SpinalHDL/VexRiscv/(threads)

Thread 4 (2017-10-04):

GDB not working with FPGA

AaronKel, 2017-10-04:
Hello all,
I'm having a little problem with the FPGA implementation to test functionality on sillicon and the compilation is completely fine but when it comes to interfacing with the board.
The OpenOCD can connect, I'm using the command:

`openocd -f tcl/interface/altera-usb-blaster.cfg -c "set BRIEY_CPU0_YAML /home/aaron/VexRiscv/cpu0.yaml" -f tcl/target/briey.cfg`

 However, when then trying to connect to the GDB with:

`target remote localhost:3333`

It times out, am I missing something? I'm using the DE0-nano development board.

Dolu1990, 2017-10-04:
Hi,

How do you have linked the Altera USB blaster to the briey toplevel ?
(Currently I always have used a dedicated JTAG via some USB FTDI)

Also about the DE0-nano, i already have test Briey on it, be carefull the SDRAM configuration is different than the default one (DE1-SoC). You need to generate the toplevel via (for instance) this main : https://github.com/SpinalHDL/VexRiscv/blob/master/src/main/scala/vexriscv/demo/Briey.scala#L394

AaronKel, 2017-10-04:
I have used the default:

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

Then attached the correct slots on the blaster but it gets to:

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

and stops and I cannot connect to it via GDB. What sort of FTDI chip/setup did you use. I think it would be helpful if I tried it your way, since you have already tested it.

Dolu1990, 2017-10-05:
I'm using the ft2232h chip, so, the very "standard" way, the only element on the jtag chain is the Briey SOC. Do you have multiple jtag tap on your JTAG ? Or the Briey is the only one ? Have you powered the vcc_trgt pin of the dongle ? (i had forget it many times XD)
Also could you give  a try with the verbose openocd ?  -v3   if i remember it right

Dolu1990, 2017-10-05:
Also, just to minimise risks of error, don't modify any thing of the de0-nano project/sources (for the moment :))

AaronKel, 2017-10-07:
I'll run through my setup, because I may have just made a wiring mistake!

So I tried ordering in the ft232h breakout board form adafruit:

> https://www.adafruit.com/product/2264

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

Reverted back into a clean DE0-nano file from here:

> https://drive.google.com/drive/folders/0B-CqLXDTaMbKZGdJZlZ5THAxRTQ?usp=sharing

Then I looked at the top level files for the JTAG and it seems like they are on:

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

Then looking at the pin mapping it shows:

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

So looking at the pin mapping of the DE0 nano:

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

Then looking in the FT232H datasheet it shows

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

with pins 13, 14, 15, 16, 17, 18, 19, 20 on the ADBUS[7:0] and from adafruit:

> D0 through D7 - These are the ADBUS pins

So my final wiring is:

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

Then I got the OpenOCD from

> https://github.com/SpinalHDL/openocd_riscv

Compiled it ran it with the simulation okay, then I tried running;
`$ sudo openocd -f tcl/interface/ftdi/ft2232h_breakout.cfg -c 'set BRIEY_CPU0_YAML /home/aaron/VexRis/cpu0.yaml' -f tcl/target/briey.cfg`
Got an error that it wasn't found so changed ft2232h_breakout.cfg to

```
interface ftdi
#ftdi_device_desc "FT2232H Breakout Module"
ftdi_vid_pid 0x0403 0x6014

# Channel for using JTAG
ftdi_channel 0

# Initial state and direction setting (ref. AN_135_MPSSE_Basics.pdf)
# ftdi_layout_init [data] [direction]

#  name   signal  state      direction  JTAG name
# *DBUS0  TCK/SK  (low =0)   (out=1)    TDI
# *DBUS1  TDI/DO  (low =0)   (out=1)    TDO
# *DBUS2  TDO/DI  (low =0)   (in =0)    TCK
# *DBUS3  TMS/CS  (high=1)   (out=1)    TMS
# *DBUS4  GPIOL0  (low =0)   (out=0)    (nTRST)
# *DBUS5  GPIOL1  (low =0)   (out=0)    WAIT | STOPCLK
# *DBUS6  GPIOL2  (low =0)   (out=0)    (nRST)
# *DBUS7  GPIOL3  (low =0)   (out=0)    RTCK
ftdi_layout_init 0xfff8 0xfffb
ftdi_layout_signal nTRST -data 0x0100 -oe 0x0100
ftdi_layout_signal nSRST -data 0x0200 -oe 0x0200
```
Ran the OpenOCD again and got the following error;
```
$sudo openocd -d -f tcl/interface/ftdi/ft2232h_breakout.cfg -c 'set BRIEY_CPU0_YAML /home/aaron/VexRiscv/cpu0.yaml' -f tcl/target/briey.cfg

Open On-Chip Debugger 0.10.0+dev-00292-g14dcabd (2017-10-07-14:13)
Licensed under GNU GPL v2
For bug reports, read
	http://openocd.org/doc/doxygen/bugs.html
User : 13 1 command.c:544 command_print(): debug_level: 3
Debug: 14 2 options.c:181 add_default_dirs(): bindir=/usr/local/bin
Debug: 15 2 options.c:182 add_default_dirs(): pkgdatadir=/usr/local/share/openocd
Debug: 16 2 options.c:183 add_default_dirs(): exepath=/usr/local/bin
Debug: 17 2 options.c:184 add_default_dirs(): bin2data=../share/openocd
Debug: 18 2 configuration.c:42 add_script_search_dir(): adding /home/aaron/.openocd
Debug: 19 2 configuration.c:42 add_script_search_dir(): adding /usr/local/bin/../share/openocd/site
Debug: 20 2 configuration.c:42 add_script_search_dir(): adding /usr/local/bin/../share/openocd/scripts
Debug: 21 2 configuration.c:82 find_file(): found tcl/interface/ftdi/ft2232h_breakout.cfg
Debug: 22 2 command.c:143 script_debug(): command - ocd_command ocd_command type ocd_interface ftdi
Debug: 23 2 command.c:143 script_debug(): command - interface ocd_interface ftdi
Debug: 25 2 command.c:364 register_command_handler(): registering 'ocd_ftdi_device_desc'...
Debug: 26 2 command.c:364 register_command_handler(): registering 'ocd_ftdi_serial'...
Debug: 27 2 command.c:364 register_command_handler(): registering 'ocd_ftdi_location'...
Debug: 28 2 command.c:364 register_command_handler(): registering 'ocd_ftdi_channel'...
Debug: 29 2 command.c:364 register_command_handler(): registering 'ocd_ftdi_layout_init'...
Debug: 30 2 command.c:364 register_command_handler(): registering 'ocd_ftdi_layout_signal'...
Debug: 31 2 command.c:364 register_command_handler(): registering 'ocd_ftdi_set_signal'...
Debug: 32 2 command.c:364 register_command_handler(): registering 'ocd_ftdi_get_signal'...
Debug: 33 2 command.c:364 register_command_handler(): registering 'ocd_ftdi_vid_pid'...
Debug: 34 2 command.c:364 register_command_handler(): registering 'ocd_ftdi_tdo_sample_edge'...
Debug: 35 2 command.c:143 script_debug(): command - ocd_command ocd_command type ocd_ftdi_vid_pid 0x0403 0x6014
Debug: 36 2 command.c:143 script_debug(): command - ftdi_vid_pid ocd_ftdi_vid_pid 0x0403 0x6014
Debug: 38 2 command.c:143 script_debug(): command - ocd_command ocd_command type ocd_ftdi_channel 0
Debug: 39 2 command.c:143 script_debug(): command - ftdi_channel ocd_ftdi_channel 0
Debug: 41 2 command.c:143 script_debug(): command - ocd_command ocd_command type ocd_ftdi_layout_init 0xfff8 0xfffb
Debug: 42 2 command.c:143 script_debug(): command - ftdi_layout_init ocd_ftdi_layout_init 0xfff8 0xfffb
Debug: 44 2 command.c:143 script_debug(): command - ocd_command ocd_command type ocd_ftdi_layout_signal nTRST -data 0x0100 -oe 0x0100
Debug: 45 2 command.c:143 script_debug(): command - ftdi_layout_signal ocd_ftdi_layout_signal nTRST -data 0x0100 -oe 0x0100
Debug: 47 2 command.c:143 script_debug(): command - ocd_command ocd_command type ocd_ftdi_layout_signal nSRST -data 0x0200 -oe 0x0200
Debug: 48 2 command.c:143 script_debug(): command - ftdi_layout_signal ocd_ftdi_layout_signal nSRST -data 0x0200 -oe 0x0200
User : 50 2 command.c:675 command_run_line(): /home/aaron/VexRiscv/cpu0.yamlUser : 51 2 command.c:677 command_run_line():
Debug: 52 2 configuration.c:82 find_file(): found tcl/target/briey.cfg
Debug: 53 2 command.c:143 script_debug(): command - ocd_command ocd_command type ocd_adapter_khz 50
Debug: 54 2 command.c:143 script_debug(): command - adapter_khz ocd_adapter_khz 50
Debug: 56 2 core.c:1631 jtag_config_khz(): handle jtag khz
Debug: 57 2 core.c:1598 adapter_khz_to_speed(): convert khz to interface specific speed value
Debug: 58 2 core.c:1598 adapter_khz_to_speed(): convert khz to interface specific speed value
User : 59 2 command.c:544 command_print(): adapter speed: 50 kHz
Debug: 60 2 command.c:143 script_debug(): command - ocd_command ocd_command type ocd_adapter_nsrst_delay 260
Debug: 61 2 command.c:143 script_debug(): command - adapter_nsrst_delay ocd_adapter_nsrst_delay 260
User : 63 2 command.c:544 command_print(): adapter_nsrst_delay: 260
Debug: 64 2 command.c:143 script_debug(): command - ocd_command ocd_command type ocd_transport select
Debug: 65 2 command.c:143 script_debug(): command - ocd_transport ocd_transport select
Info : 66 2 transport.c:286 jim_transport_select(): auto-selecting first available session transport "jtag". To override use 'transport select <transport>'.
Debug: 67 2 command.c:364 register_command_handler(): registering 'ocd_jtag_flush_queue_sleep'...
Debug: 68 2 command.c:364 register_command_handler(): registering 'ocd_jtag_rclk'...
Debug: 69 2 command.c:364 register_command_handler(): registering 'ocd_jtag_ntrst_delay'...
Debug: 70 2 command.c:364 register_command_handler(): registering 'ocd_jtag_ntrst_assert_width'...
Debug: 71 2 command.c:364 register_command_handler(): registering 'ocd_scan_chain'...
Debug: 72 2 command.c:364 register_command_handler(): registering 'ocd_jtag_reset'...
Debug: 73 2 command.c:364 register_command_handler(): registering 'ocd_runtest'...
Debug: 74 3 command.c:364 register_command_handler(): registering 'ocd_irscan'...
Debug: 75 3 command.c:364 register_command_handler(): registering 'ocd_verify_ircapture'...
Debug: 76 3 command.c:364 register_command_handler(): registering 'ocd_verify_jtag'...
Debug: 77 3 command.c:364 register_command_handler(): registering 'ocd_tms_sequence'...
Debug: 78 3 command.c:364 register_command_handler(): registering 'ocd_wait_srst_deassert'...
Debug: 79 3 command.c:364 register_command_handler(): registering 'ocd_jtag'...
Debug: 80 3 command.c:364 register_command_handler(): registering 'ocd_jtag'...
Debug: 81 3 command.c:364 register_command_handler(): registering 'ocd_jtag'...
Debug: 82 3 command.c:364 register_command_handler(): registering 'ocd_jtag'...
Debug: 83 3 command.c:364 register_command_handler(): registering 'ocd_jtag'...
Debug: 84 3 command.c:364 register_command_handler(): registering 'ocd_jtag'...
Debug: 85 3 command.c:364 register_command_handler(): registering 'ocd_jtag'...
Debug: 86 3 command.c:364 register_command_handler(): registering 'ocd_jtag'...
Debug: 87 3 command.c:364 register_command_handler(): registering 'ocd_jtag'...
Debug: 88 3 command.c:364 register_command_handler(): registering 'ocd_jtag'...
Debug: 89 3 command.c:364 register_command_handler(): registering 'ocd_jtag'...
Debug: 90 3 command.c:364 register_command_handler(): registering 'ocd_jtag'...
Debug: 91 3 command.c:364 register_command_handler(): registering 'ocd_jtag'...
Debug: 92 3 command.c:364 register_command_handler(): registering 'ocd_svf'...
Debug: 93 3 command.c:364 register_command_handler(): registering 'ocd_xsvf'...
Debug: 94 3 command.c:143 script_debug(): command - ocd_command ocd_command type ocd_transport select
Debug: 95 3 command.c:143 script_debug(): command - ocd_transport ocd_transport select
Debug: 96 3 command.c:143 script_debug(): command - ocd_command ocd_command type ocd_jtag_ntrst_delay 250
Debug: 97 3 command.c:143 script_debug(): command - jtag_ntrst_delay ocd_jtag_ntrst_delay 250
User : 99 3 command.c:544 command_print(): jtag_ntrst_delay: 250
Debug: 100 3 command.c:143 script_debug(): command - ocd_command ocd_command type ocd_jtag newtap fpga_spinal bridge -expected-id 0x10001fff -irlen 4 -ircapture 0x1 -irmask 0xF
Debug: 101 3 command.c:143 script_debug(): command - ocd_jtag ocd_jtag newtap fpga_spinal bridge -expected-id 0x10001fff -irlen 4 -ircapture 0x1 -irmask 0xF
Debug: 102 3 tcl.c:549 jim_newtap_cmd(): Creating New Tap, Chip: fpga_spinal, Tap: bridge, Dotted: fpga_spinal.bridge, 8 params
Debug: 103 3 tcl.c:573 jim_newtap_cmd(): Processing option: -expected-id
Debug: 104 3 tcl.c:573 jim_newtap_cmd(): Processing option: -irlen
Debug: 105 3 tcl.c:573 jim_newtap_cmd(): Processing option: -ircapture
Debug: 106 3 tcl.c:573 jim_newtap_cmd(): Processing option: -irmask
Debug: 107 3 core.c:1304 jtag_tap_init(): Created Tap: fpga_spinal.bridge @ abs position 0, irlen 4, capture: 0x1 mask: 0xf
Debug: 108 3 command.c:143 script_debug(): command - ocd_command ocd_command type ocd_target create fpga_spinal.cpu0 vexriscv -endian little -chain-position fpga_spinal.bridge -coreid 0 -dbgbase 0xF00F0000
Debug: 109 3 command.c:143 script_debug(): command - ocd_target ocd_target create fpga_spinal.cpu0 vexriscv -endian little -chain-position fpga_spinal.bridge -coreid 0 -dbgbase 0xF00F0000
Debug: 110 3 target.c:1922 target_free_all_working_areas_restore(): freeing all working areas
Debug: 111 3 command.c:364 register_command_handler(): registering 'ocd_vexriscv'...
Debug: 112 3 command.c:364 register_command_handler(): registering 'ocd_vexriscv'...
Debug: 113 3 vexriscv.c:324 vexriscv_target_create(): vexriscv_target_create

Debug: 114 3 vexriscv.c:301 vexriscv_create_reg_list(): -
Debug: 115 3 command.c:364 register_command_handler(): registering 'ocd_fpga_spinal.cpu0'...
Debug: 116 3 command.c:364 register_command_handler(): registering 'ocd_fpga_spinal.cpu0'...
Debug: 117 3 command.c:364 register_command_handler(): registering 'ocd_fpga_spinal.cpu0'...
Debug: 118 3 command.c:364 register_command_handler(): registering 'ocd_fpga_spinal.cpu0'...
Debug: 119 3 command.c:364 register_command_handler(): registering 'ocd_fpga_spinal.cpu0'...
Debug: 120 3 command.c:364 register_command_handler(): registering 'ocd_fpga_spinal.cpu0'...
Debug: 121 3 command.c:364 register_command_handler(): registering 'ocd_fpga_spinal.cpu0'...
Debug: 122 3 command.c:364 register_command_handler(): registering 'ocd_fpga_spinal.cpu0'...
Debug: 123 3 command.c:364 register_command_handler(): registering 'ocd_fpga_spinal.cpu0'...
Debug: 124 3 command.c:364 register_command_handler(): registering 'ocd_fpga_spinal.cpu0'...
Debug: 125 3 command.c:364 register_command_handler(): registering 'ocd_fpga_spinal.cpu0'...
Debug: 126 3 command.c:364 register_command_handler(): registering 'ocd_fpga_spinal.cpu0'...
Debug: 127 3 command.c:364 register_command_handler(): registering 'ocd_fpga_spinal.cpu0'...
Debug: 128 3 command.c:364 register_command_handler(): registering 'ocd_fpga_spinal.cpu0'...
Debug: 129 3 command.c:364 register_command_handler(): registering 'ocd_fpga_spinal.cpu0'...
Debug: 130 3 command.c:364 register_command_handler(): registering 'ocd_fpga_spinal.cpu0'...
Debug: 131 3 command.c:364 register_command_handler(): registering 'ocd_fpga_spinal.cpu0'...
Debug: 132 3 command.c:364 register_command_handler(): registering 'ocd_fpga_spinal.cpu0'...
Debug: 133 3 command.c:364 register_command_handler(): registering 'ocd_fpga_spinal.cpu0'...
Debug: 134 3 command.c:364 register_command_handler(): registering 'ocd_fpga_spinal.cpu0'...
Debug: 135 3 command.c:364 register_command_handler(): registering 'ocd_fpga_spinal.cpu0'...
Debug: 136 3 command.c:364 register_command_handler(): registering 'ocd_fpga_spinal.cpu0'...
Debug: 137 3 command.c:364 register_command_handler(): registering 'ocd_fpga_spinal.cpu0'...
Debug: 138 3 command.c:364 register_command_handler(): registering 'ocd_fpga_spinal.cpu0'...
Debug: 139 3 command.c:143 script_debug(): command - ocd_command ocd_command type ocd_vexriscv readWaitCycles 12
Debug: 140 3 command.c:143 script_debug(): command - ocd_vexriscv ocd_vexriscv readWaitCycles 12
Debug: 142 3 command.c:143 script_debug(): command - ocd_command ocd_command type ocd_vexriscv cpuConfigFile /home/aaron/VexRiscv/cpu0.yaml
Debug: 143 3 command.c:143 script_debug(): command - ocd_vexriscv ocd_vexriscv cpuConfigFile /home/aaron/VexRiscv/cpu0.yaml
Debug: 145 3 command.c:143 script_debug(): command - ocd_command ocd_command type ocd_poll_period 50
Debug: 146 3 command.c:143 script_debug(): command - poll_period ocd_poll_period 50
Info : 148 3 server.c:673 handle_poll_period_command(): set servers polling period to 50ms
Debug: 149 3 command.c:143 script_debug(): command - ocd_command ocd_command type ocd_init
Debug: 150 3 command.c:143 script_debug(): command - init ocd_init
Debug: 152 3 command.c:143 script_debug(): command - ocd_command ocd_command type ocd_target init
Debug: 153 4 command.c:143 script_debug(): command - ocd_target ocd_target init
Debug: 155 4 command.c:143 script_debug(): command - ocd_command ocd_command type ocd_target names
Debug: 156 4 command.c:143 script_debug(): command - ocd_target ocd_target names
Debug: 157 4 command.c:143 script_debug(): command - ocd_command ocd_command type ocd_fpga_spinal.cpu0 cget -event gdb-flash-erase-start
Debug: 158 4 command.c:143 script_debug(): command - ocd_fpga_spinal.cpu0 ocd_fpga_spinal.cpu0 cget -event gdb-flash-erase-start
Debug: 159 4 command.c:143 script_debug(): command - ocd_command ocd_command type ocd_fpga_spinal.cpu0 configure -event gdb-flash-erase-start reset init
Debug: 160 4 command.c:143 script_debug(): command - ocd_fpga_spinal.cpu0 ocd_fpga_spinal.cpu0 configure -event gdb-flash-erase-start reset init
Debug: 161 4 command.c:143 script_debug(): command - ocd_command ocd_command type ocd_fpga_spinal.cpu0 cget -event gdb-flash-write-end
Debug: 162 4 command.c:143 script_debug(): command - ocd_fpga_spinal.cpu0 ocd_fpga_spinal.cpu0 cget -event gdb-flash-write-end
Debug: 163 4 command.c:143 script_debug(): command - ocd_command ocd_command type ocd_fpga_spinal.cpu0 configure -event gdb-flash-write-end reset halt
Debug: 164 4 command.c:143 script_debug(): command - ocd_fpga_spinal.cpu0 ocd_fpga_spinal.cpu0 configure -event gdb-flash-write-end reset halt
Debug: 165 4 target.c:1331 handle_target_init_command(): Initializing targets...
Debug: 166 4 vexriscv.c:581 vexriscv_init_target(): vexriscv_init_target

Debug: 167 4 vexriscv.c:582 vexriscv_init_target(): vexriscv_init_target
Debug: 168 4 vexriscv.c:423 vexriscv_build_reg_cache(): -
Debug: 169 4 command.c:364 register_command_handler(): registering 'ocd_target_request'...
Debug: 170 4 command.c:364 register_command_handler(): registering 'ocd_trace'...
Debug: 171 4 command.c:364 register_command_handler(): registering 'ocd_trace'...
Debug: 172 4 command.c:364 register_command_handler(): registering 'ocd_fast_load_image'...
Debug: 173 4 command.c:364 register_command_handler(): registering 'ocd_fast_load'...
Debug: 174 4 command.c:364 register_command_handler(): registering 'ocd_profile'...
Debug: 175 4 command.c:364 register_command_handler(): registering 'ocd_virt2phys'...
Debug: 176 4 command.c:364 register_command_handler(): registering 'ocd_reg'...
Debug: 177 4 command.c:364 register_command_handler(): registering 'ocd_poll'...
Debug: 178 4 command.c:364 register_command_handler(): registering 'ocd_wait_halt'...
Debug: 179 4 command.c:364 register_command_handler(): registering 'ocd_halt'...
Debug: 180 4 command.c:364 register_command_handler(): registering 'ocd_resume'...
Debug: 181 4 command.c:364 register_command_handler(): registering 'ocd_reset'...
Debug: 182 4 command.c:364 register_command_handler(): registering 'ocd_soft_reset_halt'...
Debug: 183 4 command.c:364 register_command_handler(): registering 'ocd_step'...
Debug: 184 4 command.c:364 register_command_handler(): registering 'ocd_mdd'...
Debug: 185 4 command.c:364 register_command_handler(): registering 'ocd_mdw'...
Debug: 186 4 command.c:364 register_command_handler(): registering 'ocd_mdh'...
Debug: 187 4 command.c:364 register_command_handler(): registering 'ocd_mdb'...
Debug: 188 4 command.c:364 register_command_handler(): registering 'ocd_mwd'...
Debug: 189 4 command.c:364 register_command_handler(): registering 'ocd_mww'...
Debug: 190 4 command.c:364 register_command_handler(): registering 'ocd_mwh'...
Debug: 191 4 command.c:364 register_command_handler(): registering 'ocd_mwb'...
Debug: 192 4 command.c:364 register_command_handler(): registering 'ocd_bp'...
Debug: 193 4 command.c:364 register_command_handler(): registering 'ocd_rbp'...
Debug: 194 4 command.c:364 register_command_handler(): registering 'ocd_wp'...
Debug: 195 4 command.c:364 register_command_handler(): registering 'ocd_rwp'...
Debug: 196 4 command.c:364 register_command_handler(): registering 'ocd_load_image'...
Debug: 197 4 command.c:364 register_command_handler(): registering 'ocd_dump_image'...
Debug: 198 4 command.c:364 register_command_handler(): registering 'ocd_verify_image_checksum'...
Debug: 199 4 command.c:364 register_command_handler(): registering 'ocd_verify_image'...
Debug: 200 4 command.c:364 register_command_handler(): registering 'ocd_test_image'...
Debug: 201 4 command.c:364 register_command_handler(): registering 'ocd_reset_nag'...
Debug: 202 4 command.c:364 register_command_handler(): registering 'ocd_ps'...
Debug: 203 4 command.c:364 register_command_handler(): registering 'ocd_test_mem_access'...
Debug: 204 4 ftdi.c:657 ftdi_initialize(): ftdi interface using shortest path jtag state transitions
Debug: 205 6 mpsse.c:422 mpsse_purge(): -
Debug: 206 6 mpsse.c:703 mpsse_loopback_config(): off
Debug: 207 6 mpsse.c:748 mpsse_set_frequency(): target 50000 Hz
Debug: 208 6 mpsse.c:740 mpsse_rtck_config(): off
Debug: 209 6 mpsse.c:729 mpsse_divide_by_5_config(): off
Debug: 210 6 mpsse.c:709 mpsse_set_divisor(): 599
Debug: 211 6 mpsse.c:772 mpsse_set_frequency(): actually 50000 Hz
Debug: 212 6 core.c:1598 adapter_khz_to_speed(): convert khz to interface specific speed value
Debug: 213 6 core.c:1601 adapter_khz_to_speed(): have interface set up
Debug: 214 6 mpsse.c:748 mpsse_set_frequency(): target 50000 Hz
Debug: 215 6 mpsse.c:740 mpsse_rtck_config(): off
Debug: 216 6 mpsse.c:729 mpsse_divide_by_5_config(): off
Debug: 217 6 mpsse.c:709 mpsse_set_divisor(): 599
Debug: 218 6 mpsse.c:772 mpsse_set_frequency(): actually 50000 Hz
Debug: 219 6 core.c:1598 adapter_khz_to_speed(): convert khz to interface specific speed value
Debug: 220 6 core.c:1601 adapter_khz_to_speed(): have interface set up
Info : 221 6 core.c:1386 adapter_init(): clock speed 50 kHz
Debug: 222 6 openocd.c:140 handle_init_command(): Debug Adapter init complete
Debug: 223 6 command.c:143 script_debug(): command - ocd_command ocd_command type ocd_transport init
Debug: 224 6 command.c:143 script_debug(): command - ocd_transport ocd_transport init
Debug: 226 6 transport.c:239 handle_transport_init(): handle_transport_init
Debug: 227 6 core.c:729 jtag_add_reset(): SRST line released
Debug: 228 6 core.c:753 jtag_add_reset(): TRST line released
Debug: 229 6 core.c:327 jtag_call_event_callbacks(): jtag event: TAP reset
Debug: 231 522 command.c:143 script_debug(): command - ocd_command ocd_command type ocd_jtag arp_init
Debug: 232 522 command.c:143 script_debug(): command - ocd_jtag ocd_jtag arp_init
Debug: 233 522 core.c:1399 jtag_init_inner(): Init JTAG chain
Debug: 234 522 core.c:327 jtag_call_event_callbacks(): jtag event: TAP reset
Debug: 235 522 core.c:1060 jtag_examine_chain(): DR scan interrogation for IDCODE/BYPASS
Debug: 236 522 core.c:327 jtag_call_event_callbacks(): jtag event: TAP reset
Error: 237 536 core.c:949 jtag_examine_chain_check(): JTAG scan chain interrogation failed: all ones
Error: 238 536 core.c:950 jtag_examine_chain_check(): Check JTAG interface, timings, target power, etc.
Error: 239 536 core.c:1444 jtag_init_inner(): Trying to use configured scan chain anyway...
Debug: 240 536 core.c:1190 jtag_validate_ircapture(): IR capture validation scan
Error: 241 537 core.c:1242 jtag_validate_ircapture(): fpga_spinal.bridge: IR capture error; saw 0x0f not 0x01
Debug: 242 537 core.c:327 jtag_call_event_callbacks(): jtag event: TAP reset
Warn : 243 537 core.c:1467 jtag_init_inner(): Bypassing JTAG setup events due to errors
Debug: 244 537 openocd.c:153 handle_init_command(): Examining targets...
Debug: 245 537 target.c:1524 target_call_event_callbacks(): target event 21 (examine-start)
Debug: 246 537 vexriscv.c:1400 vexriscv_examine(): vexriscv_examine
Debug: 247 537 vexriscv.c:869 vexriscv_assert_reset(): vexriscv_assert_reset

Debug: 248 537 vexriscv.c:880 vexriscv_assert_reset(): vexriscv_assert_reset
Debug: 249 537 vexriscv.c:887 vexriscv_deassert_reset(): vexriscv_deassert_reset

Debug: 250 546 vexriscv.c:896 vexriscv_deassert_reset(): vexriscv_deassert_reset
Debug: 251 549 target.c:1524 target_call_event_callbacks(): target event 22 (examine-end)
Debug: 252 549 command.c:143 script_debug(): command - ocd_command ocd_command type ocd_flash init
Debug: 253 550 command.c:143 script_debug(): command - ocd_flash ocd_flash init
Debug: 255 553 tcl.c:1166 handle_flash_init_command(): Initializing flash devices...
Debug: 256 553 command.c:143 script_debug(): command - ocd_command ocd_command type ocd_mflash init
Debug: 257 553 command.c:143 script_debug(): command - ocd_mflash ocd_mflash init
Debug: 259 556 mflash.c:1377 handle_mflash_init_command(): Initializing mflash devices...
Debug: 260 556 command.c:143 script_debug(): command - ocd_command ocd_command type ocd_nand init
Debug: 261 556 command.c:143 script_debug(): command - ocd_nand ocd_nand init
Debug: 263 560 tcl.c:497 handle_nand_init_command(): Initializing NAND devices...
Debug: 264 560 command.c:143 script_debug(): command - ocd_command ocd_command type ocd_pld init
Debug: 265 560 command.c:143 script_debug(): command - ocd_pld ocd_pld init
Debug: 267 563 pld.c:205 handle_pld_init_command(): Initializing PLDs...
Debug: 268 563 command.c:143 script_debug(): command - ocd_command ocd_command type ocd_soft_reset_halt
Debug: 269 563 command.c:143 script_debug(): command - soft_reset_halt ocd_soft_reset_halt
User : 271 566 target.c:2948 handle_soft_reset_halt_command(): requesting target halt and executing a soft reset
Debug: 272 566 vexriscv.c:1448 vexriscv_soft_reset_halt(): -
Debug: 273 568 command.c:143 script_debug(): command - ocd_command ocd_command type ocd_init
Debug: 274 568 command.c:143 script_debug(): command - init ocd_init

```

I think the error is similar to what you were saying about the target voltage:
```
Error: 237 536 core.c:949 jtag_examine_chain_check(): JTAG scan chain interrogation failed: all ones
Error: 238 536 core.c:950 jtag_examine_chain_check(): Check JTAG interface, timings, target power, etc.
```
Would I just supply 3.3v to one of the pins?

Many thanks

Dolu1990, 2017-10-07:
I don't think it is a supply issue in this case, have you flash the usb dongle ? often the default config isn't JTAG ready.

Anyways, the issue is realy in the low level jtag stuff, has the Briey jtag tap isn't detected.
Let's me know ^^

AaronKel, 2017-10-08:
I finally figured it out after a lot of head scratching. I decided to use the USB-blaster again, I was using this version;

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

These clones use a cheap ft423(?) I think so was causing the hangups. If I recompile OpenOCD with the following;

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

It all worked, I knew it was something simple! Thank you for helping me diagnose there was no error on the VexRiscv side!

AaronKel, 2017-10-08:
close

Dolu1990, 2017-10-08:
Good :)
Thanks for the info ^^

MindShow, 2019-04-29:
i tried a usb blaster clone，but return some errors
`Open On-Chip Debugger 0.10.0+dev-01202-gced8dcd6 (2019-04-23-21:53)
Licensed under GNU GPL v2
For bug reports, read
	http://openocd.org/doc/doxygen/bugs.html
Warn : Adapter driver 'usb_blaster' did not declare which transports it allows; assuming legacy JTAG-only
Info : only one transport option; autoselect 'jtag'
/home/csliu/Desktop/riscvwork/VexRiscvSocSoftware/openocd/cpu0.yaml
adapter speed: 10 kHz
adapter_nsrst_delay: 260
jtag_ntrst_delay: 250
Info : set servers polling period to 50ms
Info : usb blaster interface using libftdi
Error: unable to get latency timer
Info : This adapter doesn't support configurable speed
Info : JTAG tap: fpga_spinal.bridge tap/device found: 0x10001fff (mfg: 0x7ff (<invalid>), part: 0x0001, ver: 0x1)
Error: fpga_spinal.bridge: IR capture error; saw 0x08 not 0x01
Warn : Bypassing JTAG setup events due to errors
Info : Listening on port 3333 for gdb connections
requesting target halt and executing a soft reset
Started by GNU MCU Eclipse
Info : Listening on port 6666 for tcl connections
Info : Listening on port 4444 for telnet connections
Info : accepting 'gdb' connection on tcp/3333
Info : JTAG tap: fpga_spinal.bridge tap/device found: 0x10001fff (mfg: 0x7ff (<invalid>), part: 0x0001, ver: 0x1)
Error: fpga_spinal.bridge: IR capture error; saw 0x08 not 0x01
Warn : Bypassing JTAG setup
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

Thread 16 (2018-02-22):

Briey simulation regression

m-chabot, 2018-02-22:
Hi,

I am working on porting Briey soc to Xilinx fpga board and have issue with sdram so I use simulator to extract reference waveform.
I noticed a regression in briey soc simulation with https://github.com/SpinalHDL/VexRiscv/commit/d95793494942e334f9c643d2b61f231218714cc7

When using simulator it's no longer possible to load/execute code in sdram. Internal ram load/exec is fine.
Tested with latest SpinalHDL, VexRiscSoftware (uart example) and gcc 6.1.0 (self build rv32i toolchain).

Dolu1990, 2018-02-22:
Hi,

You are right,  something is going wrong, apparently it doesn't pass the dhrystone benchmark, anymore, i will check it more in depth this evening, anyway thanks for the report : D
I will let's you know when i have news.

Dolu1990, 2018-02-22:
So, i spotted the issue, and it is very likely a Verilator bug, when i disable Verilator optimisation (-O0) or enable the Verilator VCD generation everything is fine. I also tried to catch the bug by adding some assert and it show some impossible conditions.

I will do some additional checks.

Dolu1990, 2018-02-22:
Ok no, finaly i got it, the io_externalInterrupt of the top level wasn't set to zero in the testbench boot, so its value was randomly set by Verilator, but it look like he was always setting it to zero, until i changed the code base, which changed the moment were the random is applied to the pin, and conssecantly changed its initial value.

I submited a fix, it should be fine now. I can load/debug code with the Verilator Briey simulation.
I hadn't exactly the same symptoms than you, so let's me know if the issue perssiste.

Dolu1990, 2018-02-22:
Hooo not only that but some weeks ago, the memory mapping of briey changed, have you seen it ?

m-chabot, 2018-02-23:
Yes I have been bitten by it some times ago ;)
Simulation is fine on my side.
Briey is running on my fpga board also (only tested basic uart).
I have ported it to this board: https://github.com/ChinaQMTECH/QM_XC7A35T_SDRAM , nice cheap one with vga/usb daughter board.

Dolu1990, 2018-02-23:
Hoo great : D

Closed 2018-02-22.

Thread 19 (2018-04-24):

Add iCE40 stats to "Area usage and maximal frequency" section?

mithro, 2018-04-24:
VexRiscv looks pretty awesome!

The [Area usage and maximal frequency](https://github.com/SpinalHDL/VexRiscv#area-usage-and-maximal-frequency) section is really useful for seeing how the parametrization works.

It also looks like [Murax SoC](https://github.com/SpinalHDL/VexRiscv#murax-soc) supports the iCE40 FPGA.

Would it be possible to add the iCE40 info to the [Area usage and maximal frequency](https://github.com/SpinalHDL/VexRiscv#area-usage-and-maximal-frequency) section too?

It looks like you already have some details in the Murax SoC section;
```
Murax interlocked stages (0.45 DMIPS/Mhz) ->
  Artix 7    -> 305 Mhz 1004 LUT 1297 FF
  Cyclone V  -> 160 Mhz 744 ALMs
  Cyclone IV -> 148 Mhz 1,522 LUT 1,255 FF
  ICE40-HX   ->  51 Mhz 2402 LC (icestorm)

MuraxFast bypassed stages (0.65 DMIPS/Mhz) ->
  Artix 7    -> 312 Mhz 1240 LUT 1330 FF
  Cyclone V  -> 159 Mhz 884 ALMs
  Cyclone IV -> 142 Mhz 1,755 LUT 1,289 FF
  ICE40-HX   ->  50 Mhz, 2787 LC  (icestorm)
```

I'm very interested in know how big `VexRiscv smallest` is on the iCE40. It would also be interested to know the biggest configuration of VexRiscv that will fit on the various iCE40 parts.

Thanks!

Dolu1990, 2018-04-25:
Thanks :)

**Would it be possible to add the iCE40 info to the Area usage and maximal frequency section too?**
Yes, i have to do that, it would be also usefull.

**It also looks like Murax SoC supports the iCE40 FPGA.**
Right, tested on the ice40 hx8k-breakout board, also about supporting multiplication on DSP less FPGA, i recently added a iterative multiplication plugin which only use adders (https://github.com/SpinalHDL/VexRiscv#muldiviterativeplugin)

**I'm very interested in know how big VexRiscv smallest is on the iCE40. It would also be interested to know the biggest configuration of VexRiscv that will fit on the various iCE40 parts.**
I never toke a exact look to the VexRiscv area usage into iCE40, so i don't realy know the usage for this FPGA family, but i will add iCE40 into the synthesis benchmark.

mithro, 2018-05-12:
@Dolu1990 It would also be really interested to see this on the iCE40 UltraPlus UP5K device. It's a super low power device but has significantly lower performance.

@daveshah1 added support for these parts to icestorm a while black.

Dolu1990, 2018-05-14:
@mithro I will give a try with the up5k ! Do you have some idea about the performance ratio between the ICE40 HX and the UP5K ?

Dolu1990, 2018-05-14:
@mithro

```
Murax ->
  iCE40         -> 50 Mhz 2313 LC
  iCE40Ultra -> 18 Mhz 2313 LC
MuraxFast (more dhrystone/cycle)->
  iCE40         -> 49 Mhz 2644 LC
  iCE40Ultra -> 21 Mhz 2644 LC
```

mithro, 2018-05-14:
Is this with the IceCube2 / Radiant or Icestorm?

Dolu1990, 2018-05-14:
All iCE40 numbers on the readme/here are from icestorm. I remember that a 1 years ago when i give some try with icecube2, i got up to 50 % timings improvment on VexRiscv, but maybe that was a special case, i never tried with Murax.

What is the delta between those tools from your experience ?

daveshah1, 2018-05-15:
I would say Radiant/iCEcube2 is about 30% better than the icestorm flow for a typical application.

mithro, 2018-07-21:
This all looks good! Closing the issue.

Closed 2018-07-21.

Thread 22 (2018-05-29):

Briey DE0 Nano SoC, not enough I/O pin locations

Lestandin, 2018-05-29:
Hi,

I intend to test some of the softwares provided for Briey on the DE0 Nano SoC. I first ran the TCL scripts as explained by the readme in the devkits folder, but now when running the fitter on Quartus I get the following logs :

> Info: *******************************************************************
Info: Running Quartus Prime Fitter
	Info: Version 18.0.0 Build 614 04/24/2018 SJ Lite Edition
	Info: Processing started: Tue May 29 11:31:26 2018
Info: Command: quartus_fit --read_settings_files=on --write_settings_files=off DE0_NANO -c DE0_NANO
Info: qfit2_default_script.tcl version: #1
Info: Project  = DE0_NANO
Info: Revision = DE0_NANO
Warning (18236): Number of processors has not been specified which may cause overloading on shared machines.  Set the global assignment NUM_PARALLEL_PROCESSORS in your QSF to an appropriate value for best performance.
Info (20030): Parallel compilation is enabled and will use 8 of the 8 processors detected
Info (119006): Selected device 5CSEMA4U23C6 for design "DE0_NANO"
Info (21077): Low junction temperature is 0 degrees C
Info (21077): High junction temperature is 85 degrees C
Warning: RST port on the PLL is not properly connected on instance pll0:pll0_inst|altpll:altpll_component|pll0_altpll:auto_generated|generic_pll2. The reset port on the PLL should be connected. If the PLL loses lock for any reason, you might need to manually reset the PLL in order to re-establish lock to the reference clock.
	Info: Must be connected
Warning (21300): LOCKED port on the PLL is not properly connected on instance "pll0:pll0_inst|altpll:altpll_component|pll0_altpll:auto_generated|generic_pll1". The LOCKED port on the PLL should be connected when the FBOUTCLK port is connected. Although it is unnecessary to connect the LOCKED signal, any logic driven off of an output clock of the PLL will not know when the PLL is locked and ready.
Info (171003): Fitter is performing an Auto Fit compilation, which may decrease Fitter effort to reduce compilation time
Warning (292013): Feature LogicLock is only available with a valid subscription license. You can purchase a software subscription to gain full access to this feature.
Warning (15714): Some pins have incomplete I/O assignments. Refer to the I/O Assignment Warnings report for details
Info (176045): Design uses memory blocks. Violating setup or hold times of memory block address registers for either read or write operations could cause memory contents to be corrupted. Make sure that all memory block address registers meet the setup and hold time requirements.
Critical Warning (169085): No exact pin location assignment(s) for 138 pins of 154 total pins. For the list of pins please refer to the I/O Assignment Warnings table in the fitter report.
Error (179000): Design requires 154 user-specified I/O pins -- too many to fit in the 145 user I/O pin locations available in the selected device
	Info (179001): Current design requires 154 user-specified I/O pins -- 154 normal user-specified I/O pins and 0 programming pins that have been constrained to use dual-purpose I/O pin locations
	Info (179002): Targeted device has 145 I/O pin locations available for user I/O -- 117 general-purpose I/O pins and 28 dual-purpose I/O pins
Error (12289): An error occurred while applying the periphery constraints. Review the offending constraints and rerun the Fitter.
Info (11798): Fitter preparation operations ending: elapsed time is 00:00:10
Warning (171167): Found invalid Fitter assignments. See the Ignored Assignments panel in the Fitter Compilation Report for more information.
Warning (169064): Following 82 pins have no output enable or a GND or VCC output enable - later changes to this connectivity may change fitting results
Warning (169069): Following 90 pins have nothing, GND, or VCC driving datain port -- changes to this connectivity may change fitting results
Error (11802): Can't fit design in device. Modify your design to reduce resources, or choose a larger device. The Intel FPGA Knowledge Database contains many articles with specific details on how to resolve this error. Visit the Knowledge Database at https://www.altera.com/support/support-resources/knowledge-base/search.html and search for this specific error message number.
Error: Quartus Prime Fitter was unsuccessful. 3 errors, 9 warnings
	Error: Peak virtual memory: 1226 megabytes
	Error: Processing ended: Tue May 29 11:31:48 2018
	Error: Elapsed time: 00:00:22
	Error: Total CPU time (on all processors): 00:00:21

I'm not really used to Quartus and I don't see how I could solve these I/O issue. Moreover when looking to the Compilation Report it states 154/314 for Total Pins and the right device is selected.

Dolu1990, 2018-05-29:
Hi,

Error (179000): Design requires 154 user-specified I/O pins -- too many to fit in the 145 user I/O pin locations available in the selected device

This FPGA => Number of I/O | MCU - 181, FPGA - 145
So only 145 are usable by the FPGA (apparently)

You can remove some of the GPIO (briey as 64 gpio, that's proably a bit much XD)
So i would say, remove all reference to GPIOB  in the Briey.scala should solve the issue.
I should also give more parametrization to the Briey config.

Let's me know how it go ^^

Lestandin, 2018-05-30:
Thanks for the really fast answer, the problem is what I was thinking. For the moment I'll be trying with less GPIO's and see what happens.

I'll let you know if get any good results out of this.

FlyingxDutch, 2019-05-03:
Hello,
I tried to launch BrieySoC (generated from SpinalHDL) on Mimas V.2 FPGA board from "Numato Lab" with Spartan6 (Spartan XC6SLX9 in CSG324 package) and had similiar issues. I remove from project one GPIO port and shortened bus in left GPIOs. Also the fact that Briey.v design required three externals clocks is not helping when one would like to run project on real hardware (FPGA board).
Best Regards

Thread 25 (2018-06-08):

Setup instructions: Cannot install key

xobs, 2018-06-08:
The setup instructions say to do:

````sh
sudo apt-key adv --keyserver hkp://keyserver.ubuntu.com:80 --recv 2EE0EA64E40A89B84B2DF73499E82A75642AC823
````

However, this does not actually work:

````sh
xobs@Pazuzu:~$ sudo apt-key adv --keyserver hkp://keyserver.ubuntu.com:80 --recv 2EE0EA64E40A89B84B2DF73499E82A75642AC823
Executing: /tmp/apt-key-gpghome.QoPbFivw9k/gpg.1.sh --keyserver hkp://keyserver.ubuntu.com:80 --recv 2EE0EA64E40A89B84B2DF73499E82A75642AC823
gpg: connecting dirmngr at '/tmp/apt-key-gpghome.QoPbFivw9k/S.dirmngr' failed: IPC connect call failed
gpg: keyserver receive failed: No dirmngr
xobs@Pazuzu:~$
````

This prevents the support packages from getting installed further on.

xobs, 2018-06-08:
I was able to install the key by manually copying http://keyserver.ubuntu.com/pks/lookup?op=get&fingerprint=on&search=0x99E82A75642AC823 into a file and doing "sudo apt-key add [file]".

Note that they keyserver.ubuntu.com search is broken -- I wasn't able to search for `2EE0EA64E40A89B84B2DF73499E82A75642AC823`

Dolu1990, 2018-06-08:
That's weird, i made a new ubuntu 18.04 vm, and everything worked fine. I can't reproduce your issue.

xobs, 2018-06-09:
I'm running Ubuntu 18.04 on Linux-on-Windows, so perhaps the "apt-key adv" is expecting some service to be running.  I just performed a fresh install, and got the same issue.  Even if I open up a sudo session (`sudo -i`) and run "dirmngr" by default, running `apt-key adv` fails.

Also, searching for "2EE0EA64E40A89B84B2DF73499E82A75642AC823" at keyserver.ubuntu.com doesn't turn up anything, making it hard to add your key to apt.

Dolu1990, 2018-06-09:
I made a new virutal box vm again, and run directly those command (two times), second time it work ^^
An alternative way to install it, is to install SBT from it's zip (see http://www.codesynch.com/hadoop_spark_blog/sbt-scala-build-tool-unix-install-sbteclipse-plugin-sample-wordcount/)

Else all the toolchain can also work on Windows, including verilator. (Verilator install => http://spinalhdl.github.io/SpinalDoc/spinal/sim/introduction/#windows, sbt install from MSI)

xobs, 2018-06-09:
The command that worked for me was:

````sh
curl 'http://keyserver.ubuntu.com:11371/pks/lookup?op=get&search=0x99E82A75642AC823' | sudo apt-key add -
````

This issue can probably be closed, because it's likely due to a misconfiguration on Ubuntu-on-Windows.  Hopefully the solution posted here will help others who have run into the same issue.  Thanks for taking a look!

Dolu1990, 2018-06-09:
Ok, thanks for the feedback :D

Closed 2018-06-09.

Thread 28 (2018-06-25):

Can VexRISCV based SoC be made to fit on an iCE40 1k?

mithro, 2018-06-25:
So, this is a pretty big challenge I think....

The iCE40 1K has the following resources;
  * 1280 Logic Cells
  * 64kbits Embedded RAM bits
  * 1 PLL

However, there might be hope, your stats seem to indicate the following;
```
VexRiscv smallest (RV32I, 0.52 DMIPS/Mhz, no datapath bypass, no interrupt) ->
  iCE40      -> 81 Mhz 1130 LC

VexRiscv smallest (RV32I, 0.52 DMIPS/Mhz, no datapath bypass) ->
  iCE40      -> 71 Mhz 1278 LC
```

But that is obviously *only* the CPU.

The SoC seems to use about double the LC;
```
Murax interlocked stages (0.45 DMIPS/Mhz) ->
  ICE40-HX   ->  51 Mhz 2402 LC (icestorm)

MuraxFast bypassed stages (0.65 DMIPS/Mhz) ->
  ICE40-HX   ->  50 Mhz, 2787 LC  (icestorm)
```

Thoughts?

Dolu1990, 2018-06-27:
Actualy, you VexRiscv smallest no interrupt could be a little smaller if you set the earlyInjection from the DBusSimplePlugin. It will write the data read access back into the pipeline into the memory stage instead of the writeBack stage.
It reduce the sice to 1064 LC.

Then someother optimisation have impacte on none ICE40 FPGA, as in ice40 if you use only the LUT of an LC you lose the FF (and the reverse too)

Hope it can help ^^

Dolu1990, 2018-09-23:
Would maybe be possible to have a 4 stage RISCV (no memory stage) + moving the register file read into the execute stage to avoid having to pipeline the reg files values to the execute stage.

It would for sure benefits regular FPGA area, but for ice40 the fact that LUT can't be reused if the FF of the LE is used nullify many possible optimisation.

Dolu1990, 2018-10-03:
Doing some experiments, by removing 1 fetch stage and moving the register file read into the execute stage i got :

MicroNoCsr ->
iCE40 -> 57 Mhz 999 LC   <- 999 is actualy smaller than 1K XD
Artix 7 -> 330 Mhz 537 LUT 389 FF
Cyclone V -> 144 Mhz 366 ALMs
Cyclone IV -> 120 Mhz 714 LUT 314 FF

mithro, 2018-10-03:
@Dolu1990 That is pretty awesome! Just need to figure out how to shove the rest of a SoC into the 1k too :-P

regymm, 2021-10-06:
I've just fitted the GenSmallestNoCsr into iCE40-HX1K with 2KB ROM, 4KB RAM, UART RX, and some memory-mapped GPIO for processing VT100 sequences -- VexRISCV is very promising!

The most difficult part for me is the block ram to iBus/dBus interface, as I didn't find any detailed documents about the buses. So it'll be nice if there're some examples for directly using block ram for instruction/data(Murax's arbitrator seems too much for the smallest design).

Dolu1990, 2021-10-11:
hmm using a true dual ported ram would produce the best results i guess.

For the ibus => https://github.com/SpinalHDL/VexRiscv#ibussimpleplugin

Stream and Flow are specified in the SpinalDoc.

For the dbus => https://github.com/SpinalHDL/VexRiscv#dbussimpleplugin

It is nearly similar, excepted for the rsp arbitration.

Thread 32 (2018-07-21):

What is the difference between iCE40HX8K-EVB and iCE40-hx8k_breakout_board

mithro, 2018-07-21:
My board says;
```
iCE40-HX8K Breakout Board
Rev A P/N: ICE40HX8K-B-EVN
```
Not sure which one that is... However iCE40HX8K-EVB uses `iceprogduino` while iCE40-hx8k_breakout_board uses `iceprog` which works with my board.

If this is all correct, once you run `iceprog` what is suppose to happen?

I'll try and send an updated README once I have this all figured out...

mithro, 2018-07-21:
I /think/ you want to connect to `/dev/ttyUSB1` and get something?

mithro, 2018-07-21:
```
    .io_uart_txd(io_B12),
    .io_uart_rxd(io_B10)
```

mithro, 2018-07-21:
The trick seems to be the way the jumpers on the board need to be configured.

The board seems to need to be in the "SPI Peripheral Mode" as described below;
> In SPI Peripheral Mode the SPI signals loads the program file into the CRAM (configuration ram) of the FPGA directly. In this mode the FPGA will lose its configuration when power is removed and must be re-configured. Jumpers must be in locations J6:1-2 and J6:3-4. Jumper J7 is not installed. See Figure 5

Dolu1990, 2018-07-21:
iCE40HX8K-EVB is another board which was added by somebody else, nothing related to the official hx8k breakout one.

Once you run the iceprog, the led[6:0] should count up, and the led 7 should blink. You should also be able to have the uart echo by using the right channel of the USB. It is 115200 baud rate with single top bit no parity.

I remember having issue when using the USB for both programming and serial uart, but i was on a virtual box machine running linux.

Let's me know if there is issues

Closed 2018-07-21.

Thread 36 (2018-08-02):

QSys interprets clock and reset as conduits

kaofishy, 2018-08-02:
Hi,

After compiling the VexRiscvAvalonForSim example, I imported the TCL component into Quartus but trying to instantiate it inside Platform Designer I receive the following errors:

```
Error: unsaved.VexRiscv_0: VexRiscv_0.debug_resetOut has an associatedClock of "clk" with incompatible type "conduit"
Error: unsaved.VexRiscv_0: VexRiscv_0.timerInterrupt has an associatedReset of "reset" with incompatible type "conduit"
Error: unsaved.VexRiscv_0: VexRiscv_0.timerInterrupt has an associatedClock of "clk" with incompatible type "conduit"
Error: unsaved.VexRiscv_0: VexRiscv_0.externalInterrupt has an associatedReset of "reset" with incompatible type "conduit"
Error: unsaved.VexRiscv_0: VexRiscv_0.externalInterrupt has an associatedClock of "clk" with incompatible type "conduit"
Error: unsaved.VexRiscv_0: VexRiscv_0.iBusAvalon has an associatedReset of "reset" with incompatible type "conduit"
Error: unsaved.VexRiscv_0: VexRiscv_0.iBusAvalon has an associatedClock of "clk" with incompatible type "conduit"
Error: unsaved.VexRiscv_0: VexRiscv_0.dBusAvalon has an associatedReset of "reset" with incompatible type "conduit"
Error: unsaved.VexRiscv_0: VexRiscv_0.dBusAvalon has an associatedClock of "clk" with incompatible type "conduit"
Error: unsaved.VexRiscv_0: VexRiscv_0.debugBusAvalon has an associatedReset of "debugReset" with incompatible type "conduit"
Error: unsaved.VexRiscv_0: VexRiscv_0.debugBusAvalon has an associatedClock of "clk" with incompatible type "conduit"
```
This happens with VexRiscvAvalanWithIntegratedJtag as well. I am using Quartus II 18.0 .

Tony

Dolu1990, 2018-08-05:
Hi,

When i made this autogenerated TCL stuff that was with Quartus II 14.1 (if i remember well) So maybe they had some changes which broke some of the compatibility ?

I will check what happened.

Charles

Dolu1990, 2018-08-05:
Ok so in fact i made it for qsys 13.1 ^^

Anyway, i tried with 15.1, and i remember it worked with it, and it is broken, something happend on my side, i will lets you know when it is fixed.

kaofishy, 2018-08-05:
No worries, I'm working with a MAX10 (very cheap dev boards!) so unfortunately 13.1 doesn't work for me.

Dolu1990, 2018-08-05:
I identified the issue and submited a fix to the SpinalHDL repo. but currently it isn't released.

But you can already use it :
- clone the SpinalHDL "dev" branch, go in it, do a sbt clean publish-local
- Update the SpinalHDL versions in the VexRiscv/build.sbt file to be 1.1.7
- do a sbt clean in the VexRiscv repo
- regenerate the VexRiscv hardware and now that should be fine ^^

By importing things in Qsys 17.0, things look fine for me, should be fine for qsys 18.0.

Just be carefull with resets :
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

kaofishy, 2018-08-05:
Just tried it in 18.0 and it works! Thanks for the quick response.

Closed 2018-08-05.

Thread 40 (2018-10-03):

Add support for using the DSP blocks on the iCE40UP5K?

mithro, 2018-10-03:
The iCE40UP5K has DSP tiles which are described as "DSP blocks with multiply and accumulate functions". They are 16 x 16 Multiply & 32 bit Accumulator Blocks which can be chained together to be a 32x32 multiply block. It would be awesome if the VexRISCV could use these DSP blocks for better performance.

One issue is that Yosys can't infer the ice40 DSP blocks at the moment, so they will have to be manually instantiated.

Dolu1990, 2018-10-03:
There is currently two implementation, the iterative one and the one which use 4 DSP blocks (2x16*16 + 2x17*16) which fit not too bad into the regular Altera/Xilinx FPGA.
(4 DSP blocks implementation there : https://github.com/SpinalHDL/VexRiscv/blob/master/src/main/scala/vexriscv/plugin/MulPlugin.scala#L74)

So, which architecture for the ICE40UP5K ? single DSP blocks reused 4 times ? or 4 DSP blocks running in // ?

I have to check the DSP blocks architecture.

mithro, 2018-10-03:
I have no idea what would be the best solution, I think we might just have to try it?

This is a diagram from their documentation;
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

mithro, 2018-10-03:
The iCE40 UltraPlus sysDSP can support the following functions:
 * 8-bit x 8-bit Multiplier
 * 16-bit x 16-bit Multiplier
 * 16-bit Adder/Subtracter
 * 32-bit Adder/Subtracter
 * 16-bit Accumulator
 * 32-bit Accumulator
 * 8-bit x 8-bit Multiply-Accumulate
 * 16-bit x 16-bit Multiply-Accumulate

limaconaudio, 2018-10-05:
I have been working on a reconfigurable ALU by blackboxing the DSP48E1 in Artix/Series7. The sysDSP is quite similar. I will share my code soon unless Dolu gets there quicker!

Dolu1990, 2018-11-14:
I tried the MulPlugin which infer DSP by using the * operator with icecube2, it worked fine, and isn't a frequancy bottleneck.
https://github.com/SpinalHDL/VexRiscv/blob/master/src/main/scala/vexriscv/plugin/MulPlugin.scala#L74
I don't currently know the behavior of icestorm on it.

I also tried to use the MulDivIterativePlugin, with as configuration a 4 time unrooled mul (8 cycle per mul, for a consumption of about 4x32 bits adder + 64 bits register, and it worked well, again without creating a fequancy bottleneck.

Else about handcrafting the mul instruction from DSP IP, the best solution i can see is the following :
Sharing the logic with the divider to make RS2 unsigned (and flip the RS1 signe if required) which then lead to a signed 33 bits * unsigned 32 bits multiplication
Then doing 4 unsigned multiplication between :
- RS1(15 downto 0) * RS2(15 downto 0)
- RS1(31 downto 16) * RS2(15 downto 0)
- RS1(15 downto 0) * RS2(31 downto 16)
- RS1(31 downto 16) * RS2(31 downto 16)
Sum all of that with the required shift, and conditionaly add RS2 once on the result depending the RS1(33) bit.

There is the functional code without the DSP stuff :
https://github.com/SpinalHDL/riscvSoftcoreContest/blob/053bee3f81311efdcdeaac048c07effd49aaae0f/hardware/scala/riscvSoftcoreContest/Up5kPerf.scala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

xobs, 2019-03-16:
Yosys is able to partially infer DSP blocks now.  However, it is not able to infer all of the DSP blocks.  See https://github.com/im-tomu/fomu-tests/tree/master/mul-infer for an example.

tomverbeure, 2019-03-16:
Splitting up the 32x32 multiplications into 4 16x16 isn't always the best solution. Often the FPGA synthesize tools are able to come up with a more efficient solution.

Here's my [MulSimple](https://github.com/tomverbeure/VexRiscv/commit/ae85698a2bf674e99c744169e56f8cbf2874778a) plugin that does exactly that.

Tom

xobs, 2019-03-16:
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

That doesn't work for Yosys, which isn't able to infer the 16-bit DSP at all:

```
Info: Device utilisation:
Info:            ICESTORM_LC:  7593/ 5280   143%
Info:           ICESTORM_RAM:    30/   30   100%
Info:                  SB_IO:    12/   96    12%
Info:                  SB_GB:     8/    8   100%
Info:           ICESTORM_PLL:     1/    1   100%
Info:            SB_WARMBOOT:     0/    1     0%
Info:           ICESTORM_DSP:     0/    8     0%
Info:         ICESTORM_HFOSC:     0/    1     0%
Info:         ICESTORM_LFOSC:     0/    1     0%
Info:                 SB_I2C:     0/    2     0%
Info:                 SB_SPI:     0/    2     0%
Info:                 IO_I3C:     0/    2     0%
Info:            SB_LEDDA_IP:     0/    1     0%
Info:            SB_RGBA_DRV:     0/    1     0%
Info:         ICESTORM_SPRAM:     4/    4   100%
```

tomverbeure, 2019-03-16:
Ok, then that's something Yosys will need to add over time. It really depends on the Synthesis tool. For example, on some Altera devices, 4x 16x16 requires more DSP resources and 32x32, even if it should give the same result.

Tom

xobs, 2019-07-17:
I've come up with this that works in simulation, comparing it against an inferred multiply:

```verilog

    wire [0:31] int_lo_lo;
    wire [0:31] int_lo_hi;
    wire [0:31] int_hi_lo;
    wire [0:31] int_hi_hi;

    SB_MAC16 #(
        .NEG_TRIGGER(1'b0),
        .C_REG(1'b0),
        .A_REG(1'b0),
        .B_REG(1'b0),
        .D_REG(1'b0),
        .TOP_8x8_MULT_REG(1'b0),
        .BOT_8x8_MULT_REG(1'b0),
        .PIPELINE_16x16_MULT_REG1(1'b0),
        .PIPELINE_16x16_MULT_REG2(1'b0),
        .TOPOUTPUT_SELECT(2'b11),
        .TOPADDSUB_LOWERINPUT(2'b00),
        .TOPADDSUB_UPPERINPUT(1'b0),
        .TOPADDSUB_CARRYSELECT(2'b00),
        .BOTOUTPUT_SELECT(2'b11),
        .BOTADDSUB_LOWERINPUT(2'b00),
        .BOTADDSUB_UPPERINPUT(1'b0),
        .BOTADDSUB_CARRYSELECT(2'b00),
        .MODE_8x8(1'b0),
        .A_SIGNED(1'b0),
        .B_SIGNED(1'b0)
    ) mul16_lo_lo (
        .A(srca[16:31]),
        .AHOLD(1'b1),
        .B(srcb[16:31]),
        .BHOLD(1'b1),
        .C(16'h0000),
        .D(16'h0000),
        .CHOLD(1'b0),
        .DHOLD(1'b0),

        .IRSTTOP                    (1'b0), //keep hold register in reset
        .IRSTBOT                    (1'b0), //keep hold register in reset
        .ORSTTOP                    (1'b0), //keep hold register in reset
        .ORSTBOT                    (1'b0), //keep hold register in reset
        .OLOADTOP                   (1'b0), //keep unused signals quiet
        .OLOADBOT                   (1'b0), //keep unused signals quiet
        .ADDSUBTOP                  (1'b0), //unused
        .ADDSUBBOT                  (1'b0), //unused
        .OHOLDTOP                   (1'b0), //keep hold register stable
        .OHOLDBOT                   (1'b0), //keep hold register stable

        .CE(1'b1),
        .CLK(1'b0),

        // .CO(1'b0), .ACCUMCO(1'b0), .SIGNEXTOUT(1'b0),
        .CI(1'b0), .ACCUMCI(1'b0), .SIGNEXTIN(1'b0),

        .O(int_lo_lo[0:31])
    );

    SB_MAC16 #(
        .NEG_TRIGGER(1'b0),
        .C_REG(1'b0),
        .A_REG(1'b0),
        .B_REG(1'b0),
        .D_REG(1'b0),
        .TOP_8x8_MULT_REG(1'b0),
        .BOT_8x8_MULT_REG(1'b0),
        .PIPELINE_16x16_MULT_REG1(1'b0),
        .PIPELINE_16x16_MULT_REG2(1'b0),
        .TOPOUTPUT_SELECT(2'b11),
        .TOPADDSUB_LOWERINPUT(2'b00),
        .TOPADDSUB_UPPERINPUT(1'b0),
        .TOPADDSUB_CARRYSELECT(2'b00),
        .BOTOUTPUT_SELECT(2'b11),
        .BOTADDSUB_LOWERINPUT(2'b00),
        .BOTADDSUB_UPPERINPUT(1'b0),
        .BOTADDSUB_CARRYSELECT(2'b00),
        .MODE_8x8(1'b0),
        .A_SIGNED(1'b0),
        .B_SIGNED(1'b0)
    ) mul16_lo_hi (
        .A(srca[16:31]),
        .AHOLD(1'b1),
        .B(srcb[0:15]),
        .BHOLD(1'b1),
        .C(16'h0000),
        .D(16'h0000),
        .CHOLD(1'b0),
        .DHOLD(1'b0),

        .IRSTTOP                    (1'b0), //keep hold register in reset
        .IRSTBOT                    (1'b0), //keep hold register in reset
        .ORSTTOP                    (1'b0), //keep hold register in reset
        .ORSTBOT                    (1'b0), //keep hold register in reset
        .OLOADTOP                   (1'b0), //keep unused signals quiet
        .OLOADBOT                   (1'b0), //keep unused signals quiet
        .ADDSUBTOP                  (1'b0), //unused
        .ADDSUBBOT                  (1'b0), //unused
        .OHOLDTOP                   (1'b0), //keep hold register stable
        .OHOLDBOT                   (1'b0), //keep hold register stable

        .CE(1'b1),
        .CLK(1'b0),

        // .CO(1'b0), .ACCUMCO(1'b0), .SIGNEXTOUT(1'b0),
        .CI(1'b0), .ACCUMCI(1'b0), .SIGNEXTIN(1'b0),
        .O(int_lo_hi[0:31])
    );

    SB_MAC16 #(
        .NEG_TRIGGER(1'b0),
        .C_REG(1'b0),
        .A_REG(1'b0),
        .B_REG(1'b0),
        .D_REG(1'b0),
        .TOP_8x8_MULT_REG(1'b0),
        .BOT_8x8_MULT_REG(1'b0),
        .PIPELINE_16x16_MULT_REG1(1'b0),
        .PIPELINE_16x16_MULT_REG2(1'b0),
        .TOPOUTPUT_SELECT(2'b11),
        .TOPADDSUB_LOWERINPUT(2'b00),
        .TOPADDSUB_UPPERINPUT(1'b0),
        .TOPADDSUB_CARRYSELECT(2'b00),
        .BOTOUTPUT_SELECT(2'b11),
        .BOTADDSUB_LOWERINPUT(2'b00),
        .BOTADDSUB_UPPERINPUT(1'b0),
        .BOTADDSUB_CARRYSELECT(2'b00),
        .MODE_8x8(1'b0),
        .A_SIGNED(1'b0),
        .B_SIGNED(1'b0)
    ) mul16_hi_lo (
        .A(srca[0:15]),
        .AHOLD(1'b1),
        .B(srcb[16:31]),
        .BHOLD(1'b1),
        .C(16'h0000),
        .D(16'h0000),
        .CHOLD(1'b0),
        .DHOLD(1'b0),
        .IRSTTOP                    (1'b0), //keep hold register in reset
        .IRSTBOT                    (1'b0), //keep hold register in reset
        .ORSTTOP                    (1'b0), //keep hold register in reset
        .ORSTBOT                    (1'b0), //keep hold register in reset
        .OLOADTOP                   (1'b0), //keep unused signals quiet
        .OLOADBOT                   (1'b0), //keep unused signals quiet
        .ADDSUBTOP                  (1'b0), //unused
        .ADDSUBBOT                  (1'b0), //unused
        .OHOLDTOP                   (1'b0), //keep hold register stable
        .OHOLDBOT                   (1'b0), //keep hold register stable

        .CE(1'b1),
        .CLK(1'b0),

        // .CO(1'b0), .ACCUMCO(1'b0), .SIGNEXTOUT(1'b0),
        .CI(1'b0), .ACCUMCI(1'b0), .SIGNEXTIN(1'b0),
        .O(int_hi_lo[0:31])
    );

    SB_MAC16 #(
        .NEG_TRIGGER(1'b0),
        .C_REG(1'b0),
        .A_REG(1'b0),
        .B_REG(1'b0),
        .D_REG(1'b0),
        .TOP_8x8_MULT_REG(1'b0),
        .BOT_8x8_MULT_REG(1'b0),
        .PIPELINE_16x16_MULT_REG1(1'b0),
        .PIPELINE_16x16_MULT_REG2(1'b0),
        .TOPOUTPUT_SELECT(2'b11),
        .TOPADDSUB_LOWERINPUT(2'b00),
        .TOPADDSUB_UPPERINPUT(1'b0),
        .TOPADDSUB_CARRYSELECT(2'b00),
        .BOTOUTPUT_SELECT(2'b11),
        .BOTADDSUB_LOWERINPUT(2'b00),
        .BOTADDSUB_UPPERINPUT(1'b0),
        .BOTADDSUB_CARRYSELECT(2'b00),
        .MODE_8x8(1'b0),
        .A_SIGNED(1'b0),
        .B_SIGNED(1'b0)
    ) mul16_hi_hi (
        .A(srca[0:15]),
        .AHOLD(1'b1),
        .B(srcb[0:15]),
        .BHOLD(1'b1),
        .C(16'h0000),
        .D(16'h0000),
        .CHOLD(1'b0),
        .DHOLD(1'b0),

        .IRSTTOP                    (1'b0), //keep hold register in reset
        .IRSTBOT                    (1'b0), //keep hold register in reset
        .ORSTTOP                    (1'b0), //keep hold register in reset
        .ORSTBOT                    (1'b0), //keep hold register in reset
        .OLOADTOP                   (1'b0), //keep unused signals quiet
        .OLOADBOT                   (1'b0), //keep unused signals quiet
        .ADDSUBTOP                  (1'b0), //unused
        .ADDSUBBOT                  (1'b0), //unused
        .OHOLDTOP                   (1'b0), //keep hold register stable
        .OHOLDBOT                   (1'b0), //keep hold register stable

        .CE(1'b1),
        .CLK(1'b0),

        // .CO(1'b0), .ACCUMCO(1'b0), .SIGNEXTOUT(1'b0),
        .CI(1'b0), .ACCUMCI(1'b0), .SIGNEXTIN(1'b0),
        .O(int_hi_hi[0:31])
    );

    reg [0:31] result;
    assign out = result;
    always @(posedge clk)
    begin
        result <= int_lo_lo[0:31] + (int_lo_hi[0:31] << 16) + (int_hi_lo[0:31] << 16);
    end
```

We never actually use the `int_hi_hi`, so that could be removed.  Curiously, the iCECube synthesis tools also use four SB_MAC16 blocks.  I feel like there's something I'm missing here with regards to signed multiplication, but I'm throwing random values at it in simulation and the above block works just fine.

How difficult would it be to add this to VexRiscv?

xobs, 2019-07-17:
Incidentally, I'm working on adding support to Yosys to just infer this when there is a 32-bit multiply, so this may become a non-issue.

Dolu1990, 2019-07-17:
Hi,
I’m in holiday in a foreign country until friday, then i can check more in depth :)
But what’s about MULH ?

xobs, 2019-07-17:
Take your time!

Do you have an example of what the Verilog would look like, so I can come up with something that uses the `SB_MAC16` blocks to accomplish that?

xobs, 2019-07-18:
Actually, apparently Yosys is getting better inferrence for DSP blocks, so this may become a non-issue soon. `MulSimple` may end up being the correct approach once they have that working.

Dolu1990, 2019-07-22:
@xobs In which context are you using the mul instruction ?
I mean, the goal is to get best performances ? Or having a good tradeoff between area and speed ?

xobs, 2019-07-23:
The big reason is to gain RV32im support, which seems to be the most common ABI.

Eventually I would like to try getting the self-refilled MMU working as well, but one step at a time.

osresearch, 2021-05-25:
I'm also trying to use the iCE40 DSP blocks to replace the multi-step, low-area picorv32 multiplier.  This four `SB_MAC16` design takes two signed or unsigned 32-bit values and produces a signed 64 bit output that passes the `MUL`, `MULH`, `MULHU` and `MULHSU` tests, as well as some integration tests using the monocypher crypto library.  Routing it uses about the same LUTs as the `picorv32_pcpi_mul` module, but delivers results in a single clock.

It seems to me that there should be a better way to handle signed multiplication without doing a full 64-bit `~prod + 1` ripple add, although I haven't figured out how to do it yet.  Maybe using the `ADDSUBTOP` and `ADDSUBBOT` bits to subtract from the accumulator?

```
module mult16x16(
        input clk,
        input [15:0] a,
        input [15:0] b,
        input [31:0] c,
        output [31:0] prod,
        output carry_out
);
`ifdef IVERILOG
        wire [32:0] ab = a * b;
        wire [32:0] mult = ab + c;
        wire [31:0] prod = mult[31:0];
        wire carry_out = mult[32];
`else
        SB_MAC16 #(
                .TOPOUTPUT_SELECT(2'b00), // adder, unregistered
                .TOPADDSUB_LOWERINPUT(2'b10), // multiplier hi bits
                .TOPADDSUB_UPPERINPUT(1'b1), // input C
                .TOPADDSUB_CARRYSELECT(2'b11), // top carry in is carry out from lower adder
                .BOTOUTPUT_SELECT(2'b00), // adder, unregistered
                .BOTADDSUB_LOWERINPUT(2'b10), // multiplier lo bits
                .BOTADDSUB_UPPERINPUT(1'b1), // input D
                .BOTADDSUB_CARRYSELECT(2'b00) // bottom carry in constant 0
        ) mult16x16_add(
                .CLK(clk),
                .A(a),
                .B(b),
                .C(c[31:16]),
                .D(c[15:0]),
                .O(prod),
                .CO(carry_out)
        );
`endif
endmodule

module mult32x32_signed(
        input clk,
        input [31:0] a,
        input [31:0] b,
        input a_sign,
        input b_sign,
        output [63:0] prod,
        output carry_out
);
        // todo: figure out the sign bit extension to avoid the extra plusses
        wire a_neg = a[31] & a_sign;
        wire b_neg = b[31] & b_sign;
        wire [31:0] a_pos = a_neg ? ~a + 1'b1 : a;
        wire [31:0] b_pos = b_neg ? ~b + 1'b1: b;
        wire [15:0] al = a_pos[15: 0];
        wire [15:0] bl = b_pos[15: 0];
        wire [15:0] ah = a_pos[31:16];
        wire [15:0] bh = b_pos[31:16];

        wire [31:0] al_bl;
        wire [31:0] al_bh;
        wire [31:0] ah_bl;
        wire [31:0] ah_bh;
        wire al_bl_carry;
        wire al_bh_carry;
        wire ah_bl_carry;

        // if both inputs are negative or positive, the result is positive,
        // so only if a XOR b is negative do we produce a negative result
        wire neg_result = (a_neg ^ b_neg);

        wire [63:0] prod_u = { ah_bh[31:0], al_bh[15:0], al_bl[15:0] };

        // ideally we could do the MAC with the carry, but that seems to fail
        assign prod = neg_result ? ~prod_u + 1'b1 : prod_u;

        mult16x16 mult_al_bl(
                .clk(clk),
                .a(al),
                .b(bl),
                .c(0),
                .prod(al_bl),
                .carry_out(al_bl_carry)
        );

        mult16x16 mult_ah_bl(
                .clk(clk),
                .a(ah),
                .b(bl),
                .c({16'h0000, al_bl[31:16]}), // al_bl_carry can never be set
                .prod(ah_bl),
                .carry_out(ah_bl_carry) // ah_bl_carry should never be set
        );

        mult16x16 mult_al_bh(
                .clk(clk),
                .a(al),
                .b(bh),
                .c(ah_bl),
                .prod(al_bh),
                .carry_out(al_bh_carry) // al_bh_carry *can* be set
        );

        // ah_bl_carry will never be set, but the second term might
        mult16x16 mult_ah_bh(
                .clk(clk),
                .a(ah),
                .b(bh),
                .c({15'h0000, al_bh_carry, al_bh[31:16]}),
                .prod(ah_bh),
                .carry_out(carry_out)
        );

endmodule
```

maikmerten, 2022-02-14:
@osresearch Thanks for posting your code, this was very helpful! Starting from there, I experimented a bit and for now arrived at this code, which extends the 32-bit operands to 33-bits. For signed operations, the operands are sign-extended, for unsigned operations they are zero-extended. The extended operands are then fed into a signed multiplication. Yosys successfully infers four DSP blocks for this with "synth_ice40 -dsp" and the solution doesn't have carry-chains for inverting the two-complement representation.

```
`default_nettype none

`include "cpu/aludefs.vh"

module spu32_cpu_muldsp(
        input I_clk,
        input I_en,
        input I_reset,
        input[3:0] I_op,
        input[31:0] I_s1,
        input[31:0] I_s2,
        output[63:0] O_result,
        output O_busy
    );

    // single-cycle multiplication with inferred DSP blocks
    assign O_busy = 0;

    // determine sign/zero-extension for operands
    reg s1_extension, s2_extension;
    always @(*) begin
        s1_extension = 1'b0;
        s2_extension = 1'b0;
        case(I_op)
            `ALUOP_MULH: begin
                s1_extension = I_s1[31]; // sign-extend s1
                s2_extension = I_s2[31]; // sign-extend s2
            end
            `ALUOP_MULHSU: begin
                s1_extension = I_s1[31]; // sign-extend s1
            end
        endcase
    end

    wire[63:0] mul_signed = $signed({s1_extension, I_s1}) * $signed({s2_extension, I_s2});
    assign O_result = mul_signed;

endmodule
```

This passes the multiplication test vectors from the RISC-V test suite, so I'm somewhat hopeful things may be correct (as they should be, unless I'm missing a gotcha regarding two-complement multiplication). Perhaps this works for you as well?

osresearch, 2022-02-14:
I should have posted a followup... since mainline yosys with `-dsp` now infers multipliers and Claire merged my changes to enable a DSP multiply instructions for the picorv32, for that application it is no longer necessary to hand-code the hard blocks. https://github.com/YosysHQ/picorv32/pull/202

Dolu1990, 2022-02-15:
@osresearch Thanks ^^

Closed 2022-02-15.

Thread 41 (2018-10-19):

Processor not writing to data memory

yannickl96, 2018-10-19:
Hello everyone. I seem to have encountered a bug when I try to use the VexRiscv processor in a Vivado block design. The benchmarks dhrystone and towers from https://github.com/riscv/riscv-tests/tree/master/benchmarks work fine, however when I try to run the multiply benchmark, the processor only reads from the data memory and never writes. This gets even weirder because the addresses that it reads, are the addresses that it shall write to. The dBusAxi is connected to an AXI Bram controller IP which is connected to a block memory generator with 32KiB of memory. I attached the data that I gathered with an ILA core and the assembler generated by the RISC-V GCC. Please let me know if you need any more info.

Cheers!
[multiply_vexriscv.zip](https://github.com/SpinalHDL/VexRiscv/files/2496739/multiply_vexriscv.zip)
[multiply_vexriscv.txt](https://github.com/SpinalHDL/VexRiscv/files/2496745/multiply_vexriscv.txt)

Edit: I should also mention that I use commit 64022557bf8a8350c868a6bce73a529029f1a3e7 and the VexRiscvAxi4WithIntegratedJtag configuration because it does not work for me in newer versions.

Dolu1990, 2018-10-21:
Hi,

Would it be possible to have the vcd with all the signals ? (including the CPU signals)

Thanks :)

yannickl96, 2018-10-21:
You mean the internal processor signals?

Dolu1990, 2018-10-21:
Yes ^^

Dolu1990, 2018-10-21:
Hooo are you debugging directly on the physical target ?

yannickl96, 2018-10-21:
Yes, sir ^^. In theory, the processor should work fine (at least according to the regression tests). However, on the Xilinx PYNQ-Z1 there are some problems.

yannickl96, 2018-10-29:
@Dolu1990 I have to add the signals post-synthesis which results in about 1200 signals (and my PYNQ doesn't have nearly enough BRAM to save them all). Are there any signals which are more helpful to you than others?

yannickl96, 2018-10-29:
Thank you for the hint! I will give it a try.

Dolu1990, 2018-10-29:
@yannickl96 Sorry had lost the track of this issue.

So, the thing is you realy need to do a simulation to sort this kind of things out, especialy if you have a whole system/third party stuff in the project. Debuging it the half blind is realy a paine full process :)

About synthesis issues, i have to say that this kind of issue already happend to me on Zynq. That's quite a paine in the ass if that's the case there :/

yannickl96, 2018-10-29:
Well, it would not be the first time that Vivado would do something unfortunate. -.-^^

yannickl96, 2018-11-15:
@Dolu1990 Did your synthesis issue on your Zynq by any chance emerge due to an error in the memory map?

Dolu1990, 2018-11-15:
Yes, exactly, it was the issue. Bad memory synthesis, and it was somehow quite random.

Closed 2019-05-25.

Thread 43 (2018-11-22):

Can the Briey SoC run on a iCE40-HX8K-CT256?

ndbroadbent, 2018-11-22:
The README seems to suggest that the Murax SoC is the only one that can be run on an iCE40 FPGA.

But I was a bit confused by the Briey SoC timings and area:

```
  Artix 7    -> 239 Mhz 3227 LUT 3410 FF
  Cyclone V  -> 125 Mhz 2,207 ALMs
  Cyclone IV -> 112 Mhz 4,594 LUT 3,620
```

I think I am mistunderstanding these numbers, because the iCE40-HX8K chip has 7,680 LUTs, which is greater than 3227, 2,207, and 4,594.

I'm new to FPGAs, so sorry for the question. But how many LUTs does the Briey SoC require? And what do those "area" numbers mean?

(I've just bought a iCE40-HX8K breakout board. But I might also get a Artix 7 (or Zynq 7020) board to play with VexRiscv.)

Dolu1990, 2018-11-22:
So, there is three potential things about the ICE40 :
- Each LC has only one output, can be the FF or the LUT, but not both, so if you do much pipelining with register, you lose a lot of LUT that you can't reuse (in Cyclone IV you can)
- Icestorm could fail with the place and route when the occupancy is high (if you consider the above point, it is very likely the case)
- Maybe it failed because the SoC use to many IO (GPIO)

I have to check it ^^

Maybe this could interrest you, there is Up5kPerf and Up5kArea :
https://github.com/SpinalHDL/riscvSoftcoreContest

ndbroadbent, 2018-11-22:
Thanks @Dolu1990! That makes sense about the place and route failing when the occupancy is high. I didn't realize there would need to be some leftover LUTs as a "buffer" so that the circuit can fit.

I really like the open source tooling around Project IceStorm, so I think I will start with the iCE40 chips, and I'll just be happy with the Murax SoC for now. But maybe in the future I will also get a snickerdoodle black (Xilinx Zynq-7020 SoC with an Artix 7), and then I can play around with the full RISC-V CPU (and run it at a higher speed.)

Also the riscvSoftcoreContest looks awesome! Would these also run on a iCE40-HX8K?

I'm a bit confused - From what I read it sounds like the iCE40 UltraPlus is newer and faster, but it only has 5k LUTs? But the HX8K has 8k LUTs. So it's hard for me to tell which one is better.

Would you recommend that I buy a development board with an UltraPlus or a HX8K?

Dolu1990, 2018-11-22:
So, to run on iCE40 HX8K, you would probably need to enable the instruction cache or having a faster XIP flash controller. You can still run the code from RAM, but there is not so much of it in the HX8K ^^
About the UltraPlus (UP5K) That's probably the slowest modern FPGA that you can get, they are about 3 time slower than the HX8K.
They have only 5K lut but they have a loooooooot of ram via their SPRAM. which is "ground breaking XD"
Yesteday i made some power consumption with murax on it =>  1.2V comsumption was 4 mA to run at 12 Mhz, which is realy not much, comparable to ASIC MCU, and 200 uA when the clock was off. That's the point of Up5k : ram and consumption.

So between ultraplus and hx8k, honnestly, i don't know what is the best, the memory ressource of the HX8K hurt a bit, but you can have external memories, that's fine ^^ and the hx8k is way faster.
If you want to do a tiny tiny thing without minimal external component with low power => Up5k

ndbroadbent, 2018-11-22:
Interesting, thanks so much! That was really helpful!

I'm just learning, so I don't really need a lot of speed or RAM. So it sounds like the iCE40 HX8K is still a great chip to learn on. Thanks again!

Closed 2018-11-22.

Thread 48 (2018-12-22):

JTAG/Reset Lock Up (Avalon)

cutephoton, 2018-12-22:
So I've been banging my head on the desk trying to understand the debug/jtag. I think the problem is related to reset.

For reference, this is my qsys diagram:

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

`monitor reset halt` -> locks up
`monitor reset resume` -> locks up
`monitor halt` -> works
`monitor resume` -> works

This is what halt/resume cycles look like:

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

And now `monitor reset run/halt`

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

Thoughts?

OCD config:
```
#-----------------------------------------
# JTAG Adapter
#
interface ftdi
ftdi_vid_pid 0x0403 0x6014
#ftdi_layout_init 0x0c08 0x0f1b
ftdi_layout_init 0xfff8 0xfffb
ftdi_layout_signal nTRST -data 0x0100 -oe 0x0100
ftdi_layout_signal nSRST -data 0x0200 -oe 0x0200
transport select jtag

#-----------------------------------------
# Target
#
set  _ENDIAN little
set _TAP_TYPE 1234
set _CPUTAPID 0x10001FFF

adapter_khz 4000
# have tried 25,100,1000 too
adapter_nsrst_delay 260
jtag_ntrst_delay 250

set _CHIPNAME fpga_spinal
jtag newtap $_CHIPNAME bridge -expected-id $_CPUTAPID -irlen 4 -ircapture 0x1 -irmask 0xF

target create $_CHIPNAME.cpu0 vexriscv -endian $_ENDIAN -chain-position $_CHIPNAME.bridge -coreid 0 -dbgbase 0xF00F0000
vexriscv readWaitCycles 12
vexriscv cpuConfigFile ../cpu0.yaml

poll_period 50

init
#echo "Halting processor"
soft_reset_halt
```
GDB:
```
target remote localhost:3333
set arch riscv:rv32
monitor reset halt
load
continue
```

Dolu1990, 2018-12-22:
Hi,
One thing, acordignly to https://github.com/SpinalHDL/VexRiscv#cpu-clock-and-resets, is that all the peripherals and the interconnect is also reseted by the debug_resetOut.

The reason of that is, if the CPU get a reset while a transaction was pending, and the arbitration isn't reseted, the interconnect/peripherals can get a lockup.

Maybe that's the issue :)
Let's me know.

Dolu1990, 2018-12-22:
Also, what is your IBus configuration ? if that's the uncached one, it is important to have https://github.com/SpinalHDL/VexRiscv/blob/master/src/main/scala/vexriscv/plugin/IBusSimplePlugin.scala#L160 set to true.

cutephoton, 2018-12-22:
Well, I think this is it:

`case plugin: DebugPlugin => {`
should be:
`case plugin: DebugPlugin => plugin.debugClockDomain {`

That really broke my head. This problem seems to exist in both avalon demos. I'll try prepare a pull request once I recover from this HDL hangover. :)

cutephoton, 2018-12-22:
FYI, was able to get cache up and running. Pretty satisfying. Thanks for the help.

cutephoton, 2018-12-23:
Maybe I spoke too soon. I'm finding with the cache enabled that after stepping the first two instructions (GP, and SP loads) that reads appear to be referencing data 2 words off. If I issue a write, it does write back to the correct address.

memory map:
```
                0x0000000080000200                time_t1
                0x0000000080000204                time_t0              -> 0xF0002010
                0x0000000080000208                time_systick      -> 0xF0002000
                0x000000008000020c                gpio_a               -> 0xF0003010
                0x0000000080000210                gpio_led            -> 0xF0003000
```

GDB:

```
(gdb)     monitor reset halt
JTAG tap: fpga_spinal.bridge tap/device found: 0x10001fff (mfg: 0x7ff (<invalid>), part: 0x0001, ver: 0x1)
(gdb)     load
Loading section .vector, size 0x104 lma 0x80000000
Loading section .memory, size 0x80 lma 0x80000104
Loading section .text.startup, size 0x58 lma 0x80000184
Loading section .rodata, size 0x24 lma 0x800001dc
Loading section .data, size 0x18 lma 0x80000200
Start address 0x80000000, load size 536
Transfer rate: 52 KB/sec, 107 bytes/write.
(gdb) print &gpio_led
$7 = (volatile struct IO_gpio_registers **) 0x80000210 <gpio_led>
(gdb) x /1ix 0x80000210
0x80000210 <gpio_led>:	0xf0003000                                        **CORRECT**
(gdb) set gpio_led->value=0xFF
(gdb) step
crtInit () at src/crt.S:64
64	  mret                                                           *exiting reset*
(gdb) step
77	     la gp, __global_pointer$
(gdb) x /1ix 0x80000210
0x80000210 <gpio_led>:	0xf0003010                                         **now reading gpio_a**
(gdb) step
crtInit () at src/crt.S:84
84	  la sp, _stack_start
(gdb) x /1ix 0x80000210
0x80000210 <gpio_led>:	0xf0003010
(gdb) step

Breakpoint 1, 0x800000c0 in bss_init () at src/crt.S:84
84	  la sp, _stack_start
(gdb) x /1ix 0x80000210
0x80000210 <gpio_led>:	0xf0002000                                        **now time_systick**
```
Here are the settings - is there some magic setting I'm missing?
```
          new IBusCachedPlugin(
            resetVector = 0x80000000l,
            prediction = STATIC,
            config = InstructionCacheConfig(
              cacheSize = 4096,
              bytePerLine =32,
              wayCount = 1,
              addressWidth = 32,
              cpuDataWidth = 32,
              memDataWidth = 32,
              catchIllegalAccess = true,
              catchAccessFault = true,
              catchMemoryTranslationMiss = true,
              asyncTagMemory = false,
              twoCycleRam = true,
              twoCycleCache = true
            )
            //            askMemoryTranslation = true,
            //            memoryTranslatorPortConfig = MemoryTranslatorPortConfig(
            //              portTlbSize = 4
            //            )
          ),
          //                    new DBusSimplePlugin(
          //                      catchAddressMisaligned = true,
          //                      catchAccessFault = true
          //                    ),
          new DBusCachedPlugin(
            config = new DataCacheConfig(
              cacheSize         = 4096,
              bytePerLine       = 32,
              wayCount          = 1,
              addressWidth      = 32,
              cpuDataWidth      = 32,
              memDataWidth      = 32,
              catchAccessError  = true,
              catchIllegal      = true,
              catchUnaligned    = true,
              catchMemoryTranslationMiss = true
            ),
            memoryTranslatorPortConfig = null
            //            memoryTranslatorPortConfig = MemoryTranslatorPortConfig(
            //              portTlbSize = 6
            //            )
          ),
```

cutephoton, 2018-12-24:
Hmm... I disabled the Dcache but I still get read issues wrt the debugger. I'm running at 80MHz (up from 50MHz). At some point, I had it running reliably at 125MHz without the cache. No timing violations noted. Peripheral bus is 50MHz.

```
(gdb) x /8ix 0x80000200
0x80000200 <time_t1>:	0x00000000	0x00000000	0xf0002000	0x00000000
0x80000210 <gpio_led>:	0x00000000	0x00000000	0x00000000	0x00000001
(gdb) x /8ix 0x80000200
0x80000200 <time_t1>:	0xf0002200	0x00000000	0x00000000	0x00000000
0x80000210 <gpio_led>:	0xf0003000	0x00000000	0x00000000	0x00000001
```

Dolu1990, 2018-12-24:
There is something getting wrong :/

So, by hazard, which Altera kit are you using ? i have some altera device here, DE1-SOC. Maybe i can give a try with your project on it ?

Becaus has far i know, the debug implementation was stable one all target i tried.

What JTAG bridge are you using ?

cutephoton, 2018-12-24:
I do have the DE1-SOC but been using Max10s lately. Besides, where's the fun if just works?

It's all good now. I hope. It was (maybe) Intels fault! (I updated the top of the last comment, but maybe it wasn't clear.)  QSys started throwing null pointer exceptions and other strange behaviors (UIs not working). The SignalTap output was surprising. ¯\_(ツ)_/¯ that's all I got.

Dolu1990, 2018-12-24:
hmm
Ok, let's me know if things a turning bad again, i just tested in sim the debug with the Briey SoC which also use caches, (haven't use it since at least 1 year) and it worked fine :)

Dolu1990, 2018-12-31:
Hooo yes, you are right, i just fixed the issue in the dev branch of SpinalHDL.
Do you know the flow to use the unreleased stuff ?

Dolu1990, 2018-12-31:
Stupid mistake :)

cutephoton, 2018-12-31:
Thanks. I think we can mark this one resolved, eh? A good way to end the year!

:balloon:  :balloon: :balloon:  :balloon:

Dolu1990, 2018-12-31:
Yes ^^

Closed 2018-12-31.

Thread 51 (2019-01-10):

Can't access the code memory when a breakpoint is set on it

LukasJaegerSIT, 2019-01-10:
Greetings!
I am basing my cybersecurity research on VexRiscV and need to build a firmware that can hash parts of itself. I noticed that the hash algorithm failed when a certain point in the code was reached and I noticed that this point had the same address as the breakpoint I had set for debugging. I've stripped away the hash code and tried this on a completely unmodified branch of VexRiscV (Murax, simulation only):

```c
// Here we copy program code with a breakpoint
// into another part of the RAM.
uint8_t * ram_ptr = (uint8_t*) (0x80000450);
uint8_t arr [32] = {0};
for (int i = 0; i < 32; i++){
	arr[i] = ram_ptr[i];
}
```

I noticed that the word at the address where the breakpoint was set (0x80000454) was not copied correctly. Instead of the expected piece of RISC-V assembly, I got those four bytes: 0x73, 0x0, 0x10, 0x0. I've attached the full demo if you want to check this for yourself.
[ram_err_demo.tar.gz](https://github.com/SpinalHDL/VexRiscv/files/2745290/ram_err_demo.tar.gz)

The steps I executed:

* Built Murax using `sbt`
* Started Verilator
* Started `gdb` and connected to the remote target
* Did `monitor reset halt` and `load`
* Set a breakpoint at `main.c:46` and continued
* Printed `arr`

This is a pretty special use case but for me it is crucial that I can access the code memory and hash it without that glitch. Do you have any idea what could cause this? I will look into the debugging plugin myself and try to determine the reason but if you know it from the top of your head it would be a great help. If I can find a solution, I will inform you and create a pull request.

Dolu1990, 2019-01-10:
Hi,

That's not a bug. What is happening, is for Murax, the code is executed from RAM, so GDB is using software breakpoints, it modify the programm memory with a RISC-V EBREAK (0x00100073, as you have seen) in order to make the CPU break when the instruction is executed.

To avoid that you have to do two things :
- Adding hardware breakpoints in Murax by forcing https://github.com/SpinalHDL/VexRiscv/blob/master/src/main/scala/vexriscv/demo/Murax.scala#L70 to 3
- Modify the linkerscript stuff of your software to define the code region as a read-only one. (it will force GDB to use hardware breakpoint)

Does that seem good ?

LukasJaegerSIT, 2019-01-10:
Ah... that makes sense. I will try hardware breakpoints. Thank you very much.

Dolu1990, 2019-01-10:
Just be sure to have pull the openocd_riscv again, and recompile it to have the last version :)

Closed 2019-01-10.

Thread 70 (2019-04-23):

No trap generated for `divu` on core without divide

xobs, 2019-04-23:
On a VexRiscv core without a Multiply or Divide stage, the core will execute a `divu` instruction.  It does... _something_.  I'm not sure what.

The VexRiscv source file is at https://github.com/xobs/VexRiscv-verilog/blob/riscv-contest-20190315/src/main/scala/vexriscv/GenCoreDefault.scala.  This particular core was instantiated with the following command:

    run-main vexriscv.GenCoreDefault --iCacheSize 1024 --dCacheSize 0 --mulDiv false --singleCycleMulDiv false --outputFile 2-stage-1024-cache --pipelining false --memoryStage false --writeBackStage false

As you can see, `mulDiv` is `false`, which causes no divider to be added.

Here is the result of running that instruction on an FPGA:

```
(gdb) disassemble $pc-4,$pc+8
Dump of assembler code from 0x20040530 to 0x2004053c:
   0x20040530 <gc_init+8>:      li      a2,65
=> 0x20040534 <gc_init+12>:     divu    a4,a4,a2
   0x20040538 <gc_init+16>:     addi    sp,sp,-16
End of assembler dump.
(gdb) p/x $a2
$5 = 0x41
(gdb) p/x $a4
$6 = 0xfffc
(gdb) stepi
0x20040538      122         MP_STATE_MEM(gc_alloc_table_byte_len) = total_byte_len / (1 + BITS_PER_BYTE / 2 * BYTES_PER_BLOCK);(gdb) disassemble $pc-4,$pc+8
Dump of assembler code from 0x20040534 to 0x20040540:
   0x20040534 <gc_init+12>:     divu    a4,a4,a2
=> 0x20040538 <gc_init+16>:     addi    sp,sp,-16
   0x2004053c <gc_init+20>:     sw      s0,8(sp)
End of assembler dump.
(gdb) p/x $a2
$7 = 0x41
(gdb) p/x $a4
$8 = 0x7ffe
(gdb)
```

As you can see, it tries to execute $a4 = $a4 / $a2, but rather than raising an exception it's done something strange and gotten 0x7ffe as the result.

Dolu1990, 2019-04-23:
https://github.com/xobs/VexRiscv-verilog/blob/riscv-contest-20190315/src/main/scala/vexriscv/GenCoreDefault.scala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 :) ?

xobs, 2019-04-23:
...I retract the statement.  Sorry for the noise!

Dolu1990, 2019-04-23:
No worries :)

Anyway, i will very soon merge the VexRiscv linux branch into master, it bringed a lot of fixes and compatibility improvements and better regressions test (including running linux on cache-less designs)

https://travis-ci.org/SpinalHDL/VexRiscv/builds/523267998

Just need to release the related SpinalHDL version, and update the readme

xobs, 2019-04-23:
Right now I'm mostly size-constrained.  If I enable illegal instruction traps, it actually doesn't fit.

On a UP5K I have:

- 2-stage VexRiscV with 1024 bytes cache, 4 hardware breakpoints, and SIMPLE branch prediction
- Memory-mapped Quad SPI Flash
- Wishbone bus
- Basic Timer
- USB with five endpoints
- Lattice LED Hard IP (memory-mapped)
- 8 kB ROM
- Debugging via USB packets

The last part is the most exciting. I can debug a VexRiscV entirely without external tools over USB, while it's in the USB port.  This includes debugging the USB stack, as long as it enumerates properly (i.e. the basic descriptors have to be transferred.)

Eventually I'll shrink the USB core, which will let me fit a more complicated VexRiscV.  And hopefully Yosys will be able to infer the DSP blocks to do multiply.

But smaller is always better.

Dolu1990, 2019-04-23:
Hoo nice :D
The cache is for the instruction ? The IBusCachedPlugin ?

Dolu1990, 2019-04-23:
How much LC at the moment :D ?
Which frequancy ?

xobs, 2019-04-23:
Yes, IBusCachedPlugin as 1024 bytes.  DBusCachedPlugin has 0 bytes.

```
Info: Device utilisation:
Info:            ICESTORM_LC:  5266/ 5280    99%
Info:           ICESTORM_RAM:    29/   30    96%
Info:                  SB_IO:    14/   96    14%
Info:                  SB_GB:     8/    8   100%
Info:           ICESTORM_PLL:     1/    1   100%
Info:            SB_WARMBOOT:     1/    1   100%
Info:           ICESTORM_DSP:     0/    8     0%
Info:         ICESTORM_HFOSC:     0/    1     0%
Info:         ICESTORM_LFOSC:     0/    1     0%
Info:                 SB_I2C:     0/    2     0%
Info:                 SB_SPI:     0/    2     0%
Info:                 IO_I3C:     0/    2     0%
Info:            SB_LEDDA_IP:     1/    1   100%
Info:            SB_RGBA_DRV:     1/    1   100%
Info:         ICESTORM_SPRAM:     4/    4   100%
...
Info: Max frequency for clock     'clk48': 200.80 MHz (PASS at 48.00 MHz)
Info: Max frequency for clock 'crg_clk12': 12.58 MHz (PASS at 12.00 MHz)
Info: Max frequency for clock 'crg_clk48': 49.27 MHz (PASS at 48.00 MHz)
```

I think I mentioned that the VexRiscV has a very strange critical path that looks like a 32-bit adder.  That's another thing I need to look into...

Dolu1990, 2019-04-23:
wtf 99 % full, and still getting 12 Mhz
Nice :D

About weird 32 bits path, I do not remember about it, can you send and critical path report ?

Dolu1990, 2019-04-23:
And the related netlist :D

xobs, 2019-04-23:
I'm pleasantly surprised that it's even able to route, let alone meet timing!

Here's the full output:

```
Info: Importing module top
Info: Rule checker, verifying imported design
Info: Checksum: 0x262d3f8b

Info: constrained 'clk48' to bel 'X6/Y0/io1'
Info: constrained 'spiflash_cs_n' to bel 'X24/Y0/io1'
Info: constrained 'spiflash_clk' to bel 'X24/Y0/io0'
Info: constrained 'spiflash_miso' to bel 'X23/Y0/io1'
Info: constrained 'spiflash_mosi' to bel 'X23/Y0/io0'
Info: constrained 'spiflash_wp' to bel 'X22/Y0/io1'
Info: constrained 'spiflash_hold' to bel 'X21/Y0/io1'
Info: constrained 'led_rgb0' to bel 'X4/Y31/io0'
Info: constrained 'led_rgb1' to bel 'X5/Y31/io0'
Info: constrained 'led_rgb2' to bel 'X6/Y31/io0'
Info: constrained 'usb_d_p' to bel 'X13/Y31/io1'
Info: constrained 'usb_d_n' to bel 'X13/Y31/io0'
Info: constrained 'usb_pullup' to bel 'X12/Y31/io1'
Info: constrained 'touch_t1' to bel 'X7/Y0/io0'
Info: constrained 'touch_t2' to bel 'X6/Y0/io0'
Info: constrained 'touch_t3' to bel 'X5/Y0/io0'
Info: constrained 'touch_t4' to bel 'X7/Y0/io1'
Warning: net 'usb_48_clk' does not exist in design, ignoring clock constraint
Warning: net 'usb_48_raw_clk' does not exist in design, ignoring clock constraint
Warning: net 'sys_clk' does not exist in design, ignoring clock constraint
Warning: net 'usb_12_clk' does not exist in design, ignoring clock constraint
Info: constraining clock net 'crg_clk48' to 48.00 MHz
Info: constraining clock net 'clk48' to 48.00 MHz
Warning: net 'crg_clk12_raw' does not exist in design, ignoring clock constraint

Info: Packing constants..
Info: Packing IOs..
Info: spiflash_cs_n feeds SB_IO SB_IO_4, removing $nextpnr_iobuf spiflash_cs_n.
Info: spiflash_clk feeds SB_IO SB_IO_5, removing $nextpnr_iobuf spiflash_clk.
Info: spiflash_miso feeds SB_IO SB_IO_3, removing $nextpnr_iobuf spiflash_miso.
Info: spiflash_mosi feeds SB_IO SB_IO_2, removing $nextpnr_iobuf spiflash_mosi.
Info: spiflash_wp feeds SB_IO SB_IO_6, removing $nextpnr_iobuf spiflash_wp.
Info: spiflash_hold feeds SB_IO SB_IO_7, removing $nextpnr_iobuf spiflash_hold.
Info: led_rgb0 use by SB_RGBA_DRV SB_RGBA_DRV, not creating SB_IO
Info: led_rgb1 use by SB_RGBA_DRV SB_RGBA_DRV, not creating SB_IO
Info: led_rgb2 use by SB_RGBA_DRV SB_RGBA_DRV, not creating SB_IO
Info: usb_d_p feeds SB_IO SB_IO, removing $nextpnr_iobuf usb_d_p.
Info: usb_d_n feeds SB_IO SB_IO_1, removing $nextpnr_iobuf usb_d_n.
Info: touch_t1 feeds SB_IO SB_IO_8, removing $nextpnr_iobuf touch_t1.
Info: touch_t2 feeds SB_IO SB_IO_9, removing $nextpnr_iobuf touch_t2.
Info: touch_t3 feeds SB_IO SB_IO_10, removing $nextpnr_iobuf touch_t3.
Info: touch_t4 feeds SB_IO SB_IO_11, removing $nextpnr_iobuf touch_t4.
Info: Packing LUT-FFs..
Info: Packing non-LUT FFs..
Info: Packing carries..
Info: Packing RAMs..
Info: Placing PLLs..
Info:   constrained PLL 'SB_PLL40_CORE' to X12/Y31/pll_3
Info: Packing special functions..
Info:   constrained SB_LEDDA_IP 'SB_LEDDA_IP' to X0/Y31/ledda_ip_2
Info:   constrained SB_RGBA_DRV 'SB_RGBA_DRV' to X0/Y30/rgba_drv_0
Info: Promoting globals..
Info: promoting picorvspi_reset1 [reset] (fanout 763)
Info: promoting VexRiscv.reset [reset] (fanout 53)
Info: promoting $abc$53614$auto$rtlil.cc:1817:NotGate$53502 [reset] (fanout 32)
Info: promoting $abc$53614$auto$rtlil.cc:1817:NotGate$53490 [reset] (fanout 18)
Info: promoting VexRiscv.IBusCachedPlugin_iBusRsp_cacheRspArbitration_input_ready [cen] (fanout 85)
Info: promoting $abc$53614$auto$dff2dffe.cc:158:make_patterns_logic$40950 [cen] (fanout 81)
Info: Constraining chains...
Info: Checksum: 0x4527e47a

Info: Annotating ports with timing budgets for target frequency 12.00 MHz
Info: Checksum: 0xe80bde5d

Info: Device utilisation:
Info:            ICESTORM_LC:  5266/ 5280    99%
Info:           ICESTORM_RAM:    29/   30    96%
Info:                  SB_IO:    14/   96    14%
Info:                  SB_GB:     8/    8   100%
Info:           ICESTORM_PLL:     1/    1   100%
Info:            SB_WARMBOOT:     1/    1   100%
Info:           ICESTORM_DSP:     0/    8     0%
Info:         ICESTORM_HFOSC:     0/    1     0%
Info:         ICESTORM_LFOSC:     0/    1     0%
Info:                 SB_I2C:     0/    2     0%
Info:                 SB_SPI:     0/    2     0%
Info:                 IO_I3C:     0/    2     0%
Info:            SB_LEDDA_IP:     1/    1   100%
Info:            SB_RGBA_DRV:     1/    1   100%
Info:         ICESTORM_SPRAM:     4/    4   100%

Info: Placed 18 cells based on constraints.
Info: Creating initial analytic placement for 4945 cells, random placement wirelen = 133370.
Info:     at initial placer iter 0, wirelen = 2401
Info:     at initial placer iter 1, wirelen = 2276
Info:     at initial placer iter 2, wirelen = 2401
Info:     at initial placer iter 3, wirelen = 2270
Info: Running main analytical placer.
Info:     at iteration #1, type ALL: wirelen solved = 2390, spread = 40378, legal = 65609; time = 1.89s
Info:     at iteration #2, type ALL: wirelen solved = 3966, spread = 33384, legal = 67077; time = 4.06s
Info:     at iteration #3, type ALL: wirelen solved = 5725, spread = 32622, legal = 60447; time = 2.23s
Info:     at iteration #4, type ALL: wirelen solved = 7580, spread = 32134, legal = 63270; time = 2.40s
Info:     at iteration #5, type ALL: wirelen solved = 8958, spread = 30878, legal = 57350; time = 1.81s
Info:     at iteration #6, type ALL: wirelen solved = 10182, spread = 28726, legal = 54201; time = 1.31s
Info:     at iteration #7, type ALL: wirelen solved = 11187, spread = 27001, legal = 53813; time = 2.00s
Info:     at iteration #8, type ALL: wirelen solved = 13235, spread = 26546, legal = 54741; time = 1.96s
Info:     at iteration #9, type ALL: wirelen solved = 13416, spread = 26820, legal = 56891; time = 1.86s
Info:     at iteration #10, type ALL: wirelen solved = 15466, spread = 26622, legal = 55555; time = 2.16s
Info:     at iteration #11, type ALL: wirelen solved = 15236, spread = 26706, legal = 54128; time = 1.39s
Info:     at iteration #12, type ALL: wirelen solved = 14986, spread = 27217, legal = 58582; time = 1.97s
Info: HeAP Placer Time: 27.72s
Info:   of which solving equations: 3.76s
Info:   of which spreading cells: 0.56s
Info:   of which strict legalisation: 21.54s

Info: Running simulated annealing placer for refinement.
Info:   at iteration #1: temp = 0.000000, timing cost = 407, wirelen = 53813
Info:   at iteration #5: temp = 0.000000, timing cost = 605, wirelen = 42556
Info:   at iteration #10: temp = 0.000000, timing cost = 528, wirelen = 39915
Info:   at iteration #15: temp = 0.000000, timing cost = 493, wirelen = 38514
Info:   at iteration #20: temp = 0.000000, timing cost = 479, wirelen = 37556
Info:   at iteration #25: temp = 0.000000, timing cost = 460, wirelen = 37191
Info:   at iteration #30: temp = 0.000000, timing cost = 466, wirelen = 37070
Info:   at iteration #34: temp = 0.000000, timing cost = 466, wirelen = 37037
Info: SA placement time 28.20s

Info: Max frequency for clock     'clk48': 228.05 MHz (PASS at 48.00 MHz)
Info: Max frequency for clock 'crg_clk12': 13.15 MHz (PASS at 12.00 MHz)
Info: Max frequency for clock 'crg_clk48': 50.90 MHz (PASS at 48.00 MHz)

Info: Max delay <async>           -> posedge crg_clk12: 16.60 ns
Info: Max delay <async>           -> posedge crg_clk48: 13.04 ns
Info: Max delay posedge crg_clk12 -> <async>          : 18.27 ns
Info: Max delay posedge crg_clk12 -> posedge crg_clk48: 23.41 ns
Info: Max delay negedge crg_clk12 -> <async>          : 10.20 ns
Info: Max delay posedge crg_clk48 -> <async>          : 5.03 ns
Info: Max delay posedge crg_clk48 -> posedge crg_clk12: 28.40 ns

Info: Slack histogram:
Info:  legend: * represents 27 endpoint(s)
Info:          + represents [1,27) endpoint(s)
Info: [ -2581,   1558) |+
Info: [  1558,   5697) |*+
Info: [  5697,   9836) |*+
Info: [  9836,  13975) |**+
Info: [ 13975,  18114) |***+
Info: [ 18114,  22253) |*****+
Info: [ 22253,  26392) |*+
Info: [ 26392,  30531) |****+
Info: [ 30531,  34670) |****+
Info: [ 34670,  38809) |*****+
Info: [ 38809,  42948) |****+
Info: [ 42948,  47087) |**+
Info: [ 47087,  51226) |********+
Info: [ 51226,  55365) |************+
Info: [ 55365,  59504) |*************************************+
Info: [ 59504,  63643) |**********************************+
Info: [ 63643,  67782) |***********************+
Info: [ 67782,  71921) |*********************+
Info: [ 71921,  76060) |*********************+
Info: [ 76060,  80199) |************************************************************
Info: Checksum: 0x46db4797

Info: Routing..
Info: Setting up routing queue.
Info: Routing 16467 arcs.
Info:            |   (re-)routed arcs  |   delta    | remaining
Info:    IterCnt |  w/ripup   wo/ripup |  w/r  wo/r |      arcs
Info:       1000 |       37        962 |   37   962 |     15508
Info:       2000 |       91       1908 |   54   946 |     14570
Info:       3000 |      231       2768 |  140   860 |     13743
Info:       4000 |      398       3601 |  167   833 |     12974
Info:       5000 |      567       4432 |  169   831 |     12206
Info:       6000 |      774       5225 |  207   793 |     11513
Info:       7000 |      997       6002 |  223   777 |     10838
Info:       8000 |     1196       6803 |  199   801 |     10142
Info:       9000 |     1413       7586 |  217   783 |      9438
Info:      10000 |     1746       8253 |  333   667 |      8999
Info:      11000 |     2031       8968 |  285   715 |      8439
Info:      12000 |     2319       9680 |  288   712 |      7884
Info:      13000 |     2734      10265 |  415   585 |      7520
Info:      14000 |     3080      10919 |  346   654 |      7050
Info:      15000 |     3585      11414 |  505   495 |      6821
Info:      16000 |     4049      11950 |  464   536 |      6544
Info:      17000 |     4498      12501 |  449   551 |      6247
Info:      18000 |     4901      13098 |  403   597 |      5862
Info:      19000 |     5350      13649 |  449   551 |      5555
Info:      20000 |     5934      14065 |  584   416 |      5419
Info:      21000 |     6496      14503 |  562   438 |      5317
Info:      22000 |     7023      14976 |  527   473 |      5136
Info:      23000 |     7567      15432 |  544   456 |      5085
Info:      24000 |     8087      15912 |  520   480 |      4950
Info:      25000 |     8641      16358 |  554   446 |      4874
Info:      26000 |     9149      16850 |  508   492 |      4719
Info:      27000 |     9679      17320 |  530   470 |      4512
Info:      28000 |    10193      17806 |  514   486 |      4371
Info:      29000 |    10720      18279 |  527   473 |      4168
Info:      30000 |    11183      18816 |  463   537 |      4067
Info:      31000 |    11703      19296 |  520   480 |      3920
Info:      32000 |    12300      19699 |  597   403 |      3869
Info:      33000 |    12851      20148 |  551   449 |      3841
Info:      34000 |    13436      20563 |  585   415 |      3783
Info:      35000 |    14036      20963 |  600   400 |      3705
Info:      36000 |    14577      21422 |  541   459 |      3618
Info:      37000 |    15139      21860 |  562   438 |      3505
Info:      38000 |    15697      22302 |  558   442 |      3493
Info:      39000 |    16232      22767 |  535   465 |      3408
Info:      40000 |    16777      23222 |  545   455 |      3331
Info:      41000 |    17350      23649 |  573   427 |      3155
Info:      42000 |    17948      24051 |  598   402 |      3105
Info:      43000 |    18529      24470 |  581   419 |      3070
Info:      44000 |    19089      24910 |  560   440 |      2904
Info:      45000 |    19661      25338 |  572   428 |      2860
Info:      46000 |    20276      25723 |  615   385 |      2836
Info:      47000 |    20913      26086 |  637   363 |      2791
Info:      48000 |    21524      26475 |  611   389 |      2768
Info:      49000 |    22115      26884 |  591   409 |      2755
Info:      50000 |    22690      27309 |  575   425 |      2737
Info:      51000 |    23283      27716 |  593   407 |      2702
Info:      52000 |    23917      28082 |  634   366 |      2683
Info:      53000 |    24546      28453 |  629   371 |      2667
Info:      54000 |    25117      28882 |  571   429 |      2651
Info:      55000 |    25744      29255 |  627   373 |      2625
Info:      56000 |    26389      29610 |  645   355 |      2621
Info:      57000 |    27010      29989 |  621   379 |      2579
Info:      58000 |    27604      30395 |  594   406 |      2536
Info:      59000 |    28216      30783 |  612   388 |      2512
Info:      60000 |    28856      31143 |  640   360 |      2477
Info:      61000 |    29458      31541 |  602   398 |      2443
Info:      62000 |    30070      31929 |  612   388 |      2442
Info:      63000 |    30688      32311 |  618   382 |      2418
Info:      64000 |    31239      32760 |  551   449 |      2410
Info:      65000 |    31840      33159 |  601   399 |      2412
Info:      66000 |    32472      33527 |  632   368 |      2410
Info:      67000 |    33109      33890 |  637   363 |      2377
Info:      68000 |    33672      34327 |  563   437 |      2375
Info:      69000 |    34324      34675 |  652   348 |      2398
Info:      70000 |    34945      35054 |  621   379 |      2387
Info:      71000 |    35568      35431 |  623   377 |      2358
Info:      72000 |    36190      35809 |  622   378 |      2342
Info:      73000 |    36816      36183 |  626   374 |      2309
Info:      74000 |    37464      36535 |  648   352 |      2308
Info:      75000 |    38043      36956 |  579   421 |      2280
Info:      76000 |    38653      37346 |  610   390 |      2272
Info:      77000 |    39300      37699 |  647   353 |      2282
Info:      78000 |    39893      38106 |  593   407 |      2263
Info:      79000 |    40479      38520 |  586   414 |      2228
Info:      80000 |    41100      38899 |  621   379 |      2204
Info:      81000 |    41731      39268 |  631   369 |      2181
Info:      82000 |    42375      39624 |  644   356 |      2198
Info:      83000 |    42958      40041 |  583   417 |      2172
Info:      84000 |    43601      40398 |  643   357 |      2157
Info:      85000 |    44264      40735 |  663   337 |      2147
Info:      86000 |    44856      41143 |  592   408 |      2128
Info:      87000 |    45503      41496 |  647   353 |      2122
Info:      88000 |    46137      41862 |  634   366 |      2101
Info:      89000 |    46758      42241 |  621   379 |      2106
Info:      90000 |    47421      42578 |  663   337 |      2060
Info:      91000 |    48050      42949 |  629   371 |      2033
Info:      92000 |    48643      43356 |  593   407 |      2002
Info:      93000 |    49304      43695 |  661   339 |      2001
Info:      94000 |    49928      44071 |  624   376 |      1977
Info:      95000 |    50601      44398 |  673   327 |      1963
Info:      96000 |    51208      44791 |  607   393 |      1963
Info:      97000 |    51843      45156 |  635   365 |      1931
Info:      98000 |    52452      45547 |  609   391 |      1917
Info:      99000 |    53063      45936 |  611   389 |      1866
Info:     100000 |    53675      46324 |  612   388 |      1856
Info:     101000 |    54316      46683 |  641   359 |      1860
Info:     102000 |    54932      47067 |  616   384 |      1848
Info:     103000 |    55587      47412 |  655   345 |      1855
Info:     104000 |    56261      47738 |  674   326 |      1822
Info:     105000 |    56886      48113 |  625   375 |      1809
Info:     106000 |    57542      48457 |  656   344 |      1788
Info:     107000 |    58164      48835 |  622   378 |      1792
Info:     108000 |    58802      49197 |  638   362 |      1785
Info:     109000 |    59464      49535 |  662   338 |      1773
Info:     110000 |    60135      49864 |  671   329 |      1766
Info:     111000 |    60740      50259 |  605   395 |      1786
Info:     112000 |    61394      50605 |  654   346 |      1744
Info:     113000 |    62044      50955 |  650   350 |      1728
Info:     114000 |    62653      51346 |  609   391 |      1758
Info:     115000 |    63280      51719 |  627   373 |      1704
Info:     116000 |    63935      52064 |  655   345 |      1677
Info:     117000 |    64566      52433 |  631   369 |      1709
Info:     118000 |    65244      52755 |  678   322 |      1693
Info:     119000 |    65833      53166 |  589   411 |      1680
Info:     120000 |    66428      53571 |  595   405 |      1653
Info:     121000 |    67036      53963 |  608   392 |      1641
Info:     122000 |    67703      54296 |  667   333 |      1628
Info:     123000 |    68325      54674 |  622   378 |      1641
Info:     124000 |    68973      55026 |  648   352 |      1626
Info:     125000 |    69634      55365 |  661   339 |      1629
Info:     126000 |    70279      55720 |  645   355 |      1639
Info:     127000 |    70904      56095 |  625   375 |      1648
Info:     128000 |    71569      56430 |  665   335 |      1656
Info:     129000 |    72198      56801 |  629   371 |      1625
Info:     130000 |    72864      57135 |  666   334 |      1596
Info:     131000 |    73499      57500 |  635   365 |      1558
Info:     132000 |    74114      57885 |  615   385 |      1559
Info:     133000 |    74762      58237 |  648   352 |      1513
Info:     134000 |    75401      58598 |  639   361 |      1504
Info:     135000 |    76065      58934 |  664   336 |      1485
Info:     136000 |    76750      59249 |  685   315 |      1480
Info:     137000 |    77432      59567 |  682   318 |      1468
Info:     138000 |    78069      59930 |  637   363 |      1461
Info:     139000 |    78709      60290 |  640   360 |      1473
Info:     140000 |    79372      60627 |  663   337 |      1455
Info:     141000 |    80102      60897 |  730   270 |      1420
Info:     142000 |    80696      61303 |  594   406 |      1230
Info:     143000 |    81291      61708 |  595   405 |       984
Info:     144000 |    81969      62030 |  678   322 |       986
Info:     145000 |    82600      62399 |  631   369 |       844
Info:     146000 |    83086      62913 |  486   514 |       686
Info:     147000 |    83598      63401 |  512   488 |       500
Info:     148000 |    84195      63804 |  597   403 |       382
Info:     149000 |    84818      64181 |  623   377 |       327
Info:     149905 |    85212      64693 |  394   512 |         0
Info: Routing complete.
Info: Route time 328.80s
Info: Checksum: 0x234c366f

Info: Critical path report for clock 'clk48' (posedge -> posedge):
Info: curr total
Info:  1.4  1.4  Source $abc$53614$auto$blifparse.cc:492:parse_blif$56810_LC.O
Info:  2.4  3.8    Net crg_clk12_counter[1] budget 18.261999 ns (12,2) -> (12,2)
Info:                Sink $abc$53614$auto$blifparse.cc:492:parse_blif$56810_LC.I1
Info:  1.2  5.0  Setup $abc$53614$auto$blifparse.cc:492:parse_blif$56810_LC.I1
Info: 2.6 ns logic, 2.4 ns routing

Info: Critical path report for clock 'crg_clk12' (posedge -> posedge):
Info: curr total
Info:  1.4  1.4  Source $auto$simplemap.cc:420:simplemap_dff$17320_DFFLC.O
Info:  4.0  5.4    Net VexRiscv._zz_221_[4] budget -0.305000 ns (3,21) -> (12,19)
Info:                Sink $abc$53614$auto$blifparse.cc:492:parse_blif$56886_LC.I0
Info:  1.3  6.7  Source $abc$53614$auto$blifparse.cc:492:parse_blif$56886_LC.O
Info:  1.8  8.5    Net $abc$53614$n7789 budget -0.044000 ns (12,19) -> (12,18)
Info:                Sink $abc$53614$auto$blifparse.cc:492:parse_blif$56887_LC.I3
Info:  0.9  9.3  Source $abc$53614$auto$blifparse.cc:492:parse_blif$56887_LC.O
Info:  4.9 14.2    Net $abc$53614$techmap\VexRiscv.$not$D:\Code\Fomu\foboot\hw\2-stage-1024-cache-debug.v:1190$1529_Y[4] budget 1.933000 ns (12,18) -> (17,5)
Info:                Sink $abc$53614$auto$blifparse.cc:492:parse_blif$56245_LC.I0
Info:  1.3 15.5  Source $abc$53614$auto$blifparse.cc:492:parse_blif$56245_LC.O
Info:  3.0 18.5    Net VexRiscv._zz_226_[4] budget 1.209000 ns (17,5) -> (15,5)
Info:                Sink $auto$maccmap.cc:240:synth$15411.slice[4].adder_LC.I1
Info:  0.7 19.2  Source $auto$maccmap.cc:240:synth$15411.slice[4].adder_LC.COUT
Info:  0.0 19.2    Net $auto$maccmap.cc:240:synth$15411.C[5] budget 0.000000 ns (15,5) -> (15,5)
Info:                Sink $auto$maccmap.cc:240:synth$15411.slice[5].adder_LC.CIN
Info:  0.3 19.5  Source $auto$maccmap.cc:240:synth$15411.slice[5].adder_LC.COUT
Info:  0.0 19.5    Net $auto$maccmap.cc:240:synth$15411.C[6] budget 0.000000 ns (15,5) -> (15,5)
Info:                Sink $auto$maccmap.cc:240:synth$15411.slice[6].adder_LC.CIN
Info:  0.3 19.8  Source $auto$maccmap.cc:240:synth$15411.slice[6].adder_LC.COUT
Info:  0.6 20.3    Net $auto$maccmap.cc:240:synth$15411.C[7] budget 0.560000 ns (15,5) -> (15,6)
Info:                Sink $auto$maccmap.cc:240:synth$15411.slice[7].adder_LC.CIN
Info:  0.3 20.6  Source $auto$maccmap.cc:240:synth$15411.slice[7].adder_LC.COUT
Info:  0.0 20.6    Net $auto$maccmap.cc:240:synth$15411.C[8] budget 0.000000 ns (15,6) -> (15,6)
Info:                Sink $auto$maccmap.cc:240:synth$15411.slice[8].adder_LC.CIN
Info:  0.3 20.9  Source $auto$maccmap.cc:240:synth$15411.slice[8].adder_LC.COUT
Info:  0.0 20.9    Net $auto$maccmap.cc:240:synth$15411.C[9] budget 0.000000 ns (15,6) -> (15,6)
Info:                Sink $auto$maccmap.cc:240:synth$15411.slice[9].adder_LC.CIN
Info:  0.3 21.1  Source $auto$maccmap.cc:240:synth$15411.slice[9].adder_LC.COUT
Info:  0.0 21.1    Net $auto$maccmap.cc:240:synth$15411.C[10] budget 0.000000 ns (15,6) -> (15,6)
Info:                Sink $auto$maccmap.cc:240:synth$15411.slice[10].adder_LC.CIN
Info:  0.3 21.4  Source $auto$maccmap.cc:240:synth$15411.slice[10].adder_LC.COUT
Info:  0.0 21.4    Net $auto$maccmap.cc:240:synth$15411.C[11] budget 0.000000 ns (15,6) -> (15,6)
Info:                Sink $auto$maccmap.cc:240:synth$15411.slice[11].adder_LC.CIN
Info:  0.3 21.7  Source $auto$maccmap.cc:240:synth$15411.slice[11].adder_LC.COUT
Info:  0.0 21.7    Net $auto$maccmap.cc:240:synth$15411.C[12] budget 0.000000 ns (15,6) -> (15,6)
Info:                Sink $auto$maccmap.cc:240:synth$15411.slice[12].adder_LC.CIN
Info:  0.3 22.0  Source $auto$maccmap.cc:240:synth$15411.slice[12].adder_LC.COUT
Info:  0.0 22.0    Net $auto$maccmap.cc:240:synth$15411.C[13] budget 0.000000 ns (15,6) -> (15,6)
Info:                Sink $auto$maccmap.cc:240:synth$15411.slice[13].adder_LC.CIN
Info:  0.3 22.3  Source $auto$maccmap.cc:240:synth$15411.slice[13].adder_LC.COUT
Info:  0.0 22.3    Net $auto$maccmap.cc:240:synth$15411.C[14] budget 0.000000 ns (15,6) -> (15,6)
Info:                Sink $auto$maccmap.cc:240:synth$15411.slice[14].adder_LC.CIN
Info:  0.3 22.5  Source $auto$maccmap.cc:240:synth$15411.slice[14].adder_LC.COUT
Info:  0.6 23.1    Net $auto$maccmap.cc:240:synth$15411.C[15] budget 0.560000 ns (15,6) -> (15,7)
Info:                Sink $auto$maccmap.cc:240:synth$15411.slice[15].adder_LC.CIN
Info:  0.3 23.4  Source $auto$maccmap.cc:240:synth$15411.slice[15].adder_LC.COUT
Info:  0.0 23.4    Net $auto$maccmap.cc:240:synth$15411.C[16] budget 0.000000 ns (15,7) -> (15,7)
Info:                Sink $auto$maccmap.cc:240:synth$15411.slice[16].adder_LC.CIN
Info:  0.3 23.6  Source $auto$maccmap.cc:240:synth$15411.slice[16].adder_LC.COUT
Info:  0.0 23.6    Net $auto$maccmap.cc:240:synth$15411.C[17] budget 0.000000 ns (15,7) -> (15,7)
Info:                Sink $auto$maccmap.cc:240:synth$15411.slice[17].adder_LC.CIN
Info:  0.3 23.9  Source $auto$maccmap.cc:240:synth$15411.slice[17].adder_LC.COUT
Info:  0.0 23.9    Net $auto$maccmap.cc:240:synth$15411.C[18] budget 0.000000 ns (15,7) -> (15,7)
Info:                Sink $auto$maccmap.cc:240:synth$15411.slice[18].adder_LC.CIN
Info:  0.3 24.2  Source $auto$maccmap.cc:240:synth$15411.slice[18].adder_LC.COUT
Info:  0.0 24.2    Net $auto$maccmap.cc:240:synth$15411.C[19] budget 0.000000 ns (15,7) -> (15,7)
Info:                Sink $auto$maccmap.cc:240:synth$15411.slice[19].adder_LC.CIN
Info:  0.3 24.5  Source $auto$maccmap.cc:240:synth$15411.slice[19].adder_LC.COUT
Info:  0.0 24.5    Net $auto$maccmap.cc:240:synth$15411.C[20] budget 0.000000 ns (15,7) -> (15,7)
Info:                Sink $auto$maccmap.cc:240:synth$15411.slice[20].adder_LC.CIN
Info:  0.3 24.8  Source $auto$maccmap.cc:240:synth$15411.slice[20].adder_LC.COUT
Info:  0.0 24.8    Net $auto$maccmap.cc:240:synth$15411.C[21] budget 0.000000 ns (15,7) -> (15,7)
Info:                Sink $auto$maccmap.cc:240:synth$15411.slice[21].adder_LC.CIN
Info:  0.3 25.0  Source $auto$maccmap.cc:240:synth$15411.slice[21].adder_LC.COUT
Info:  0.0 25.0    Net $auto$maccmap.cc:240:synth$15411.C[22] budget 0.000000 ns (15,7) -> (15,7)
Info:                Sink $auto$maccmap.cc:240:synth$15411.slice[22].adder_LC.CIN
Info:  0.3 25.3  Source $auto$maccmap.cc:240:synth$15411.slice[22].adder_LC.COUT
Info:  0.6
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

Thread 72 (2019-05-03):

JTAG input clock has not buffer

FlyingxDutch, 2019-05-03:

FlyingxDutch, 2019-05-03:
Hello,
I encountered dificulties related to input signal of Briey SOC named:  io_jtag_tck. This signal has not buffer and cause error during implemenattion on FPGA board (with Xilinx Spartan6 device). For syntessis I am using Xilinx ISE Webpacvk 14.7.

Dolu1990, 2019-05-03:
Hoo, yes, Xilinx IDE is picky about getting a clock in the FPGA if the pin isn't a global buffer. But in the given case, that's fine, you can ask him to ignore it, as the JTAG is realy slow, and jtag IO have realy large setup times :)

FlyingxDutch, 2019-05-03:
Hi,
I just added buffor primitive in project, so it solved the issue.
Best Regards

Closed 2019-05-03.

Thread 73 (2019-05-03):

Issues with built-in DDR memory controller Briey SoC

FlyingxDutch, 2019-05-03:
Hello,

for some time I am trying to run "Briey SoC" (generated from SpinalHDL according to given instruction) on Spartan6 based FPGA board "Mimas V.2" from "Numat Lab". Here is link to this board description (on Numato website):
[https://numato.com/product/mimas-v2-spartan-6-fpga-development-board-with-ddr-sdram](url)

In order to launch Briey.v project on real FPGA board (Mimas V.2) I altered the original design. The major changes are:
1) Added (PLL) instance CLKGEN (Xilinx IP core) for generating clocks: AXI bus clock, VGA clock, DDR memory clock

2) Added input buffer (IBUFG) for input JTAG clock (signal: io_jtag_tck)

3) Generation of differential clock (two lines) for DRR memory from single clock (100 MHz PLL). Added primitive OBUFDS.

4) Two directional buffer (instance DDRDataBuffer - "SelectI/O Wizard IP core") added to Briey bus and DDR memory data bus (16 bit wide)

5) In "User constraints file" (BrieySOC.ucf) maped properly most of ports of top module (BrieySOC). There is lack of few important signals - I will write about this later.

The main issue I had encountered is related to internal Briey DDR memory controller.
My FPGA board Mimas v.2 has on-board SDRAM (DDR1 RAM memory) chip: MT46H32M16LF.
This chip requires diferential clock (two lines) and also two-directional 16-bit wide data bus.

In the Briey design thera are two one-directional 16-bit buses (one for write and second for read). To solve that issue I added Xilinx IPcore named "Select I/O Wizard"

I reconstructed the original design Briey.v with new top module named "BrieySOC", here is it's code (Verilog):
`/* Top module: Briey SOC */

module BrieySOC(
      input   io_asyncReset,
      input   Clk100Mhz,
      input   io_jtag_tms,
      input   io_jtag_tdi,
      output  io_jtag_tdo,
      input   io_jtag_tck,
      output [12:0] io_sdram_ADDR,
      output [1:0] io_sdram_BA,
      //input  [15:0] io_sdram_DQ_read,
      //output [15:0] io_sdram_DQ_write,
		inout  [15:0] io_sdram_DATA,
      output  io_sdram_DQ_writeEnable,
      output [1:0] io_sdram_DQM,
      output  io_sdram_CASn,
      output  io_sdram_CKE,
      output  io_sdram_CSn,
      output  io_sdram_RASn,
      output  io_sdram_WEn,
		output  io_sdram_clk,
		output  io_sdram_clk_n,
      input  [3:0] io_gpioA_read,
      output [3:0] io_gpioA_write,
      output [3:0] io_gpioA_writeEnable,
      output  io_uart_txd,
      input   io_uart_rxd,
      output  io_vga_vSync,
      output  io_vga_hSync,
      output  io_vga_colorEn,
      output [4:0] io_vga_color_r,
      output [5:0] io_vga_color_g,
      output [4:0] io_vga_color_b,
      input   io_timerExternal_clear,
      input   io_timerExternal_tick,
      input   io_coreInterrupt
    );
//----------------------------------------------------

//-- Connecting wires
wire clkAXIOut;
wire clkLOCKED;
wire clkVGAOut;
wire clkBuf100MHz;
wire clkDDR100MHz;
wire clkJTAGBuf;
wire CLK_TO_PINS;
wire TRISTATE_OUTPUT;
wire CLK_RESET;
wire [15:0] io_sdram_DQ_read;
wire [15:0] io_sdram_DQ_write;

  CLKWizard CLKGEN
   (// Clock in ports
    .CLK_IN1(Clk100Mhz),
    // Clock out ports
    .CLK_OUT1(clkAXIOut),    //50 MHz AXI clock
    .CLK_OUT2(clkVGAOut),    //25.175 MHz VGA clock
    .CLK_OUT3(clkBuf100MHz), //100 MHz DDR memory clock
    // Status and control signals
    .RESET(io_asyncReset),
    .LOCKED(clkLOCKED));

	//Input buffer for JTAG in clock
	IBUFG IBUFG_01
   (
	  .O(clkJTAGBuf),
     .I(io_jtag_tck)
   );

  //Output buffer for DDR diff clock (out)
  OBUFDS #(
  .IOSTANDARD("DIFF_MOBILE_DDR")
  ) OBUFDS_01 (
   .O(io_sdram_clk),
   .OB(io_sdram_clk_n),
   .I(clkBuf100MHz)
  );

//---- DDR memory bufer bi-directional ---------

  BiDirBuffer DDRDataBuffer
   (
    .DATA_TO_AND_FROM_PINS(io_sdram_DATA), //Bi-Directional pins
    .DATA_IN_TO_DEVICE(io_sdram_DQ_read), //Output pins
  // From the device out to the system
    .DATA_OUT_FROM_DEVICE(io_sdram_DQ_write), //Input pins
    .CLK_TO_PINS(CLK_TO_PINS), //Output pins

    .TRISTATE_OUTPUT(TRISTATE_OUTPUT), //Input pin
    .CLK_IN(clkBuf100MHz),        // Fast clock input from PLL/MMCM
    .LOCKED_IN(clkLOCKED), //Input pin
    .LOCKED_OUT(LOCKED_OUT), //Output pin
    .CLK_RESET(CLK_RESET), //clocking logic reset
    .IO_RESET(io_asyncReset)  //system reset
   );

//---- CPU instance ---------
   Briey SoC(
	   .io_asyncReset(io_asyncReset),
	   .io_axiClk(clkAXIOut),
	   .io_vgaClk(clkVGAOut),
      .io_jtag_tms(io_jtag_tms),
      .io_jtag_tdi(io_jtag_tdi),
      .io_jtag_tdo(io_jtag_tdo),
      .io_jtag_tck(clkJTAGBuf),
      .io_sdram_ADDR(io_sdram_ADDR),
      .io_sdram_BA(io_sdram_BA),
      .io_sdram_DQ_read(io_sdram_DQ_read),
      .io_sdram_DQ_write(io_sdram_DQ_write),
      .io_sdram_DQ_writeEnable(io_sdram_DQ_writeEnable),
      .io_sdram_DQM(io_sdram_DQM),
      .io_sdram_CASn(io_sdram_CASn),
      .io_sdram_CKE(io_sdram_CKE),
      .io_sdram_CSn(io_sdram_CSn),
      .io_sdram_RASn(io_sdram_RASn),
      .io_sdram_WEn(io_sdram_WEn),
      .io_gpioA_read(io_gpioA_read),
      .io_gpioA_write(io_gpioA_write),
      .io_gpioA_writeEnable(io_gpioA_writeEnable),
      .io_uart_txd(io_uart_txd),
      .io_uart_rxd(io_uart_rxd),
      .io_vga_vSync(io_vga_vSync),
      .io_vga_hSync(io_vga_hSync),
      .io_vga_colorEn(io_vga_colorEn),
      .io_vga_color_r(io_vga_color_r),
      .io_vga_color_g(io_vga_color_g),
      .io_vga_color_b(io_vga_color_b),
      .io_timerExternal_clear(io_timerExternal_clear),
      .io_timerExternal_tick(io_timerExternal_tick),
      .io_coreInterrupt(io_coreInterrupt)
   );

endmodule
`
I mapped most of Briey ports in user constraint file, here is it's current code:
`#---------------------------------------------------
NET "Clk100Mhz"                  LOC = V10     | IOSTANDARD = LVCMOS33 | PERIOD = 100MHz ;

NET "io_asyncReset"              LOC = M18     | IOSTANDARD = LVCMOS33 | DRIVE = 8 | SLEW = FAST | PULLUP; #SW1

###################################################################################################################################################
#                                                   HEADER P6                                                                                     #
###################################################################################################################################################
NET "io_jtag_tms"                LOC = U7      | IOSTANDARD = LVCMOS33 | DRIVE = 8 | SLEW = FAST ; #Pin 1 Header P6
NET "io_jtag_tdi"                LOC = V7      | IOSTANDARD = LVCMOS33 | DRIVE = 8 | SLEW = FAST ; #Pin 2
NET "io_jtag_tdo"                LOC = T4      | IOSTANDARD = LVCMOS33 | DRIVE = 8 | SLEW = FAST ; #Pin 3
NET "io_jtag_tck"                LOC = V4      | IOSTANDARD = LVCMOS33 | DRIVE = 8 | SLEW = FAST ; #Pin 4 - issue

#-------------------------- LPDDR RAM START--------------------------------------------------------------------

#NET  "calib_done"                LOC = P15     | IOSTANDARD = LVCMOS33;
#NET  "error"                     LOC = P16     | IOSTANDARD = LVCMOS33;
#NET  "c3_sys_rst_n"              LOC = L15     | IOSTANDARD = LVCMOS33 | PULLDOWN;    # Pin 7 of Header P9

NET  "io_sdram_ADDR[0]"          LOC = J7      | IOSTANDARD = MOBILE_DDR;
NET  "io_sdram_ADDR[10]"         LOC = F4      | IOSTANDARD = MOBILE_DDR;
NET  "io_sdram_ADDR[11]"         LOC = D3      | IOSTANDARD = MOBILE_DDR;
NET  "io_sdram_ADDR[12]"         LOC = G6      | IOSTANDARD = MOBILE_DDR;
NET  "io_sdram_ADDR[1]"          LOC = J6      | IOSTANDARD = MOBILE_DDR;
NET  "io_sdram_ADDR[2]"          LOC = H5      | IOSTANDARD = MOBILE_DDR;
NET  "io_sdram_ADDR[3]"          LOC = L7      | IOSTANDARD = MOBILE_DDR;
NET  "io_sdram_ADDR[4]"          LOC = F3      | IOSTANDARD = MOBILE_DDR;
NET  "io_sdram_ADDR[5]"          LOC = H4      | IOSTANDARD = MOBILE_DDR;
NET  "io_sdram_ADDR[6]"          LOC = H3      | IOSTANDARD = MOBILE_DDR;
NET  "io_sdram_ADDR[7]"          LOC = H6      | IOSTANDARD = MOBILE_DDR;
NET  "io_sdram_ADDR[8]"          LOC = D2      | IOSTANDARD = MOBILE_DDR;
NET  "io_sdram_ADDR[9]"          LOC = D1      | IOSTANDARD = MOBILE_DDR;

NET  "io_sdram_BA[0]"            LOC = F2      | IOSTANDARD = MOBILE_DDR;
NET  "io_sdram_BA[1]"            LOC = F1      | IOSTANDARD = MOBILE_DDR;

NET  "io_sdram_clk"              LOC = G3      | IOSTANDARD = DIFF_MOBILE_DDR;
NET  "io_sdram_clk_n"            LOC = G1      | IOSTANDARD = DIFF_MOBILE_DDR;

NET  "io_sdram_DATA[0]"           LOC = L2      | IOSTANDARD = MOBILE_DDR;
NET  "io_sdram_DATA[10]"          LOC = N2      | IOSTANDARD = MOBILE_DDR;
NET  "io_sdram_DATA[11]"          LOC = N1      | IOSTANDARD = MOBILE_DDR;
NET  "io_sdram_DATA[12]"          LOC = T2      | IOSTANDARD = MOBILE_DDR;
NET  "io_sdram_DATA[13]"          LOC = T1      | IOSTANDARD = MOBILE_DDR;
NET  "io_sdram_DATA[14]"          LOC = U2      | IOSTANDARD = MOBILE_DDR;
NET  "io_sdram_DATA[15]"          LOC = U1      | IOSTANDARD = MOBILE_DDR;
NET  "io_sdram_DATA[1]"           LOC = L1      | IOSTANDARD = MOBILE_DDR;
NET  "io_sdram_DATA[2]"           LOC = K2      | IOSTANDARD = MOBILE_DDR;
NET  "io_sdram_DATA[3]"           LOC = K1      | IOSTANDARD = MOBILE_DDR;
NET  "io_sdram_DATA[4]"           LOC = H2      | IOSTANDARD = MOBILE_DDR;
NET  "io_sdram_DATA[5]"           LOC = H1      | IOSTANDARD = MOBILE_DDR;
NET  "io_sdram_DATA[6]"           LOC = J3      | IOSTANDARD = MOBILE_DDR;
NET  "io_sdram_DATA[7]"           LOC = J1      | IOSTANDARD = MOBILE_DDR;
NET  "io_sdram_DATA[8]"           LOC = M3      | IOSTANDARD = MOBILE_DDR;
NET  "io_sdram_DATA[9]"           LOC = M1      | IOSTANDARD = MOBILE_DDR;

NET  "io_sdram_CASn"              LOC = K5      | IOSTANDARD = MOBILE_DDR;
NET  "io_sdram_CKE"               LOC = H7      | IOSTANDARD = MOBILE_DDR;
NET  "io_sdram_RASn"              LOC = L5      | IOSTANDARD = MOBILE_DDR;
NET  "io_sdram_WEn"               LOC = E3      | IOSTANDARD = MOBILE_DDR;

#-------------------------- LPDDR RAM END  --------------------------------------------------------------------

##################################################################################################################################################
#                                                   HEADER P7                                                                                     #
###################################################################################################################################################
NET "io_gpioA_read[0]"           LOC = U8      | IOSTANDARD = LVCMOS33 | DRIVE = 8 | SLEW = FAST ; #Pin 1
NET "io_gpioA_read[1]"           LOC = V8      | IOSTANDARD = LVCMOS33 | DRIVE = 8 | SLEW = FAST ; #Pin 2
NET "io_gpioA_read[2]"           LOC = R8      | IOSTANDARD = LVCMOS33 | DRIVE = 8 | SLEW = FAST ; #Pin 3
NET "io_gpioA_read[3]"           LOC = T8      | IOSTANDARD = LVCMOS33 | DRIVE = 8 | SLEW = FAST ; #Pin 4
NET "io_gpioA_write[0]"          LOC = R5      | IOSTANDARD = LVCMOS33 | DRIVE = 8 | SLEW = FAST ; #Pin 5
NET "io_gpioA_write[1]"          LOC = T5      | IOSTANDARD = LVCMOS33 | DRIVE = 8 | SLEW = FAST ; #Pin 6
NET "io_gpioA_write[2]"          LOC = T9      | IOSTANDARD = LVCMOS33 | DRIVE = 8 | SLEW = FAST ; #Pin 7
NET "io_gpioA_write[3]"          LOC = V9      | IOSTANDARD = LVCMOS33 | DRIVE = 8 | SLEW = FAST ; #Pin 8

###################################################################################################################################################
#                                                   HEADER P8                                                                                     #
###################################################################################################################################################
NET "io_gpioA_writeEnable[0]"    LOC = R11     | IOSTANDARD = LVCMOS33 | DRIVE = 8 | SLEW = FAST ; #Pin 1
NET "io_gpioA_writeEnable[1]"    LOC = T11     | IOSTANDARD = LVCMOS33 | DRIVE = 8 | SLEW = FAST ; #Pin 2
NET "io_gpioA_writeEnable[2]"    LOC = R10     | IOSTANDARD = LVCMOS33 | DRIVE = 8 | SLEW = FAST ; #Pin 3
NET "io_gpioA_writeEnable[3]"    LOC = T10     | IOSTANDARD = LVCMOS33 | DRIVE = 8 | SLEW = FAST ; #Pin 4
NET "io_vga_colorEn"             LOC = U13     | IOSTANDARD = LVCMOS33 | DRIVE = 8 | SLEW = FAST ; #Pin 5  :  VGA output
NET "io_timerExternal_clear"     LOC = V13     | IOSTANDARD = LVCMOS33 | DRIVE = 8 | SLEW = FAST ; #Pin 6  :  Ext. timer
NET "io_timerExternal_tick"      LOC = U11     | IOSTANDARD = LVCMOS33 | DRIVE = 8 | SLEW = FAST ; #Pin 7  :  Ext. timer
NET "io_coreInterrupt"           LOC = V11     | IOSTANDARD = LVCMOS33 | DRIVE = 8 | SLEW = FAST ; #Pin 8  :  Ext. interrupt

###################################################################################################################################################
#                                                 UART Interface                                                                                  #
###################################################################################################################################################
NET "io_uart_txd"                LOC = A8      |  IOSTANDARD = LVCMOS33 | DRIVE = 8 | SLEW = FAST ;
NET "io_uart_rxd"                LOC = B8      |  IOSTANDARD = LVCMOS33 | DRIVE = 8 | SLEW = FAST ;

###################################################################################################################################################
#                                                 VGA - less color resolution than in Briey                                                                                         #
###################################################################################################################################################
NET "io_vga_hSync"               LOC = B12     | IOSTANDARD = LVCMOS33 | DRIVE = 8 | SLEW = FAST ;
NET "io_vga_vSync"               LOC = A12     | IOSTANDARD = LVCMOS33 | DRIVE = 8 | SLEW = FAST ;

NET "io_vga_color_r[4]"          LOC = C9      | IOSTANDARD = LVCMOS33 | DRIVE = 8 | SLEW = FAST ;
NET "io_vga_color_r[3]"          LOC = B9      | IOSTANDARD = LVCMOS33 | DRIVE = 8 | SLEW = FAST ;
NET "io_vga_color_r[2]"          LOC = A9      | IOSTANDARD = LVCMOS33 | DRIVE = 8 | SLEW = FAST ;

NET "io_vga_color_g[5]"          LOC = C11     | IOSTANDARD = LVCMOS33 | DRIVE = 8 | SLEW = FAST ;
NET "io_vga_color_g[4]"          LOC = A10     | IOSTANDARD = LVCMOS33 | DRIVE = 8 | SLEW = FAST ;
NET "io_vga_color_g[3]"          LOC = C10     | IOSTANDARD = LVCMOS33 | DRIVE = 8 | SLEW = FAST ;

NET "io_vga_color_b[4]"          LOC = A11     | IOSTANDARD = LVCMOS33 | DRIVE = 8 | SLEW = FAST ;
NET "io_vga_color_b[3]"          LOC = B11     | IOSTANDARD = LVCMOS33 | DRIVE = 8 | SLEW = FAST ;
  `
But I still don't known how to map few important DDR memory signals. The problem is that DDR chip on Mimas V2 has different internal arrangment. I don't know how to map/generate in Verilog code these signals for MT46H32M16LF memory chip:
`           #NET  "mcb3_dram_dm"              LOC = K3      | IOSTANDARD = MOBILE_DDR;
           #NET  "mcb3_dram_dqs"             LOC = L4      | IOSTANDARD = MOBILE_DDR;
            #NET  "mcb3_dram_udm"             LOC = K4      | IOSTANDARD = MOBILE_DDR;
            #NET  "mcb3_dram_udqs"            LOC = P2      | IOSTANDARD = MOBILE_DDR;
            #NET  "mcb3_rzq"                  LOC = N4      | IOSTANDARD = MOBILE_DDR;

   But I don't know how to generate these signals from original signals of Briey DDR controler. I am aware that these signals are important for proper timing of DDR memory.

 The last issue is that I am not sure if added two-directional buffer for busses between original Briey design and on-board DDR memory is proper (I am not sue if it lack of control direction of data-flow in it, but there isn't any otion for that in Xilinx "IP core" named "Select I/O Wizard).

I had posted and detailed describe my attempts to launch Briey SOC on Mimas V.2 Board on edaboard.com forum, but I didn't get answer solving my issues. Here is link to my post related to this topic:

[https://www.edaboard.com/showthread.php?383756-Briey-SoC-(RISCV)-and-Mimas-V-2-Numato-FPGA-board](url)

I hope that5 someone will be able to help me with these problems.

Thanks and regards

FlyingxDutch, 2019-05-03:
Here is ziped full project - ISE 14,7 :
[BrieySoCNext06.zip](https://github.com/SpinalHDL/VexRiscv/files/3141859/BrieySoCNext06.zip)

FlyingxDutch, 2019-05-03:
And here is diagram of new top module BrieySoC.v
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

And here internal organisation of Mimas V.2 DDR memory chip (MT46H32M16LF)
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

mithro, 2019-05-03:
@FlyingxDutch You might want to look at using LiteX with VexRISC-V we already have support for DDR on the MimasV2 board.

There is a tutorial for getting micropython running on MimasV2 here -> https://fupy.github.io/MimasV2.html

Dolu1990, 2019-05-04:
@FlyingxDutch Briey is only support SDRAM-SDR. Sorry :)

FlyingxDutch, 2019-05-05:
Hello,
now that i am aware, how it is implemented I think it is time to close that issue. I will look at LiteX  VexRISC-V implementation as @mithro adviced me.

Thanks all for quick answers and Regards

Closed 2019-05-05.

Thread 85 (2019-09-15):

Support multicore configurations

mithro, 2019-09-15:
It would be good to support VexRISCV in multicore configurations.

With the low resource usage of VexRISCV, supporting 2 or 4 core complexes on cheap boards would be very possible. We can then use it at https://github.com/litex-hub/linux-on-litex-vexriscv/issues/47

As VexRISCV now being used to run Linux, SMP support would hopefully improve performance.

@SpinalHDL / @Dolu1990 - What would be needed to make this happen? I assume a bunch of stuff around atomics and cache coherence?

Dolu1990, 2019-09-15:
As far i know there would be the change required :
- As you said, a coherent data cache. Possibly adding write back behaviour in addition of the actual write through to avoid producing to much write transactions.
- No atomic change required, basicaly, if the data cache is coherent, the atomics which are done in the data cache itself become coherent as well
- It would also require a coherent memory interconnect, maybe a coherent L2 depending the design choosed

Basicaly, there is a list of things to do on VexRiscv to improve various things:
- Increasing the data width of I$ D$ memory busses, to allow faster miss refill, actualy that's only 32 bits, this would boost  each core, as currently it seem the main bottleneck is the I$ miss penality. This kind of things do not show when we run benchmarks as dhrystone and coremark, as they work on very little code base. But running linux is a I$ hell ^^
- Data cache coherency for SMP
- Having xtval xtvec xepc xscratch in a block ram instead of raw register, this would save area and avoid having to reduce features set in machine mode (done to save area)
- FPU

Currently i'm slamed by third party obligations, but in march i should have much more free time too move things forward.

WillGreen, 2019-09-20:
Would you mind elaborating on the use-case for SMP @mithro?

My gut feeling is that SMP support would be impressive, but not that useful. There are more straightforward ways to boost performance that benefit a wide range of uses, not just SMP-aware operating systems. For example, increasing the width of cache busses, as @Dolu1990 has already mentioned.

I see CPUs on FPGAs as providing control and performing high-complexity operations, such as division and square root. If you’re doing something parallel and performance-critical, you can do it in a co-processor or separate logic block, without complicating the core VexRiscv design. If there is going to be a substantial addition of functionality, then I think an FPU is more desirable than additional integer cores.

Another approach is to place multiple VexRiscv cores on one FPGA and link them with a bus. Such a design wouldn’t “just work” in Linux, but would allow custom designs to perform more CPU operations in parallel if required.

A big part of what makes VexRiscv unique is its clean, elegant design. I’d hate to lose that.

Dolu1990, 2019-11-07:
I'm currently crushed by none SpinalHDL/VexRiscv obligations :(
So my hope is that in march i will get free of most of them, and move forward to make things progress.

@WillGreen @mithro Maybe SMP would be possible in some kind FPGA friendly / clean way :

- Keeping the memory bus untouched from the SMP stuff
- Having one coherent directory which would manage and track cache line states (invalid, shared, unique)
- To write, a CPU should  have the line in a unique state
- To read, a CPU should have the line in a shared or unique state)

To negotiate line state, there would be 2 channels between each CPU and the directory :

Channel 1
- Directory -> CPU to ask invalidate a line (allowing to make a line unique for another CPU) or to make it shared (which would imply the CPU isn't allow to keep the line dirty)
- CPU -> Directory to notify when one of the above transaction in comleted

Channel 2
- CPU -> Directory, to ask a line as unique or shared
- Directory -> CPU to notify when one of the above transaction is done

Channel 1 should have priority over channel 2

Then all data transaction would still be done by the same bus as actualy. This would allow to bring the system on all sort of memory system without specific requirements.
It would also avoid duplicating data path, as i would like to avoid tilelink like things.

That's just my current unrefined idea of how SMP could be done, but i'm not expert in that field XD

Dolu1990, 2019-11-07:
Another solution would be more AXI ACE like with 3 channel :

Channel 1 (write) :
- cpu -> interconnect : write cmd + data
- interconnect -> cpu : ack

Channel 2 (read / reserve) :
- cpu -> interconnect : [read] [unique/shared]
- interconnect -> CPU : readed data
- cpu -> interconnect  : ack

Channel 3 (probe) :
- interconnect -> cpu : address invalidate/shared
- cpu -> interconnect : ack

which would result into 3 steam with address, 2 stream with data.
The CPU can write the data back to memory when it got a probe hit.

Dolu1990, 2019-11-09:
A variation of the above proposal could be that a CPU cache could react to a probe request by the following ways :
- cache miss => channel 3 rsp ack
- cache hit =>  write back to memory on channel 1 + channel 3 rsp ack
- cache hit (and this one is special) => Channel 1 probe response with the related data., no channel 3 rsp ack. This would allow at a cheap cost to move data between caches while avoiding adding a new datapath.

Dolu1990, 2020-02-14:
https://github.com/SpinalHDL/VexRiscv/blob/dev/doc/smp/smp.md

Dolu1990, 2020-04-10:
Quite some progress here.

dev branch :
https://github.com/SpinalHDL/VexRiscv/tree/smp

Basicaly, the aim is to implement write-through invalidate coherency protocole for the CPU L1 d$.
There is a few reasons to not adopte (yet) a write-back based coherency protocol for the L1 :
- Write back penalities / workaround cost
- Write allocate penalities / workaround cost
- Write allocate line virtualy reduce the cache size / number of ways (ex single way d$  doing memory copy can endup into sever cash trashing if source and destination are aligned)
- Interconnect complexity, not that it is particulaly heavy for a writeback proposal, but still, quite some complexity added.

Currently, all the CPU side stuff is implemented
In a single core config, with random invalidations comming from the testbench, it can boot linux.

LR/SC are now using the memory bus "exclusive" feature, something similar to the AXI4 one, while AMO are emulated in the CPU hardware using those same LR/SC memory bus request.

Synthesis look good, as FMax is only 5% lower (without any time used to improve that), and the LUT occupancy is 2 % higher.

The only requirements for the interconnect are to implement eclusive accesses and to propagate write request as invalidation request to the other CPU.

Dolu1990, 2020-05-02:
Done :)

https://github.com/enjoy-digital/litex_vexriscv_smp
https://github.com/SpinalHDL/VexRiscv/blob/smp/src/main/scala/vexriscv/demo/smp/VexRiscvSmpCluster.scala#L21

But i have to document things

Closed 2020-05-02.

Thread 91 (2019-10-09):

Tightly coupled memory

Streetwalrus, 2019-10-09:
Supporting TCM, similar to ARM cores, would be a good alternative to caches.
It should be a bit less resource-hungry, it's more deterministic for hard real-time applications, and we can take advantage of the dual-port block RAMs in most FPGA architectures to have a shared instruction and data TCM.
The core could run entirely out of TCM and use external memory busses only to talk to peripherals.

Dolu1990, 2019-10-09:
Hi,

Do you mean TCM for cache full or cache less VexRiscv configs ? I mean both are very different case, so i just want to know which one we are takling about ^^

> dual-port block RAMs in most FPGA

Sure that's a good thing to use

Streetwalrus, 2019-10-09:
I'm not sure how much the presence of absence of a cache would affect this, but there are cortex-m cores with both. It's just a chunk of RAM that's placed closer to the core in the memory hierarchy, and has lower access latencies than external RAM since it doesn't have to go through the bus multiplexer, but the cost is of course that external peripherals can't access it.

Here's how it looks in the cortex-m3 implementation for FPGAs:
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

In the cortex-m1, they show the TCMs on a different path, not sure what's up with that.
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

tomverbeure, 2019-10-09:
> Do you mean TCM for cache full or cache less VexRiscv configs ? I mean both are very different case, so i just want to know which one we are takling about ^^

FWIW, with or without cache is orthogonal when talking about TCM. Many embedded CPUs have both, with TCM that is small but fast (almost always the same access latency, or faster, than a cache hit) with predictable access time (used for real-time interrupt driven routines etc.) and cache (or not) for all the rest of the code.

Tom

Streetwalrus, 2019-10-09:
Yeah, that's what I was thinking.
FPGAs also give you a lot of freedom for how you allocate the available block RAM to components. Dual port RAMs allow for a unified code+data memory while keeping a full Harvard architecture.
For example an a Spartan 6 LX9 or an ECP5 12k, you could easily have a 32KB TCM as the main memory for the processor, and then use the rest (still 16x 18Kb) for private peripheral buffers, or DMA space, which don't necessarily require as much space.

Dolu1990, 2019-10-09:
So currently the status of VexRiscv is as following :
Cached =>
- the I$ plugin support TCM interface
- the D$ do not support any form of TCM interface, but it shouldn't be something complicated to add, excepted if you also want atomic support in the TCM memory space, then things will be a bit more tricky.

Uncached =>
- the cacheless iBus dBus plugins do not implement any form of TCM support, the reason for that are multiple, but one big part of it is it isn't realy a big deal if you have a proper controle over your memory interconnect architecture. But this is something often hard to do with third party AXI / AHB interconnect which any do have all sorts of overhead.
- To fix that, we could totaly imagine some IBus dBus wrapper which would internaly manage the TCM and expose a general purpose memory bus master to connect the rest of the design.

One thing to keep in mind is if you want JTAG debugging to work, it is required the DBus to have access to the instruction TCM. Else it is probably not required with a proper linkerscript (as far i know).

Streetwalrus, 2019-10-10:
Thanks for the clarification.

> To fix that, we could totaly imagine some IBus dBus wrapper which would internaly manage the TCM and expose a general purpose memory bus master to connect the rest of the design.

That would be nice to have yes.

Thread 97 (2019-11-08):

Spec-compliant debug interface

MarekPikula, 2019-11-08:
Hi, are there any plans to create spec-compliant debug interface for VexRiscv? Although current debug interface is really nice and has nice performance it would be great to have standard solution in place, which works with upstream OpenOCD provided by RISC-V Foundation and possibly other tools, which support or will support spec.

Dolu1990, 2019-11-09:
Currently there is no plans for it.
It's hard for me to evaluate the official debug spec, between what is optional and what isn't i should probably take a look in the last revision.

MarekPikula, 2019-11-12:
I'd say that pretty nice reference for a execution-based core would be [riscv-dbg](https://github.com/pulp-platform/riscv-dbg) from PULP Platform. It's written in relatively good SystemVerilog and has nice documentation.

xobs, 2019-11-19:
I know this isn't the right place to hold a discussion about it, but we use the DebugPlugin by placing it on the general [wishbone] memory bus and tunneling it via a bridge, such as UART, USB, PCIe, or SPI.

We then use a piece of software called `wishbone-tool` to create a gdbserver bridge over your given medium:

- https://github.com/xobs/wishbone-utils/blob/master/wishbone-tool/src/riscv/mod.rs
- https://github.com/xobs/wishbone-utils/blob/master/wishbone-tool/src/gdb.rs

This has the nice property that we can get debugging even on an ICE40UP5k.

rapgenic, 2023-09-13:
Hi @Dolu1990, is there any news on this?

We are currently using litex to implement a SoC, and we'd like to have a softcore with a spec compliant debug interface. Looking at the commit history I've found the following commit:

[cores/vexriscv_smp add risc-v official debug support via --with-privileged-debug](https://github.com/enjoy-digital/litex/commit/112f78bde37c454209a25de7465e96d76cf87552)

Is this related to this issue? Also the commit refers to the SMP version of the core, is it applicable to the non SMP version as well?

Thanks!

bunnie, 2023-09-13:
fwiw I'm doing a tape-out using the default Vex JTAG interface and so far it's been fine. The main things I've learned are you have to make sure your TRST and system reset are independently controllable for reliable GDB attachment, and that the TRST has a pull-down on it so when you're not using it you don't get any X-prop issues.

Yes, I have to run on a custom build of openocd but it's rare that I don't have to do a custom build of openocd anyways for one reason or the other...

Dolu1990, 2023-09-13:
Hi,

Sorry, i forgot.

Here is some doc :
https://github.com/SpinalHDL/VexRiscv/tree/dev#embeddedriscvjtag

In short, from a raw VexRiscv perspective, there is a all in one plugin you can just add, you also need to set withPrivilegedDebug in the CsrPlugin config.

> Is this related to this issue?

Yes

that all in one plugin is only for non-smp version.
For smp version thing need to be a bit more outside the CPU
In litex, no port was made for the non smp version.

Dolu1990, 2023-09-13:
Also, note that often, the upstream openocd riscv version kind of break, so better using the vexriscv openocd fork.

rapgenic, 2023-09-14:
Hi,

Thanks for the information!

The documentation link you provided is in a dev branch, does it mean that it is still not released or is it only the documentation that was missing?

We're using the non SMP version for now, so the all in one plugin should be fine for us.

If we wanted to port the litex version we should be modifying the https://github.com/litex-hub/pythondata-cpu-vexriscv/ repository, correct?

Dolu1990, 2023-09-14:
I think the master branch should be good aswell, documentation wasn't merged yet in master.

Yes, the https://github.com/litex-hub/pythondata-cpu-vexriscv/blob/master/pythondata_cpu_vexriscv/verilog/src/main/scala/vexriscv/GenCoreDefault.scala file

Adding the plugin and setting withPrivilegedDebug in the CsrPlugin config
https://github.com/litex-hub/pythondata-cpu-vexriscv/blob/a36d99eeea984c261e16b744fc1d287c81099777/pythondata_cpu_vexriscv/verilog/src/main/scala/vexriscv/GenCoreDef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
.copy(withPrivilegedDebug=true)

rapgenic, 2023-09-14:
@Dolu1990, thank you, I've been able to take that repository and make some modifications to build some additional variants of the cpu that have the spec compliant jtag interface!!

https://github.com/protech-engineering/pythondata-cpu-vexriscv/commit/a384b014bd9c4fb76da0d0dfca897bf9bc3ae20c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

This is the patch if you're interested.

I have:
 * Updated the vexriscv module to the master
 * Changed the `-d` flag from a boolean to a string: `vexriscv` for the custom one and `riscv` for the spec compliant one.
 * Added another variant to the makefile, that generates `______DebugRiscv.v` files

I hopefully will be testing the CPU and its integration with litex the next days.

If everything is ok would you be then open to review a pull request to the `pythondata_cpu_vexriscv`?

Dolu1990, 2023-09-18:
> If everything is ok would you be then open to review a pull request to the pythondata_cpu_vexriscv?

Sure :D
This can be userfull for many.

MarekPikula, 2025-06-27:
Hi, I've heard that the spec-compliant debug interface is already there for VexRiscv. Is that true?

Dolu1990, 2025-06-27:
@MarekPikula  Hi, yes there is. here is an example : https://github.com/SpinalHDL/VexRiscv/blob/master/src/main/scala/vexriscv/demo/GenFullWithOfficialRiscvDebug.scala

MarekPikula, 2025-06-27:
Nice! I guess this issue is solved then?

Thread 98 (2019-11-19):

WFI: System can't be reset via DebugPlugin

xobs, 2019-11-19:
If you're using the DebugPlugin to debug a core, and it issues a `WFI` with no interrupts enabled, then that core will freeze and be unrecoverable with the DebugPlugin.

The only solution is to power-cycle the system.

Dolu1990, 2019-11-19:
ahh sure, that's right, hmm
so, when a debugplugin halt happen, the wfi should be waked up. i think that should be enough to fix the issue. I will fix that tonight, then can you test again ?

xobs, 2019-11-19:
Yes, that makes sense.

By the way, this was discovered when we were porting Linux to the Hackaday conference badge. For some reason, an atomic instruction was taking two cycles to execute (I.e. stepi halted twice with the same pc), didn't call the trap handler, and was effectively a noop. This led the Kernel startup to think it was cpu core #30000000, and wait to be woken up.

Are atomics implemented, or is there possibly another interaction with the Debug plug in and invalid instructions? Why would it execute the same pc twice?

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

Dolu1990, 2019-11-19:
weird, what was the cpu configuration ?
It happen when you were  doing step by step ?

xobs, 2019-11-19:
Same configuration as last time.  It's using `linuxFull()` as the CSR config.

xobs, 2019-11-19:
https://github.com/xobs/VexRiscv-verilog/blob/master/src/main/scala/vexriscv/GenHaD.scala

Dolu1990, 2019-11-19:
So

> , an atomic instruction was taking two cycles to execute

Basicaly, when the d$ do a miss, it refill itself and reschedule the instruction, but in debug that rescheduling isn't possible. So when you do a step on a memory operation which load stuff, you have no guarenties that the step will be successfull. This is expected behaviour, not a bug/issue.
So first dummy step behave as a line refill + NOP, second step do the real thing.

If you have the mmu enabled, that can be even worst, MMU miss + cache miss => 2 NOP before a successfull LD

As far i know, when using GDB and doing a step, if the PC didn't move, he redo a step automaticaly.

Anyway, stepbystep on atomic instruction was never tested, the best would probably to run a simulation and capture the wave to figure out what is going wrong.

xobs, 2019-11-19:
gdb will read the `$pc` in order to know where it is.  That way it can do things like trace the interrupt handler when an interrupt occurs.  With Vex, it seems like that the `stepIt` bit will simply not advance `$pc` when it stalls like that.  Which makes sense.

Does Vex currently support atomic instructions?  Particularly `amoadd.w a3, a2, (a3)`?  Or is that supposed to be patched and handled by `trap_handler`?

Dolu1990, 2019-11-19:
> Does Vex currently support atomic instructions?

Yes, the D$ support all of them. (https://github.com/xobs/VexRiscv-verilog/blob/master/src/main/scala/vexriscv/GenHaD.scala#L93)
what you can do to get a better diagnostic is to reduce the interraction between the debug and the hardware execution by using breakpoint instead of step.

As breakpoints will use the normal pipeline behaviour

mithro, 2019-11-19:
FYI -- @pgielda @mwelling @pdp7

Dolu1990, 2019-11-19:
I updated the VexRiscv dev branch to wakeup the pipeline when the debug ask to halt the CPU :
https://github.com/SpinalHDL/VexRiscv/commit/7ae218704e0e1849395e9bd64f58f34ce391b88d

@xobs Can you give a test ?

Dolu1990, 2019-11-19:
Just tested the WFI, that seem all fine now.

Now i'm checking atomic

Dolu1990, 2019-11-19:
@xobs

Tested the atomic stuff, i got that double step execution, but as said before, that's to be expected. But the execution (all in step by step) was fine.

```
_start:

    nop
    nop
    nop
    nop
    nop
    nop
    nop
    nop
    nop
    la a3, memA
    li a2, 1
    amoadd.w a3, a2, (a3)
    nop
    nop
    nop
    la a3, memA
    li a2, 1
    amoadd.w a3, a2, (a3)
    nop
    nop
    nop
    nop

memA:
.word 0x10
memB:
.word 0x20
```

xobs, 2019-11-20:
Sorry for the noise -- the other issue was completely unrelated and appears to be a bug in Linux where it assumes memory is cleared before it clears the BSS.

Specifically:

https://github.com/sifive/riscv-linux/blob/master/arch/riscv/kernel/head.S#L41-L45

This uses atomics to increment a value.  If the value is 0, then that core considers itself to have "won the lottery" and boots as normal.  If it's nonzero, then it assumes that some other core won the lottery and issues a WFI.

But if memory isn't zeroed out prior to running that code, then unless you have ~4 billion cores it's not guaranteed that any core will be 0.

mithro, 2019-11-20:
@xobs I'm guessing this should be sent upstream?

xobs, 2019-11-20:
Testing by having blockram at address 0x10000000, and loading the following binary.  Commands reproduced here so I can remember them in the future -

wfitest.S:

```asm
.global _start
_start:
	csrw sie, zero
    ebreak
    li t0, 0
    addi t0, t0, 1
    addi t0, t0, 1
    addi t0, t0, 1
    wfi
    addi t0, t0, 1
    addi t0, t0, 1
    addi t0, t0, 1
    ebreak
iloop:
    j iloop
```

```sh
$ riscv64-unknown-elf-gcc -ggdb3 "-Wl,--section-start=.text=0x10000000" -march=rv32ima -mabi=ilp32 wfitest.S -o wfitest.elf -nostdlib -nostdinc; riscv64-unknown-elf-objcopy -O binary wfitest.elf wfitest.bin
$
```

Without 7ae218704e0e1849395e9bd64f58f34ce391b88d the `wfi` locks up the CPU as described in the bug report.  With `7ae218704e0e1849395e9bd64f58f34ce391b88d` it behaves like a `nop` which is as expected.

xobs, 2019-11-20:
>
>
> @xobs I'm guessing the clear should be sent upstream to the RISC-V Linux?

I'm not sure how you'd do that.  They make an assumption that the memory is zeroed, which is how the whole lottery works.  The right way might be to have `hart_lottery` placed at a known offset so the bootloader knows to zero it.  Or to require that memory is zeroed.  Or to use some other method for determining which core you're on.

A bug should definitely be logged, I'm just not sure how to do that, and I haven't had good experience getting things upstream into Linux.

Thread 99 (2019-11-30):

How can i debug the customInstruction

Khaiduy, 2019-11-30:
I saw that we have a section for custom instruction and also the assembly code to debug it. But how can i run the .S file and show the flow of program.

Dolu1990, 2019-12-07:
Hi,

Basicaly, in the cpp regression, there is a mode to run a hex file instead of the tests :
https://github.com/SpinalHDL/VexRiscv/blob/master/src/test/cpp/regression/makefile#L121

There is for instance some example of make configs :
https://github.com/SpinalHDL/VexRiscv/blob/6fc5406901fcd34d2fa166761a588fea1b38cddf/src/test/scala/vexriscv/DhrystoneBench.scala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

So generate that config, add the RUN_HEX=absolute_path_to_your_hex, and that should do it.

Khaiduy, 2019-12-11:
Thank you for the reply. I can debug it now.

adz0612, 2022-09-22:
Hello, it may be trivial but how do I generate the mentioned HEX file? @Dolu1990

Dolu1990, 2022-09-22:
@adz0612 For instance :
riscv64-unknown-elf-objcopy -O ihex bios.elf bios.hex

adz0612, 2022-09-22:
@Dolu1990  Okay. Thanks! And then, to test with the hex I run something like:

`make clean run REDO=10 IBUS=SIMPLE DBUS=SIMPLE CSR=no MMU=no DEBUG_PLUGIN=no MUL=no DIV=no  COREMARK=yes RUN_HEX=absolute_path_to_your_hex `
?

Dolu1990, 2022-09-23:
Yes, i guess you don't need REDO=10 MMU=no MUL=no DIV=no COREMARK=yes  But it is fine with it too ^^

Dolu1990, 2022-09-23:
@adz0612

adz0612, 2022-09-28:
Hey, @Dolu1990 I had tried the same but it still seems to be running the Dhrystone benchmark and the other things, am I doing something wrong?
I generate the custom core using

`sbt "runMain vexriscv.demo.GenCustomSimdAdd" `
and then run
`make clean run IBUS=SIMPLE DBUS=SIMPLE CSR=no DEBUG_PLUGIN=no RUN_HEX=/home/aditya/Desktop/vexRiscv_tutorial/VexRiscv/src/main/c/murax/hello_world/build/hello_world.hex
`

Dolu1990, 2022-09-29:
@adz0612 Hmm that's weird, because in the main.cpp dhrystone come after RUN_HEX

Like the the 		#if defined(DEBUG_PLUGIN_EXTERNAL) || defined(RUN_HEX) wasn't triggered ?

adz0612, 2022-09-29:
I assumed it would work too, I manually forced all the flags to 'no', and now it's only running what I want. So that way it worked.

adz0612, 2022-09-29:
@Dolu1990  I had another similar issue while trying to debug using openOCD and verilator

 I generate my custom CPU using ( as shown under [Adding custom intruction](https://github.com/SpinalHDL/VexRiscv#add-a-custom-instruction-to-the-cpu-via-the-plugin-system) )
`sbt "runMain vexriscv.demo.GenCustomSimdAdd"`

And then when I try to run 9 DEBUG_PLUGIN=yes
`make clean run IBUS=SIMPLE DBUS=SIMPLE CSR=no MMU=no DEBUG_PLUGIN=yes MUL=no DIV=no DHRYSTONE=no REDO=2 CUSTOM_SIMD_ADD=yes
`

I get the following error:
`./main.cpp: In constructor ‘DebugPlugin::DebugPlugin(Workspace*)’:
../main.cpp:2407:8: error: ‘class VVexRiscv’ has no member named ‘debugReset’
 2407 |   top->debugReset = 0;
      |        ^~~~~~~~~~
../main.cpp: In member function ‘virtual void DebugPlugin::onReset()’:
../main.cpp:2458:8: error: ‘class VVexRiscv’ has no member named ‘debugReset’
 2458 |   top->debugReset = 1;
      |        ^~~~~~~~~~
../main.cpp: In member function ‘virtual void DebugPlugin::postReset()’:
../main.cpp:2464:8: error: ‘class VVexRiscv’ has no member named ‘debugReset’
 2464 |   top->debugReset = 0;
      |        ^~~~~~~~~~
../main.cpp: In member function ‘virtual void DebugPlugin::postCycle()’:
../main.cpp:2479:21: error: ‘class VVexRiscv’ has no member named ‘debug_resetOut’
 2479 |   top->reset = top->debug_resetOut;
      |                     ^~~~~~~~~~~~~~
`

How do I resolve this? I want to be able to debug applications as I can on the GenFull as shown [here](https://github.com/SpinalHDL/VexRiscv#interactive-debug-of-the-simulated-cpu-via-gdb-openocd-and-verilator)

Dolu1990, 2022-09-29:
@adz0612

GenCustomSimdAdd has no DebugPlugin, so i think that just adding
new DebugPlugin(ClockDomain.current.clone(reset = Bool().setName("debugReset"))),

in the plugin list of the GenCustomSimdAdd should do the trick ^^

Closed 2019-12-11.

Thread 101 (2019-12-18):

Can not include CustomCsrGpioDemoPlugin to Briey

Khaiduy, 2019-12-18:
When i try to include the CustomCsrGpioDemoPlugin to the Briey plugin list, and compile the Briey with sbt, it leads to the error
NO DRIVER ON (toplevel/axi_core_cpu/gpio_read : in Bits[32 bits]), define at...
How can i fix this problem?

Edit: I erase the  command "csrService(0xB0A, gpio.read)", then i can generate the Briey, but does that affect gpio?

Dolu1990, 2020-01-08:
Hi, sorry for the delay, i completly missed a bunch of issue XD

So, basicaly that's normal. the plugin will put signal in the toplevel for you to do something with, for instance connecting them to some toplevel IO to make them going in/out of the SoC

And the error you have, is SpinalHDL seeing you have some floating wire. That's a lint check :)

Khaiduy, 2020-01-09:
Thanks for the feedback, actually I have many questions for you =)), but let's get into the main topics. First, can you explain a little bit about CsrInterface? I don't see the difference between the usage of onRead and onWrite.
The second is the use of both Csr and custom instruction in a plugin (my article is to create a hardware accelerator module controlled by custom instrucstion via CSR), but the more I do it, the more I find there is not much benefit from Combining the two. What do you think about this.

Khaiduy, 2020-01-09:
Thanks for the feedback, actually I have many questions for you =)), but let's get into the main topics. First, can you explain a little bit about CsrInterface? I don't see the difference between the usage of onRead and onWrite.
The second is the use of both Csr and custom instruction in a plugin (my article is to create a hardware accelerator module controlled by custom instrucstion via CSR), but the more I do it, the more I find there is not much benefit from combining the two. What do you think about this.

Dolu1990, 2021-03-24:
Ahhh damned, just ping me when i have more than 3 days delay,  i easily lose tracks of issues.

> I don't see the difference between the usage of onRead and onWrite.

Basicaly, not all CSR access do read nor write, ex if the target register is x0 => no read.

> The second is the use of both Csr and custom instruction in a plugin

The FpuPlugin is quite close to that. basicaly there is CSR to controle the rounding mode and check the flags of the FPU + the integration of the FPU itself. So the advantage of having all together is that you can localise a feature in the source code instead of spliting it too much.
https://github.com/SpinalHDL/VexRiscv/blob/fpu/src/main/scala/vexriscv/plugin/FpuPlugin.scala

Sorry again for the bad issue tracking

Closed 2021-03-24.

Thread 102 (2019-12-21):

Murax in JTAG daisy chain

sebastien-riou, 2019-12-21:
I daisy chain Murax with another tap. I get correct operation when I do:
`
TDI -> Murax -> other -> TDO`
I get incorrect operation for the opposite:
`
TDI -> other -> Murax -> TDO`
So I guess we cannot daisy chain 2 Murax together.

To investigate the issue I customized Murax's JTAG:

```
class TesicChip1JtagBridge(c: SystemDebuggerConfig) extends Component{
  val io = new Bundle {
    val jtag = slave(Jtag())
    val remote = master(SystemDebuggerRemoteBus(c))
  }

  val system = new Area{
    val cmd = Flow Fragment(Bits(1 bit))
    io.remote.cmd << cmd.toStream

    val rsp = Reg(Flow(SystemDebuggerRsp(c)))
    when(io.remote.cmd.valid){
      rsp.valid := False
    }
    when(io.remote.rsp.fire){
      rsp.valid := True
      rsp.payload := io.remote.rsp.payload
    }
    io.remote.rsp.ready := True
  }

  val jtag = ClockDomain(io.jtag.tck)(new Area{
    val testReg = Reg(UInt(75 bits))
    val tap = new JtagTap(io.jtag, 4)
    val idcodeArea = tap.idcode(B"x0FFFFAAB")(1)
    val writeArea = tap.flowFragmentPush(system.cmd,TesicChip1JtagBridge.this.clockDomain)(2)
    val readArea = tap.read(system.rsp)(3)
    val treadArea = tap.read(testReg)(instructionId = 4)
    val twriteArea = tap.write(testReg)(instructionId = 5)
    readArea.shifter.addTag(crossClockDomain)
  })
}
```

Instructions 1,4 and 5 are working in both cases, only instruction 2 and 3 don't.

Dolu1990, 2020-01-08:
Hi, Sorry, i realy missed some issue. Please ping me when you have no responses (stack overflow).

So, i never tested JTAG with multiple tap, but that's something i'm interrested in.

I will try it in simulation via the tcp_jtag, this will allow to have a good visibility on what is happening :)

Dolu1990, 2020-01-08:
Then about having multiple VexRiscv in the same Soc, basicaly, it is supported, what you have to do is to manualy instanciate the SystemDebugger + JtagBridge (hidden in https://github.com/SpinalHDL/VexRiscv/blob/master/src/main/scala/vexriscv/plugin/DebugPlugin.scala#L72)

And connect the SystemDebugger memory interface to all the VexRiscv that you have with different address, and then in openocd config script, define multiple target (https://github.com/SpinalHDL/openocd_riscv/blob/riscv_spinal/tcl/target/murax.cfg#L18)
but with their corresponding address (-dbgbase XXX)

Then that should be fine. Be aware, i tested it probably 2 years ago, but should work fine.

Dolu1990, 2020-01-08:
I can reproduce it in sim

Dolu1990, 2020-01-08:
Have a fix, basicaly, that was because the bypass register of the JTAG was only sampling the input in DR_SHIFT, but it should always sample the input. Changing that i have the following working in sim :
3 bits custom tap -> 4 bits CPU tap -> 5 bits custom tap

```scala
      case plugin : DebugPlugin         => plugin.debugClockDomain{
        resetCtrl.systemReset setWhen(RegNext(plugin.io.resetOut))
        class SimpleJtagTap(ilen : Int, opcode : Long) extends Component {
          val io = new Bundle {
            val jtag    = slave(Jtag())
            val switchs = in  Bits(8 bit)
            val keys    = in  Bits(4 bit)
            val leds    = out Bits(8 bit)
          }

          val ctrl = new ClockingArea(ClockDomain(io.jtag.tck)) {
            val tap = new JtagTap(io.jtag, ilen)
            val idcodeArea = tap.idcode(B(opcode))(instructionId = 1)
            val switchsArea = tap.read(io.switchs)(instructionId = 5)
            val keysArea = tap.read(io.keys)(instructionId = 6)
            val ledsArea = tap.write(io.leds)(instructionId = 3)
          }
        }

        val cpuTap = plugin.io.bus.fromJtag()
        val customTap0 = new SimpleJtagTap(3, 0x87654321l)
        val customTap2 = new SimpleJtagTap(5, 0x80022001l)
        customTap0.io.switchs := 0
        customTap0.io.keys := 0
        customTap2.io.switchs := 0
        customTap2.io.keys := 0

        customTap0.io.jtag.tck := io.jtag.tck
        customTap0.io.jtag.tms := io.jtag.tms
        cpuTap.tck := io.jtag.tck
        cpuTap.tms := io.jtag.tms
        customTap2.io.jtag.tck := io.jtag.tck
        customTap2.io.jtag.tms := io.jtag.tms

        customTap0.io.jtag.tdi := io.jtag.tdi
        cpuTap.tdi := customTap0.io.jtag.tdo
        customTap2.io.jtag.tdi := cpuTap.tdo
        io.jtag.tdo := customTap2.io.jtag.tdo
```

I just have to test things a bit more and then will commit

Dolu1990, 2020-01-08:
Tested on hardware in the same configuration, it work fine. I pushed the fix, that's in SpinalHDL dev branch, so to use it, you need to use the VexRiscv dev branch too.

Dolu1990, 2020-01-08:
Hoo for the above case, i used the following openocd config :

```
set  _ENDIAN little
set _TAP_TYPE 1234

if { [info exists CPUTAPID] } {
   set _CPUTAPID $CPUTAPID
} else {
  # set useful default
   set _CPUTAPID 0x10001fff
}

adapter_khz 800
adapter_nsrst_delay 260
jtag_ntrst_delay 250

set _CHIPNAME fpga_spinal
jtag newtap miaou bridge -expected-id 0x80022001 -irlen 5 -ircapture 0x1 -irmask 0x1F
jtag newtap $_CHIPNAME bridge -expected-id $_CPUTAPID -irlen 4 -ircapture 0x1 -irmask 0xF
jtag newtap miaou bridge -expected-id 0x87654321 -irlen 3 -ircapture 0x1 -irmask 0x7

target create $_CHIPNAME.cpu0 vexriscv -endian $_ENDIAN -chain-position $_CHIPNAME.bridge -coreid 0 -dbgbase 0xF00F0000

vexriscv readWaitCycles 12
vexriscv cpuConfigFile $MURAX_CPU0_YAML

poll_period 50

init
#echo "Halting processor"
soft_reset_halt
sleep 1000
```

sebastien-riou, 2020-01-08:
Thanks, it works on my side now, can debug under Eclipse no matter the order in the JTAG chain :-)

Closed 2020-01-08.

Thread 120 (2020-04-01):

Compile options for regression test programs

genesys2, 2020-04-01:
Hi,

i have another question regarding the regression testing.

Short version: What compiler flags / linker file (?) did you use to compile the regression test programs (Coremark / Dhrystone)?

Long version:
I need to modify the test programs (e.g. coremark) to cover the changes I made to the processor. Therefore, I recompiled coremark, converted it to binary and copied the new version to `/src/test/resources/bin/coremark_new.bin` and edited the main function of `/src/test/cpp/main.c` so that it also covers this file.

````
WorkspaceRegression("coremark_new")).withRiscvRef()
        //->loadBin(string(REGRESSION_PATH) + "../../resources/bin/coremark_" + rv + ".bin", 0x80000000)
        ->loadBin(string(REGRESSION_PATH) + "../../resources/bin/coremark_new.bin", 0x80000000)
        ->bootAt(0x80000000)
        ->setIStall(withStall > 0)
        ->setDStall(withStall > 0)
        ->run(50e6);
````

Note: I don't necessarily need to compare the traces to a reference, thus I commented this section of Workspace `run` (riscvRefEnable = False didn't work for some reason):
````
if(riscvRefEnable && top->VexRiscv->lastStagePc != riscvRef.lastPc){
    cout << hex << " pc missmatch " << top->VexRiscv->lastStagePc << " should be " << riscvRef.lastPc << dec << endl;
    fail();
}
````

If I run this, I eventually get the error `??? periphWritesGolden` followed by a `periphWrite timout`. I assume, the coremark binary isn't correctly compiled and that’s what causes the issue but that is just a guess. Coremark is build with

````
riscv32-unknown-elf-gcc -march=rv32ima -mabi=ilp32 -O2 -mcmodel=medany -static -std=gnu99 -fno-common -nostdlib -nostartfiles -lm -lgcc -T ../riscv64-baremetal/link.ld -I../riscv64-baremetal -I. -DFLAGS_STR=\""-march=rv32ima -mabi=ilp32 -O2 -mcmodel=medany -static -std=gnu99 -fno-common -nostdlib -nostartfiles -lm -lgcc -T ../riscv64-baremetal/link.ld   -lm -lgcc"\" -DITERATIONS=0  core_list_join.c core_main.c core_matrix.c core_state.c core_util.c ../riscv64-baremetal/core_portme.c ../riscv64-baremetal/syscalls.c ../riscv64-baremetal/crt.S -o ./coremark.bare.riscv -lm -lgcc
````
Is my assumption correct, that this issue is related to my compile options or is my approach otherwise flawed?

Thank you! :-)

genesys2, 2020-04-08:
I figured a few things out, I found the UART.h which allows printing to the console when the external debugger is used. However, the timing instructions do not work as gdb gets stuck in the interrupt handler. Also, the UART write does not seem to work when the hex file is executed during regression.

@Dolu1990 do you maybe know how to compile Coremark / Dhrystone so they work when loaded during regression?

Dolu1990, 2020-04-09:
@genesys2 Hi

Sorry for the delay.

So basicaly, the periphWritesGolden stuff is a cross check with the VexRiscv software model that the hardware CPU is properly reading/writing peripherals.

One thing, especialy about GDB / debug.

Since march there was a bug in the DebugPlugin of VexRiscv which was corrupting step by step debug.
It is fixed in dev and in master, else you can just cherry pick the related commit, as it is realy small.

>  do you maybe know how to compile Coremark / Dhrystone so they work when loaded during regression?

Yes, basicaly, you should remove the .withRiscvRef() from your workspace, basicaly, having it enable the software model <> hardware model cross check, but the issue is that the software model do not support JTAG.
So, removing withRiscvRef should fix your issue, let's me know else :)

Regards
Charles

genesys2, 2020-04-15:
Hi Charles,

thank you! It is now working :)

Regards,
Jan

Closed 2020-04-15.

Thread 121 (2020-04-03):

Murax on simulator doesn't store values into RAM

yokoyama-flogics, 2020-04-03:
Hello,

I'm enjoying VexRiscv and also SpinalHDL very much.  Thank you for your great software.

However, I have a strange problem when running Murax by simulation.

Followed the explanation in the URL:

https://github.com/SpinalHDL/VexRiscv/README.md (git commit 31d2aaa)

and executed

```bash
$ cd somewhere/VexRiscv
$ sbt "runMain vexriscv.demo.Murax"
$ cd src/test/cpp/murax
$ make clean run
```

In a different terminal, ran your version of openocd_riscv (git commit 2743d9b) as

```bash
$ openocd -f interface/jtag_tcp.cfg -c "set MURAX_CPU0_YAML /home/yokoyama/VexRiscv/cpu0.yaml" -f target/murax.cfg
```

And finally ran gdb (SiFive GNU Embedded Toolchain — v2019.08.0 binary) as

```bash
$ cd somewhere/VexRiscvSocSoftware/projects/murax/demo
$ make
$ /opt/riscv/bin/riscv64-unknown-elf-gdb build/demo.elf
GNU gdb (GDB) 8.0.50.20170724-git
Copyright (C) 2017 Free Software Foundation, Inc.
License GPLv3+: GNU GPL version 3 or later <http://gnu.org/licenses/gpl.html>
This is free software: you are free to change and redistribute it.
There is NO WARRANTY, to the extent permitted by law.  Type "show copying"
and "show warranty" for details.
This GDB was configured as "--host=x86_64-pc-linux-gnu --target=riscv64-unknown-elf".
Type "show configuration" for configuration details.
For bug reporting instructions, please see:
<http://www.gnu.org/software/gdb/bugs/>.
Find the GDB manual and other documentation resources online at:
<http://www.gnu.org/software/gdb/documentation/>.
For help, type "help".
Type "apropos word" to search for commands related to "word"...
Reading symbols from build/demo.elf...done.
(gdb) target remote :3333
Remote debugging using :3333
crtStart () at src/crt.S:6
6	  j crtInit
(gdb) monitor reset halt
JTAG tap: fpga_spinal.bridge tap/device found: 0x10001fff (mfg: 0x7ff (<invalid>), part: 0x0001, ver: 0x1)
(gdb) load
Loading section .vector, size 0x130 lma 0x80000000
Loading section .memory, size 0x354 lma 0x80000130
Loading section .data, size 0x4 lma 0x80000484
Start address 0x80000000, load size 1160
Transfer rate: 12 KB/sec, 386 bytes/write.
(gdb) tb main
Temporary breakpoint 1 at 0x800002d4: file src/main.c, line 7.
(gdb) c
Continuing.

Program stopped.
main () at src/main.c:7
7		volatile uint32_t a = 1, b = 2, c = 3;
(gdb) n

Program stopped.
main () at src/main.c:12
12		timer_init(TIMER_A);
```

Strange to say, local variables on stack aren't stored correctly.

```bash
(gdb) p a
$1 = 2785635792
(gdb) p b
$2 = 1
(gdb) p c
$3 = 4035717316
(gdb) n
19		TIMER_INTERRUPT->PENDINGS = 0xF;
```

I also checked by memory dump.

```bash
(gdb) info reg sp
sp             0x80000660	-2147482016
(gdb) p/ &a
$4 = (volatile uint32_t *) 0x80000674
(gdb) p/ &b
$5 = (volatile uint32_t *) 0x80000670
(gdb) p/ &c
$6 = (volatile uint32_t *) 0x8000066c
(gdb) x/32x 0x80000660
0x80000660:	0xf6204973	0xa3f03c89	0x717e8c99	0xf08c28c4
0x80000670:	0x00000001	0xa6096dd0	0xfe7af673	0x6285a8cb
0x80000680:	0xf6fe060e	0x247ed833	0x0000d4d4	0x8000012c
0x80000690:	0x2066adf4	0x6091c3f4	0xc2bdb7b1	0xdfb08152
0x800006a0:	0xc72d93f8	0xf0d9c1a9	0xdfe8f1fb	0x241c140c
0x800006b0:	0x5abe2388	0xfb7afa79	0x0902faf2	0x9291908f
0x800006c0:	0x4589cd10	0x7970665d	0x09d0985f	0xa3896f55
0x800006d0:	0x3a3d4043	0x77c4115f	0x087ef46b	0x03b05d0a
(gdb)
```

Variables a, b, c and also result are strange even by memory dump.

However, I confirmed that I could directly assign values to variables by gdb.

```bash
(gdb) set {int}0x8000066c=0x123
(gdb) x/4x 0x80000660
0x80000660:	0xf6204973	0xa3f03c89	0x717e8c99	0x00000123
(gdb)
```

On the other hand, when run the demo code, UART transmitter is working
and the simulator shows the letter 'A' on screen by the following line:

```c++
    UART->DATA = 'A';
```

In other words, writing to peripheral registers look working fine...

By the way, this problem doesn't occur on actual FPGA (Murax on iCE40).  Only occurs on simulator.

My environment is Ubuntu 16.04.6 LTS.

Any suggestion would be highly appreciated.

Regards,

Atsushi Yokoyama

yokoyama-flogics, 2020-04-03:
Just in case, also checked assembly output (beginning part) of the function main().

```asm
void main() {
800002c4:       fd010113                addi    sp,sp,-48
800002c8:       02112623                sw      ra,44(sp)
800002cc:       02812423                sw      s0,40(sp)
800002d0:       03010413                addi    s0,sp,48
        volatile uint32_t a = 1, b = 2, c = 3;
800002d4:       00100793                li      a5,1
800002d8:       fef42223                sw      a5,-28(s0)
800002dc:       00200793                li      a5,2
800002e0:       fef42023                sw      a5,-32(s0)
800002e4:       00300793                li      a5,3
800002e8:       fcf42e23                sw      a5,-36(s0)
        uint32_t result = 0;
800002ec:       fe042623                sw      zero,-20(s0)

        interruptCtrl_init(TIMER_INTERRUPT);
800002f0:       f00207b7                lui     a5,0xf0020
800002f4:       01078513                addi    a0,a5,16 # f0020010 <__global_pointer$+0x7001f388>
```

Regards,

Atsushi

yokoyama-flogics, 2020-04-03:
FYI, Verilator version is 3.918.

Dolu1990, 2020-04-06:
Hi, sorry for the delay.
So normaly i'm using eclipse to debug stuff, and there as far i know, all is fine, but i to check following your procedure to see what is going wrong.

Should have time to do that tomorrow :)

yokoyama-flogics, 2020-04-06:
Thank you for your attention!

I will dig into the problem by myself too.
It will lead to my better understanding of SpinalHDL and also memory architecture around VexRiscv.

Regards,
Atsushi

yokoyama-flogics, 2020-04-07:
I have checked CPU and bus behaviors, **without OpenOCD connection**, on gtkview and confirmed that memory write accesses are fine.

Following is memory write to 0x8000066c.
```asm
800002e8:       fcf42e23                sw      a5,-36(s0)
```

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

And the following is read access to the same address.
```asm
800003a4:       fdc42783                lw      a5,-36(s0)
```

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

So my current conclusion is, the problem is not due to CPU nor bus behaviors.

I think I need to dive into interactions between OpenOCD and JTAG.

Regards,
Atsushi

Dolu1990, 2020-04-07:
So basicaly, i updated how the step by step worked in the CPU, but that's broken, i'm fixing it now.

Dolu1990, 2020-04-07:
Fixed in dev and master :)

Also for the sim of murax, there is also sbt "test:runMain vexriscv.MuraxSim"

Thanks for the issue !

yokoyama-flogics, 2020-04-08:
Thank you for prompt fix!
Confirmed that problem was resolved.

Regards,
Atsushi

Closed 2020-04-07.

Thread 122 (2020-04-22):

Murax/iCE40-hx8k_breakout_board_xip can't build

yokoyama-flogics, 2020-04-22:
Hello,

I'm afraid of frequent questions...

When I followed the explanation below URL, but I saw a build error.  (I'm evaluating VexRiscv commit ddc59bc.)

- https://github.com/SpinalHDL/VexRiscv/tree/master/scripts/Murax/iCE40-hx8k_breakout_board_xip

The error is as following.

```bash
$ cd somewhere/VexRiscv/scripts/Murax/iCE40-hx8k_breakout_board_xip
$ make compile
(cd ../../..; sbt "runMain vexriscv.demo.Murax_iCE40_hx8k_breakout_board_xip")
[info] Loading settings for project vexriscv-build from plugins.sbt ...
[info] Loading project definition from /Users/yokoyama/tmp/VexRiscv/project
[info] Loading settings for project root from build.sbt ...
[info] Set current project to VexRiscv (in build file:/Users/yokoyama/tmp/VexRiscv/)
[warn] Multiple main classes detected.  Run 'show discoveredMainClasses' to see the list
[info] Running (fork) vexriscv.demo.Murax_iCE40_hx8k_breakout_board_xip
[info] [Runtime] SpinalHDL v1.4.0    git head : ecb5a80b713566f417ea3ea061f9969e73770a7f
[info] [Runtime] JVM max memory : 5461.5MiB
[info] [Runtime] Current date : 2020.04.22 10:49:04
[info] [Progress] at 0.000 : Elaborate components
[info] **********************************************************************************************
[info] [Warning] Elaboration failed (0 error).
[info]           Spinal will restart with scala trace to help you to find the problem.
[info] **********************************************************************************************
[info] [Progress] at 0.916 : Elaborate components
[error] Exception in thread "main" scala.NotImplementedError: an implementation is missing
[error]         at scala.Predef$.$qmark$qmark$qmark(Predef.scala:230)
[error]         at spinal.lib.com.spi.ddr.SpiXdrMasterCtrl$XipBus.fromPipelinedMemoryBus(SpiXdrMasterCtrl.scala:309)
[error]         at vexriscv.demo.Murax$$anon$4$$anonfun$8$$anon$6.<init>(Murax.scala:301)
(snip)
```

I'm not confident but the following line of SpinalHDL/lib/src/main/scala/spinal/lib/com/spi/xdr/SpiXdrMasterCtrl.scala (v1.4.0) looks causing the error.

```scala
    def fromPipelinedMemoryBus() = {
      val accessBus = new PipelinedMemoryBus(PipelinedMemoryBusConfig(24,32))
      ???
//      cmd.valid <> (accessBus.cmd.valid && !accessBus.cmd.write)
//      cmd.ready <> accessBus.cmd.ready
//      cmd.payload <> accessBus.cmd.address
//
//      rsp.valid <> accessBus.rsp.valid
//      rsp.payload <> accessBus.rsp.data
      accessBus
    }
```

May I ask if we can evaluate the XIP functionality by the recent VexRiscv releases?

Thanks and Best Regards,
Atsushi Yokoyama

Dolu1990, 2020-05-02:
Hi,
Sorry for the delay, i was in a VexRiscv SMP rush, finaly got linux to boot on it with a quad core configuration on Arty A7 :)

So, basicaly, i commented that out because i changed the way the Xip interface work. by the past it was word based (you ask a address, it return you 32 bits data), now it is burst based (you specify the address and how many byte you want, and it return those byte one by one). Hmm to restore the functionalty we woudl basicaly just need to add a buffer on the RSP to rebuild a word access from 8 bits beats.

Do you think you can manage it :D ?

yokoyama-flogics, 2020-05-03:
Hello,
Thank you for your reply.

I'm not in a hurry about XiP experimentation.  In addition, burst based XiP looks interesting.  Does it work fine with I-cache?

BTW, running Linux on SMP sounds great.  Please concentrate on the current project!

Regards,
Atsushi

yokoyama-flogics, 2020-05-03:
Hi Dolu1990,

May I have one request!?

When I will evaluate your new XiP implementation (some day), I want to port it to TinyFPGA BX.  [That looks having Adesto Technologies AT25SF081-SSHD on it](https://github.com/tinyfpga/TinyFPGA-BX/blob/master/board/TinyFPGA-BX-Schematic.pdf).  It would be helpful if your implementation is portable and you show which code we should change for different Flash ROMs.

Thanks and Regards,
Atsushi

yokoyama-flogics, 2020-05-23:
Hello Dolu1990,

Now I could implement XiP (execute in place) for TinyFPGA BX and Adesto SPI Flash memory by myself.  Connected SPI ROM to Briey AXI4 crossbar.  (I don't think it's good design, but I will put the code onto my GitHub repo in the near future.)

My current implementation doesn't use Quad read or SB_IO DDR functionality of iCE40, so it's very slow, but I'm satisfied very much.

Thank you for your support always.  SpinalHDL and Vexriscv are very interesting to learn.  Please close this thread.

Regards,
Atsushi

Dolu1990, 2020-05-23:
Ok :)
Thanks

So right, got SMP to work on https://github.com/enjoy-digital/litex_vexriscv_smp
Now starting to port it on SaxonSoc :)

yokoyama-flogics, 2020-05-25:
Hi,

I want to evaluate running Linux with SMP in the near future.

On the other hand, I have published my own XiP implementation for TinyFPGA BX (iCE40-LP8K).
Just for your information. :blush:

- [VexRiscv (mini) Briey port to TinyFPGA BX](https://github.com/yokoyama-flogics/VexRiscv)

Regards,
Atsushi

Closed 2020-05-23.

Thread 123 (2020-05-18):

How do you achieve such low lut counts?

timleijt, 2020-05-18:
@Dolu1990
Hello,

I'm writing my own RISC-V core in Verilog and am looking for ways to make it smaller since it doesn't fit on my FPGA right now. It uses about 5400 luts for the core itself. This is only the rv32I extension set, nothing else.
I came across your project and noticed how you use significantly fewer luts(731!). So I'm wondering how you got it so small? In my project I noticed about 60% of my luts go to the registers, how did you solve that?

I hope you can explain a little about your project to me and apologies for asking a kinda offtopic question.

Thanks!

Dolu1990, 2020-05-18:
Hi,

Hmm, did you implemented some CSR ? or not yet ?

One thing about Cyclone IV, is that as the FPGA do not support asyncronus reads on memories (no distributed ram), it is realy important to read the register file over one full cycle to allow the synthesis to infer a ram block.

In VexRiscv, with the SYNC register file config, it send the read address to the regfile one cycle before the decode stage, and syncronusly read the regfile to get its value in the decode stage.
That might be the main difference ?

If you switch the SYNC config to ASYNC you will see the occupancy exploiding :)

let's e know how it goes !

timleijt, 2020-05-18:
So you are saying I should move my registers to block ram? Wouldn't that be extremely slow? Also, doesn't that mean I can only read 1 value from registers at a time(per cycle I mean)?

Dolu1990, 2020-05-18:
> So you are saying I should move my registers to block ram?

Yes

> Wouldn't that be extremely slow

Not realy, you can have two rams (2 * (1r + 1w)), connect both write portes together, and using the two read ports independantly to read read two registers by cycles

timleijt, 2020-05-18:
Okay thanks! I'll modify my design to move registers to block ram and see how it goes.

timleijt, 2020-05-19:
Hello I'm back.

Sorry to ask you this, but I can't get quartus to infer my registers to block ram.
I'm making sure I'm only accessing the registers once a cycle by counting cycles. Here is my entire code: https://pastebin.com/XiH1zYiq
So my question is, can you see why? I thought I just didn't understand how to infer ram to block ram, so I wrote a tiny test to see if I can get that to work, and I did get that to work correctly:
```
module membittest(
	input wire clk,
	output reg [31:0]rd1,
	output reg [4:0]rd1Addr
);

	reg [31:0]registers[0:31];
	reg [7:0]count = 0;

	//reg [4:0]rd1Addr = 0;

	integer i;
	initial begin
		for (i = 0; i < 32; i = i+1)
		begin
			registers[i] = 0;
		end
	end

	always @ (posedge clk)
	begin
		count = count + 1;
		case (count)
			0: begin
				rd1 = registers[rd1Addr];
			end
			1: begin
				rd1 = rd1+1;
				registers[rd1Addr] = rd1;
				rd1Addr = rd1Addr + 1;
				count = -1;
			end
		endcase
	end

endmodule

```
This does move the registers to block ram, however, my riscv core code doesn't even though I seem to be doing largely the same thing.
Can you see what I'm doing wrong?

Thanks!

Dolu1990, 2020-05-19:
Hi,

My guess is that the synthesis tool don't like the registers array read/write inside a case statement.
I already had case where having the registers read/write inside a if(x & y) instead of a if(x) was making the inferation not working. XD

So normaly in the quartus software, in the text editor, there is a icon to open a library of templates, in it should be some patterns to write memory that can be reconized by the synthesis tool as proper memory block.

Good luck ^^

timleijt, 2020-05-19:
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

Thank you so much! I managed to move the registers and ram to block ram and it finally works! I can now successfully blink an LED using risc-v instructions.
I need to do a lot of optimizing though, currently every instruction is 10 cycles because it reads one byte of ram at a time since it's easier, it also fetches one register at a time. There is definitely room for improvement but right now I'm glad it's running.

So thanks a lot for your help!

Thread 128 (2020-06-01):

Question regarding APB MMIO cycles

wenwang3122, 2020-06-01:
Hi!

The following question is not about a bug in the code, it is more of an IO overhead question regarding my software-hardware co-design experiments based on Murax SoC. _I am not sure if it is suitable to post such question here, please feel free to let me know if it is not okay to do so._

Here is the background:
I am using Murax SoC as a platform to do software-hardware co-designs, and the hardware accelerators are added as APB peripherals. I attached a sample diagram below (murax-co-design-sample-diagram.png).

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

In this setup, the software-hardware interface overhead is critical for the overall performance. During my experiments, I found out that:

1. Typically, one **APB write takes 3 clock cycles** while one **APB read takes 4 clock cycles**. There doesn't seem to exist a way to further reduce the cycle counts.

Suppose data_in is an MMIO register, the code is as follows:
**data_in[0] = variable_reg;**

2. When APB write is combined with memory read/ APB read is combined with memory write, as follows (suppose data_out is an MMIO register):

**data_in[0] = variable_array[i];
result_array[i] = data_out[0];**

Then the cycles for **APB write increases from 3 to 6/8/9 cycles** (different scenarios), and **APB read increases from 4 to 8/9/10 cycles** (different scenarios). The increases (APB write/read alone vs APB write/read + memory access) exceeds the memory access alone cycles (based on my benchmarks).

Here are my questions:
1. Do you have any ideas about the cycles overhead?
2. Or do you have any recommendations about how to do the software-hardware co-design based on VexRiscv in a different setup to reduce the IO overhead?
3. Would switching to Briey SoC (with Dcache, Icache, MMU, AXI bus) help reduce the IO overhead (although still the interface with peripherals is APB)?

Thank you very much!
Wen

Dolu1990, 2020-06-01:
>  I am not sure if it is suitable to post such question here

No worries, that's fine ^^

> Do you have any ideas about the cycles overhead?

Hmm would need a wave to figure out the timings. If you want i can point out some key signals ?
It might be en part because the instruction bus is accessing the bus at the same time, which create some conflicts. The data bus and instruction bus share the same bus to access peripherals and ram, see "val mainBusArbiter = new MuraxMasterArbiter(pipelinedMemoryBusConfig)" , your diagram isn't accurate on that point.
(dBus+iBus) -> mainBusArbiter -> (ram + peripheral)

> Or do you have any recommendations about how to do the software-hardware co-design based on VexRiscv in a different setup to reduce the IO overhead?

Yes, basicaly, could add a custom VexRiscv instruction to directly feed the accelerator with CPU data, else, less optimal, but still better than nothing, is to avoid APB and directly define a SimpleBus peripheral

> Would switching to Briey SoC (with Dcache, Icache, MMU, AXI bus) help reduce the IO overhead

Yes and no. Yes because it would avoid the shared memory bus issue, no because the way the d$ access MMIO is less dirrect and has additional penalities compared to the $less design..

I think the very best would realy be to use a custom instruction to drive some stream of data, if that's an option for you :)

wenwang3122, 2020-06-02:
Thank you for the feedback, that helps a lot in understanding the experimental results and I have a pretty good understanding about how to optimize the design now.

Closed 2020-06-02.

Thread 129 (2020-06-02):

Question about interrupts (CsrPlugin)

nickolasB1983, 2020-06-02:
Hi!

I'm trying to make external interrupts work with Murax configuration.
The problem is some of the generated interrupts are lost and the CPU doesn't jump to trap routine.
My knowledge of spinalHDL is quite poor. I'm just beginning to learn it. Most likely I configured the csr plugin in a wrong way, but unfortunately I can't understand what am I doing wrong.

As far as I can tell jumping to the trap routing depends on 3 conditions:
1. Interrupts should be enabled,
2. Interrupt condition should occure
3. The pipline should be empty?
It seems like the 3rd and 2nd condition may not simultaniously happen. The interrupt event may last for 1 or 2 cycles. But the 3rd condition may not hold during these cycles.

Apparently the interrupt condition is not saved in the system until the 3rd condition happen and this leads to a missed interrupt.

Am I getting it wrong?

Dolu1990, 2020-06-02:
Hi,

> 1) Interrupts should be enabled,

Yes, and you need to enable two flags for that in the CPU, mstatus.mie and mie.xxx

> 3) he pipline should be empty?

Yes so basicaly, the interrupt line should stay high, until the CPU clear the interrupt.
Are you doing some single cycle pulse as interrupts ?

nickolasB1983, 2020-06-02:
Thank you for your response,

Ok, I get it. However in this case I'm not sure how to prevent multiple entering of the ISR. What should be the correct sequence in this case ?
Save context -> Enter ISR -> disable interrupt in mie register for example -> perform necessary operations -> enable interrupt -> return from ISR -> restore context.

Is that correct?

Also, what is the minimum length of the interrupt signal to be registered for sure?

nickolasB1983, 2020-06-02:
Thanks all for help.
It is clear now

Closed 2020-06-02.

Thread 130 (2020-06-08):

Debug problem

PedroCarvalho64, 2020-06-08:
Hi hope everyone is alright. :)

I've been trying to use the debug plugin with the JTAG, when I launch my program without breakpoints the program executes without no problem but when I put a breakpoint I can use step by step but for example in a for loop the increment variable is not incrementing. I've tried to read the memory and write into memory it works without no problem but when I use gdb with step by step seems to not work... The example I used to use the debug plugin is from **VexRiscvAvalonWithIntegratedJtag** and I used the MURAX configuration for OpenOCD.
Is there something wrong with my configuration?
```scala
object GenCustomWithJTAG
{
    def main(args: Array[String])
    {
        val report = SpinalVerilog
        {
            //CPU configuration
            val cpuConfig = VexRiscvConfig(
                plugins = List
                (
                new IBusSimplePlugin(
                    resetVector = 0x00000000l,
                    cmdForkOnSecondStage = false,
                    cmdForkPersistence = false,
                    prediction = NONE,
                    catchAccessFault = false,
                    compressedGen = false
                ),
                new DBusSimplePlugin(
                    catchAddressMisaligned = false,
                    catchAccessFault = false
                ),
                new CsrPlugin(CsrPluginConfig.all(0x00000000l)),
                new DecoderSimplePlugin(
                    catchIllegalInstruction = false
                ),
                new RegFilePlugin(
                    regFileReadyKind = plugin.SYNC,
                    zeroBoot = false
                ),
                new IntAluPlugin,
                new SrcPlugin(
                    separatedAddSub = false,
                    executeInsertion = false
                ),
                new FullBarrelShifterPlugin(earlyInjection = false),
                new HazardSimplePlugin(
                    bypassExecute           = false,
                    bypassMemory            = false,
                    bypassWriteBack         = false,
                    bypassWriteBackBuffer   = false,
                    pessimisticUseSrc       = false,
                    pessimisticWriteRegFile = false,
                    pessimisticAddressMatch = false
                ),
                new BranchPlugin(
                    earlyBranch = false,
                    catchAddressMisaligned = false
                ),
                new DebugPlugin(ClockDomain.current.clone(reset = Bool().setName("debugReset"))),
                new YamlPlugin("cpu0.yaml")
                )
            )
            val cpu = new VexRiscv(cpuConfig)
            cpu.rework
            {
                for (plugin <- cpuConfig.plugins) plugin match
                {
                    case plugin : DebugPlugin   => plugin.debugClockDomain
                    {
                        plugin.io.bus.setAsDirectionLess()
                        val jtag = slave(Jtag())
                            .setName("jtag")
                        jtag <> plugin.io.bus.fromJtag()
                    }
                    case _  =>
                }
            }
            cpu.setDefinitionName("VexRiscVJTAG")
            cpu
        }
    }
}
```

Dolu1990, 2020-06-09:
Hi,

The configuration seem ok. To be sure, which version or branch of vexriscv are you using ? Because steps was broken a few months ago, fixed now.

PedroCarvalho64, 2020-06-09:
Yes, I've tested now with the current version and everything is working. It's been a while since I've pulled from VexRiscv because everything was working fine ^^.
Thank you.

fatalfeel, 2021-10-10:
> Yes, I've tested now with the current version and everything is working fine. It's been a while since I've pulled from VexRiscv because everything was working fine ^^. Thank you.

do you use external JTAG like jlink , ARM-JTAG-20-10 OLIMEX.
I want to try debug

fatalfeel, 2021-10-10:
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

sound a good news I want to try in BusBlaster Jtag debug Murax.
But I dout why the hardwareBreakpointCount in Murax.scala is 0
How can you set breakpoint hit on crt.S or hello_world.c, plz help

Pedroo64, 2021-10-10:
Ok.
- What is the output of OpenOCD?
- When you launch OpenOCD, are you passing tcl/interface/ftdi/dp_busblaster.cfg or tcl/interface/ftdi/dp_busblaster_kt-link.cfg instead of tcl/interface/ftdi/ft2232h_breakout.cfg
- I suppose you're running this [program](https://github.com/SpinalHDL/VexRiscv/blob/68e704f3092be640aa92c876cf78702a83167f94/src/main/c/murax/hello_world/src/main.c). When you load your executable and run without any breakpoint does [this message](https://github.com/SpinalHDL/VexRiscv/blob/68e704f3092be640aa92c876cf78702a83167f94/src/main/c/murax/hello_world/src/main.c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) prints in your ttyUSBX?

I never tried to debug with another JTAG interface but I think it's the same way as the JLink. When I debug with the JLink I launch OpenOCD with this line :
```sh
src/openocd -f tcl/interface/jlink.cfg -c 'set MURAX_CPU0_YAML ../VexRiscv/cpu0.yaml' -f tcl/target/murax.cfg
```

fatalfeel, 2021-10-10:
thanks u sir~~~
https://tomverbeure.github.io/2021/07/18/VexRiscv-OpenOCD-and-Traps.html
https://ithelp.ithome.com.tw/articles/10196583
they connect their jtag board outside and debug with gdb

I am not sure in atry A7 is using tcl/interface/ftdi/ft2232h_breakout.cfg

fatalfeel, 2021-10-10:
another question
how does Murax.c know the tap idcode in arty a7?

/root/riscv_cpu/VexRiscv/Murax.v
_zz_jtag_tap_tdoDr <= 32'h10001fff;

openocd murax.cfg
if { [info exists CPUTAPID] } {
   set _CPUTAPID $CPUTAPID
} else {
  # set useful default
   set _CPUTAPID 0x10001fff
}

fatalfeel, 2021-10-10:
Murax.v. found tap idcode now its in Jar file systemdebugger.scala

fatalfeel, 2021-10-10:
Ur document link is so good thanks a lot man

Pedroo64, 2021-10-10:
I have an Arty S7 but I use the JTAG externally using by connecting it to the JLink because I use most of the time Lattice FPGAs.

fatalfeel, 2021-10-10:
Many thanks many

fatalfeel, 2021-10-10:
in https://github.com/SpinalHDL/VexRiscv/tree/master/doc/nativeJtag
is my modify correct?

case plugin : DebugPlugin => plugin.debugClockDomain
{
resetCtrl.systemReset setWhen(RegNext(plugin.io.resetOut))
//io.jtag <> plugin.io.bus.fromJtag() //external jtag
//arty internal usb jtag: start
val jtagCtrl = JtagTapInstructionCtrl()
val tap = jtagCtrl.fromXilinxBscane2(userId = 2)
jtagCtrl <> plugin.io.bus.fromJtagInstructionCtrl(ClockDomain(tap.TCK))
//arty internal usb jtag: end
}

Closed 2020-06-09.

Thread 131 (2020-07-06):

A problem maybe while do plugin initialization

curliph, 2020-07-06:
I  try to build system based on vexriscv,  build I/D subsystem like below:
```
    val core = new ClockingArea(coreDomain) {
        val vexRiscVConfig = VexRiscvConfig(plugins = vexRiscVPlugins)
        val cpu = new VexRiscv(config = vexRiscVConfig)
        var iBus : Axi4ReadOnly = null
        var dBus : Axi4Shared = null
        for (plugin <- vexRiscVConfig.plugins) plugin match {
            case plugin : IBusSimplePlugin => iBus = plugin.iBus.toAxi4ReadOnly()
            case plugin : DBusSimplePlugin => dBus = plugin.dBus.toAxi4Shared()
            case plugin : CsrPlugin => {
                plugin.externalInterrupt := False
                plugin.timerInterrupt := False
            }
            case _ =>
        }
```
while run build,  got error message :
```
[info] ERROR !
[info] A null pointer access has been detected in the JVM.
[info] This could happen when in your SpinalHDL description, you access an signal which is only defined further.
[info] For instance :
[info]   val result = Bool
[info]   result := a ^ b  //a and b can't be accessed there because they are only defined one line below (Software rule of execution order)
[info]   val a,b = Bool
[info]
[error] Exception in thread "main" java.lang.NullPointerException
[error]         at blinky.Blinky$$anon$3$$anonfun$3.apply(Blinky.scala:108)
[error]         at blinky.Blinky$$anon$3$$anonfun$3.apply(Blinky.scala:107)
[error]         at scala.collection.mutable.ResizableArray$class.foreach(ResizableArray.scala:59)
[error]         at scala.collection.mutable.ArrayBuffer.foreach(ArrayBuffer.scala:48)
[error]         at blinky.Blinky$$anon$3.<init>(Blinky.scala:107)
[error]         at blinky.Blinky.<init>(Blinky.scala:102)
[error]         at blinky.BlinkyVerilog$$anonfun$main$1.apply(Blinky.scala:157)
[error]         at blinky.BlinkyVerilog$$anonfun$main$1.apply(Blinky.scala:157)
```
Note: Blinky.scala:108/107 is the line of code:
```
            case plugin : IBusSimplePlugin => iBus = plugin.iBus.toAxi4ReadOnly()
            case plugin : DBusSimplePlugin => dBus = plugin.dBus.toAxi4Shared()
```

I exactly known what the mean, but just do not known how to fix it.
What's wrong with me?

original design file comming from:
https://github.com/craigjb/riscv-blinky/blob/master/src/main/scala/blinky/Blinky.scala

Thanks,
Franz

franz-git, 2020-07-06:
Seems it's the problem caused by "build.sbt“ file configuration.
I get a copy from "spinalTemplateSbtDependencies” progect,  it works!
But I can not point why all this happen. :)
If anyone know how, please...

Thanks and best regards,

Dolu1990, 2020-07-06:
Hi,

Cool that you sorted it out ^^

How was your previous sbt file ?

franz-git, 2020-07-06:
Here is the original copy:

```
name := "riscv-blinky"

version := "0.1.0"

scalaVersion := "2.11.12"

libraryDependencies ++= Seq(
  "com.github.spinalhdl" % "spinalhdl-core_2.11" % "latest.release",
  "com.github.spinalhdl" % "spinalhdl-lib_2.11" % "latest.release"
)

fork := true

lazy val root = Project("root", file("."))
    .dependsOn(vexRiscV)
lazy val vexRiscV = RootProject(file("../VexRiscv"))
```

Dolu1990, 2020-07-06:
Hooo i think you were missing the dslPlugin in the buildsbt, that's likely the main issue

franz-git, 2020-07-06:
Thanks for your help.
B.T.W,  SpinalHDL, great work!

Closed 2020-07-06.

Thread 144 (2020-10-15):

Support for Privileged Architecture 1.10+

lindemer, 2020-10-15:
Zephyr RTOS is in the process of adding support for Physical Memory Protection (PMP), which was added to the RISC-V Privileged Architecture in version 1.10. VexRiscv is already supported by Zephyr, but I believe it's based on Privileged Architecture version 1.9. This means Zephyr's new memory protection features will not be compatible.

Is anyone still actively developing VexRiscv and/or planning to keep it up-to-date with the latest ISA specification?

Dolu1990, 2020-10-15:
First, disclamer :
To me, the PMP was always a optional feature, and i never keept track of the actual privileged architecture version, but implemented what was usefull / required for software to run (FreeRTOS, Zephyr, OpenSBI, Linux)

Do you know what would be the minimal number of PMP entry required by zephyr ?

> Is anyone still actively developing VexRiscv and/or planning to keep it up-to-date with the latest ISA specification?

I'm doing most of the dev on VexRiscv, basicaly, implementing a PMP shouldn't be complicated, for instance the MMU implemention is only 160 lines of code (https://github.com/SpinalHDL/VexRiscv/blob/6fc5406901fcd34d2fa166761a588fea1b38cddf/src/main/scala/vexriscv/plugin/MemoryTranslatorPlugin.scala)

but there are a few issues : I do not personnaly have any usage of the PMP, which mean i would not be able to actively use it / test it on real cases nor have a particular motivation to implement it. also i prefer to avoid implementing unused features for the healte of the project.

But if someone is interested and has personnal usage, i can help into the task with pointers and info :)
The plugin system of Vex should make the addition of such feature smooth and clean.

> up-to-date with the latest ISA specification?

In FPGA, the pursue of implementing all features of the spec can have a negative value, as it increase the CPU area and potentialy reduce FMax. All features which isn't vital should be implemented as optional, even if the spec say it is mandatory.

lindemer, 2020-10-15:
> Do you know what would be the minimal number of PMP entry required by zephyr ?

At minimum you need 3 entries to enable userspace threads, but if you want to have shared memory between threads you need 1 additional entry per region.

> But if someone is interested and has personnal usage, i can help into the task with pointers and info :)
The plugin system of Vex should make the addition of such feature smooth and clean.

Okay, great. I'll take a closer look at the existing plugins SpinalHDL documentation before I promise anything :)

Dolu1990, 2020-10-15:
> At minimum you need 3 entries to enable userspace threads, but if you want to have shared memory between threads you need 1 additional entry per region.

Ach, and the Zephyr port make it mandatory ?

> Okay, great. I'll take a closer look at the existing plugins and SpinalHDL documentation before I promise anything :)

Let's me know how things turn ^^

lindemer, 2020-10-15:
> Ach, and the Zephyr port make it mandatory ?

Oh no it's just going to be an optional feature for boards that have enough PMP registers. LiteX/VexRiscv aren't effected. (At the moment I think the only supported board is HiFive1.)

lindemer, 2020-10-20:
@Dolu1990 Just so you know I'm getting started on a PMP plugin now :) It's been a while since I've worked on a processor design so I can't give you a time estimate yet.

There's three different ways to do PMP addressing (NA4, NAPOT and TOR), but only the first two are required for Zephyr userspace. I don't have a use case for TOR addressing and it's much slower to compute than NAPOT (at least on the HiFive1 Rev B) so I may not implement support for it.

Dolu1990, 2020-10-20:
Hoo i didn't even know there was multiple PMP addressing XD

Thanks for the info ^^

Closed 2020-10-15.

Thread 149 (2020-11-11):

Error: dtmcontrol is 0. Check JTAG connectivity/board power.

usonix789, 2020-11-11:
use the Vexriscv,and generate the MuraxSOC(InitRam).running on FPGA board, the UART and GPIO(Blink led) are working.
when I use the openocd connect the core,
"Error: dtmcontrol is 0. Check JTAG connectivity/board power."

Licensed under GNU GPL v2
libusb1 09e75e98b4d9ea7909e8837b7a3f00dda4589dc3
For bug reports, read
        http://openocd.org/doc/doxygen/bugs.html
riscv.cpu
Info : Listening on port 6666 for tcl connections
Info : Listening on port 4444 for telnet connections
Error: libusb_open() failed with LIBUSB_ERROR_NOT_SUPPORTED
Info : clock speed 800 kHz
Info : JTAG tap: riscv.cpu tap/device found: 0x10001fff (mfg: 0x7ff (<invalid>), part: 0x0001, ver: 0x1)
Error: dtmcontrol is 0. Check JTAG connectivity/board power.
Info : starting gdb server for riscv.cpu on 3333
Info : Listening on port 3333 for gdb connections

Dolu1990, 2020-11-11:
Hi

Error: dtmcontrol is 0. Check JTAG connectivity/board power. seem to indicate that you are using the wrong openocd, did you used something else than https://github.com/SpinalHDL/openocd_riscv ?

Thread 153 (2020-12-01):

Add a new pipeline stage to VexRiscv

genesys2, 2020-12-01:
Hi,

I am trying to add a new pipeline stage between decode and execute to Vexriscv. In my understanding this should be possible by declaring a new stage in VexRiscv.scala and then writing a plugin to populate the stage with logic. The first step was to insert a dummy stage without any logic:

```
  //Define stages
  def newStage(): Stage = { val s = new Stage; stages += s; s }
  val decode    = newStage()
  val dummyStage = newStage()
  val execute   = newStage()
  val memory    = ifGen(config.withMemoryStage)    (newStage())
  val writeBack = ifGen(config.withWriteBackStage) (newStage())

  def stagesFromExecute = stages.dropWhile(_ != execute)
  ....
  dummyStage.arbitration.flushNext.noBackendCombMerge
```

This seems to work mostly fine, in the Traces you can see the dummy stage propagating the signals etc. However, the regression tests fail due to a false RegFile write, especially the signal `lastStageRegFileWrite_payload_data` seems to be false. Do you know why this is and where I need to make further changes?

Thanks a lot in advance!

Dolu1990, 2020-12-01:
Hi

Which VexRiscv configuration are you using ?
It is quite possible that some plugin do the assumption that execute follow decode.

All test fails ?

genesys2, 2020-12-02:
I was trying GenFull so that probably explains why. Do you have a rough idea how many of such dependecies there are and where they are located? Do you think it is possible to add a stage with reasonable effort?

Very few tests succeed, mostly the problem seems to be a RegFile write. So overall only 35 tests succed.

Dolu1990, 2020-12-02:
Hmm i think one big thing which is actualy a bit too much hardcoded in VexRiscv, is the HazardSimplePlugin, you can see in it it use explicit stages names to check.

One question is why do you want to add one stage between decode and execute ?
(Maybe there could be workarounds in the fetch stages)

genesys2, 2020-12-02:
I don't actually need another pipeline stage that does something meaningful, I just want to measure the performance impact of an ISA extension with a longer pipeline than 5 stages. Therefore, the idea was to add dummy stages to the design and thus emulate the behavior of a longer pipeline. Ideally, the dummy stages would be after decode and before branches are resolved.

If you're intrested, this is the project I am working on: https://arxiv.org/pdf/2007.15919.pdf

Dolu1990, 2020-12-02:
hmm, there would be a few workaround, basicaly, in the cacheless configuration you can add as many stage in the fetch with a integer parameter in the IBusSimplePlugin.

The IBusCachedPlugin also can be configured to range from 1 to 4 stages.
Hopefully that could help ?
BranchPlugin can also be set to branch in the execute or in the Memory stage.

genesys2, 2020-12-03:
Okay, thank you for your help! Probably the IBusCachedPlugin is a good approach, especially in combination with the early branch option.

Thank you! :)

Closed 2020-12-03.

Thread 156 (2020-12-10):

Upgrade to SpinalHDL 1.4.0 broke the LiteX build

lindemer, 2020-12-10:
The LiteX SoC sources build VexRiscv from an old commit which is specified [here](https://github.com/litex-hub/pythondata-auto/blob/4d7119eceb41bcb2b5e745d024e7c8a32215c196/modules.ini#L69). VexRiscv was upgraded to SpinalHDL 1.4.0 [on March 9](https://github.com/SpinalHDL/VexRiscv/commit/95237b23ea2d658cb3e0aa77680ca2851ef5d882) which appears to have broken the LiteX build script. The error is quite vague so I'm not the person to debug this:
```
[info] Running (fork) vexriscv.GenCoreDefault
[info] [Runtime] SpinalHDL v1.4.0    git head : ecb5a80b713566f417ea3ea061f9969e73770a7f
[info] [Runtime] JVM max memory : 2638.5MiB
[info] [Runtime] Current date : 2020.12.10 16:51:17
[info] [Progress] at 0.000 : Elaborate components
[info] ERROR !
[info] A null pointer access has been detected in the JVM.
[info] This could happen when in your SpinalHDL description, you access an signal which is only defined further.
[info] For instance :
[info]   val result = Bool
[info]   result := a ^ b  //a and b can't be accessed there because they are only defined one line below (Software rule of execution order)
[info]   val a,b = Bool
[info]
[error] Exception in thread "main" java.lang.NullPointerException
[error] 	at vexriscv.GenCoreDefault$$anonfun$main$1$$anonfun$apply$1$$anonfun$apply$mcV$sp$1.apply(GenCoreDefault.scala:241)
[error] 	at vexriscv.GenCoreDefault$$anonfun$main$1$$anonfun$apply$1$$anonfun$apply$mcV$sp$1.apply(GenCoreDefault.scala:235)
[error] 	at scala.collection.mutable.ResizableArray$class.foreach(ResizableArray.scala:59)
[error] Nonzero exit code returned from runner: 1
[error] (Compile / runMain) Nonzero exit code returned from runner: 1
[error] Total time: 8 s, completed Dec 10, 2020 4:51:17 PM
```

To reproduce this error:
1. Clone the [VexRiscv sources for LiteX](https://github.com/litex-hub/pythondata-cpu-vexriscv).
2. Replace `file("ext/VexRiscv")` [this line](https://github.com/litex-hub/pythondata-cpu-vexriscv/blob/master/pythondata_cpu_vexriscv/verilog/build.sbt) with `uri("https://github.com/SpinalHDL/VexRiscv.git#95237b23ea2d658cb3e0aa77680ca2851ef5d882")`.
3. Run `sbt clean reload && make && sbt "runMain vexriscv.GenCoreDefault"` from that directory.

The [previous commit to master](ttps://github.com/SpinalHDL/VexRiscv.git/commit/0c7556ad7fc874e296805cad856434d00b536005) does not have this problem.

Dolu1990, 2020-12-11:
Fixed with https://github.com/litex-hub/pythondata-cpu-vexriscv/commit/e93dd361ef3ae6341dbd1dee07e047ad67439474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

Basicaly, SpinalHDL 1.4.0 require a scala compiler plugin to be enabled in the build.sbt :)

lindemer, 2020-12-11:
Thanks :) That fixed the build error but I'm getting a new one. I created [a draft PR](https://github.com/litex-hub/pythondata-cpu-vexriscv/pull/9) in the LiteX cores repository detailing the error.

nickoe, 2021-05-03:
@lindemer Shouldn't this issue be closed by now?

Closed 2021-05-04.

Thread 157 (2020-12-11):

Number of Pipeline Stages in Different Configurations

rlipperts, 2020-12-11:
Good Morning,

In my master's thesis I'm developing a comparison framework for SoC and use LiteX SoCs and the Murax as examples. To describe the different VexRiscv configs used, I am currently building a table that outlines their features. However, I am stuck at determining the number of pipeline stages.

The readme describes VexRiscv as it supports 2-5+ stages. [VexRiscv.scala](https://github.com/SpinalHDL/VexRiscv/blob/master/src/main/scala/vexriscv/VexRiscv.scala)  always adds the two minimal stages
```
val decode    = newStage()
val execute   = newStage()
```
and per default adds two more
```
var withMemoryStage = true
var withWriteBackStage = true
```
From the [LiteX Configs](https://github.com/litex-hub/pythondata-cpu-vexriscv/blob/master/pythondata_cpu_vexriscv/verilog/src/main/scala/vexriscv/GenCoreDefault.scala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) I can see that certain plugins include additional stages. With four stages identified, it seems as if the Fetcher plugin introduces further stages, but I do not understand how exactly I can determine the final number.

In summary, I need to know how many stages the different configurations have. I'd like to understand how the different configurations and plugins influence it.

Thank you for your help!

Dolu1990, 2020-12-11:
> it seems as if the Fetcher plugin introduces further stages

Yes that's right. The fetcher plugin can expand the pipeline outside the VexRiscv pipeline API.

Basicaly, both IBusCachedPlugin and iBusSimplePlugin are using https://github.com/SpinalHDL/VexRiscv/blob/master/src/main/scala/vexriscv/plugin/Fetcher.scala#L14 which implement those additional pipeline stage and how to inject the instruction into the pipeline.

Number of stages added by the fetcher = cmdToRspStageCount + injectorStage

Then you can look into the IBusCachedPlugin for instance how it is called :
https://github.com/SpinalHDL/VexRiscv/blob/master/src/main/scala/vexriscv/plugin/IBusCachedPlugin.scala#L44

So one thing to keep in mind, is that from an architectural point of view, the first stage added by the fetcher do not realy count, as it is basicaly holding the PC state.
So cmdToRspStageCount + injectorStage - 1

rlipperts, 2020-12-14:
Thank you for your quick response :)

So the VexRiscv config used by Murax has the Decode and Execute state plus MemoryStage and Writeback stage as it does not override the defaults.

It [configures the IBusSimplePlugin](https://github.com/SpinalHDL/VexRiscv/blob/master/src/main/scala/vexriscv/plugin/IBusSimplePlugin.scala#L244) to have cmdToRspStageCount = [1](https://github.com/SpinalHDL/VexRiscv/blob/master/src/main/scala/vexriscv/plugin/IBusSimplePlugin.scala#L230) + [1](https://github.com/SpinalHDL/VexRiscv/blob/master/src/main/scala/vexriscv/demo/Murax.scala#L74). But there is also the [Injector](https://github.com/SpinalHDL/VexRiscv/blob/master/src/main/scala/vexriscv/plugin/IBusSimplePlugin.scala#L232) as third  stage which results in 4 + (3 - 1) = 6 stages for Murax.

Is this Correct?

Dolu1990, 2020-12-16:
Yes this seems correct to me, that was likely a way to relax the timings.

rlipperts, 2020-12-16:
Okay, then I have all i need.
Thank you again for your assistance.

Closed 2020-12-16.

Thread 159 (2020-12-17):

Context switching with only M/U modes is broken

lindemer, 2020-12-17:
A new `CsrPluginConfig` that generates only M and U mode was included with the new PMP plugin. https://github.com/SpinalHDL/VexRiscv/blob/d2855fcfca5410c6986b0c3e816cbb867e9b22b9/src/main/scala/vexriscv/plugin/CsrPlugin.scala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

This is used to instantiate a new core called `VexRiscv_Secure` in the LiteX source code [here](https://github.com/litex-hub/pythondata-cpu-vexriscv/blob/16c5dded21ca50b73a2bdafab10eeef2ca816818/pythondata_cpu_vexriscv/verilog/src/main/scala/vexriscv/GenCoreDef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). I'm using this core in LiteX to test Zephyr's userspace features, which require only M and U mode and at least 8 PMP registers. (It's quite complicated to replicate my setup so I won't bother explaining it.)

Zephyr fails to instantiate userspace threads because the CPU doesn't switch privilege levels when it should. I've ruled out the PMP plugin at this point because the same behavior occurs if I allow all accesses in the plugin source code.

Is it possible that the return-from-interrupt implementation is incorrect for builds with only M/U modes? It worked well enough to pass [the PMP plugin test](https://github.com/SpinalHDL/VexRiscv/blob/master/src/test/cpp/raw/pmp/src/crt.S), but Zephyr has nested traps, etc. so I could've missed something. The `XRET` implementation (below) looks correct but I don't quite understand the interrupt implementation.
https://github.com/SpinalHDL/VexRiscv/blob/d2855fcfca5410c6986b0c3e816cbb867e9b22b9/src/main/scala/vexriscv/plugin/CsrPlugin.scala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

Dolu1990, 2020-12-18:
hmmm so first which version of VexRIscv do you use exactly ? (hash)
Because i fixed a bug not so long ago that was hit in linux 5.0.10.

i'm not aware of anything else. Is it possible to run a sim with your setup ?
Debug thing with wave can realy help, debugging in a blackbox is hell ^^

> Zephyr has nested traps

Rawrrrrr. Never realy tried that in baremetal ^^

Another possibility, is that zephyr use a feature which isn't enabled / implemented in VexRiscv.

lindemer, 2020-12-18:
> hmmm so first which version of VexRIscv do you use exactly ? (hash)

Actually I'm using the latest hash because it's the only one with the PMP plugin 👽

> i'm not aware of anything else. Is it possible to run a sim with your setup ?
Debug thing with wave can realy help, debugging in a blackbox is hell ^^

I know 😭 I don't think I can track this down without GDB, but I can't find any good documentation on how to debug LiteX. I asked about this before I got started because I knew I'd end up here eventually 😅 (https://github.com/enjoy-digital/litex/issues/676). I haven't managed to learn any more about this since then. It seems clear that `lxsim` was designed for use with GDB but I can't find instructions anywhere.

Dolu1990, 2020-12-18:
hmmm, I'm not talking about GDB debugging, but realy hardware simulation, which produce a VCD file to look at the internal signals. Normaly, litex has support for verilator, isn't it ?

lindemer, 2020-12-18:
Yeah that's the `lxsim` command I'm referring to - it boots the SoC/CPU in Verilator and displays the BIOS interface. I'm pretty certain you can connect to this with GDB but it doesn't come with instructions. I think finding this bug with the VCD waveform would be  difficult since I don't know exactly which line triggers the bug.

Thread 165 (2021-02-13):

Instruction-address-misaligned trap not working on branch to odd address

jorisvr, 2021-02-13:
It looks like the BranchPlugin does not correctly generate *instruction-address-misaligned* traps in all cases where I expect them, even when `catchAddressMisaligned=true`.

I'm using the current github master 36b3cd918896c94c4e8a224d97c559ab6dbf3ec9 and configured with:
```
  new IBusSimplePlugin(
    resetVector = 0x80000000l,
    cmdForkOnSecondStage = true,
    cmdForkPersistence = false,
    prediction = STATIC,
    catchAccessFault = false,
    compressedGen = false
  ),
...
  new BranchPlugin(
    earlyBranch = true,
    catchAddressMisaligned = true
  ),
```

I test by running the following code:
```
80000000 <_start>:
80000000:  00000297  auipc t0,0x0
80000004:  01028293  addi  t0,t0,16 # 80000010 <loop>
80000008:  00128293  addi  t0,t0,1
8000000c:  00028067  jr    t0

80000010 <loop>:
80000010:  00100513  li    a0,1
80000014:  ffdff06f  j     80000010 <loop>

80000020 <__trap_vector>:
80000020:  00200513  li    a0,2
80000024:  ffdff06f  j     80000020 <__trap_vector>
```

In this case I would expect the `jr` instruction to trap because the target address is odd. However, the code runs as if the least significant address bit is ignored and ends up spinning in `loop`.

When I change the 3rd instruction of the above program to use branch offset +2 instead of +1, I do in fact get a trap as expected.

Looking at the source of BranchPlugin.scala, it seems to me that the least significant bit of the target address is simply ignored.

This issue may be related to #37 (I can't tell for sure, sorry if this is a duplicate).

Off-topic, I would like to say that I'm very happy with the VexRiscv.
It is so configurable that it fits exactly in my project, and it works absolutely fine. I'm not ready to use SpinalHDL for my own designs, but that is no problem because the generated VexRiscv model interfaces very nicely with my VHDL code.
I also love the concept of the *simple pipelined memory bus*. It is all so easy and pleasant to work with. Thanks!

Dolu1990, 2021-02-14:
Hi,

Hooo yes i agree, it "should" create an exception. The thing is that it is a weird case of the RISC-V spec which say for JALR :

> The indirect jump instruction JALR (jump and link register) uses the I-type encoding. The target
address is obtained by adding the sign-extended 12-bit I-immediate to the register rs1, then setting
the least-significant bit of the result to zero.

"then setting the least-significant bit of the result to zero" is the tricky thing :)

So to me, i think it follow the spec. but i agree it is weird XD

> Off-topic, I would like to say that I'm very happy with the VexRiscv.

Thanks :)

jorisvr, 2021-02-15:
Sorry, my mistake.

Thanks for explaining this part of the spec to me. I was actually hoping it would work this way, but I got confused by a different section of the spec. I see now that it is actually pretty clearly spelled out.

I'll close this issue then. Great work!

Closed 2021-02-15.

Thread 166 (2021-03-22):

A null pointer access has been detected in the JVM.

siluks-plumerai, 2021-03-22:
Hi Dolu, we are using vexriscv and it works really well! Actually this is first time I encountered problem I cannot solve on my own. Maybe you could help. I modified Briey demo. Everything was ok until I added `axiLiteMaster0` top interface connected directly to `dbus` in crossbar. So nothing complicated, but fails with below error. If comment out all references to `axiLiteMaster0` and `axiLiteMaster0Ctrl`  passes again. So its somehow related to this additional master interface. To reproduce just copy Briey.txt attached into current master tree Briey.scala and run compilation:
[Briey.txt](https://github.com/SpinalHDL/VexRiscv/files/6180629/Briey.txt)

```
slawek@solo:~/git/github/VexRiscv$ sbt "runMain vexriscv.demo.Briey"
[info] Loading settings for project vexriscv-build from plugins.sbt ...
[info] Loading project definition from /home/slawek/git/github/VexRiscv/project
[info] Loading settings for project root from build.sbt ...
[info] Set current project to VexRiscv (in build file:/home/slawek/git/github/VexRiscv/)
[warn] Multiple main classes detected.  Run 'show discoveredMainClasses' to see the list
[info] Running (fork) vexriscv.demo.Briey
[info] [Runtime] SpinalHDL v1.4.3    git head : adf552d8f500e7419fff395b7049228e4bc5de26
[info] [Runtime] JVM max memory : 7109.5MiB
[info] [Runtime] Current date : 2021.03.22 09:29:29
[info] [Progress] at 0.000 : Elaborate components
[info] PcManagerSimplePlugin is now useless
[info] ERROR !
[info] A null pointer access has been detected in the JVM.
[info] This could happen when in your SpinalHDL description, you access an signal which is only defined further.
[info] For instance :
[info]   val result = Bool
[info]   result := a ^ b  //a and b can't be accessed there because they are only defined one line below (Software rule of execution order)
[info]   val a,b = Bool
[info]   
[error] Exception in thread "main" java.lang.NullPointerException
[error]         at spinal.lib.bus.amba4.axi.Axi4SharedArbiter.<init>(Axi4Arbiter.scala:159)
[error]         at spinal.lib.bus.amba4.axi.Axi4CrossbarFactory$$anonfun$29$$anon$7.<init>(Axi4Crossbar.scala:253)
[error]         at spinal.lib.bus.amba4.axi.Axi4CrossbarFactory$$anonfun$29.apply(Axi4Crossbar.scala:252)
[error]         at spinal.lib.bus.amba4.axi.Axi4CrossbarFactory$$anonfun$29.apply(Axi4Crossbar.scala:188)
[error]         at scala.collection.TraversableLike$WithFilter$$anonfun$map$2.apply(TraversableLike.scala:683)
[error]         at scala.collection.mutable.ResizableArray$class.foreach(ResizableArray.scala:59)
[error]         at scala.collection.mutable.ArrayBuffer.foreach(ArrayBuffer.scala:48)
[error]         at scala.collection.TraversableLike$WithFilter.map(TraversableLike.scala:682)
[error]         at spinal.lib.bus.amba4.axi.Axi4CrossbarFactory.build(Axi4Crossbar.scala:188)
[error]         at vexriscv.demo.Briey$$anon$3.<init>(Briey.scala:431)
[error]         at vexriscv.demo.Briey.<init>(Briey.scala:280)
[error]         at vexriscv.demo.Briey$$anonfun$main$1.apply(Briey.scala:466)
[error]         at vexriscv.demo.Briey$$anonfun$main$1.apply(Briey.scala:465)
[error]         at spinal.core.internals.PhaseCreateComponent.impl(Phase.scala:2166)
[error]         at spinal.core.internals.PhaseContext.doPhase(Phase.scala:180)
[error]         at spinal.core.internals.SpinalVerilogBoot$$anonfun$singleShot$2$$anonfun$apply$117.apply(Phase.scala:2442)
[error]         at spinal.core.internals.SpinalVerilogBoot$$anonfun$singleShot$2$$anonfun$apply$117.apply(Phase.scala:2440)
[error]         at scala.collection.mutable.ResizableArray$class.foreach(ResizableArray.scala:59)
[error]         at scala.collection.mutable.ArrayBuffer.foreach(ArrayBuffer.scala:48)
[error]         at spinal.core.internals.SpinalVerilogBoot$$anonfun$singleShot$2.apply(Phase.scala:2440)
[error]         at spinal.core.internals.SpinalVerilogBoot$$anonfun$singleShot$2.apply(Phase.scala:2379)
[error]         at spinal.core.ScopeProperty$.sandbox(ScopeProperty.scala:31)
[error]         at spinal.core.internals.SpinalVerilogBoot$.singleShot(Phase.scala:2379)
[error]         at spinal.core.internals.SpinalVerilogBoot$.apply(Phase.scala:2349)
[error]         at spinal.core.Spinal$.apply(Spinal.scala:353)
[error]         at spinal.core.SpinalConfig.generateVerilog(Spinal.scala:160)
[error]         at vexriscv.demo.Briey$.main(Briey.scala:465)
[error]         at vexriscv.demo.Briey.main(Briey.scala)
[error] Nonzero exit code returned from runner: 1
[error] (Compile / runMain) Nonzero exit code returned from runner: 1
[error] Total time: 2 s, completed Mar 22, 2021 9:29:30 AM
slawek@solo:~/git/github/VexRiscv$
```

Dolu1990, 2021-03-22:
Hi,

You created a AXI4lite like bus from the regular AXI4 definition right ?
If yes, the interconnect assume there is a ID feature of the AXI is enabled. So i would say, set the Axi4Config.useId = true with idWidth=0

It should be fine then.
Tell me how it goes :)

siluks-plumerai, 2021-03-22:
Thanks a lot, that was fast! Setting useId fix the problem in source file provided.

Actually at begging I wanted to use AxiLIte4, but crossbar requires Axi4
```
[error] /home/slawek/git/github/VexRiscv/src/main/scala/vexriscv/demo/Briey.scala:376:26: type mismatch;
[error]  found   : (spinal.lib.bus.amba4.axilite.AxiLite4, (Long, scala.math.BigInt))
[error]  required: (spinal.lib.bus.amba4.axi.Axi4Bus, spinal.lib.bus.misc.SizeMapping)
[error]       axiLiteMaster0Ctrl -> (0x50000000L,   4 kB),
```

So i changed types (but not variable names) to Axi4 and encountered described problem.

By the way. Is worth to play with AxiLite4 at all?
- Should I use Axi4Shared internally, then cast to AxiLIte4 on i/o interface (if that possible)?
- Or better give up AxiLite4 at all and use Axi4 with burst, caches etc disabled?

Dolu1990, 2021-03-22:
> AxiLite4

Personnaly i never realy used it and instead used either APB3 for slave, either a simple AXI4 as master on which i drive things as if that was AxiLite4.

> Axi4Shared internally, then cast to AxiLIte4

I don't think there is such cast, i would say use directly Axi4Shared for you master instead.

> Or better give up AxiLite4 at all and use Axi4 with burst, caches etc disabled?

Right, i would go for that :)

siluks-plumerai, 2021-03-22:
Thank you for explanation

siluks-plumerai, 2021-04-08:
HI again @Dolu1990, one question regarding using AXI4 master with AXI4Lite external slave. Can I adjust .scala to use only burst len = 0? When I simply use `useLen = false` in *Axi4Config* connected to crossbar I get following error. Maybe you have some recommended solution to this?

```
[error] Exception in thread "main" spinal.core.SpinalExit:
[error]
[error] ********************************************************************************
[error] ********************************************************************************
[error] (toplevel/??? :  UInt[8 bits]) can't drive toplevel/[Axi4SharedArbiter]/io_sharedInputs_0_arw : Stream[Axi4Arw] because this last one doesn't has the corresponding pin
[error]     spinal.lib.bus.amba4.axi.Axi4Priv$.driveWeak(Axi4Channel.scala:226)
[error]     spinal.lib.bus.amba4.axi.Axi4Priv$.driveAx(Axi4Channel.scala:239)
[error]     spinal.lib.bus.amba4.axi.Axi4Arw$StreamPimper.drive(Axi4Channel.scala:279)
[error]     spinal.lib.bus.amba4.axi.Axi4Shared.$greater$greater(Axi4Shared.scala:20)
[error]     spinal.lib.bus.amba4.axi.Axi4Shared.$less$less(Axi4Shared.scala:18)
[error]     spinal.lib.bus.amba4.axi.Axi4CrossbarFactory$$anonfun$29$$anon$7$$anonfun$44.apply(Axi4Crossbar.scala:269)
[error]     spinal.lib.bus.amba4.axi.Axi4CrossbarFactory$$anonfun$29$$anon$7$$anonfun$44.apply(Axi4Crossbar.scala:268)
[error]     spinal.lib.bus.amba4.axi.Axi4CrossbarFactory$$anonfun$29$$anon$7.<init>(Axi4Crossbar.scala:268)
[error]     spinal.lib.bus.amba4.axi.Axi4CrossbarFactory$$anonfun$29.apply(Axi4Crossbar.scala:252)
[error]     spinal.lib.bus.amba4.axi.Axi4CrossbarFactory$$anonfun$29.apply(Axi4Crossbar.scala:188)
[error]     spinal.lib.bus.amba4.axi.Axi4CrossbarFactory.build(Axi4Crossbar.scala:188)
[error]     vexriscv.demo.Briey$$anon$3.<init>(Briey.scala:452)
[error]     vexriscv.demo.Briey.<init>(Briey.scala:291)
[error]     vexriscv.demo.Briey$$anonfun$main$1.apply(Briey.scala:493)
[error]     vexriscv.demo.Briey$$anonfun$main$1.apply(Briey.scala:492)
[error]     vexriscv.demo.Briey$.main(Briey.scala:492)
[error]     vexriscv.demo.Briey.main(Briey.scala)
```

siluks-plumerai, 2021-04-09:
Ive just realized that AXI master uses burst = 8 even when software reads only one data word

It just the same burst that is used by cpu dbus I guess.

So the only way to get burst=1 with axi master is to do axi->apb->axi conversions @Dolu1990 ?

Dolu1990, 2021-04-12:
I would say, your bridge from AxiLite to Axi should put the burst feature on the bus, and force it to 0 all the time. That way the Axi4SharedArbiter, which seems to do the assumption that the burst signal is used, will not crash

Dolu1990, 2021-04-12:
Same for the "last" pin feature, force it to 1 in the bridge

siluks-plumerai, 2021-04-13:
I decided to use external axi to axi lite adapter  https://github.com/alexforencich/verilog-axi/blob/master/rtl/axi_axil_adapter.v works well with vexriscv

but I will do more experiments with doing this inside scala

Closed 2021-04-13.

Thread 168 (2021-03-27):

Debuging Problems with compressed instructions

BLangOS, 2021-03-27:
I am evaluating the Debug Interface with a VHDL testbench. Everything works fine when I use the 32 Bit instruction encoding.
But when I used the compressed instruction set I get unexpected results when the instructions (compressed or not) are not word aligned.
Can the Debug Interface even used with compressed instructions?

Dolu1990, 2021-03-27:
> Can the Debug Interface even used with compressed instructions?

It can't, basicaly, the decompressor is at the end of the fetch stage, while the instruction injector is in the front of the decode stage

So, this is the expected behaviour

BLangOS, 2021-03-27:
Sorry, I did not ask my question precisely enough. Therefore I would like to ask again.
I stopped the processor via debug interface and then of course only injected 32-bit instructions to the debug interface. However, the interrupted program also contains compressed instructions; it was compiled using gcc with '-march = rv32ic'.
If the program was stopped accidentally on instructions with non-aligned word addresses, the processor crashed when I tried to continue the interrupted program via Step or Contiunue.
So my more precise question is whether debugging is possible with programs that have been compiled with the ISA extension '-march = rv32ic'. I suspect that doesn't work at the moment.

Dolu1990, 2021-03-29:
Hmm debugging with RVC isn't extensively tested, but should normaly work. What CPU configuration / SoC do you use ?

BLangOS, 2021-03-30:
Below you find I system that put together to make the error visible.

The system has the following address layout:
ROM: 0x80000000-0x80003FFF
RAM: 0x00000000-0x00000FFF (not used in the testbench)
PeripheralRegister: 0x00020000

The process called "ROM_RAM_and_Peripherals" describes ROM, RAM and a peripheral register. It cannot be synthesized.
Two test programs with the same functionality are available in the testbench. The difference is that in Program 2 most of the instructions are word-aligned, but in Program 1 they are not.

Both programs first load register t0 with 0x00020000 (address of "PeripheralRegister"), t1 with 1 and t2 with 0. Register t2 is then incremented 8 times in a loop. Then its value is written to the "PeripheralRegister" and thus made visible to the outside. This means that the values 0x00000008, 0x00000010, 0x00000018, ... must appear one after the other in the "PeripheralRegister".

The process, called "Debugging" serves the debug interface. After a delay, it halts the processor, then lets it take a step, and then lets the program resume. The delay is chosen so that the processor is halted during the Increment instructions which are not word-aligned in Program 1.
If Program 1 is selected, it can be seen that a bus error occurs on the instruction bus after the resume and the subsequent value of the "PeripheralRegister" is incorrect. Instead of 0x00000020, the value 0x0000001f appears in "PeripheralRegister" after the resume. Program 2, on the other hand, is processed without errors.
The timing below shows a simulation run with Program 1:
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

If the call of the "Step" function is removed in the "Debugging"-process, there is no error with either program. The program then always continues correctly after the resume.

The processor is a modified version of the VexRiscvAhbLite3, below I enclose its scala description "VexRiscvAhbLite3_bl.scala" and the generated "VexRisc.vhd". Further you will find my testbench "VexRiscv_AhbLite3_dbg_tb.vhd" and a script "VexRiscv_AhbLite3_dbg.do" for the ModelSim simulator (I use the Intel Edition).

Hope this will help.

[Debugging_Problem_Compressed.zip](https://github.com/SpinalHDL/VexRiscv/files/6227983/Debugging_Problem_Compressed.zip)

BLangOS, 2021-03-31:
Thank you very much for your very helpful explanations.

I do only partially understand the details of your explanation (at the moment I'm still a newbie to SpinalHDL) but I interpreted it in such a way that the decompressor's buffer is invalidated when a step command is issued. A subsequent jump to the current PC (which seems to be unnecessary from the programs point of view) then refills this buffer if necessary.

I intensively studied the source of the VexRiscv OpenOCD target code ([vexriscv.c](https://github.com/SpinalHDL/openocd_riscv/blob/riscv_spinal/src/target/vexriscv.c)) but could not find this requirement modelled in the code. Maybe this code currently cannot support compressed instructions, or maybe I overlooked the associated code lines.
Nervertheless I plan to use an own GDBServer and not OpenOCD for debugging with GDB and your explanations will help me to support compressed program code.

Due to your tricky hints I added two commands to the testbench after the step command. The first command reads the PC and the second command writes the just read value back to the PC. When writing the PC precisely a jump command is executed by means of injection. And now it works :-).

Below you find the modified testbench and here is the new timing diagram, which now shows the expected sequence:
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

I have taken note of your further explanations on systems with MMU and/or the DBusCachedPlugin with great interest, as soon as I find the time I will take a closer look.

Thank you again very much for your very helpful hints.

[Debugging_Compressed.zip](https://github.com/SpinalHDL/VexRiscv/files/6235628/Debugging_Compressed.zip)

Dolu1990, 2021-03-31:
> I intensively studied the source of the VexRiscv OpenOCD target code (vexriscv.c) but could not find this requirement modelled in the code.

I think it is likely done by :
https://github.com/SpinalHDL/openocd_riscv/blob/riscv_spinal/src/target/vexriscv.c#L742

> The first command reads the PC and the second command writes the just read value back to the PC. When writing the PC precisely a jump command is executed by means of injection. And now it works :-).

It may even be possible to just do a JAL relatif to the current PC, that way only one instruction is required to "reload" the pipeline.

But i think the best is to stay general and not try to trick things too much ^^

have fun :)

BLangOS, 2021-03-31:
Oh yes, now I see it. The PC is written when its image is valid, even if it is not dirty. Very good hidden.
Thanks :-)

BLangOS, 2021-03-31:
I tested `JAL x0,0` and it also works. Yes, thats much easier.
:-)

Closed 2021-03-31.

Thread 169 (2021-03-29):

Questions . How much the max frequency we can get for EC5G.

akshar001, 2021-03-29:
Hello,

I am totally new to this thing and want to learn most of this thing and have found your project amazing.

My question is what is the max clock we can get for SOCs if we use EC5G family of lattice.

It might be very basic question but thought of asking it here.

Dolu1990, 2021-03-29:
Hi,

Basicaly i do not have a flow for ECP5 FPGA, but i gess it is around the speed of a Cyclone V ?
I'm not sure.

akshar001, 2021-03-29:
Can we runt the cpu core at 1Ghz anyhow?

Dolu1990, 2021-03-29:
Only in simulation  ^^

On cheap FPGA you can run linux at 100 Mhz, probably with expensive FPGA you can go to 300-400 Mhz

akshar001, 2021-03-29:
What if we use external pll system and supply it to inner fpga system clock?

Dolu1990, 2021-03-29:
You will just make the logic go to fast and corrupt

akshar001, 2021-03-29:
Ohkay. So there is no way we can make them run faster. What's the bottleneck here?

Dolu1990, 2021-03-29:
CPU stall logic

akshar001, 2021-03-29:
Is there any other way we can make this faster?

Dolu1990, 2021-03-29:
cryo cooling ^^

akshar001, 2021-03-29:
haha, so ultimate way to make this things faster is to make our own fpga!

akshar001, 2021-03-29:
what we can do to avoid cpu stall logic?
Any pipeline related thing?

Dolu1990, 2021-03-29:
you can't realy avoid that in a pipelined CPU. things from down in the stge have to propagate up

akshar001, 2021-03-29:
XC7A35T-2CPG236C

This says it can run up to 450Mhz. Can we really do it?

Dolu1990, 2021-03-29:
The 450Mhz advertised is about the clock tree, as soon you chain logic it will fall down realy fast

Dolu1990, 2021-03-29:
that CPU in polarfire isn't part of the FPGA stuff, it's directly engraved in the silicon. that's why it is that fast

akshar001, 2021-03-29:
Yes saw that. there are many more eFPGA concepts are coming

akshar001, 2021-03-29:
I want to learn all this basic concepts and learn spinalhdl , can you guide me some way?

akshar001, 2021-03-29:
I want to make one open source cheap fpga board with quad core vexRISC-V , 1GB RAM,HDMI,USB,WIFI,ETHERNET everything. like in under 100$ i want to sell it! Would it be cool?

akshar001, 2021-03-31:
Okay! Wow! Let's get on with this!

akshar001, 2021-03-31:
I will need to give you 2-3 board at-least for testing!

Dolu1990, 2021-03-31:
> Hmm im working on having a USB host controller for linux <3

I mean that i'm already working on USB host for artyA7 and Ulx3s, could also be used for other boards

> I will need to give you 2-3 board at-least for testing!

I personnaly try to keep as few board as possible and avoid spliting my times on too many plateforms (as that's endless) XD

Please, if you bring a new board,  you have to port the SoC for it. I can help with informations.

akshar001, 2021-03-31:
Okay. I might be going to use ECP5  - 85F.
Later if we need to port your code, i will certainly do it.

akshar001, 2021-03-31:
So we will have 85F, DDR3 RAM 1 GB , RGMII ethernet , USB , UART , uSD CARD , WiFi/BLE in general in this board.
Plus flexible interface of making sub-modules , like USB expander o UART expander. I will be manufacturing this in India , so i can get most of the cost to very cheaper level , I want this board to be a super cheap so that so many people can use it.

akshar001, 2021-04-13:
@Dolu1990 have you ever used XC7K325T-2FFG900i

Dolu1990, 2021-04-13:
No, never used FPGA outside the low cost range.

akshar001, 2021-04-13:
I have purchased 2 of them. Let's see if i can make any board out of them. If we be able to make 400$ FPGA dev kit using this chip it would be good?

Dolu1990, 2021-04-13:
400 $ is realy much, also, is vivado free to use for such big FPGA ?
One thing (i think) is that i don't realy see a good usage of FPGA above 100K lut ^^
I mean, with what do you fill such FPGA ? (sure you can fill it with non-softcore-designed CPU)

akshar001, 2021-04-13:
Understood

Closed 2021-03-30.

Thread 170 (2021-03-30):

Linefill Question

openpowerwtf, 2021-03-30:
I'm starting to simulate a modified version of the core with caches enabled, and Litex-gen'd Wishbone/memory.  Instruction fetching works fine and some stores have completed, but the first data load hangs.  The IC/DC line loaders are operating differently (and logic is different because of stores/uncacheables).  The IC line loader goes valid at the start of the load sequence, but the DC line loader waits for all 8 commands to be sent before going valid; it only sees the last valid response, so the fill never completes.

Seems like I must have something configured incorrectly (or am completely confused 😕) .  Any ideas?

Dolu1990, 2021-03-30:
Hi,

Both cache have a different refill logic, both cache reschedule the instruction if there was a miss (refill then retry)

Hmm in your case, the data cache hang ?
That's weird, do you have a wave to share ?

openpowerwtf, 2021-03-30:
I know, this must be something basic.  This is my first FPGA-target/Wishbone attempt - I have gen'd bitstreams and blinked LEDs through CSR (code is in on-board 'ROM').   But before this, I have been doing simulation with the core+AXI (software AXI model).

_Unfortunately_ I'm doing some things non-VexRiscv-like 🤣:  the core doesn't run Risc V, its hacked into the Litex top-level, and I'm using Vivado for sim.  I broke a lot of stuff along the way but I don't think I touched much in the caches.

I think Vivado is supposed to be able to save to vcd.   I will attach a clip of a few signals in case there's something obvious (read @2000, which is uninitialized BRAM).

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

GrobiG, 2021-05-01:
I have experienced the same issue a few month back, I used the avalon example, I just needed a simple implementation no linux, mmu stuff, with the cached instructionfetcher and databus.
The non-cached versions wouldn't work at all.
The instructionfetcher worked fine reading and the databus worked in most cases fine writing but reading on the databus always returned a zero or bogus value.
I currently have no simulation screenshots available as I abandoned the project after two weeks of unsuccessfull trial and error and started to create my own risc-v soc designed especially to work with the avavalon fabric but it is lightyears away from what vexrisc-v could do but as vexrisc-v just does not work for me I basically had no ohther choice.

Dolu1990, 2021-05-01:
When you have issues with the bus you can send me the wave, i can easily check stuff and fix if i have access to a proper wave. From that point it is easy to figure out on which side stuff is turning bad.

GrobiG, 2021-05-30:
I found some time to re-create my test project and I am starting to think there is nothing wrong with the cache implementation, I am just setting it up wrong and I am making a big mistake with the static memory translator plugin.

In my setup I put "devices/pios" starting at address 0x0201 0000 and for those the databus cache should be bypassed, in the .scala file I have configured it like this:
```
          new DBusCachedPlugin(
            config = new DataCacheConfig(
              cacheSize         = 4096,
              bytePerLine       = 32,
              wayCount          = 1,
              addressWidth      = 32,
              cpuDataWidth      = 32,
              memDataWidth      = 32,
              catchAccessError  = true,
              catchIllegal      = true,
              catchUnaligned    = true
            ),
            memoryTranslatorPortConfig = null
          ),
          new StaticMemoryTranslatorPlugin(
            ioRange      = _(31 downto 25) === 0xFE
          ),
```
and that seems to be wrong.

In my program I am constantly reading from 0x02010040 and writing the returned value to 0x02010050, from what I can see in the simulation the databus_avalon interfaces read signal only gets asserted once and not on the following reads from 0x02010040 so I guess the other times it reads from the cache, which probably never again gets updated as I never write anything to that address.

What is the correct usage of the StaticMemoryTranslatorPlugin?

Dolu1990, 2021-05-31:
So, you want your uncached access to be at  0x02xx_xxxx right ?
Then you need  ioRange      = _(31 downto 25) === 0x02

Right ?

GrobiG, 2021-05-31:
Yes, correct, I would like everything starting from address 0x02010000 to be "uncached", I changed the config and now it works totally fine. Thank you a lot for that!!!

But is there any more documentation available regarding this except for:
"Static memory translator plugin which allows to specify which range of the memory addresses is I/O mapped and shouldn't be cached."
and every example which uses it configured it like "ioRange      = _(31 downto 28) === 0xF" which makes it kinda hard to guess how it works.

openpowerwtf, 2021-08-21:
I have created the same fail using an unmodified core, so I must be missing something in my process.  I did use this version as a guide when creating mine, so it's not surprising.  I still need to try a core like the one used for Linux-on-Litex.

I built:

```
sbt "runMain vexriscv.demo.VexRiscvCachedWishboneForSim"
```
and then ran a simple verilator sim, returning 'lw a0, 0(a0)' for instruction fetches.  I get 8 WB I reads (00:1C) and 8 WB D reads (00:1C), and loader_valid is stuck active, since the ack's are already consumed by the commands being sent.

Dolu1990, 2021-08-23:
@GrobiG
> But is there any more documentation available regarding this except for:

The doc is a bit lacking XD

> ...man I am such an idiot, I am sorry I have wasted your time with this.

No worries, the paradigme where you can give a landa function to a CPU parameter to specify how to implement address filtering isn't common :)

@openpowerwtf
Do you have a wave ? (VCD or FST) ?

openpowerwtf, 2021-08-24:
Yes, thanks for taking a look.  Every time I get back to looking at this, it seems like the logic is working as expected (obviously not!).
[
[gtkwave.zip](https://github.com/SpinalHDL/VexRiscv/files/7038773/gtkwave.zip)
](url)

Dolu1990, 2021-08-24:
@openpowerwtf Ahhh, the issue you have in the testbench is that you are providing the dbus_rsp before/durring consuming  the dbus_cmd transaction.

For it to work, you need to have dBusCmdMasterPipe turned on. I can just see now that the wishbone example in the repo do not turn it on XD (i just pushed a fix https://github.com/SpinalHDL/VexRiscv/commit/5c7e4a0294c785b58b424e49b4696855143370cb)

Did you had dBusCmdMasterPipe turned on in the DBusCachedPlugin ?

openpowerwtf, 2021-11-09:
Closing - running Litex BIOS and external RAM on cmod-A7 with PPC version of VexRiscv.

Closed 2021-11-09.

Thread 175 (2021-04-14):

Briey SoC (with SpinalHDL version >= 1.4.0) does not work anymore on Terasic De0-nano (Cyclone 4)

amitkulkarnis, 2021-04-14:
Hi,

I updated the Briey SoC by generating it with the current toolchain that uses SpinalHDL 1.4.3. I used the updated Briey.v in the FPGA project that is present on Google drive.
I observe that access to SDRAM is prohibited and the content of the SDRAM (after flashing the application elf file) still shows 0xfffffff.
PS: I have a copy of Briey.v generated using SpinalHDL 1.3.6 and works fine.
Can you please check if there is bug?
Thank you.

Dolu1990, 2021-04-15:
Hi
Does the simulation of Briey works for you ? (as described in the main readme) I tested that simulation not so long ago, it was fine for me.

I have to say i haven't use Briey since years.

What do you mean by " access to SDRAM is prohibited " ?

amitkulkarnis, 2021-04-16:
Hi,
Briey SoC on the current version of the toolchain works fine on simulation (VGA example).
However, when we use it with the Quartus project (https://drive.google.com/drive/folders/0B-CqLXDTaMbKZGdJZlZ5THAxRTQ?usp=sharing) by replacing the Briey.v (generated using current toolchain) we have the problem.
The problem is:
When I dump the *.elf file into the SDRAM (using riscv gdb), the contents of the SDRAM is always 0xffffffff. Hence the core does not respond when I try to run an application such as UART. This is what "access to SDRAM" means, the gdb cannot dump the application. The Briey.v (generated with the current toolchain) is not suitable with the Quartus project that you have provided.
Thanks.

Dolu1990, 2021-04-17:
Question :
Does Briey boot by himself ? i mean, without using the JTAG, are things fine ?
Does the io pin names still match between the old briey and the new briey ?

amitkulkarnis, 2021-04-19:
Hi,

1) No SoC does not respond well with/without JTAG.
2) There is one major change in the Briey SoC's IO:
old briey: "  output  io_sdram_DQ_writeEnable,"
new briey:   "output     [15:0]   io_sdram_DQ_writeEnable,"

Thanks.

Dolu1990, 2021-04-20:
Cool :D
> It would be great if you adopt this change in Scala source code for Briey.

Hmm i think i did io_sdram_DQ_writeEnable with one bit for each pin to help inferring the tristate enable register into the io primitive, so i would say the best would be to update the online projects to follow this new way of doing things. Does that seem fair ?

amitkulkarnis, 2021-04-20:
Yes, that would do.
I am attaching the top-level VHDL file to fix the problem.
[DE0_NANO.zip](https://github.com/SpinalHDL/VexRiscv/files/6345790/DE0_NANO.zip)

Dolu1990, 2021-04-20:
Thanks, i updated the de0_nano zip online :)

Closed 2021-04-20.

Thread 176 (2021-04-20):

When using DebugPlugin, don't halt CPU upon encountering EBREAK instruction

tomverbeure, 2021-04-20:
(Copying from [this gitter discussion](https://gitter.im/SpinalHDL/VexRiscv?at=607e37b855d78266a6564676))

Tom:

In the current DebugPlugin implementation, when the CPU encounters an EBREAK instructions, the processor halts unconditionally, even if there's no debugger attached.

I think this is a bit too aggressive. By default, the CPU should treat an EBREAK as [an illegal instruction and trap](https://groups.google.com/a/groups.riscv.org/d/msg/hw-dev/uNE1WL8svXs/vjy1AuN8FAAJ). And it should only halt the CPU when the debugger has been enabled. This way, a CPU doesn't hang upon encountering EBREAK.

The reason I would like this behavior is because it allows preventing CPU hangs due to semihosting calls, as implemented in [this ARM semihosting implementation](https://github.com/ErichStyger/mcuoneclipse/blob/06e3f4e3300ba73d9aaed43f662de427383354e1/Examples/MCUXpresso/i.MX%20RT1050_EVK/MIMXRT1052_LCD/source/semihost_hardfa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).

Doulu:

Yes that's right, that would be something to improve.

I think what we could do, is to add a register in the DebugPlugin which is set as soon one access is done on the debug port
If that register is set, then all ebreak will go to the DebugPlugin, else they are ignored
I think that would be the less intrusive and the lightest way to implement it.

Dolu1990, 2021-04-20:
@tomverbeure There is one implementation of it. It is in a separated branch for now. Let's me know if you give a try ^^

tomverbeure, 2021-04-21:
After starting at code and waveforms the whole evening, I've come to the conclusion that the DebugPlugin was doing the right thing all along. The key issue is that I didn't set `ebreakGen=true`. That is what resulted in no trap being generated...

With the old DebugPlugin code, I've tried these combinations:

**Situation 1: ebreakGen=false, no debugger attached**

EBREAK -> DebugPlugin.haltedByBreak goes high. CPU hangs.

**Situation 2: ebreakGen=true, no debugger attached**

EBREAK -> DebugPlugin.haltedByBreak stays low. CPU traps due to exception code 3.

**Situation 3: ebreakGen=true, debugger attached**

EBREAK -> DebugPlugin.haltedByBreak goes high. CPU stops at the EBREAK instruction and doesn't trap.

The way I understand it, the `haltIt` control bit was already doing what I was asking for: it's set by the OpenOCD, and when it's not set, and ebreakGen=true, then that EBREAK instruction traps as it should.

Sorry for wasting your time on this!

Dolu1990, 2021-04-21:
> The key issue is that I didn't set ebreakGen=true. That is what resulted in no trap being generated...

Hoo right, nearly all configuration do not enable CsrPlugin.ebreakGen XD

> Sorry for wasting your time on this!

no worries, it is good that now it allow having both CsrPlugin.ebreak and DebugPlugin ebreak in the same design ^^

So all good right now ?

tomverbeure, 2021-04-21:
> So all good right now ?

No need to make any changes to DebugPlugin.

However, for advanced VexRiscv demo configuration, I would set ebreakGen=true and ecallGen=true, especially for things like the Linux configuration etc. Because those are the kind of configuration where you'd expect people to write advanced trap routines for.

Closing.

Dolu1990, 2021-04-21:
> No need to make any changes to DebugPlugin.

Ahh you mean "Do not need to merge this branch into dev" ? or "All good can merge it" ? XD

> ebreakGen=true and ecallGen=true, for linux

Yes right, also, once i would like to try GDB debug a linux app via software ebreak :D

tomverbeure, 2021-04-21:
I mean: "Do not need to merge this branch into dev".

Tom

Dolu1990, 2021-04-21:
The thing is that without that patch, software ebreak aren't possible in machine mode if the DebugPlugin is in the design. As it will make the cpu hang, and jtag debug isn't possible in user/supervisor mode.

(Before this patch, the DebugPlugin listen to ebreak in machine mode only)

So as far as i can see, it is worth merging it into dev.

tomverbeure, 2021-04-21:
Ok. I have never used anything that exercises the different modes, so I can't give any feedback on this.

tomverbeure, 2021-04-22:
I understand things (even) better now...

In my earlier comment about things being fine, when the debugger was not enabled and ebreakGen=true, the CPU would indeed follow the trap, but my trap code was simply doing an endless loop. When the trap returns however (with MRET), it will still hang the CPU.

So your RTL fix is needed after all!

Closed 2021-04-21.

Thread 180 (2021-05-05):

Regression Test not all pass

EggerStephan, 2021-05-05:
Hello everyone,
i have a problem with the regression test
Here is my configuration

```
verilator --version
Verilator 4.202 2021-04-24 rev v4.202-4-g422c076f
```

```g++ --version
g++ (Ubuntu 9.3.0-17ubuntu1~20.04) 9.3.0
Copyright (C) 2019 Free Software Foundation, Inc.
This is free software; see the source for copying conditions.  There is NO
warranty; not even for MERCHANTABILITY or FITNESS FOR A PARTICULAR PURPOSE.
```

I build the GenFull demo with sbt

 ```
sbt "runMain vexriscv.demo.GenFull"
[info] Loading settings for project vexriscv-build from plugins.sbt ...
[info] Loading project definition from /home/eggerstephan/VexRiscvCoreProject/VexRiscv/project
[info] Updating ProjectRef(uri("file:/home/eggerstephan/VexRiscvCoreProject/VexRiscv/project/"), "vexriscv-build")...
[info] Done updating.
[warn] There may be incompatibilities among your library dependencies; run 'evicted' to see detailed eviction warnings.
[info] Loading settings for project root from build.sbt ...
[info] Set current project to VexRiscv (in build file:/home/eggerstephan/VexRiscvCoreProject/VexRiscv/)
[info] Updating ...
[info] Done updating.
[warn] There may be incompatibilities among your library dependencies; run 'evicted' to see detailed eviction warnings.
[info] Compiling 85 Scala sources to /home/eggerstephan/VexRiscvCoreProject/VexRiscv/target/scala-2.11/classes ...
[warn] /home/eggerstephan/VexRiscvCoreProject/VexRiscv/src/main/scala/vexriscv/demo/smp/VexRiscvSmpLitexMpCluster.scala:1:1:
[warn] Found names but no class, trait or object is defined in the compilation unit.
[warn] The incremental compiler cannot record the dependency information in such case.
[warn] Some errors like unused import referring to a non-existent class might not be reported.
[warn]
[warn] package vexriscv.demo.smp
[warn] ^
[warn] there were 35 deprecation warnings; re-run with -deprecation for details
[warn] there were two feature warnings; re-run with -feature for details
[warn] three warnings found
[info] Done compiling.
WARNING: An illegal reflective access operation has occurred
WARNING: Illegal reflective access by com.google.protobuf.UnsafeUtil (file:/home/eggerstephan/.sbt/boot/scala-2.12.7/org.scala-sbt/sbt/1.2.7/protobuf-java-3.3.1.jar) to field java.nio.Buffer.address
WARNING: Please consider reporting this to the maintainers of com.google.protobuf.UnsafeUtil
WARNING: Use --illegal-access=warn to enable warnings of further illegal reflective access operations
WARNING: All illegal access operations will be denied in a future release
[warn] Multiple main classes detected.  Run 'show discoveredMainClasses' to see the list
[info] Packaging /home/eggerstephan/VexRiscvCoreProject/VexRiscv/target/scala-2.11/vexriscv_2.11-2.0.0.jar ...
[info] Done packaging.
[info] Running (fork) vexriscv.demo.GenFull
[info] [Runtime] SpinalHDL v1.4.3    git head : adf552d8f500e7419fff395b7049228e4bc5de26
[info] [Runtime] JVM max memory : 1554.0MiB
[info] [Runtime] Current date : 2021.05.05 14:07:58
[info] [Progress] at 0.000 : Elaborate components
[info] [Progress] at 1.123 : Checks and transforms
[info] [Progress] at 1.621 : Generate Verilog
[info] [Warning] 201 signals were pruned. You can call printPruned on the backend report to get more informations.
[info] [Done] at 2.065
[success] Total time: 57 s, completed May 5, 2021, 2:08:00 PM
```

After that i start the regression test

```
 cd src/test/cpp/regression/
~/VexRiscvCoreProject/VexRiscv/src/test/cpp/regression$ make clean run
```
```
rm -rf obj_dir
cp ../../../../VexRiscv.v*.bin . | true
cp: cannot stat '../../../../VexRiscv.v*.bin': No such file or directory
verilator -cc  ../../../../VexRiscv.v  -O3 -CFLAGS -std=c++11 -LDFLAGS -pthread  -CFLAGS -DREGRESSION_PATH='\".//\"' -CFLAGS -DIBUS_CACHED -CFLAGS -DIBUS_DATA_WIDTH=32 -CFLAGS -DDBUS_DATA_WIDTH=32 -CFLAGS -DDBUS_CACHED -CFLAGS -DREDO=10 -CFLAGS -pthread -CFLAGS -Wno-unused-result -CFLAGS -DTHREAD_COUNT=8 -CFLAGS -O3  -O3 -CFLAGS -DTIMER_INTERRUPT -CFLAGS -DEXTERNAL_INTERRUPT -CFLAGS -DDHRYSTONE -CFLAGS -DSTALL=1 -CFLAGS -DCSR -CFLAGS -DISA_TEST -CFLAGS -DMMU -CFLAGS -DMUL -CFLAGS -DDIV -CFLAGS -DDEBUG_PLUGIN -CFLAGS -DDEBUG_PLUGIN_STD -CFLAGS -DTRACE_START=0 --gdbbt  -Wno-UNOPTFLAT -Wno-WIDTH --x-assign unique --exe main.cpp
No stack.
make  -j8 -C obj_dir/ -f VVexRiscv.mk VVexRiscv
make[1]: Entering directory '/home/eggerstephan/VexRiscvCoreProject/VexRiscv/src/test/cpp/regression/obj_dir'
ccache g++  -I.  -MMD -I/usr/local/share/verilator/include -I/usr/local/share/verilator/include/vltstd -DVM_COVERAGE=0 -DVM_SC=0 -DVM_TRACE=0 -DVM_TRACE_FST=0 -faligned-new -fcf-protection=none -Wno-bool-operation -Wno-sign-compare -Wno-uninitialized -Wno-unused-but-set-variable -Wno-unused-parameter -Wno-unused-variable -Wno-shadow     -std=c++11 -DREGRESSION_PATH=\".//\" -DIBUS_CACHED -DIBUS_DATA_WIDTH=32 -DDBUS_DATA_WIDTH=32 -DDBUS_CACHED -DREDO=10 -pthread -Wno-unused-result -DTHREAD_COUNT=8 -O3 -DTIMER_INTERRUPT -DEXTERNAL_INTERRUPT -DDHRYSTONE -DSTALL=1 -DCSR -DISA_TEST -DMMU -DMUL -DDIV -DDEBUG_PLUGIN -DDEBUG_PLUGIN_STD -DTRACE_START=0  -std=gnu++14 -Os -c -o main.o ../main.cpp
ccache g++  -I.  -MMD -I/usr/local/share/verilator/include -I/usr/local/share/verilator/include/vltstd -DVM_COVERAGE=0 -DVM_SC=0 -DVM_TRACE=0 -DVM_TRACE_FST=0 -faligned-new -fcf-protection=none -Wno-bool-operation -Wno-sign-compare -Wno-uninitialized -Wno-unused-but-set-variable -Wno-unused-parameter -Wno-unused-variable -Wno-shadow     -std=c++11 -DREGRESSION_PATH=\".//\" -DIBUS_CACHED -DIBUS_DATA_WIDTH=32 -DDBUS_DATA_WIDTH=32 -DDBUS_CACHED -DREDO=10 -pthread -Wno-unused-result -DTHREAD_COUNT=8 -O3 -DTIMER_INTERRUPT -DEXTERNAL_INTERRUPT -DDHRYSTONE -DSTALL=1 -DCSR -DISA_TEST -DMMU -DMUL -DDIV -DDEBUG_PLUGIN -DDEBUG_PLUGIN_STD -DTRACE_START=0  -std=gnu++14 -Os -c -o verilated.o /usr/local/share/verilator/include/verilated.cpp
ccache g++  -I.  -MMD -I/usr/local/share/verilator/include -I/usr/local/share/verilator/include/vltstd -DVM_COVERAGE=0 -DVM_SC=0 -DVM_TRACE=0 -DVM_TRACE_FST=0 -faligned-new -fcf-protection=none -Wno-bool-operation -Wno-sign-compare -Wno-uninitialized -Wno-unused-but-set-variable -Wno-unused-parameter -Wno-unused-variable -Wno-shadow     -std=c++11 -DREGRESSION_PATH=\".//\" -DIBUS_CACHED -DIBUS_DATA_WIDTH=32 -DDBUS_DATA_WIDTH=32 -DDBUS_CACHED -DREDO=10 -pthread -Wno-unused-result -DTHREAD_COUNT=8 -O3 -DTIMER_INTERRUPT -DEXTERNAL_INTERRUPT -DDHRYSTONE -DSTALL=1 -DCSR -DISA_TEST -DMMU -DMUL -DDIV -DDEBUG_PLUGIN -DDEBUG_PLUGIN_STD -DTRACE_START=0  -std=gnu++14 -Os -c -o verilated_dpi.o /usr/local/share/verilator/include/verilated_dpi.cpp
/usr/bin/perl /usr/local/share/verilator/bin/verilator_includer -DVL_INCLUDE_OPT=include VVexRiscv.cpp VVexRiscv_VexRiscv.cpp VVexRiscv__Dpi.cpp VVexRiscv__Slow.cpp VVexRiscv_VexRiscv__Slow.cpp VVexRiscv__Syms.cpp > VVexRiscv__ALL.cpp
ccache g++  -I.  -MMD -I/usr/local/share/verilator/include -I/usr/local/share/verilator/include/vltstd -DVM_COVERAGE=0 -DVM_SC=0 -DVM_TRACE=0 -DVM_TRACE_FST=0 -faligned-new -fcf-protection=none -Wno-bool-operation -Wno-sign-compare -Wno-uninitialized -Wno-unused-but-set-variable -Wno-unused-parameter -Wno-unused-variable -Wno-shadow     -std=c++11 -DREGRESSION_PATH=\".//\" -DIBUS_CACHED -DIBUS_DATA_WIDTH=32 -DDBUS_DATA_WIDTH=32 -DDBUS_CACHED -DREDO=10 -pthread -Wno-unused-result -DTHREAD_COUNT=8 -O3 -DTIMER_INTERRUPT -DEXTERNAL_INTERRUPT -DDHRYSTONE -DSTALL=1 -DCSR -DISA_TEST -DMMU -DMUL -DDIV -DDEBUG_PLUGIN -DDEBUG_PLUGIN_STD -DTRACE_START=0  -std=gnu++14 -Os -c -o VVexRiscv__ALL.o VVexRiscv__ALL.cpp
Archive ar -rcs VVexRiscv__ALL.a VVexRiscv__ALL.o
g++    main.o verilated.o verilated_dpi.o VVexRiscv__ALL.a   -pthread    -o VVexRiscv
make[1]: Leaving directory '/home/eggerstephan/VexRiscvCoreProject/VexRiscv/src/test/cpp/regression/obj_dir'
./obj_dir/VVexRiscv
BOOT
```
Then the test starts and get this message at the end
```
****************************************************************
Had simulate 2505307 clock cycles in 4.11657 s (608.591 Khz)
REGRESSION FAILURE 110/1094
****************************************************************
```

The errors are all the same
```
regFile write missmatch :
 REF: RF[1] = 0xffffffff
 DUT: RF[1] = 0x0
FAIL I-CSRRC-01 at PC=80000024 REF PC=80000024 REF I=3400b0f3 time=372
```
Am i missing a setting or something?
Thanks,

Stephan

Dolu1990, 2021-05-05:
Gen full isn't intended to pass all regression tests.

Normaly, it should pass all of  :
make clean run REDO=10 CSR=no MMU=no
Can you give a try ?

EggerStephan, 2021-05-06:
Thanks for the fast answer.
With this settings all tests passes

thanks for the help

Closed 2021-05-07.

Thread 185 (2021-06-08):

Core stuck at reset

aignacio, 2021-06-08:
Hey everyone,

I generated the core with the cfg **VexRiscvAxi4WithIntegratedJtag** available under `demo` folder and I'm integrating it into an AXI intcon. After connecting it all I'm seeing that the core seems to not start fetching instructions through the AXI4 IBus after the reset. I tried different set of combinations of not resetting the dbg logic and also the logic level of the JTAG pins but I had no luck with it, the core never asserts the ARValid pin of the bus...

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

can you explain what I'm missing on my setup?

here below is the core instantiation:
```verilog
module vexriscv_wrapper import ravenoc_pkg::*; (
  input                 clk,
  input                 arst,
  // I-bus
  input   s_axi_miso_t  ibus_axi_miso,
  output  s_axi_mosi_t  ibus_axi_mosi,
  // D-bus
  input   s_axi_miso_t  dbus_axi_miso,
  output  s_axi_mosi_t  dbus_axi_mosi,
  // JTAG
  input                 jtag_tms,
  input                 jtag_tdi,
  output                jtag_tdo,
  input                 jtag_tck
);

  VexRiscvAxi4 u_vexrv_core(
    .debug_resetOut            (),
    .timerInterrupt            ('0),
    .externalInterrupt         ('0),
    .softwareInterrupt         ('0),
    .iBusAxi_ar_valid          (ibus_axi_mosi.arvalid),
    .iBusAxi_ar_ready          ('1),
    .iBusAxi_ar_payload_addr   (ibus_axi_mosi.araddr),
    .iBusAxi_ar_payload_id     (ibus_axi_mosi.arid),
    .iBusAxi_ar_payload_region (ibus_axi_mosi.arregion),
    .iBusAxi_ar_payload_len    (ibus_axi_mosi.arlen),
    .iBusAxi_ar_payload_size   (ibus_axi_mosi.arsize),
    .iBusAxi_ar_payload_burst  (ibus_axi_mosi.arburst),
    .iBusAxi_ar_payload_lock   (ibus_axi_mosi.arlock),
    .iBusAxi_ar_payload_cache  (ibus_axi_mosi.arcache),
    .iBusAxi_ar_payload_qos    (ibus_axi_mosi.arqos),
    .iBusAxi_ar_payload_prot   (ibus_axi_mosi.arprot),
    .iBusAxi_r_valid           (ibus_axi_miso.rvalid),
    .iBusAxi_r_ready           (ibus_axi_mosi.rready),
    .iBusAxi_r_payload_data    (ibus_axi_miso.rdata),
    .iBusAxi_r_payload_id      (ibus_axi_miso.rid),
    .iBusAxi_r_payload_resp    (ibus_axi_miso.rresp),
    .iBusAxi_r_payload_last    (ibus_axi_miso.rlast),
    .dBusAxi_aw_valid          (dbus_axi_mosi.awvalid),
    .dBusAxi_aw_ready          (dbus_axi_miso.awready),
    .dBusAxi_aw_payload_addr   (dbus_axi_mosi.awaddr),
    .dBusAxi_aw_payload_id     (dbus_axi_mosi.awid),
    .dBusAxi_aw_payload_region (dbus_axi_mosi.awregion),
    .dBusAxi_aw_payload_len    (dbus_axi_mosi.awlen),
    .dBusAxi_aw_payload_size   (dbus_axi_mosi.awsize),
    .dBusAxi_aw_payload_burst  (dbus_axi_mosi.awburst),
    .dBusAxi_aw_payload_lock   (dbus_axi_mosi.awlock),
    .dBusAxi_aw_payload_cache  (dbus_axi_mosi.awcache),
    .dBusAxi_aw_payload_qos    (dbus_axi_mosi.awqos),
    .dBusAxi_aw_payload_prot   (dbus_axi_mosi.awprot),
    .dBusAxi_w_valid           (dbus_axi_mosi.wvalid),
    .dBusAxi_w_ready           (dbus_axi_miso.wready),
    .dBusAxi_w_payload_data    (dbus_axi_mosi.wdata),
    .dBusAxi_w_payload_strb    (dbus_axi_mosi.wstrb),
    .dBusAxi_w_payload_last    (dbus_axi_mosi.wlast),
    .dBusAxi_b_valid           (dbus_axi_miso.bvalid),
    .dBusAxi_b_ready           (dbus_axi_mosi.bready),
    .dBusAxi_b_payload_id      (dbus_axi_miso.bid),
    .dBusAxi_b_payload_resp    (dbus_axi_miso.bresp),
    .dBusAxi_ar_valid          (dbus_axi_mosi.arvalid),
    .dBusAxi_ar_ready          (dbus_axi_miso.arready),
    .dBusAxi_ar_payload_addr   (dbus_axi_mosi.araddr),
    .dBusAxi_ar_payload_id     (dbus_axi_mosi.arid),
    .dBusAxi_ar_payload_region (dbus_axi_mosi.arregion),
    .dBusAxi_ar_payload_len    (dbus_axi_mosi.arlen),
    .dBusAxi_ar_payload_size   (dbus_axi_mosi.arsize),
    .dBusAxi_ar_payload_burst  (dbus_axi_mosi.arburst),
    .dBusAxi_ar_payload_lock   (dbus_axi_mosi.arlock),
    .dBusAxi_ar_payload_cache  (dbus_axi_mosi.arcache),
    .dBusAxi_ar_payload_qos    (dbus_axi_mosi.arqos),
    .dBusAxi_ar_payload_prot   (dbus_axi_mosi.arprot),
    .dBusAxi_r_valid           (dbus_axi_miso.rvalid),
    .dBusAxi_r_ready           (dbus_axi_mosi.rready),
    .dBusAxi_r_payload_data    (dbus_axi_miso.rdata),
    .dBusAxi_r_payload_id      (dbus_axi_miso.rid),
    .dBusAxi_r_payload_resp    (dbus_axi_miso.rresp),
    .dBusAxi_r_payload_last    (dbus_axi_miso.rlast),
    .jtag_tms                  (jtag_tms),
    .jtag_tdi                  (jtag_tdi),
    .jtag_tdo                  (jtag_tdo),
    .jtag_tck                  (jtag_tck),
    .clk                       (clk),
    .reset                     (arst),
    .debugReset                ('0)
  );

endmodule
```

Dolu1990, 2021-06-08:
Hi,

Can you send me the wave file ?

Idealy in vcd or fst format ?

Thanks :)

Dolu1990, 2021-06-08:
Ahhh wait,
I guess your issue is that you do not put a reset on the debugReset. Basicaly, the reset module in VexRiscv is in a undefined state, which halt the pipeline.

Dolu1990, 2021-06-08:
In this waves.fst.zip, the CPU is fine so far, he is just cleaning the entry of the i$ (it take 256 cycles for your config)

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

If you run the sim futher, the CPU is still stuck ?

aignacio, 2021-06-08:
you're right @Dolu1990, tks now I see it moving after 200+ cc

Closed 2021-06-08.

Thread 187 (2021-06-11):

Illegal instruction exception

aignacio, 2021-06-11:
Hey @Dolu1990,

I'm using the cfg VexRiscvAxi4WithIntegratedJtag core and I'm seeing an illegal instruction exception when cache starts fetching first batch of instructions...I'm using the hello world program available also in VexRiscV repository. Can you take a look in the waves below and give me your opinion on that?
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
See the fst attached below. Also here's the assembly snippet that seems to be wrong:
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

[hello_world.zip](https://github.com/SpinalHDL/VexRiscv/files/6640225/hello_world.zip)
[waves.fst.zip](https://github.com/SpinalHDL/VexRiscv/files/6640223/waves.fst.zip)

Dolu1990, 2021-06-14:
Hi,

The issue seems to me to be in the memory interconnect or in the ram you read.

reason is that what the CPU read from its ibus do not match the assembly code :
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

aignacio, 2021-06-16:
Hi @Dolu1990,
tks again, I checked and my elf loader was broken, fixed and now the CPU is working fine. Last question, is that possible to generate the smallest CPU version with AXI4 I/F?

Dolu1990, 2021-06-18:
Hi,

> the smallest CPU version with AXI4 I/F

Yes it should be. there is a to toAxi4ReadOnly for the iBus and a  toAxi4Shared for the dbus. Then on that toAxi4Shared, you can do a toAxi4 to have a regular AXI

aignacio, 2021-06-20:
tks!!

Closed 2021-06-20.

Thread 193 (2021-08-26):

JTAG debugging is not working with cached configurations

nvitya, 2021-08-26:
Hi,

I like the VexRiscv CPU core, because it is easy to integrate and has a good performance.
I would like to use it like an ARM Cortex-M processor, programming over the JTAG debugger interface (load the program into RAM).

I managed to integrate the "VexRiscvAvalonWithIntegratedJtag.scala" version into the Altera/Intel Quartus QSYS.
If I modify the VexRiscvAvalonWithIntegratedJtag script to use the IBusSimplePlugin and the DBusSimplePlugin everything works fine.
With the IBusCachedPlugin and the DBusCachedPlugin the debugger goes crazy. After the first start I can not stop. If it is stopped after the first instruction stepping I loose the connection. Even the OpenOCD quits sometimes.
I also tried the Briey project directly (without QSYS, just a wrapper), the result is the same, program loading / debugging is impossible.

br,
nvitya

Dolu1990, 2021-08-28:
Hi,

about the read/write issues with the cached CPU that you have with the SDRAM.

Did you tested it with some onchip ram to check if that works ?

If there is a bug on the VexRiscv side of things i would say it is likely to be in the VexRiscv to Avalon bridges.
If you have a simulation wave where the issue occure, i can take a look into it without issue. a VCD or a FST file if possible

nvitya, 2021-08-28:
[vexrisctests.zip](https://github.com/SpinalHDL/VexRiscv/files/7071420/vexrisctests.zip)

Hi,

The project also contains 32k dual port onchip RAM. From that everything runs fine. The SW project (in the attachment) mainly runs from onchip RAM and tests the SDRAM reverse.

I've uploaded the projects with I've tested. I'm not very experienced writing simulations.
The board I was using is a QMTECH Cyclone IV Starter Kit, which is similar to DE0-Nano.
http://www.chinaqmtech.com/download_fpga
https://www.aliexpress.com/i/33007471265.html
I've used Quartus 20.1.1, but I've checked with 18.1 too.  You have to open the vexrv_sys.qsys with the platform manager and generate the HDL files first (they are big, I did not want to include).
The SW project was developed with Eclipse CDT with Eclipse Embedded CDT Plugins (https://eclipse-embed-cdt.github.io).
The build target / "board name" is C4_QSYS.
I've used the OpenOCD for debugging as you described. The JTAG was a D.P. Bus Blaster v4.1.

Dolu1990, 2021-08-31:
That is realy weird that with the cached version 16 bits backward accesses do not works XD

Can you show me the data that it read and what was expected ?

Also, which version of VexRiscv are you using ? (git commit or date)

nvitya, 2021-09-01:
The system was synthetised with 50 MHz to surely eliminate timing issues.
The memory is filled with increasing 16 bit numbers reverse, starting with 0x3344.
I've checked again, no errors with the O.C. RAM.

This is the head of the VexRiscvAvalon.v:
```
// Generator : SpinalHDL v1.6.0    git head : 73c8d8e2b86b45646e9d0b2e729291f2b65e6be3
// Component : VexRiscvAvalon
// Git hash  : 5fc4125763a1b66758c387c0abea32e602b2e4e5

```
```
$ git show
commit 5fc4125763a1b66758c387c0abea32e602b2e4e5 (HEAD -> master, origin/master, origin/HEAD)
Merge: 5f2fcc7 3028c19
Author: Dolu1990 <charles.papon.90@gmail.com>
Date:   Tue Jul 20 11:21:11 2021 +0200

    Merge branch 'dev'

```
Test code:
```
void test_sdram_16_reverse(unsigned tstcnt)
{
	TRACE("SDRAM-16-reverse test %u ...\r\n", tstcnt);

	unsigned t0, t1;
	uint32_t errcnt;

	uint16_t * dp;
	uint16_t * ep;
	uint16_t v, rv;

#if 1
	unsigned * start_addr = (unsigned *)SDRAM_BASE;
	unsigned len = 1 * 1024 * 1024;
#else
	unsigned * start_addr = (unsigned *)&testbuf;
	unsigned len = sizeof(testbuf);
#endif

	TRACE("  Filling...   ");

	t0 = CLOCKCNT;
	dp = (uint16_t *)start_addr;
	ep = dp + (len >> 1);
	v = (sdram_fill_start_value & 0xFFFF);
	while (dp < ep)
	{
		--ep;
		*ep = v;
		++v;
	}
	t1 = CLOCKCNT;

	TRACE("clocks: %u\r\n", t1 - t0);

	TRACE("  Comparing... \r\n");

	errcnt = 0;
	t0 = CLOCKCNT;
	dp = (uint16_t *)start_addr;
	ep = dp + (len >> 1);
	v = (sdram_fill_start_value & 0xFFFF);
	while (dp < ep)
	{
		--ep;
		rv = *ep;
		if (rv != v)
		{
			TRACE("ERR at 0x%08X = 0x%04X instead of 0x%04X !\r\n", unsigned(ep), rv, v);
			++errcnt;

			if (errcnt > 256)
			{
				break;
			}
		}
		++v;
	}
	t1 = CLOCKCNT;
	TRACE("clocks: %u\r\n", t1 - t0);

	if (errcnt)
	{
		TRACE("  !!! ERRORS = %u\r\n", errcnt);
	}
	else
	{
		TRACE("  ok.\r\n");
	}
}
```
Here are the first 256 errors:
```
ERR at 0x100FFFFE = 0x338B instead of 0x3344 !
ERR at 0x100FFFDE = 0x334B instead of 0x3354 !    <-- the previous 16 was ok !!!
ERR at 0x100FFFDC = 0x334B instead of 0x3355 !
ERR at 0x100FFFDA = 0x334B instead of 0x3356 !
ERR at 0x100FFFD8 = 0x334B instead of 0x3357 !
ERR at 0x100FFFD6 = 0x334B instead of 0x3358 !
ERR at 0x100FFFD4 = 0x334B instead of 0x3359 !
ERR at 0x100FFFD2 = 0x334B instead of 0x335A !
ERR at 0x100FFFD0 = 0x334B instead of 0x335B !
ERR at 0x100FFFCE = 0x334B instead of 0x335C !
ERR at 0x100FFFCC = 0x334B instead of 0x335D !
ERR at 0x100FFFCA = 0x334B instead of 0x335E !
ERR at 0x100FFFC8 = 0x334B instead of 0x335F !
ERR at 0x100FFFC6 = 0x334B instead of 0x3360 !
ERR at 0x100FFFC4 = 0x334B instead of 0x3361 !
ERR at 0x100FFFC2 = 0x334B instead of 0x3362 !
ERR at 0x100FFFC0 = 0x334B instead of 0x3363 !
ERR at 0x100FFFBE = 0x334B instead of 0x3364 !
ERR at 0x100FFF9E = 0x336B instead of 0x3374 !
ERR at 0x100FFF7E = 0x337B instead of 0x3384 !
ERR at 0x100FFF5E = 0x338B instead of 0x3394 !
ERR at 0x100FFF5C = 0x338B instead of 0x3395 !
ERR at 0x100FFF5A = 0x338B instead of 0x3396 !
ERR at 0x100FFF58 = 0x338B instead of 0x3397 !
ERR at 0x100FFF56 = 0x338B instead of 0x3398 !
ERR at 0x100FFF54 = 0x338B instead of 0x3399 !
ERR at 0x100FFF52 = 0x338B instead of 0x339A !
ERR at 0x100FFF50 = 0x338B instead of 0x339B !
ERR at 0x100FFF4E = 0x338B instead of 0x339C !
ERR at 0x100FFF4C = 0x338B instead of 0x339D !
ERR at 0x100FFF4A = 0x338B instead of 0x339E !
ERR at 0x100FFF48 = 0x338B instead of 0x339F !
ERR at 0x100FFF46 = 0x338B instead of 0x33A0 !
ERR at 0x100FFF44 = 0x338B instead of 0x33A1 !
ERR at 0x100FFF42 = 0x338B instead of 0x33A2 !
ERR at 0x100FFF40 = 0x338B instead of 0x33A3 !
ERR at 0x100FFF3E = 0x338B instead of 0x33A4 !
ERR at 0x100FFF3C = 0x338B instead of 0x33A5 !
ERR at 0x100FFF3A = 0x338B instead of 0x33A6 !
ERR at 0x100FFF38 = 0x338B instead of 0x33A7 !
ERR at 0x100FFF36 = 0x338B instead of 0x33A8 !
ERR at 0x100FFF34 = 0x338B instead of 0x33A9 !
ERR at 0x100FFF32 = 0x338B instead of 0x33AA !
ERR at 0x100FFF30 = 0x338B instead of 0x33AB !
ERR at 0x100FFF2E = 0x338B instead of 0x33AC !
ERR at 0x100FFF2C = 0x338B instead of 0x33AD !
ERR at 0x100FFF2A = 0x338B instead of 0x33AE !
ERR at 0x100FFF28 = 0x338B instead of 0x33AF !
ERR at 0x100FFF26 = 0x338B instead of 0x33B0 !
ERR at 0x100FFF24 = 0x338B instead of 0x33B1 !
ERR at 0x100FFF22 = 0x338B instead of 0x33B2 !
ERR at 0x100FFF20 = 0x338B instead of 0x33B3 !
ERR at 0x100FFF1E = 0x338B instead of 0x33B4 !
ERR at 0x100FFF1C = 0x338B instead of 0x33B5 !
ERR at 0x100FFF1A = 0x338B instead of 0x33B6 !
ERR at 0x100FFF18 = 0x338B instead of 0x33B7 !
ERR at 0x100FFF16 = 0x338B instead of 0x33B8 !
ERR at 0x100FFF14 = 0x338B instead of 0x33B9 !
ERR at 0x100FFF12 = 0x338B instead of 0x33BA !
ERR at 0x100FFF10 = 0x338B instead of 0x33BB !
ERR at 0x100FFF0E = 0x338B instead of 0x33BC !
ERR at 0x100FFF0C = 0x338B instead of 0x33BD !
ERR at 0x100FFF0A = 0x338B instead of 0x33BE !
ERR at 0x100FFF08 = 0x338B instead of 0x33BF !
ERR at 0x100FFF06 = 0x338B instead of 0x33C0 !
ERR at 0x100FFF04 = 0x338B instead of 0x33C1 !
ERR at 0x100FFF02 = 0x338B instead of 0x33C2 !
ERR at 0x100FFF00 = 0x338B instead of 0x33C3 !
ERR at 0x100FFEFE = 0x338B instead of 0x33C4 !
ERR at 0x100FFEFC = 0x338B instead of 0x33C5 !
ERR at 0x100FFEFA = 0x338B instead of 0x33C6 !
ERR at 0x100FFEF8 = 0x338B instead of 0x33C7 !
ERR at 0x100FFEF6 = 0x338B instead of 0x33C8 !
ERR at 0x100FFEF4 = 0x338B instead of 0x33C9 !
ERR at 0x100FFEF2 = 0x338B instead of 0x33CA !
ERR at 0x100FFEF0 = 0x338B instead of 0x33CB !
ERR at 0x100FFEEE = 0x338B instead of 0x33CC !
ERR at 0x100FFEEC = 0x338B instead of 0x33CD !
ERR at 0x100FFEEA = 0x338B instead of 0x33CE !
ERR at 0x100FFEE8 = 0x338B instead of 0x33CF !
ERR at 0x100FFEE6 = 0x338B instead of 0x33D0 !
ERR at 0x100FFEE4 = 0x338B instead of 0x33D1 !
ERR at 0x100FFEE2 = 0x338B instead of 0x33D2 !
ERR at 0x100FFEE0 = 0x338B instead of 0x33D3 !
ERR at 0x100FFEDE = 0x338B instead of 0x33D4 !
ERR at 0x100FFEDC = 0x338B instead of 0x33D5 !
ERR at 0x100FFEDA = 0x338B instead of 0x33D6 !
ERR at 0x100FFED8 = 0x338B instead of 0x33D7 !
ERR at 0x100FFED6 = 0x338B instead of 0x33D8 !
ERR at 0x100FFED4 = 0x338B instead of 0x33D9 !
ERR at 0x100FFED2 = 0x338B instead of 0x33DA !
ERR at 0x100FFED0 = 0x338B instead of 0x33DB !
ERR at 0x100FFECE = 0x338B instead of 0x33DC !
ERR at 0x100FFECC = 0x338B instead of 0x33DD !
ERR at 0x100FFECA = 0x338B instead of 0x33DE !
ERR at 0x100FFEC8 = 0x338B instead of 0x33DF !
ERR at 0x100FFEC6 = 0x338B instead of 0x33E0 !
ERR at 0x100FFEC4 = 0x338B instead of 0x33E1 !
ERR at 0x100FFEC2 = 0x338B instead of 0x33E2 !
ERR at 0x100FFEC0 = 0x338B instead of 0x33E3 !
ERR at 0x100FFEBE = 0x338B instead of 0x33E4 !
ERR at 0x100FFEBC = 0x338B instead of 0x33E5 !
ERR at 0x100FFEBA = 0x338B instead of 0x33E6 !
ERR at 0x100FFEB8 = 0x338B instead of 0x33E7 !
ERR at 0x100FFEB6 = 0x338B instead of 0x33E8 !
ERR at 0x100FFEB4 = 0x338B instead of 0x33E9 !
ERR at 0x100FFEB2 = 0x338B instead of 0x33EA !
ERR at 0x100FFEB0 = 0x338B instead of 0x33EB !
ERR at 0x100FFEAE = 0x338B instead of 0x33EC !
ERR at 0x100FFEAC = 0x338B instead of 0x33ED !
ERR at 0x100FFEAA = 0x338B instead of 0x33EE !
ERR at 0x100FFEA8 = 0x338B instead of 0x33EF !
ERR at 0x100FFEA6 = 0x338B instead of 0x33F0 !
ERR at 0x100FFEA4 = 0x338B instead of 0x33F1 !
ERR at 0x100FFEA2 = 0x338B instead of 0x33F2 !
ERR at 0x100FFEA0 = 0x338B instead of 0x33F3 !
ERR at 0x100FFE9E = 0x338B instead of 0x33F4 !
ERR at 0x100FFE7E = 0x33FB instead of 0x3404 !
ERR at 0x100FFE5E = 0x340B instead of 0x3414 !
ERR at 0x100FFE3E = 0x341B instead of 0x3424 !
ERR at 0x100FFE1E = 0x342B instead of 0x3434 !
ERR at 0x100FFDFE = 0x343B instead of 0x3444 !
ERR at 0x100FFDDE = 0x344B instead of 0x3454 !
ERR at 0x100FFDDC = 0x344B instead of 0x3455 !
ERR at 0x100FFDDA = 0x344B instead of 0x3456 !
ERR at 0x100FFDD8 = 0x344B instead of 0x3457 !
ERR at 0x100FFDD6 = 0x344B instead of 0x3458 !
ERR at 0x100FFDD4 = 0x344B instead of 0x3459 !
ERR at 0x100FFDD2 = 0x344B instead of 0x345A !
ERR at 0x100FFDD0 = 0x344B instead of 0x345B !
ERR at 0x100FFDCE = 0x344B instead of 0x345C !
ERR at 0x100FFDCC = 0x344B instead of 0x345D !
ERR at 0x100FFDCA = 0x344B instead of 0x345E !
ERR at 0x100FFDC8 = 0x344B instead of 0x345F !
ERR at 0x100FFDC6 = 0x344B instead of 0x3460 !
ERR at 0x100FFDC4 = 0x344B instead of 0x3461 !
ERR at 0x100FFDC2 = 0x344B instead of 0x3462 !
ERR at 0x100FFDC0 = 0x344B instead of 0x3463 !
ERR at 0x100FFDBE = 0x344B instead of 0x3464 !
ERR at 0x100FFDBC = 0x344B instead of 0x3465 !
ERR at 0x100FFDBA = 0x344B instead of 0x3466 !
ERR at 0x100FFDB8 = 0x344B instead of 0x3467 !
ERR at 0x100FFDB6 = 0x344B instead of 0x3468 !
ERR at 0x100FFDB4 = 0x344B instead of 0x3469 !
ERR at 0x100FFDB2 = 0x344B instead of 0x346A !
ERR at 0x100FFDB0 = 0x344B instead of 0x346B !
ERR at 0x100FFDAE = 0x344B instead of 0x346C !
ERR at 0x100FFDAC = 0x344B instead of 0x346D !
ERR at 0x100FFDAA = 0x344B instead of 0x346E !
ERR at 0x100FFDA8 = 0x344B instead of 0x346F !
ERR at 0x100FFDA6 = 0x344B instead of 0x3470 !
ERR at 0x100FFDA4 = 0x344B instead of 0x3471 !
ERR at 0x100FFDA2 = 0x344B instead of 0x3472 !
ERR at 0x100FFDA0 = 0x344B instead of 0x3473 !
ERR at 0x100FFD9E = 0x344B instead of 0x3474 !
ERR at 0x100FFD9C = 0x344B instead of 0x3475 !
ERR at 0x100FFD9A = 0x344B instead of 0x3476 !
ERR at 0x100FFD98 = 0x344B instead of 0x3477 !
ERR at 0x100FFD96 = 0x344B instead of 0x3478 !
ERR at 0x100FFD94 = 0x344B instead of 0x3479 !
ERR at 0x100FFD92 = 0x344B instead of 0x347A !
ERR at 0x100FFD90 = 0x344B instead of 0x347B !
ERR at 0x100FFD8E = 0x344B instead of 0x347C !
ERR at 0x100FFD8C = 0x344B instead of 0x347D !
ERR at 0x100FFD8A = 0x344B instead of 0x347E !
ERR at 0x100FFD88 = 0x344B instead of 0x347F !
ERR at 0x100FFD86 = 0x344B instead of 0x3480 !
ERR at 0x100FFD84 = 0x344B instead of 0x3481 !
ERR at 0x100FFD82 = 0x344B instead of 0x3482 !
ERR at 0x100FFD80 = 0x344B instead of 0x3483 !
ERR at 0x100FFD7E = 0x344B instead of 0x3484 !
ERR at 0x100FFD7C = 0x344B instead of 0x3485 !
ERR at 0x100FFD7A = 0x344B instead of 0x3486 !
ERR at 0x100FFD78 = 0x344B instead of 0x3487 !
ERR at 0x100FFD76 = 0x344B instead of 0x3488 !
ERR at 0x100FFD74 = 0x344B instead of 0x3489 !
ERR at 0x100FFD72 = 0x344B instead of 0x348A !
ERR at 0x100FFD70 = 0x344B instead of 0x348B !
ERR at 0x100FFD6E = 0x344B instead of 0x348C !
ERR at 0x100FFD6C = 0x344B instead of 0x348D !
ERR at 0x100FFD6A = 0x344B instead of 0x348E !
ERR at 0x100FFD68 = 0x344B instead of 0x348F !
ERR at 0x100FFD66 = 0x344B instead of 0x3490 !
ERR at 0x100FFD64 = 0x344B instead of 0x3491 !
ERR at 0x100FFD62 = 0x344B instead of 0x3492 !
ERR at 0x100FFD60 = 0x344B instead of 0x3493 !
ERR at 0x100FFD5E = 0x344B instead of 0x3494 !
ERR at 0x100FFD5C = 0x344B instead of 0x3495 !
ERR at 0x100FFD5A = 0x344B instead of 0x3496 !
ERR at 0x100FFD58 = 0x344B instead of 0x3497 !
ERR at 0x100FFD56 = 0x344B instead of 0x3498 !
ERR at 0x100FFD54 = 0x344B instead of 0x3499 !
ERR at 0x100FFD52 = 0x344B instead of 0x349A !
ERR at 0x100FFD50 = 0x344B instead of 0x349B !
ERR at 0x100FFD4E = 0x344B instead of 0x349C !
ERR at 0x100FFD4C = 0x344B instead of 0x349D !
ERR at 0x100FFD4A = 0x344B instead of 0x349E !
ERR at 0x100FFD48 = 0x344B instead of 0x349F !
ERR at 0x100FFD46 = 0x344B instead of 0x34A0 !
ERR at 0x100FFD44 = 0x344B instead of 0x34A1 !
ERR at 0x100FFD42 = 0x344B instead of 0x34A2 !
ERR at 0x100FFD40 = 0x344B instead of 0x34A3 !
ERR at 0x100FFD3E = 0x344B instead of 0x34A4 !
ERR at 0x100FFD3C = 0x344B instead of 0x34A5 !
ERR at 0x100FFD3A = 0x344B instead of 0x34A6 !
ERR at 0x100FFD38 = 0x344B instead of 0x34A7 !
ERR at 0x100FFD36 = 0x344B instead of 0x34A8 !
ERR at 0x100FFD34 = 0x344B instead of 0x34A9 !
ERR at 0x100FFD32 = 0x344B instead of 0x34AA !
ERR at 0x100FFD30 = 0x344B instead of 0x34AB !
ERR at 0x100FFD2E = 0x344B instead of 0x34AC !
ERR at 0x100FFD2C = 0x344B instead of 0x34AD !
ERR at 0x100FFD2A = 0x344B instead of 0x34AE !
ERR at 0x100FFD28 = 0x344B instead of 0x34AF !
ERR at 0x100FFD26 = 0x344B instead of 0x34B0 !
ERR at 0x100FFD24 = 0x344B instead of 0x34B1 !
ERR at 0x100FFD22 = 0x344B instead of 0x34B2 !
ERR at 0x100FFD20 = 0x344B instead of 0x34B3 !
ERR at 0x100FFD1E = 0x344B instead of 0x34B4 !
ERR at 0x100FFD1C = 0x344B instead of 0x34B5 !
ERR at 0x100FFD1A = 0x344B instead of 0x34B6 !
ERR at 0x100FFD18 = 0x344B instead of 0x34B7 !
ERR at 0x100FFD16 = 0x344B instead of 0x34B8 !
ERR at 0x100FFD14 = 0x344B instead of 0x34B9 !
ERR at 0x100FFD12 = 0x344B instead of 0x34BA !
ERR at 0x100FFD10 = 0x344B instead of 0x34BB !
ERR at 0x100FFD0E = 0x344B instead of 0x34BC !
ERR at 0x100FFD0C = 0x344B instead of 0x34BD !
ERR at 0x100FFD0A = 0x344B instead of 0x34BE !
ERR at 0x100FFD08 = 0x344B instead of 0x34BF !
ERR at 0x100FFD06 = 0x344B instead of 0x34C0 !
ERR at 0x100FFD04 = 0x344B instead of 0x34C1 !
ERR at 0x100FFD02 = 0x344B instead of 0x34C2 !
ERR at 0x100FFD00 = 0x344B instead of 0x34C3 !
ERR at 0x100FFCFE = 0x344B instead of 0x34C4 !
ERR at 0x100FFCFC = 0x344B instead of 0x34C5 !
ERR at 0x100FFCFA = 0x344B instead of 0x34C6 !
ERR at 0x100FFCF8 = 0x344B instead of 0x34C7 !
ERR at 0x100FFCF6 = 0x344B instead of 0x34C8 !
ERR at 0x100FFCF4 = 0x344B instead of 0x34C9 !
ERR at 0x100FFCF2 = 0x344B instead of 0x34CA !
ERR at 0x100FFCF0 = 0x344B instead of 0x34CB !
ERR at 0x100FFCEE = 0x344B instead of 0x34CC !
ERR at 0x100FFCEC = 0x344B instead of 0x34CD !
ERR at 0x100FFCEA = 0x344B instead of 0x34CE !
ERR at 0x100FFCE8 = 0x344B instead of 0x34CF !
ERR at 0x100FFCE6 = 0x344B instead of 0x34D0 !
ERR at 0x100FFCE4 = 0x344B instead of 0x34D1 !
ERR at 0x100FFCE2 = 0x344B instead of 0x34D2 !
ERR at 0x100FFCE0 = 0x344B instead of 0x34D3 !
ERR at 0x100FFCDE = 0x344B instead of 0x34D4 !
ERR at 0x100FFCDC = 0x344B instead of 0x34D5 !
ERR at 0x100FFCDA = 0x344B instead of 0x34D6 !
ERR at 0x100FFCD8 = 0x344B instead of 0x34D7 !
ERR at 0x100FFCD6 = 0x344B instead of 0x34D8 !
ERR at 0x100FFCD4 = 0x344B instead of 0x34D9 !
ERR at 0x100FFCD2 = 0x344B instead of 0x34DA !

```

Dolu1990, 2021-09-02:
So, i guess here we will need to either probe stuff with the altera signal tap 2, or to have a simulation running.

Would you be able to have one of those running ?
With singal tap 2, we could mesure the the data bus of the CPU, this would allow use to findout if the issue is in the CPU ore in the memory system.

nvitya, 2021-09-04:
This seems to be a QSYS SDRAM controller problem now, I open another issue with a sufficient name.

Closed 2021-09-04.

Thread 194 (2021-08-28):

Briey SoC is not debuggable over JTAG

nvitya, 2021-08-28:
Hi,

I've tested the Murax and the Briey SoCs.
I can upload and debug SW on the Murax (I've just increased the on chip RAM size to 32k).
The debugging does not work on the Briey. Sometimes after load you can step once or twice but then it does not stop.
The sw uploaded over JTAG definitely does not run.
I've tested with Cyclone IV E and Xilinx Atrix-7 too. I've even removed the VGA and SDRAM, the JTAG debugging still did not work.

It would be great if this worked. It is not so easy to create a proper multi-master bus crossbar. And the SDRAM definitely needs a cache system for the instruction fetching.

br.
nvitya

Dolu1990, 2021-08-31:
Hi,

One thing is, did you use the same cpu0.yaml in both test ? if yes, it is one issue.
(The one to use with the cached version need to have the instructions about how to flush the instruction cache)

Else, i'm not aware of any issue so far.

at which speed are you running briey and the JTAG ?

nvitya, 2021-09-01:
Hi,

The cpu0.yaml was always the same (the cached one):
```
debug: !!vexriscv.DebugReport {hardwareBreakpointCount: 0}
iBus: !!vexriscv.BusReport
  flushInstructions: [4111, 19, 19, 19]
  info: !!vexriscv.CacheReport {bytePerLine: 32, size: 4096}
  kind: cached
```
This worked with the Murax too.

Briey was running at 50 MHz.
The JTAG at 800 kHz.

Dolu1990, 2021-09-02:
Seems all good.

What board are you using for Atrix-7 ?
With some luck i have the same XD

nvitya, 2021-09-02:
I have this set:
https://de.aliexpress.com/item/32964497318.html?spm=a2g0o.store_pc_groupList.8148356.5.2b817fb297o38T

The resources including schematic can be donwloaded from here:
http://www.chinaqmtech.com/download_fpga
http://www.chinaqmtech.com/filedownload/38776

But I think any board is sufficient for this test.

Dolu1990, 2021-09-02:
I successfuly recreated some issues in simulation, i'm on it ^^

Dolu1990, 2021-09-02:
Issue fixed, that was the bridge from the dbus of the CPU to AXI which was picking a signal one stage above.
I pushed the fix to master  (https://github.com/SpinalHDL/VexRiscv/commit/cc9f3e753a2e1b7554e10bf43635f0d2b8afed82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)

Got

```shell
# Terminal 1
git clone https://github.com/SpinalHDL/VexRiscv.git
cd VexRiscv
sbt "runMain vexriscv.demo.Briey"
cd src/test/cpp/briey
make clean run

# Terminal 2
git clone https://github.com/SpinalHDL/openocd_riscv.git
cd openocd_riscv
./bootstrap
./configure --enable-ftdi --enable-dummy
make -j$(nproc)
src/openocd -f tcl/interface/jtag_tcp.cfg -c "set BRIEY_CPU0_YAML ../VexRiscv/cpu0.yaml" -f tcl/target/briey.cfg

# test 1 (was already OK)
telnet localhost 4444
> mdw 0x80000000 8
0x80000000: ???????? ????????????????????????
> mww 0x80000000 0x12345678
> mdw 0x80000000 8 
0x80000000: 12345678 ????????????????????????

# test 2 (that one was KO)
git clone https://github.com/SpinalHDL/VexRiscvSocSoftware.git
cd VexRiscvSocSoftware/projects/briey/
cd uart
make
riscv-none-embed-gdb build/uart.elf
target remote localhost:3333
set remotetimeout 60
set arch riscv:rv32
monitor reset halt
load
continue
```

Dolu1990, 2021-09-02:
Thanks for the issue report  :D

Closed 2021-09-02.

Thread 197 (2021-09-13):

Debug RV32IMC

aignacio, 2021-09-13:
Hey all,
is that possible to debug a RV32IMC VexRISC-V w/JTAG? I'm currently having an issue that when the core hits a non-aligned jumped it halts and connection is lost with the debug adapter...the same issue is not present when the program is compiled with march=rv32i...
```scala
package vexriscv.demo

import spinal.core._
import spinal.lib._
import spinal.lib.bus.avalon.AvalonMM
import spinal.lib.com.jtag.{Jtag, JtagTapInstructionCtrl}
import spinal.lib.eda.altera.{InterruptReceiverTag, QSysify, ResetEmitterTag}
import vexriscv.ip.{DataCacheConfig, InstructionCacheConfig}
import vexriscv.plugin._
import vexriscv.{VexRiscv, VexRiscvConfig, plugin}

object VexRiscvAxi4Jtag{
  def main(args: Array[String]) {
    val report = SpinalConfig(mode = if(args.contains("--vhdl")) VHDL else Verilog).generate{

      //CPU configuration
      val cpuConfig = VexRiscvConfig(
        plugins = List(
          new IBusSimplePlugin(
            resetVector = 0x80000000l,
            cmdForkOnSecondStage = false,
            cmdForkPersistence = true,
            prediction = STATIC,
            catchAccessFault = false,
            compressedGen = true
          ),
          new DBusSimplePlugin(
            catchAddressMisaligned = false,
            catchAccessFault = false
          ),
          new StaticMemoryTranslatorPlugin(
            ioRange      = _(31 downto 28) === 0xF
          ),
          new DecoderSimplePlugin(
            catchIllegalInstruction = true
          ),
          new RegFilePlugin(
            regFileReadyKind = plugin.SYNC,
            zeroBoot = false
          ),
          new IntAluPlugin,
          new SrcPlugin(
            separatedAddSub = false,
            executeInsertion = true
          ),
          new FullBarrelShifterPlugin,
          new MulPlugin,
          new DivPlugin,
          new HazardSimplePlugin(
            bypassExecute           = true,
            bypassMemory            = true,
            bypassWriteBack         = true,
            bypassWriteBackBuffer   = true,
            pessimisticUseSrc       = false,
            pessimisticWriteRegFile = false,
            pessimisticAddressMatch = false
          ),
          new DebugPlugin(ClockDomain.current.clone(reset = Bool().setName("debugReset"))),
          new BranchPlugin(
            earlyBranch = false,
            catchAddressMisaligned = true
          ),
          new CsrPlugin(
            config = CsrPluginConfig(
              catchIllegalAccess = false,
              mvendorid      = null,
              marchid        = null,
              mimpid         = null,
              mhartid        = null,
              misaExtensionsInit = 66,
              misaAccess     = CsrAccess.NONE,
              mtvecAccess    = CsrAccess.READ_WRITE,
              mtvecInit      = 0x00000020l,
              mepcAccess     = CsrAccess.READ_WRITE,
              mscratchGen    = false,
              mcauseAccess   = CsrAccess.READ_ONLY,
              mbadaddrAccess = CsrAccess.READ_ONLY,
              mcycleAccess   = CsrAccess.NONE,
              minstretAccess = CsrAccess.NONE,
              ecallGen       = false,
              wfiGenAsWait         = false,
              ucycleAccess   = CsrAccess.NONE,
              uinstretAccess = CsrAccess.NONE
            )
          ),
          new YamlPlugin("cpu0.yaml")
        )
      )

      //CPU instanciation
      val cpu = new VexRiscv(cpuConfig)

      //CPU modifications to be an AhbLite3 one
      cpu.rework {
        for (plugin <- cpuConfig.plugins) plugin match {
          case plugin: IBusSimplePlugin => {
            plugin.iBus.setAsDirectionLess() //Unset IO properties of iBus
            master(plugin.iBus.toAxi4ReadOnly()).setName("iBusAxi")
          }
          case plugin: DBusSimplePlugin => {
            plugin.dBus.setAsDirectionLess()
            master(plugin.dBus.toAxi4()).setName("dBusAxi")
          }
          case plugin: DebugPlugin => plugin.debugClockDomain {
            plugin.io.bus.setAsDirectionLess()
            val jtag = slave(new Jtag())
              .setName("jtag")
            jtag <> plugin.io.bus.fromJtag()
            plugin.io.resetOut
              .addTag(ResetEmitterTag(plugin.debugClockDomain))
              .parent = null //Avoid the io bundle to be interpreted as a QSys conduit
          }
          case _ =>
        }
      }
      cpu
    }
  }
}

```

Dolu1990, 2021-09-14:
Hi,

Yes it should normaly have worked. But at the same time you are using a configuration that i haven't tried before ( no cache + RVC + AXI), so there may be something there.

A few questions :
- Which git hash of VexRiscv / openocd_riscv are you using ?
- Is the CPU working with RVC (running a programm, not debugging it)
- Which SoC framework are you using ?

aignacio, 2021-09-14:
Hey @Dolu1990

thanks for reply, here're the answers:

**Which git hash of VexRiscv / openocd_riscv are you using ?**

**VexRiscv**
> d67fe72de9f5ce288f2667b150314c926f4bbf4d

**Riscv openocd - VexRISCV**
> c974c1b70348b59146bb87a1cfb829296240a509

**Is the CPU working with RVC (running a programm, not debugging it)**

> Yes, I tested the same program through Verilator model and it works fine

**Which SoC framework are you using ?**

> It's my own SoC, basically with the following cfg:
- Vex RISC-V core
- [AXI Slave] IRAM - 128KB
- [AXI Slave] DRAM - 128KB
- [AXI Slave] SPI Master
- AXI Interconnect

I'm attaching the debug files I'm using to launch the debug adapter..

[Archive.zip](https://github.com/SpinalHDL/VexRiscv/files/7164901/Archive.zip)

Dolu1990, 2021-09-15:
So, i tried compressed instruction debug on Briey without caches and it worked well as far as i tried. (on the dev branch)

So, i can see that the VexRiscv version that you are using is a bit old, and do not has a few fixes (ex : https://github.com/SpinalHDL/VexRiscv/commit/cc9f3e753a2e1b7554e10bf43635f0d2b8afed82)

Can you give a try with the last master version ? or if you can, with the dev branch ? (which require SpinalHDL dev branch cloned in the parent directory)

Dolu1990, 2021-09-15:
let's me know how things goes :)

aignacio, 2021-09-16:
Hey @Dolu1990,

I tried with the master branch update and still the same =/....here's the output of my openocd command with the GDB on the right side, I'm launching gdb with the connection+loading:
```bash
$(GDB) $(TARGET).elf -ex "target extended-remote localhost:3333" -ex "load"
```

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

It seems weird that after the load (and even if I load again the elf), the memory content doesn't change. I'm running the design on a Xilinx FPGA so I tried to also add the ILA probing the memory AXI interface signals and the trigger never hit because there are no transactions coming from the only AXI master in the interconnect (VexRISCV core) during gdb `load` command.

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

Dolu1990, 2021-09-17:
So, one thing that you can do to test things with a smaller eco system (no gdb complexity) is to use the openocd telnet directly

Then you can test basic operations with less overhead. Ex :
Read with mdw, write with mww.

mdw 0x80000000 8
mww 0x80000000 0x1234578
mdw 0x80000000 8

The issue is weird because the RVC nature of the programm should not interfer  if you just load the binary and check the memory content. So to be sure, can you confirm that if you keep the same RVC ready harwdare, but only change the compilation RVC flag it enable / disable the bug ?

Adding RVC capabilities to the hardware do make some decode path much longer. Are the FPGA timing passing the slack test ?

aignacio, 2021-09-17:
Timing is fine =), I'll another program just to see how it goes.
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

aignacio, 2021-09-17:
Hey @Dolu1990,

I tried again with/out the compressed instruction set and indeed I had the same behaviour, so I guess the first comment was a matter of luck =). So  I decided to take a different approach this time, building another vex core based on the demo example of VexRiscvAxi4wintegratedJtag that it's available in the master branch. This is the configuration I'm using now:
```scala
package vexriscv.demo

import spinal.core._
import spinal.lib._
import spinal.lib.bus.amba4.axi.Axi4ReadOnly
import spinal.lib.bus.avalon.AvalonMM
import spinal.lib.com.jtag.Jtag
import spinal.lib.eda.altera.{InterruptReceiverTag, QSysify, ResetEmitterTag}
import vexriscv.ip.{DataCacheConfig, InstructionCacheConfig}
import vexriscv.plugin._
import vexriscv.{VexRiscv, VexRiscvConfig, plugin}

/**
 * Created by spinalvm on 14.07.17.
 */
//class VexRiscvAvalon(debugClockDomain : ClockDomain) extends Component{
//
//}

object VexRiscvAxi4WithIntegratedJtag{
  def main(args: Array[String]) {
    val report = SpinalVerilog{

      //CPU configuration
      val cpuConfig = VexRiscvConfig(
        plugins = List(
          new PcManagerSimplePlugin(0x00000000l, false),
//          new IBusSimplePlugin(
//            interfaceKeepData = false,
//            catchAccessFault = false
//          ),
//          new DBusSimplePlugin(
//            catchAddressMisaligned = false,
//            catchAccessFault = false
//          ),
          new IBusCachedPlugin(
            prediction = STATIC,
            config = InstructionCacheConfig(
              cacheSize = 4096,
              bytePerLine =32,
              wayCount = 1,
              addressWidth = 32,
              cpuDataWidth = 32,
              memDataWidth = 32,
              catchIllegalAccess = true,
              catchAccessFault = true,
              asyncTagMemory = false,
              twoCycleRam = true,
              twoCycleCache = true
            ),
            compressedGen = true
            //            askMemoryTranslation = true,
            //            memoryTranslatorPortConfig = MemoryTranslatorPortConfig(
            //              portTlbSize = 4
            //            )
          ),
           new DBusSimplePlugin(
            catchAddressMisaligned = false,
            catchAccessFault = false
          ),
          //new DBusCachedPlugin(
            //config = new DataCacheConfig(
              //cacheSize         = 4096,
              //bytePerLine       = 32,
              //wayCount          = 1,
              //addressWidth      = 32,
              //cpuDataWidth      = 32,
              //memDataWidth      = 32,
              //catchAccessError  = true,
              //catchIllegal      = true,
              //catchUnaligned    = true
            //),
            //memoryTranslatorPortConfig = null
            ////            memoryTranslatorPortConfig = MemoryTranslatorPortConfig(
            ////              portTlbSize = 6
            ////            )
          //),
          new StaticMemoryTranslatorPlugin(
            ioRange      = _(31 downto 28) === 0xF
          ),
          new DecoderSimplePlugin(
            catchIllegalInstruction = true
          ),
          new RegFilePlugin(
            regFileReadyKind = plugin.ASYNC,
            zeroBoot = false
          ),
          new IntAluPlugin,
          new SrcPlugin(
            separatedAddSub = false,
            executeInsertion = true
          ),
          new FullBarrelShifterPlugin,
          new MulPlugin,
          new DivPlugin,
          new HazardSimplePlugin(
            bypassExecute           = true,
            bypassMemory            = true,
            bypassWriteBack         = true,
            bypassWriteBackBuffer   = true,
            pessimisticUseSrc       = false,
            pessimisticWriteRegFile = false,
            pessimisticAddressMatch = false
          ),
          new DebugPlugin(ClockDomain.current.clone(reset = Bool().setName("debugReset"))),
          new BranchPlugin(
            earlyBranch = false,
            catchAddressMisaligned = false
          ),
          new CsrPlugin(
            config = CsrPluginConfig(
              catchIllegalAccess = false,
              mvendorid      = null,
              marchid        = null,
              mimpid         = null,
              mhartid        = null,
              misaExtensionsInit = 66,
              misaAccess     = CsrAccess.NONE,
              mtvecAccess    = CsrAccess.NONE,
              mtvecInit      = 0x00000020l,
              mepcAccess     = CsrAccess.READ_WRITE,
              mscratchGen    = false,
              mcauseAccess   = CsrAccess.READ_ONLY,
              mbadaddrAccess = CsrAccess.READ_ONLY,
              mcycleAccess   = CsrAccess.NONE,
              minstretAccess = CsrAccess.NONE,
              ecallGen       = false,
              wfiGenAsWait         = false,
              ucycleAccess   = CsrAccess.NONE,
              uinstretAccess = CsrAccess.NONE
            )
          ),
          new YamlPlugin("cpu0.yaml")
        )
      )

      //CPU instanciation
      val cpu = new VexRiscv(cpuConfig)

      //CPU modifications to be an Avalon one
      cpu.setDefinitionName("VexRiscvAxi4")
      cpu.rework {
        var iBus : Axi4ReadOnly = null
        for (plugin <- cpuConfig.plugins) plugin match {
          case plugin: IBusSimplePlugin => {
            plugin.iBus.setAsDirectionLess() //Unset IO properties of iBus
            iBus = master(plugin.iBus.toAxi4ReadOnly().toFullConfig())
              .setName("iBusAxi")
              .addTag(ClockDomainTag(ClockDomain.current)) //Specify a clock domain to the iBus (used by QSysify)
          }
          case plugin: IBusCachedPlugin => {
            plugin.iBus.setAsDirectionLess() //Unset IO properties of iBus
            iBus = master(plugin.iBus.toAxi4ReadOnly().toFullConfig())
              .setName("iBusAxi")
              .addTag(ClockDomainTag(ClockDomain.current)) //Specify a clock domain to the iBus (used by QSysify)
          }
          case plugin: DBusSimplePlugin => {
            plugin.dBus.setAsDirectionLess()
            master(plugin.dBus.toAxi4Shared().toAxi4().toFullConfig())
              .setName("dBusAxi")
              .addTag(ClockDomainTag(ClockDomain.current))
          }
          case plugin: DBusCachedPlugin => {
            plugin.dBus.setAsDirectionLess()
            master(plugin.dBus.toAxi4Shared().toAxi4().toFullConfig())
              .setName("dBusAxi")
              .addTag(ClockDomainTag(ClockDomain.current))
          }
          case plugin: DebugPlugin => plugin.debugClockDomain {
            plugin.io.bus.setAsDirectionLess()
            val jtag = slave(new Jtag())
              .setName("jtag")
            jtag <> plugin.io.bus.fromJtag()
            plugin.io.resetOut
              .addTag(ResetEmitterTag(plugin.debugClockDomain))
              .parent = null //Avoid the io bundle to be interpreted as a QSys conduit
          }
          case _ =>
        }
        for (plugin <- cpuConfig.plugins) plugin match {
          case plugin: CsrPlugin => {
            plugin.externalInterrupt
              .addTag(InterruptReceiverTag(iBus, ClockDomain.current))
            plugin.timerInterrupt
              .addTag(InterruptReceiverTag(iBus, ClockDomain.current))
          }
          case _ =>
        }
      }
      cpu
    }
  }
}
```
The changes I made compared to the file that comes in `src/main/scala/vexriscv/demo/VexRiscvAxi4WithIntegratedJtag.scala` are:
1) Removed the cache on the dbus I/F (it was causing the core to dispatch axi bursts when writing to my peripherals, what's not supported);
2) Changed regFile plugin to use ASYNC instead of SYNC once based on a previous ticket you mention it's not compatible;
3) Added compressedGen = true to the configuration;

The issue that I'm having still persists, I can start debugging but sometimes it drops in the first step or sometimes when there's a jump in the first instructions...

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

Searching through the issues it seems pretty much like this guy comment:
https://github.com/SpinalHDL/VexRiscv/issues/194
```
...Sometimes after load you can step once or twice but then it does not stop.
```
At least now I've tried to write to the peripherals through GDB and it's working, I'm not sure what I'm missing here to make it work...do you have a configuration with the following features tested?

1) debug pluggin - jtag
2) AXI4
3) compressedGen = true

If so I can try to run another synthesis using this core and see how it goes. Another funny aspect of this issue is that through my simulations (which I don't use JTAG, I load by dpi methods the fw) all the cores I've tried so far are working perfectly....

Ps.: When using dbusCachedPlugin is there a way to force the cache to not dispatch a burst during reads/writes?

Dolu1990, 2021-09-17:
> Removed the cache on the dbus I/F (it was causing the core to dispatch axi bursts when writing to my peripherals, what's not supported); /// Ps.: When using dbusCachedPlugin is there a way to force the cache to not dispatch a burst during reads/writes?

You can adjust ioRange      = _(31 downto 28) === 0xF    to specify which address range should be accessed by the CPU in a non bursted  and uncached mode.   _ represent the address and then you can do what ever test on it which return true when is should be unbursted and uncached

> do you have a configuration with the following features tested?

Yes, the ones which run linux with fpu and all those things, but that's a bit heavy.
You can try the Briey config.  which is composed of the followed plugins :
https://github.com/SpinalHDL/VexRiscv/blob/master/src/main/scala/vexriscv/demo/Briey.scala#L53
+ https://github.com/SpinalHDL/VexRiscv/blob/master/src/main/scala/vexriscv/demo/Briey.scala#L290

You will have to turn one RVC in the IBusCachedPlugin and turn the registerfile to ASYNC. That's the config i tested the other days with debug.

If you want there is also some verilator code to connect openocd to the simulation :)

aignacio, 2021-09-17:
Thanks for quick reply, I'll for sure take this cfgs!, can you tell me more about this way of connecting openocd with verilator? All my sys are using verilator =)

Dolu1990, 2021-09-17:
so, for the openocd -> verilator :
https://github.com/SpinalHDL/VexRiscv/blob/master/src/test/cpp/briey/main.cpp#L379
https://github.com/SpinalHDL/VexRiscv/blob/master/src/test/cpp/common/jtag.h

Basicaly, this is based on a little abstraction layer above verilator which allow the tick function to be rescheduled in a future time :
https://github.com/SpinalHDL/VexRiscv/blob/master/src/test/cpp/common/jtag.h#L174

Else, there is the equivalent in SpinalSim (may help to understand) :
https://github.com/SpinalHDL/SpinalHDL/blob/b42ad071474c2042bf13d9ff30147b0e378b322d/lib/src/main/scala/spinal/lib/com/jtag/sim/JtagTcp.scala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

Dolu1990, 2021-09-17:
Then instead of using your jtag adapter script for openocd, you can use  tcl/interface/jtag_tcp.cfg

aignacio, 2021-09-18:
Thanks @Dolu1990,

I finally found the issue, the problem was related to the SPI Master peripheral once by default the clk generation was wrong causing the CTS (clock tree synthesis) of the FPGA to be unbalanced and holding it low for some clk cycles, putting then the vex core into an unknown state, to find the issue I tweak the peripheral before launching the program to run and it worked. Eventually it was impossible to see this scenario through verilator because there's no fanout in the clk there =)

Dolu1990, 2021-09-18:
Hoo cool :)

gg ^^

Saqlinahamad, 2021-12-03:
Hi @Dolu1990 @aignacio
My problem is also same and had raised a new issue in repo
Please just check and help accordingly to the issue🙂

Closed 2021-09-18.

Thread 198 (2021-09-19):

Briey Soc: Framebuffer display flickered

jmio, 2021-09-19:
Hi.

I am using the Briey SoC included in the demo with an Anlogic EG4S20 (Sipeed Tang Primer board), clocked at 50MHz.
[Briey SoC on Sipeed Tang Primer](https://github.com/jmio/testvex)

With the 2de35e6 version, the FPGA's internal SDRAM could be assigned to the frame buffer (16bpp, 800x480pixel), which was displayed on the LCD without any problem.

However, when I updated VexRiscv to version 68e704f and regenerated Briey.v, the CPU seemed to be working fine, but the framebuffer display flickered.
Also, in Anlogic TD5.0.3, the "Max Freq" after logic synthesis dropped from about 70MHz to about 51MHz.

Are there any changes you made?

Dolu1990, 2021-09-22:
Hi,

There is quite a few changes  in the SpinalHDL lib. For the VGA, especialy https://github.com/SpinalHDL/SpinalHDL/commit/c95d5d6bafa78b07341fd9063eb6c12be36e8f17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

which ensure that the frame buffer is properly aligned to the vertical sync. So far i didn't had issue with it, but it is possible that in your case it trip on something

Can you give a try with that commit reversed ?

Else, it maybe due to a lack of memory bandwidth (due to some interconnect update in the AXI stuff)

> about 70MHz to about 51MHz.

This maybe due to a change of the AXI interconnect default pipelining.

Can you send me the timing analysis report from the place and route flow ? Then i can check out where the issue is.

Dolu1990, 2021-09-22:
I may have reproduce you flikering issue in simulation ^^
I'm checking it now

Dolu1990, 2021-09-22:
The VGA issue is now fixed ^^
You need to use SpinalHDL dev  with Vexriscv dev  for it to work.

Still, let's me know the timings issues you had.

jmio, 2021-09-22:
Hello.

Thank you for your answer.
I have uploaded two timing reports.
[with 2de35e6 51MHz](https://github.com/jmio/testvex/blob/main/Timing143.txt)
[with 68e704f 71MHz](https://github.com/jmio/testvex/blob/dev160/Timing160.txt)
Is this file correct?

Thank you for finding the problem while I was writing my reply.

I'll try the dev build now.

Dolu1990, 2021-09-22:
I just pushed one fix in dev, i had some debug stuff in the briey config that i comited by accident. So, if you was trying the new dev, you need to pull it again XD

Sorry (This isn't related to your initial issue)

About your configuration, you enabled compressed instruction right ?

If so, one good thing to improve timings is to turn on the IBusCachedPlugin injectorStage to true.

I'm currently running some synthesis FMax regressions to see if i can see some patterns there XD

jmio, 2021-09-22:
Please tell me.
How do I change the Spinal HDL used by VexRiscv to a dev branch?

Dolu1990, 2021-09-22:
Ahhh so basicaly, if you want to use VexRiscv / SpinalHDL dev, you need to clone them both in a directory.

Then VexRiscv will implicitly use ../SpinalHDL  (https://github.com/SpinalHDL/VexRiscv/blob/dev/build.sbt#L20)

So nothing to change on your side, just getting the right branches

jmio, 2021-09-22:
Thank you.
I did not know how it worked.

Dolu1990, 2021-09-22:
no worries ^^

jmio, 2021-09-22:
I tried a dev build.
I tried both without and with "injectorStage = true", and in both cases, TD stopped with an error.
[ErrorLog](https://github.com/jmio/testvex/blob/dev160/ErrorLog.txt)

Dolu1990, 2021-09-22:
Ahhh damned, seems like there is some inferation issues ?

```
+-------------------------------------------------------------------------------+
|Instance          |Module              |lut    |ripple |seq    |bram   |dsp    |
+-------------------------------------------------------------------------------+
|top               |top                 |26252  |964    |3720   |11     |4      |
|  u_briey         |Briey               |25625  |830    |3370   |8      |4      |
|    axi_core_cpu  |VexRiscv            |4393   |426    |1189   |4      |4      |
|    axi_sdramCtrl |Axi4SharedSdramCtrl |245    |47     |292    |0      |0      |
|      ctrl        |SdramCtrl           |197    |27     |258    |0      |0      |
|    jtagBridge_1  |JtagBridge          |59     |0      |123    |0      |0      |
+-------------------------------------------------------------------------------+

```

There is a lot of LUT used somewere, probably some ram not being infered as fpga ram block ?
There was a little change in the way ram were emited by SpinalHDL it maybe that

Dolu1990, 2021-09-22:
Do you have a more detailed hearchy report ? seems like it is missing quite a few components.

Dolu1990, 2021-09-22:
Ahhh seems like many ram are infered as distributed ram :

SYN-1027 : Infer Logic DRAM(al_ram_ways_0_tags) read 128x22, write 128x22
SYN-1023 : Infer 1 Logic DRAMs, 1 Logic BRAMs.
SYN-1016 : Merged 2 instances.
SYN-1025 : Merged 1 RAM ports.
SYN-1027 : Infer Logic DRAM(al_ram_ways_0_data_symbol0) read 1024x8, write 1024x8
SYN-1027 : Infer Logic DRAM(al_ram_ways_0_data_symbol1) read 1024x8, write 1024x8
SYN-1027 : Infer Logic DRAM(al_ram_ways_0_data_symbol2) read 1024x8, write 1024x8
SYN-1027 : Infer Logic DRAM(al_ram_ways_0_data_symbol3) read 1024x8, write 1024x8
SYN-1027 : Infer Logic DRAM(al_ram_ways_0_tags) read 128x22, write 128x22
SYN-1023 : Infer 5 Logic DRAMs, 0 Logic BRAMs.
SYN-1016 : Merged 23 instances.
SYN-1027 : Infer Logic DRAM(al_ram_ram_symbol0) read 8192x8, write 8192x8
SYN-1027 : Infer Logic DRAM(al_ram_ram_symbol1) read 8192x8, write 8192x8
SYN-1027 : Infer Logic DRAM(al_ram_ram_symbol2) read 8192x8, write 8192x8
SYN-1027 : Infer Logic DRAM(al_ram_ram_symbol3) read 8192x8, write 8192x8
SYN-1023 : Infer 4 Logic DRAMs, 0 Logic BRAMs.
SYN-1016 : Merged 9 instances.
SYN-1027 : Infer Logic DRAM(al_ram_ram_symbol0) read 4096x8, write 4096x8
SYN-1027 : Infer Logic DRAM(al_ram_ram_symbol1) read 4096x8, write 4096x8
SYN-1027 : Infer Logic DRAM(al_ram_ram_symbol2) read 4096x8, write 4096x8
SYN-1027 : Infer Logic DRAM(al_ram_ram_symbol3) read 4096x8, write 4096x8
SYN-1023 : Infer 4 Logic DRAMs, 0 Logic BRAMs.

that's likely part of the issue.

jmio, 2021-09-22:
Thank you for your answer. It has stopped with an error, so this is all the log I have.

jmio, 2021-09-22:
If there is anything I can try, please let me know.

Dolu1990, 2021-09-22:
Could you try with keep_hierarchy enabled ? This may preserve a better hearchical report, which would point out the issue more accuratly.

Dolu1990, 2021-09-22:
I suspect that if you replace
https://github.com/SpinalHDL/SpinalHDL/blob/dev/core/src/main/scala/spinal/core/internals/ComponentEmitterVerilog.scala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
to
https://github.com/SpinalHDL/SpinalHDL/blob/dev/core/src/main/scala/spinal/core/internals/ComponentEmitterVerilog.scala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
by

```
                emitClockedProcess((tab, b) => {
                  val symbolCount = memReadWrite.mem.getMemSymbolCount()
                  b ++= s"${tab}if(${emitExpression(memReadWrite.chipSelect)}) begin\n"
                  emitRead(b, memReadWrite.mem, memReadWrite.address, memReadWrite, tab + "  ")
                  b ++= s"${tab}end\n"
                }, null, tmpBuilder, memReadWrite.clockDomain, false)

                emitClockedProcess((tab, b) => {
                  val symbolCount = memReadWrite.mem.getMemSymbolCount()
                  emitWrite(b, memReadWrite.mem,s"${emitExpression(memReadWrite.chipSelect)} && ${emitExpression(memReadWrite.writeEnable)} ", memReadWrite.address, memReadWrite.data, memReadWrite.mask, memReadWrite.mem.getMemSymbolCount(), memReadWrite.mem.getMemSymbolWidth(),tab)
                }, null, tmpBuilder, memReadWrite.clockDomain, false)
        
```

it may avoid the issue.

let's me know :)

jmio, 2021-09-22:
keep_hierarchy option is now "AUTO".The options are AUTO,FLATTEN, MANUAL, and ALL, which one is better?

jmio, 2021-09-22:
OK, I'll try the two comments above.

Dolu1990, 2021-09-22:
ALL      will preserve everything. (will increase a bit the area and make timing a bit worst)

jmio, 2021-09-22:
[ErrorLog_KeepAll](https://github.com/jmio/testvex/blob/dev160/ErrorLog_KeepAll.txt) Uploaded.

jmio, 2021-09-22:
The TD is still running, but the emitClockedProcess patch above has eliminated the error.

jmio, 2021-09-22:
The error is gone, but when I load the bit file, the SoC bricks (^^;

jmio, 2021-09-22:
Thank you for all your support. I'll upload the current log for now and go to bed today :-)
[SynthLog](https://github.com/jmio/testvex/blob/dev160/SynthLog_Brick.txt)
[Timing](https://github.com/jmio/testvex/blob/dev160/Timing_Brick.txt)

Dolu1990, 2021-09-22:
Good night ^^

jmio, 2021-09-23:
Good morning.

I've added only
VgaCtrl.scala(https://github.com/SpinalHDL/SpinalHDL/commit/2224b2599ecd468decf635125dfa1ee2ecd940a8) to version 68e704f.
It is now flicker-free. Thanks.

The MaxFreq thing is beyond my understanding (^^;

jmio, 2021-09-23:
I tried to create a system with almost the same configuration in ECP5 (yosys + nextpnr), and created a dev-dev combination of Spinal/VexRiscv.
[Briey SoC on ICESugar Pro#dev](https://github.com/jmio/ECP5_Brieysoc/tree/dev)
However, the system stopped without starting as well...

[yosys_report](https://github.com/jmio/ECP5_Brieysoc/blob/dev/top.yosys.rpt)
[nextpnr_report](https://github.com/jmio/ECP5_Brieysoc/blob/dev/top.nextpnr.rpt)

Dolu1990, 2021-09-23:
Hi ^^

So if i understand well, now the dev-dev  soc do not boot on your  Sipeed Tang Primer, nor on your icesugar right ?

Does the soc work in simulation ?

jmio, 2021-09-23:
>So if i understand well, now the dev-dev soc do not boot on your Sipeed Tang Primer, nor on your icesugar right ?

Yes. looks like freeze. There is no boot message from the UART (in my firmware).

>Does the soc work in simulation ?

I'm actually new to trying simulations, am I right?

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

Attached is a screenshot of what I ran in WSL2.
On the top left is the VGA (X410 XServer Window) and on the right is the console resulting from running "make clean run".

Dolu1990, 2021-09-23:
One thing, is that i have seen that you enabled risc-v compressed instruciton set right ?

jmio, 2021-09-23:
>One thing, is that i have seen that you enabled risc-v compressed instruciton set right ?

Yes, I did. I forgot about it.
I put the Briey.scala file back in and ran it again. The console message is different, is this normal?
The VGA was still black.
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

Dolu1990, 2021-09-24:
Yes, that's normal, there is some reset glitchies with the sdram model ^^ nothing bad.

So then what you can try, is  to connect it with openocd and load some binaries in it ^^ :

Simulation shell
```shell
VexRiscv/src/test/cpp/briey$ make clean run
```
Openocd shell
```shell
openocd_riscv$ src/openocd -f tcl/interface/jtag_tcp.cfg -c "set BRIEY_CPU0_YAML ????/cpu0.yaml" -f tcl/target/briey.cfg
```
GDB shell
```shell
riscv??-??-??-gdb dhrystone.elf
target remote localhost:3333
set remotetimeout 60
set arch riscv:rv32
monitor reset halt
load
continue
```

There is the dhrystone.elf :

[dhrystone.elf.zip](https://github.com/SpinalHDL/VexRiscv/files/7224483/dhrystone.elf.zip)

You should get in the simulation shell

```
BOOT
SDRAM : READ Wrong DQ direction
SDRAM : write in closed bank
SDRAM : write in closed bank
SDRAM : MODE REGISTER DEFINITION CAS=3 burstLength=0
CONNECTED
SDRAM : MODE REGISTER DEFINITION CAS=3 burstLength=0
SDRAM : MODE REGISTER DEFINITION CAS=3 burstLength=0
SDRAM : MODE REGISTER DEFINITION CAS=3 burstLength=0

Dhrystone Benchmark, Version 2.1 (Language: C)

Program compiled without 'register' attribute

Please give the number of runs through the benchmark:
Execution starts, 200 runs through Dhrystone
Execution ends

Final values of the variables used in the benchmark:

Int_Glob:            5
        should be:   5
Bool_Glob:           1
        should be:   1
Ch_1_Glob:           A
        should be:   A
Ch_2_Glob:           B
        should be:   B
Arr_1_Glob[8]:       7
        should be:   7
Arr_2_Glob[8][7]:    210
        should be:   Number_Of_Runs + 10
Ptr_Glob->
  Ptr_Comp:          1073765228
        should be:   (implementation-dependent)
  Discr:             0
        should be:   0
  Enum_Comp:         2
        should be:   2
  Int_Comp:          17
        should be:   17
  Str_Comp:          DHRYSTONE PROGRAM, SOME STRING
        should be:   DHRYSTONE PROGRAM, SOME STRING
Next_Ptr_Glob->
  Ptr_Comp:          1073765228
        should be:   (implementation-dependent), same as above
  Discr:             0
        should be:   0
  Enum_Comp:         1
        should be:   1
  Int_Comp:          18
        should be:   18
  Str_Comp:          DHRYSTONE PROGRAM, SOME STRING
        should be:   DHRYSTONE PROGRAM, SOME STRING
Int_1_Loc:           5
        should be:   5
Int_2_Loc:           13
        should be:   13
Int_3_Loc:           7
        should be:   7
Enum_Loc:            1
        should be:   1
Str_1_Loc:           DHRYSTONE PROGRAM, 1'ST STRING
        should be:   DHRYSTONE PROGRAM, 1'ST STRING
Str_2_Loc:           DHRYSTONE PROGRAM, 2'ND STRING
        should be:   DHRYSTONE PROGRAM, 2'ND STRING

Clock cycles=101523
DMIPS per Mhz:                              1.12

```

let's me know how it goes ^^

Dolu1990, 2021-09-24:
Note that by default, Briey do not implement RVC

jmio, 2021-09-24:
Hello.

I followed the steps and the simulation is working in dev-dev version.

The circuit I added may be bad.
I have added 2 channels of APB, does it have any effect?

Also, RVC seems to have an effect. I'll try it out.

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

jmio, 2021-09-24:
Hmm, I still can't get the modified version to start in the simulator.

Even with the version I modified.
If I set "compressedGen = false", it starts.

It seems that RVC is the cause.....

jmio, 2021-09-24:
I have only a small amount of BRAM (for monitor program) and I want to run it with RVC enabled.
Is there a good way to do this?

[My Modified Briey.scala](https://github.com/jmio/ECP5_Brieysoc/blob/main/Briey.scala)

Dolu1990, 2021-09-25:
I can see that in your configs you change the sdram configuration

ex :
      def layout = SdramLayout(
        generation = SDR,
        bankWidth = 2,
        columnWidth = 8,
        rowWidth = 11,
        dataWidth = 32
      )

This will not work well with the simulation model of the sdram.

Did you adapted the

		SdramConfig *sdramConfig = new SdramConfig(
			2,  //byteCount
			4,  //bankCount
			1 << 13, //rowSize
			1 << 10  //colSize
		);

of main.cpp ? Else the sdram read / write will get corrupted :)

Dolu1990, 2021-09-25:
One thing i noticed, is that your My Modified Briey.scala  wasn't based on SpinalHDL 1.6.1 right ? but a older version ?

jmio, 2021-09-25:
Thanks for the advice.

I use sbt "runMain vexriscv.demo.Briey"
(not "BrieyTangPrimer") command for create "Briey.v" for simulation,
So,I think the simulation is done with the default SDRAM setting (IS42x320D).

I would like to find out why the simulation fails to start, since it can be successfully started with this configuration if RVC is not enabled.

>One thing i noticed, is that your My Modified Briey.scala wasn't based on SpinalHDL 1.6.1 right ? but a older version ?

Sorry for the confusion. I couldn't attach the ".scala" or ".v" files to this field, so I posted a link to the repository.
The header of the dev-dev "Briey.v" that I'm using for the simulation looks like this

>// Generator : SpinalHDL v1.6.1 git head : 8addf7fa9969a9cb92e967e4bc42178878175609
>// Component : Briey
>// Git hash : 5f5f4afbf2594cf95d9c1e0c71880dea83828a34

Dolu1990, 2021-09-25:
Ahhh
So, i tried your Briey.scala, and it worked in simulation for me.

One thing, is that if you just run the simulation, it will not run any binary, you realy need to load stuff into it via openocd / gdb.
Have you done that ?

Can you tell me more about what it mean to fail to start ?

One thing, currently, if you access one of your two external apb bus this will freeze the CPU, as their PREADY isn't set.

You can run the sim as : make clean run VGA=yes TRACE=yes

To generate a Briey.fst file which will show you everything, but be aware, it slow down the sim and take space on the harddrive.

Also, can you send me the xxx.elf you are using ?

jmio, 2021-09-25:
>So, i tried your Briey.scala, and it worked in simulation for me.

 Thank you for testing my Briey.scala.

>One thing, is that if you just run the simulation, it will not run any binary, you realy need to load stuff into it via openocd / gdb.
>Have you done that ?

I ran the following command (almost identical to the one you gave me)

Create Verilog & Simurator
```
VexRiscvDev$ sbt "runMain vexriscv.demo.Briey"
VexRiscvDev$ cd src/test/cpp/briey
VexRiscvDev/src/test/cpp/briey$ make clean run
```

Openocd Shell
```
openocd_vexriscv$ src/openocd -f tcl/interface/jtag_tcp.cfg -c "set BRIEY_CPU0_YAML /home/mio/VexRiscv/cpu0.yaml" -f tcl/target/briey.cfg
```

GDB Shell
```
export PATH=$PATH:$(echo ~/litex/riscv64-*/bin/)
riscv64-unknown-elf-gdb dhrystone.elf
--
(gdb)target remote localhost:3333
(gdb)set remotetimeout 60
(gdb)set arch riscv:rv32
(gdb)monitor reset halt
(gdb)load
(gdb)continue
```

As you can see, the toolchain is the one we use in litex.
For elf, I used the one from the Dhrystone benchmark that was sent to me.

As for the phrase "won't start".
When I run the above procedure with Briey.v created with RVC enabled, Dhrystone does not run and the screen stops in the following state.

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

>You can run the sim as : make clean run VGA=yes TRACE=yes

>To generate a Briey.fst file which will show you everything, but be aware, it slow down the sim and take space on the harddrive.

 I'm going to try this now.

jmio, 2021-09-25:
Very interesting, but I changed "make clean run" to "make clean run VGA=yes TRACE=yes" and Dhrystone worked (although very slow as you said).

A very large file "Briey.fst" was generated.

Dolu1990, 2021-09-25:
hmmm, i guess there may be some reset issue which randomly pop up in the sim

jmio, 2021-09-25:
Incidentally, gdb when "not starting" seemed to stop at the following location when I stopped it with Ctrl+C.
I'm not sure why, but is the CPU working?

```
crtStart () at src/../../../../resources/crt.S:6
6       src/../../../../resources/crt.S: そのようなファイルやディレクトリはありません.
The target architecture is assumed to be riscv:rv32
JTAG tap: fpga_spinal.bridge tap/device found: 0x10001fff (mfg: 0x7ff (<invalid>), part: 0x0001, ver: 0x1)
Loading section .memory, size 0x2b34 lma 0x40000000
Loading section .text.startup, size 0x5c lma 0x40002b34
Loading section .rodata, size 0x7b8 lma 0x40002b90
Loading section .data, size 0x1c lma 0x40003348
Loading section .vector, size 0x138 lma 0x80000000
Start address 0x80000000, load size 13468
Transfer rate: 4 KB/sec, 2693 bytes/write.
^C
Program received signal SIGINT, Interrupt.
infinitLoop () at src/../../../../resources/crt.S:96              <============
96      in src/../../../../resources/crt.S
(gdb) quit
A debugging session is active.

        Inferior 1 [Remote target] will be detached.

Quit anyway? (y or n) y
```

Dolu1990, 2021-09-25:
Hmm i have the same issue now with TRACE=no. i'm on it.

About crts.S line 96, this seems good, it is when the programm returned from main.

infinitLoop:
  j infinitLoop

  It maybe a issue with the serial stuff

Dolu1990, 2021-09-25:
So, that's weird, seems like it is either a verilator testbench issue, either a uart peripheral issue in the sim, that depending the initial state of the sim, isn't getting the uart stuff right.

Dolu1990, 2021-09-25:
What is happening if you use your executable in the sim  with trace=yes ?
Is it booting ?

jmio, 2021-09-25:
Yes. A message is displayed on the screen and Dhrystone has been successfully executed until the end.

jmio, 2021-09-25:
The problem of no message with TRACE=no seems to occur not only with dev-dev, but also with 2de35e6 (the version I mentioned as working fine at the top of the topic).

So it doesn't seem to be related to my problem with "BrieyTangPrimer" not working.

The flickering has been resolved.

Should I close this "Issue" for now?

jmio, 2021-09-25:
I'll write another topic when I've sorted out the issues and have something to ask. OK?

Dolu1990, 2021-09-25:
ok ^^

Also, i just pushed a testbench for briey written in SpinalSim.

sbt "runMain vexriscv.demo.BrieySim"

It can be connected the sameway to openocd.

jmio, 2021-09-25:
Thank you very much.

Actually, I have a lot more questions.
Saxon Soc, and bmb bus etc.....

Closed 2021-09-25.

Thread 219 (2021-11-09):

Readback of hardware breakpoint values via debug interface

BLangOS, 2021-11-09:
I am working on a hardware that uses the VexRiscv debug interface. Up to now it can halt, step and continue the processor, memory accesses work and it can set hardware breakpoints starting at address 0x40 of the debug interface.
Now I try to read back the hardware breakpoint values but it seems that this is not working.
Is it possible to configure the debug interface such that the breakpoint values (address and enable bit) can be read?
Regards Bernhard.

Dolu1990, 2021-11-10:
Hi,

Right, to save area, the hardware breapoints are write only :
https://github.com/SpinalHDL/VexRiscv/blob/master/src/main/scala/vexriscv/plugin/DebugPlugin.scala#L275

There is no setting to make them readable, but if you want you can try to implement it, it shouldn't be tricky.

Regards
Charles

BLangOS, 2021-11-10:
Hi Charles,

I did implement it in a way, that it is backward compatible.

In file `DebugPlugin.scala` I add a parameter `BreakpointReadback : Boolean = false` to `class DebugPlugin`.

The `when` statement starting from line 244 (see [https://github.com/SpinalHDL/VexRiscv/blob/master/src/main/scala/vexriscv/plugin/DebugPlugin.scala#L244](url)) I changed to
```
      switch(RegNext(io.bus.cmd.address(7 downto 2))) {
        is(0x0) {
          io.bus.rsp.data(0) := resetIt
          io.bus.rsp.data(1) := haltIt
          io.bus.rsp.data(2) := isPipBusy
          io.bus.rsp.data(3) := haltedByBreak
          io.bus.rsp.data(4) := stepIt
        }
        if (BreakpointReadback) {
          for(i <- 0 until hardwareBreakpointCount){
            is(0x10 + i){
              io.bus.rsp.data(31 downto 1) := hardwareBreakpoints(i).pc.asBits
              io.bus.rsp.data(0)           := hardwareBreakpoints(i).valid
            }
          }
        }
      }

```
Now it is working. In case of readback the debug plugin must be called with `BreakpointReadback = true`, e.g.:
```
          ...
          new DebugPlugin(
            ClockDomain.current.clone(reset = Bool().setName("debugReset")),
            hardwareBreakpointCount = 4,
            BreakpointReadback      = true
          ),
          ...
```
If the `BreakpointReadback` ist omitted or set to `false` I belive it is equivalent to the current code.

Is it possible that you add this change to the `dev`-Branch?
Here is the modified File: [DebugPlugin.zip](https://github.com/SpinalHDL/VexRiscv/files/7515959/DebugPlugin.zip)

If you are interested here are a few words about my project. I work on a GDB-Server in hardware. It is already running via serial port and can directly connect to gdb, but up to now only with software breakpoints. When trying to support hardware breakpoints I realized that the RSP-protocol of the gdb does not send breakpoint numbers but only breakpoint addresses. Thus I must check the current hardware breakpoints when they must be deleted or when new breakpoints must be set. Without readback I have to add a memory for the hardware breakpoints to my hardware what I want to avoid.
Soon I will publish the code of this server.

Regards Bernhard.

BLangOS, 2021-11-11:
I now proposed a pull request that is sligthly different to the above described change.
The proposed change in the pull request lets the DebugPlugin exactly as it is now when no readback is wished. In case of readback the additional hardware is added.

Regards Bernhard.

Dolu1990, 2021-11-15:
Done ^^

Thanks :D

Closed 2021-11-11.

Thread 221 (2021-11-17):

linux image generation

sjthales, 2021-11-17:
Hello,

I am currently trying to generate linux image to simulate linux booting on VexRiscv.

To do so, I follows guidelines in src/main/scala/vexriscv/demo/Linux.scala:
```
Buildroot =>
git clone https://github.com/SpinalHDL/buildroot.git -b vexriscv
cd buildroot
make spinal_vexriscv_sim_defconfig
make

```
But it doesn't work, I get the following error:

```
mkdir -p /home/sjacq/Work_dir/USE_CASE/2021/softcore_optimization/vexriscv/buildroot/output/target/etc
( \
	echo "NAME=Buildroot"; \
	echo "VERSION=2019.05-git-00630-g82656af66f"; \
	echo "ID=buildroot"; \
	echo "VERSION_ID=2019.05-git"; \
	echo "PRETTY_NAME=\"Buildroot 2019.05-git\"" \
) >  /home/sjacq/Work_dir/USE_CASE/2021/softcore_optimization/vexriscv/buildroot/output/target/usr/lib/os-release
ln -sf ../usr/lib/os-release /home/sjacq/Work_dir/USE_CASE/2021/softcore_optimization/vexriscv/buildroot/output/target/etc
>>>   Sanitizing RPATH in target tree
/home/sjacq/Work_dir/USE_CASE/2021/softcore_optimization/vexriscv/buildroot/support/scripts/fix-rpath target
>>>   Copying overlay board/spinal/vexriscv_sim/overlay
rsync: change_dir "/home/sjacq/Work_dir/USE_CASE/2021/softcore_optimization/vexriscv/buildroot//board/spinal/vexriscv_sim/overlay" failed: No such file or directory (2)
rsync error: some files/attrs were not transferred (see previous errors) (code 23) at main.c(1207) [sender=3.1.3]
make[1]: *** [Makefile:765 : target-finalize] Erreur 23
make: *** [Makefile:84 : _all] Erreur 2
```
What did I do wrong? What is the way to generate linux image?

Dolu1990, 2021-11-18:
It is because of the overlay that i added, but which has no content.
I just pushed a fix :
https://github.com/SpinalHDL/buildroot/commit/30d350501a940ba1852d3f302cdaf8c0495c12f4

Should be good now :)

Dolu1990, 2021-11-18:
Keep in mind, those linux builds are kind of very old.

Currently the dev i'm on are based on :
https://github.com/SpinalHDL/SaxonSoc/tree/dev-0.3/bsp/digilent/ArtyA7SmpLinux
https://www.youtube.com/watch?v=K5Vv32O9g7Q&ab_channel=CharlesPapon

sjthales, 2021-11-18:
Thank you.

Linux image generation is now working.

However, now I encounter a problem in running linux simulation.

To do so, I ran the following commands:
```
Run linux in simulation (Require the machime mode emulator compiled in SIM mode) =>
sbt "runMain vexriscv.demo.LinuxGen"
cd src/test/cpp/regression
export BUILDROOT=$(buildroot directory path)
make clean run IBUS=CACHED DBUS=CACHED  DEBUG_PLUGIN=STD SUPERVISOR=yes CSR=yes DEBUG_PLUGIN=no  COMPRESSED=no LRSC=yes AMO=yes REDO=0 DHRYSTONE=no LINUX_SOC=yes EMULATOR=../../../main/c/emulator/build/emulator.bin VMLINUX=$BUILDROOT/output/images/vmlinux DTB=$BUILDROOT/board/spinal/vexriscv_sim/rv32.dtb RAMDISK=$BUILDROOT/output/images/rootfs.cpio WITH_USER_IO=yes TRACE=no FLOW_INFO=no
```
I modified` VMLINUX=$BUILDROOT/output/images/Image` by `VMLINUX=$BUILDROOT/output/images/vmlinux`

It doesn't work, I have the following message:
```
./obj_dir/VVexRiscv
BOOT
*** VexRiscv BIOS ***
*** Supervisor ***
FAIL linux at PC=80000800 REF PC=800007fc REF I=6f time=3506
make: *** [makefile:264 : run] Erreur 255
```
Very nice video, very impressive!
How did you implement the VGA interface? did you need to develop a specific peripheral in the FPGA for PmOD VGA module interfacing?

Dolu1990, 2021-11-18:
I have to say, i haven't use that buildroot flow to generate images sinces ages (same for vexriscv.demo.LinuxGen), so , maybe try first with :
https://github.com/SpinalHDL/VexRiscvRegressionData/tree/539398c1481203a51115b5f1228ea961f0ac9bd3/sim/linux/rv32ima
https://github.com/SpinalHDL/VexRiscvRegressionData/tree/539398c1481203a51115b5f1228ea961f0ac9bd3/sim/linux/emulator

which are precompiled images that i still use for automated regressions which test them on randomized VexRiscv configs. See Test_linux on :
https://github.com/SpinalHDL/VexRiscv/runs/4209092497?check_suite_focus=true

> VMLINUX=$BUILDROOT/output/images/vmlinux

This isn't well named, i think you realy need the $BUILDROOT/output/images/Image, as that's what is used for regressions

> sbt "runMain vexriscv.demo.LinuxGen"

If it still doesn't work with the precompiled images, let me know, it may be a few missing optionnal feature to turn on.

> How did you implement the VGA interface?

I used :
 https://www.digikey.ch/product-detail/de/digilent,-inc./410-345/1286-1171-ND/7560228?utm_adgroup=General&utm_source=google&utm_medium=cpc&utm_campaign=Smart%20Shopping_Product_Zombie%20SKU&utm_term=&productid=7560228&gclid=Cj0KCQiAkNiMBhCxARIsAIDDKNWYTn0VnybR27AkZzaN7-R1vSyK15l6cFUgmdZIDV9iHitMkZTupLgaAlJ5EALw_wcB

> did you need to develop a specific peripheral in the FPGA for PmOD VGA module interfacing?

Yes, but it isn't complicated, there is also a HDMI output for the ulx3s :)

sjthales, 2021-11-19:
It works. Thank you.

Thread 223 (2021-12-03):

Debug failed

Saqlinahamad, 2021-12-03:
Hi,
I am using lattice propel tool and debugging RISCV Core with Lattice Board LFCPNX-100 in lattice propel SDK.
While debugging I am getting following error for default program
For the same board, I successfully debugged default program just 10 days back,

Open On-Chip Debugger 0.10.0+dev-snapshot (2021-10-14-10:56) Licensed under GNU GPL v2 For bug reports, read http://openocd.org/doc/doxygen/bugs.html 0 5 FTUSB-0 Info : only one transport option; autoselect 'jtag' none separate Warn : Transport "jtag" was already selected adapter speed: 4000 kHz E:/Saqlain/propel_builder/2.1_Beta/rvc/src/cpu0.yaml Warn : Interface already configured, ignoring adapter speed: 4000 kHz adapter_nsrst_delay: 260 jtag_ntrst_delay: 250 Info : set servers polling period to 50ms QCoreApplication::applicationDirPath: Please instantiate the QApplication object first Device List: LFCPNX-100:0x010F4043
Info : clock speed 4000 kHz
Info : Listening on port 3333 for gdb connections Started by GNU MCU Eclipse
Info : Listening on port 6666 for tcl connections
Info : Listening on port 4444 for telnet connections
Info : accepting 'gdb' connection on tcp/3333
Info : Halt timed out, wake up GDB. Error: timed out while waiting for target halted
Info : TAP fpga_spinal.bridge does not have IDCODE
Info : TAP auto0.tap does not have IDCODE
Info : TAP auto1.tap does not have IDCODE
Info : TAP auto2.tap does not have IDCODE
Info : TAP auto3.tap does not have IDCODE
Info : TAP auto4.tap does not have IDCODE
Info : TAP auto5.tap does not have IDCODE
Info : TAP auto6.tap does not have IDCODE
Info : TAP auto7.tap does not have IDCODE
Info : TAP auto8.tap does not have IDCODE
Info : TAP auto9.tap does not have IDCODE
Info : TAP auto10.tap does not have IDCODE
Info : TAP auto11.tap does not have IDCODE
Info : TAP auto12.tap does not have IDCODE
Info : TAP auto13.tap does not have IDCODE
Info : TAP auto14.tap does not have IDCODE
Info : TAP auto15.tap does not have IDCODE
Info : TAP auto16.tap does not have IDCODE
Info : TAP auto17.tap does not have IDCODE
Info : TAP auto18.tap does not have IDCODE
Info : TAP auto19.tap does not have IDCODE
Info : TAP auto0.tap does not have IDCODE
Warn : Unexpected idcode after end of chain: 22 0x00000000
Warn : Unexpected idcode after end of chain: 54 0x00000000
Warn : Unexpected idcode after end of chain: 86 0x00000000
Warn : Unexpected idcode after end of chain: 118 0x00000000
Warn : Unexpected idcode after end of chain: 150 0x00000000
Warn : Unexpected idcode after end of chain: 182 0x00000000
Warn : Unexpected idcode after end of chain: 214 0x00000000
Warn : Unexpected idcode after end of chain: 246 0x00000000
Warn : Unexpected idcode after end of chain: 278 0x00000000
Warn : Unexpected idcode after end of chain: 310 0x00000000
Warn : Unexpected idcode after end of chain: 342 0x00000000
Warn : Unexpected idcode after end of chain: 374 0x00000000
Warn : Unexpected idcode after end of chain: 406 0x00000000
Warn : Unexpected idcode after end of chain: 438 0x00000000
Warn : Unexpected idcode after end of chain: 470 0x00000000
Warn : Unexpected idcode after end of chain: 502 0x00000000
Warn : Unexpected idcode after end of chain: 534 0x00000000
Warn : Unexpected idcode after end of chain: 566 0x00000000
Warn : Unexpected idcode after end of chain: 598 0x00000000
Warn : Unexpected idcode after end of chain: 630 0x00000000
Warn : Unexpected idcode after end of chain: 662 0x00000000
Error: double-check your JTAG setup (interface, speed, ...)
Error: Trying to use configured scan chain anyway...
Error: fpga_spinal.bridge: IR capture error; saw 0x00 not 0x01
Warn : Bypassing JTAG setup events due to errors
Error: timed out while waiting for target halted TARGET: fpga_spinal.cpu0 - Not halted Info : Halt timed out, wake up GDB. Error: timed out while waiting for target halted
Assertion failed: target->state == TARGET_HALTED, file src/target/vexriscv.c, line 1059

fatalfeel, 2021-12-04:
http://fatalfeel.blogspot.com/2013/12/risc-v-on-arty-a7-35t.html?m=1
Check external jtag part make sure u are using dpinalhdl's openocd

fatalfeel, 2021-12-04:
The idcode number already in vecriscv. its in vexriscv import pack

Saqlinahamad, 2021-12-04:
Will you please help me in making sure about external JTAG part number

As I am new to this things
I am just debugging RISCV Core in lattice propel SDK tool with provided board and lattice cable

Saqlinahamad, 2021-12-04:
![Uploading 16386122061842503057841982337367.jpg…]()
![Uploading 16386122358406475496908211999732.jpg…]()

Saqlinahamad, 2021-12-04:
I think it's GDB OpenOCD Debugging

fatalfeel, 2021-12-04:
openocd will auto get idcode~~~where u get openocd?

Saqlinahamad, 2021-12-04:
In Propel tool,
We have option to debug through OpenOCD or GDB.

fatalfeel, 2021-12-04:
I mean the openocd git address

Saqlinahamad, 2021-12-04:
No, I haven't cloned this repo

fatalfeel, 2021-12-04:
before my exp. i use official openocd git://git.code.sf.net/p/openocd/code is failed and using SpinalHDL/openocd_riscv is ok!

Saqlinahamad, 2021-12-04:
The tool inbuilt is containing OpenOCD
I am Debugging the FPGA board with GDB Openocd debugger
As I debugged just 15-20 days back,
Now
I don't know why I can't able to debug,

fatalfeel, 2021-12-04:
try again https://github.com/SpinalHDL/openocd_riscv

Saqlinahamad, 2021-12-04:
Does it requires a build in linux OS
or
Cloning a directory? If Cloning a directory
In OpenOCD Setup,
I require executable file OpenOCD.exe

fatalfeel, 2021-12-04:
in ubuntu~i think u have a lot road to go~~~but good luck first

Saqlinahamad, 2021-12-04:
No, I am working in Windows

Saqlinahamad, 2021-12-04:
C:/lscc/propel/2.1/SDK/Openocd/bin/openocd.exe

If I cloned the Vexriscv Openocd
What should be my Openocd application path?

Saqlinahamad, 2021-12-04:
![Uploading 16386203639899086151565018613012.jpg…]()

Saqlinahamad, 2021-12-04:
![Uploading 16386204027864127507748923683003.jpg…]()

fatalfeel, 2021-12-04:
u need upload to mediafire or google driver or we can not see it ~

Saqlinahamad, 2021-12-04:
https://photos.app.goo.gl/VjTnDC71higH2DUTA

Saqlinahamad, 2021-12-04:
Had shared the executable directory structure and path with the debug configuration I have currently

fatalfeel, 2021-12-04:
my work system is on ubuntu PC not simulator linux , so can not help you in windows.
in ubuntu, we use terminal window to run openocd, recommend u change to ubuntu.
the gcc we also build in ubuntu, not use any sdk tools

Saqlinahamad, 2021-12-05:
Yeah,
I am working in ofc, and it will take some time to shift to Ubuntu, but I don't have much knowledge on Ubuntu also
I am not able to locate this file (vexriscv.c) in my PC Directory structure
What else can I be able to do in Windows platform only?

Saqlinahamad, 2021-12-05:
Is it a JTAG interface target issue or
Board Issue ?

Dolu1990, 2021-12-05:
hmmm to me, it seems like some electrical issues. would that be possible ?
Do you have a logic analyser ? can you probe the jtag pins ?

Saqlinahamad, 2021-12-06:
Yeah,
Had checked the JTAG pins with probes in oscilloscope
They are working fine.

Dolu1990, 2021-12-07:
Could you share a capture ? from the moment openocd boot ?

Saqlinahamad, 2021-12-07:
https://photos.app.goo.gl/VjTnDC71higH2DUTA

Saqlinahamad, 2021-12-07:
Hi @Dolu1990 , had captured the Debug of my SW Build over a FPGA board
Please reply me
As soon as possible

tomverbeure, 2021-12-07:
@Saqlinahamad
You need to be more specific about what you're trying to do and what you're trying to archieve.

It seems like you're using a version of OpenOCD that comes standard with the Lattice Propel Tool. The default version of OpenOCD does not support the VexRiscv. As @fatalfeel already wrote multiple times: you have to use the VexRiscv openocd version that you can find at https://github.com/spinalhdl/openocd_riscv.

In the picture that you're attaching, I see "RISCV_AHBLite_RPC_DRAM_Controller_SV...". I see a press release that shows that [Lattice Propel has its own RISC-V CPU](https://www.yahoo.com/now/lattice-propel-design-environment-supports-200000942.html). This makes me question: what design are you actually using? Are you using the Propel RISC-V CPU?

If so, you're asking your question in the wrong forum. This project is about the VexRiscv, a RISC-V CPU that has nothing to do with the Lattice RISC-V.

fatalfeel, 2021-12-08:
if you insist work on windows
try download cygwin64
http://www.cygwin.com
enable devel option for development gcc

build https://github.com/spinalhdl/openocd_riscv at windows
But I am not sure work or not~

Saqlinahamad, 2021-12-08:
Okay
But, I need to produce debug results with Lattice RISC-V only.
Thanks

Closed 2021-12-08.

Thread 224 (2021-12-10):

Failed when apply nativeJtag for Altera DE0-Nano-SoC board

vietthanh85, 2021-12-10:
I have followed to https://github.com/SpinalHDL/VexRiscv/tree/master/doc/nativeJtag, but I need to modify for my Altera DE0-Nano-SoC board (Cyclone® V SE 5CSEMA4U23C6N device) and Altera Virtual JTAG. Unfortunately, it was not successful yet. The following is my modifications.

**Original (Xilinx Bscane2)**
```
[254]	val jtagCtrl = JtagTapInstructionCtrl()
[255]	val tap = jtagCtrl.fromXilinxBscane2(userId = 2)
[256]	jtagCtrl <> plugin.io.bus.fromJtagInstructionCtrl(ClockDomain(tap.TCK))
```
**Modification for Altera Virtual JTAG**
```
val tap = new VJTAG()
val jtagCtrl = tap.toJtagTapInstructionCtrl()
jtagCtrl <> plugin.io.bus.fromJtagInstructionCtrl(ClockDomain(tap.tck))
```
**Original: Add import for JtagTapInstructionCtrl**
```
import spinal.lib.com.jtag.JtagTapInstructionCtrl
```
**Modification: Add import for JtagTapInstructionCtrl and VJTAG**
```
import spinal.lib.com.jtag.JtagTapInstructionCtrl
import spinal.lib.blackbox.altera.VJTAG
```
Then, it generated verilog and hex files successfully.
I used them to make Quartus project.
I also added VJTAG module to Quartus project.
(Currently, I reused `vJTAG.qip`, `vJTAG.v` from this example: http://idle-logic.com/2012/04/15/talking-to-the-de0-nano-using-the-virtual-jtag-interface/)
For `toplevel.v`, I also removed the following lines
```
[43]	reg  tesic_tck,tesic_tms,tesic_tdi;
[44]	wire tesic_tdo;
[45]	reg  soc_tck,soc_tms,soc_tdi;
[46]	wire soc_tdo;
[47]
[48]	always @(*) begin
[49]		{soc_tck,  soc_tms,  soc_tdi  } = {tck,tms,tdi};
[50]		tdo = soc_tdo;
[51]	end
…
[56]	.io_jtag_tck(soc_tck),
[57]	.io_jtag_tdi(soc_tdi),
[58]	.io_jtag_tdo(soc_tdo),
[59]	.io_jtag_tms(soc_tms),
```

Then, the bitstream was loaded into the board successfully and Murax worked normally (LED blinked).

For debugging by OpenOCD, I modified as follows:
Create new file `altera-5csema4.cfg` in folder `openocd_riscv/tcl/cpld/` with following content (I have checked the corresponding device handbook for Cyclone V and found that the `expected-id` should be `0x02d010dd`):
```
# Altera Cyclone V 5CSEMA4
# see Cyclone V Device Handbook
# https://www.intel.com/content/dam/www/programmable/us/en/pdfs/literature/hb/cyclone-v/cv_5v2.pdf
# Table 9-1: IDCODE Information for Cyclone V Devices
# Version     Part Number             Manuf. ID        LSB
# 0000        0010 1101 0000 0001     000 0110 1110    1
jtag newtap 5csema4 tap -expected-id 0x02d010dd -irlen 10
```
Then, I modified `usb_connect.cfg` to work with Altera USB Blaster instead of "Digilent USB Device":
```
set _CHIPNAME 5csema4

# adapter driver ftdi
# ftdi_device_desc "Digilent USB Device"
# ftdi_vid_pid 0x0403 0x6010
# ftdi_channel 0
# ftdi_layout_init 0x00e8 0x60eb
# ftdi_tdo_sample_edge falling
adapter driver usb_blaster
usb_blaster vid_pid 0x09fb 0x6010 0x09fb 0x6810
usb_blaster lowlevel_driver ublast2
usb_blaster firmware /home/thanh/intelFPGA_lite/21.1/quartus/linux64/blaster_6810.hex

reset_config none
adapter speed 5000

# source [find cpld/xilinx-xc7.cfg]
# source [find cpld/jtagspi.cfg]
source [find tcl/cpld/altera-5csema4.cfg]
source [find tcl/cpld/jtagspi.cfg]

# set TAP_NAME xc7.tap
set TAP_NAME 5csema4.tap
```
I did not modify `soc_init.cfg`.
For other steps, I followed to the reference.

Here is the result when I tried to debug with OpenOCD:
```shell
$ cd openocd_riscv
$ openocd -c "set CPU0_YAML ../VexRiscv/cpu0.yaml" \
-f tcl/interface/usb_connect.cfg \
-f tcl/interface/soc_init.cfg
Open On-Chip Debugger 0.11.0+dev-02572-ga985acb34-dirty (2021-12-04-15:35)
Licensed under GNU GPL v2
For bug reports, read
	http://openocd.org/doc/doxygen/bugs.html
../VexRiscv/cpu0.yaml
Info : only one transport option; autoselect 'jtag'
5csema4.tap
Info : set servers polling period to 50ms
Info : Altera USB-Blaster II found (Firm. rev. = 1.39)
Info : This adapter doesn't support configurable speed
Info : JTAG tap: 5csema4.tap tap/device found: 0x02d010dd (mfg: 0x06e (Altera), part: 0x2d01, ver: 0x0)
Info : JTAG tap: auto0.tap tap/device found: 0x4ba00477 (mfg: 0x23b (ARM Ltd), part: 0xba00, ver: 0x4)
Warn : AUTO auto0.tap - use "jtag newtap auto0 tap -irlen 4 -expected-id 0x4ba00477"
Info : starting gdb server for saxon.cpu0 on 3333
Info : Listening on port 3333 for gdb connections
requesting target halt and executing a soft reset
 done
Info : Listening on port 6666 for tcl connections
Info : Listening on port 4444 for telnet connections
Info : accepting 'gdb' connection on tcp/3333
Info : New GDB Connection: 1, Target saxon.cpu0, state: halted
Info : JTAG tap: 5csema4.tap tap/device found: 0x02d010dd (mfg: 0x06e (Altera), part: 0x2d01, ver: 0x0)
Info : JTAG tap: auto0.tap tap/device found: 0x4ba00477 (mfg: 0x23b (ARM Ltd), part: 0xba00, ver: 0x4)
Error: timed out while waiting for target halted
TARGET: saxon.cpu0 - Not halted
```
GDB client terminal:
```
$ riscv64-unknown-elf-gdb  /home/thanh/SpinalHDL_VexRiscv/VexRiscvSocSoftware/projects/murax/demo/build/demo.elf
GNU gdb (SiFive GDB 9.1.0-2020.08.2) 9.1
Copyright (C) 2020 Free Software Foundation, Inc.
License GPLv3+: GNU GPL version 3 or later <http://gnu.org/licenses/gpl.html>
This is free software: you are free to change and redistribute it.
There is NO WARRANTY, to the extent permitted by law.
Type "show copying" and "show warranty" for details.
This GDB was configured as "--host=x86_64-linux-gnu --target=riscv64-unknown-elf".
Type "show configuration" for configuration details.
For bug reporting instructions, please see:
<https://github.com/sifive/freedom-tools/issues>.
Find the GDB manual and other documentation resources online at:
    <http://www.gnu.org/software/gdb/documentation/>.

For help, type "help".
Type "apropos word" to search for commands related to "word"...
Reading symbols from /home/thanh/SpinalHDL_VexRiscv/VexRiscvSocSoftware/VexRiscvSocSoftware/projects/murax/demo/build/demo.elf...
(gdb) target extended-remote localhost:3333
Remote debugging using localhost:3333
0x00000000 in ?? ()
(gdb) load
warning: while parsing target memory map (at line 2): Required element <memory> is missing
Loading section .vector, size 0x130 lma 0x80000000
Loading section .memory, size 0x358 lma 0x80000130
Start address 0x80000000, load size 1160
Transfer rate: 377 KB/sec, 580 bytes/write.
(gdb) monitor reset halt
JTAG tap: 5csema4.tap tap/device found: 0x02d010dd (mfg: 0x06e (Altera), part: 0x2d01, ver: 0x0)
JTAG tap: auto0.tap tap/device found: 0x4ba00477 (mfg: 0x23b (ARM Ltd), part: 0xba00, ver: 0x4)
timed out while waiting for target halted
TARGET: saxon.cpu0 - Not halted
```
The problem is that: CPU was not halted after I sent `monitor reset halt` from gdb client.
So, I cannot debug anything the application :(
I guess that the OpenOCD configurations to connect to USB Blaster and the board might be not correct, but I am not sure how to configure it correctly.
Do you have any idea about what the wrong steps are?
Your help would be very appreciated!
Many thanks!

Dolu1990, 2021-12-14:
Hi,
I would say, to debug it you would need to check what is happning on the VJTAG using signaltap (or another logic analyser), and see if it does something when you start openocd.

That way we can be sure which way to look at, as there is quite many things involved to get things to work ^^

vietthanh85, 2021-12-14:
> Hi, I would say, to debug it you would need to check what is happning on the VJTAG using signaltap (or another logic analyser), and see if it does something when you start openocd.
>
> That way we can be sure which way to look at, as there is quite many things involved to get things to work ^^

@Dolu1990 Thank you. I've got your point.

tomverbeure, 2021-12-14:
> I guess that the OpenOCD configurations to connect to USB Blaster and the board might be not correct, but I am not sure how to configure it correctly. Do you have any idea about what the wrong steps are? Your help would be very appreciated!

OpenOCD (including the VexRiscv version of OpenOCD) doesn't have a generic way to deal with Intel's virtual JTAG. To my knowledge, there is only one CPU that supports virtual JTAG in OpenOCD and that's OpenRISC. (See [here](https://github.com/openocd-org/openocd/blob/master/src/target/openrisc/or1k_tap_vjtag.c).)

Support of virtual JTAG for the VexRiscv requires a similar amount of work in OpenOCD. Personally, I simply [use general purpose GPIOs and the SpinalHDL JTAG TAP](https://tomverbeure.github.io/2021/07/18/VexRiscv-OpenOCD-and-Traps.html) to connect a debugger to a VexRiscv CPU.

Tom

Dolu1990, 2021-12-15:
If i remember well, somebody got it to work with the vjtag from altera, but i realy don't remember anything else XD

vietthanh85, 2021-12-15:
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

Thank @tomverbeure . By the way, I've just found this blog https://koyamanx.github.io/ck-dev/blog/my_riscv_debug_feature_part1. He tried to debug RISC-V cores on Altera boards by OpenOCD using VJTAG.
He also ported it from OpenRISC (or1k_tap_vjtag.c). Unfortunately, only Japanese is available. I am following to this blog post through a lot of things need to be modified and it's still far from the success. Hope this helps in case of you have a similar work to do.

tomverbeure, 2021-12-15:
Nice find!
The number of changes that are specific to virtual JTAG are very reasonable: https://github.com/koyamanX/riscv-openocd/commit/ad03470a2b4d3f0fadd9e1944445ac9193487d37.

Tom

Dolu1990, 2021-12-15:
Thanks :)

LYWalker, 2022-01-31:
@vietthanh85 Any luck getting this to work in the end? Trying to have a go myself

vietthanh85, 2022-02-01:
> @vietthanh85 Any luck getting this to work in the end? Trying to have a go myself
@LYWalker not yet.
https://koyamanx.github.io/ck-dev/blog/my_riscv_debug_feature_part1
https://github.com/koyamanX/riscv-debug
This is not a complete guideline. A lot of TODOs to get it working.
I am thinking to use another solution from LiteX:
https://github.com/jevinskie/litex/blob/jev/main/litex/soc/cores/jtag.py

LYWalker, 2022-11-04:
I can confirm that I have VJTAG working, I'll create a pull request soon. It has edits in the openocd port as well, as you can imagine.

Dolu1990, 2022-11-06:
@LYWalker Nice thanks :D

LYWalker, 2022-11-07:
@Dolu1990
See these pull requests:
https://github.com/SpinalHDL/SpinalHDL/pull/950
https://github.com/SpinalHDL/openocd_riscv/pull/28
#276

Let me know if you have any suggestions. I've tested it successfully on the DE0 board.

Thread 229 (2021-12-30):

The GenFullWithCSRWithFPU core has wrong about (&) (andi) instruct

sheldonyk, 2021-12-30:

sheldonyk, 2021-12-30:
The andi instruct (&) is equal to xor instruct (^), i guess this maybe a bug.

sheldonyk, 2021-12-30:
thanks

sheldonyk, 2021-12-30:
After I updated the code, I found that this problem has been solved. Thank you.

Dolu1990, 2021-12-30:
Hi ^^
Good, so, all good ?

sheldonyk, 2021-12-31:
yes，i had test the RV32IMF，which the test case you provided in the project is pass

发自我的iPhone

------------------ Original ------------------
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

Dolu1990, 2021-12-31:
ok, thanks ^^

Closed 2021-12-31.

Thread 238 (2022-02-22):

single step fails during on chip debug when prediction configured to DYNAMIC or DYNAMIC_TARGET

syibin, 2022-02-22:
single step fails during on chip debug when prediction configured to DYNAMIC or DYNAMIC_TARGET

I met an issue related to prediction. I setup the gdb + openocd + Briey SOC co-simulation as guided by Vex readme. With default Briey which use STATIC prediction, the hello world project works fine - can print out "hello" string. However, if I switch the prediction to DYNAMIC, and rerun. no string will be printed.
Meanwhile, I also had a try on board. with prediction to STATIC, everything works fine with sdk. However, if prediction switch to DYNAMIC or DYNAMIC TARGET, soft/harden breakpoint still works well. While single step will have issue - when i put si in gdb, sometimes, next 1 instruction will be run, sometimes next 1 instruction will be skipped unexpectedly and the next next one will be run instead.

Steps:
0. I download the latest VexRiscv and openocd_riscv about 1 month ago.
1. Generate Briey - sbt "runMain vexriscv.demo.Briey".
For the working SOC, I just use the default option; for the failing SOC, I made following changes:
   a) prediction set to DYNAMIC or DYNAMIC_TARGET for IBusCachedPlugin
   b) wayCount set to 2, twoCycleRam set to false for InstrunctionCacheConfig (these change won't cause issue, just to clarify my changes)
   c) regFileReadyKind set to ASYNC for RegFilePlugin (to compatible with dynamic prediction)
2. cd src/test/cpp/briey, and run "make clean run"
3. launch openocd:
src/openocd -f tcl/interface/jtag_tcp.cfg -c "set BRIEY_CPU0_YAML /home/syibin/sda3/VexRiscv-master/cpu0.yaml" -f tcl/target/briey.cfg
4. compile uart project by running makefile in VexRiscvSocSoftware-master/projects/briey/uart
5. launch gdb with compiled uart.elf:
~/sda3/riscv32-unknown-elf.gcc-10.2.0.rv32i.ilp32.newlib/bin/riscv32-unknown-elf-gdb uart.elf
6. run following commands in gdb:
target remote localhost:3333
set remotetimeout 60
set arch riscv:rv32
monitor reset halt
load
b main
continue
si
si
c

SW version:
I think the gcc/openocd/gdb's version won't matter since I tried two different versions of openocd and gdb, the result keep unchanged.
For Verilator: Verilator 4.040 2020-08-15 rev v4.040

Dolu1990, 2022-02-22:
So part of the issue was the simulation testbench which had a floating uart rxd. It is now fixed.

Dolu1990, 2022-02-22:
About

> While single step will have issue - when i put si in gdb, sometimes, next 1 instruction will be run, sometimes next 1 instruction will be skipped unexpectedly and the next next one will be run instead.

So, you are using "si" which is single instruction. (not single step).

Using "si" i observe :

```
(gdb) si
36		reg->CLOCK_DIVIDER = config->clockDivider;
(gdb) si
36		reg->CLOCK_DIVIDER = config->clockDivider;
(gdb) si
0x40000144	36		reg->CLOCK_DIVIDER = config->clockDivider;
(gdb) si
0x40000144	36		reg->CLOCK_DIVIDER = config->clockDivider;
(gdb) si
36		reg->CLOCK_DIVIDER = config->clockDivider;
(gdb) si
0x4000014c	36		reg->CLOCK_DIVIDER = config->clockDivider;
```

which is a example of the symptomes you have seen right ?

syibin, 2022-02-23:
Hi, Dolu

yes, the simulation difference between STATIC and DYNAMIC is caused by the floating uart rx. After the fix, the DYNAMIC mode can also see the "Hello" string. Thanks for the fix - otherwise, I may go to the wrong direction. :)

Regarding board level difference, I'm still working on to figure out why, will keep you updated once I find something.

Thanks
Yibin

Dolu1990, 2022-02-24:
One possibility is that in the sim the dynamic predictors are initialized with some stuff, while in sim it isn't ?

syibin, 2022-05-31:
Hi, Dolu

The issue is fixed by the your recent fix for https://github.com/SpinalHDL/VexRiscv/issues/254.

Thanks again for the support. :)

Thanks
Yibin

Closed 2022-05-31.

Thread 241 (2022-04-01):

murax code simulation

m-pp, 2022-04-01:
Hi All,

I am trying to simulate a c code on murax using verilator. I want to get the cycle count after the code run is complete. I use this: sbt "test:runMain vexriscv.MuraxSim"

Currently, the hello world code runs through and prints the custom string. But, waits for an interrupt and never prints the following statement in VexRiscv-Root/src/test/cpp/murax

"Had simulate " << workspaceCycles << " clock cycles in " << duration*1e-9 << " s (" << workspaceCycles / (duration*1e-9) << " Khz)" << endl

Is that a bug? How can I get the run-time cycle count for hello_world.c?

Dolu1990, 2022-04-04:
Hi ^^

So,  'sbt "test:runMain vexriscv.MuraxSim"'  isn't using src/test/cpp/murax. There is curently to different test environnement :
- raw C++/Verilator via src/test/cpp/murax
- Scala / SpinalSim / Verilator which is 'sbt "test:runMain vexriscv.MuraxSim"'

> Is that a bug? How can I get the run-time cycle count for hello_world.c?

So either you can use the cpp sim :
Then go in src/test/cpp/murax and run the simulation with:
make clean run

Either the way you were actualy doing, but you will need to extends the src/test/scala/vexriscv/MuraxSim.scala testbench to print it.

m-pp, 2022-04-04:
OK, thanks.

When I use the cpp sim with make clean run, with gdb hello_world.elf,  the simulation shows the following:

BOOT
CONNECTED
hello world

And stays there forever. Is it waiting for an interrupt?

It looks like the "MuraxWorkspace().run(100e6); in src/test/cpp/murax main.cpp doesnt quit?

Dolu1990, 2022-04-07:
> And stays there forever. Is it waiting for an interrupt?

I think that's normal, it is just done after it, no interrupt.

> run(100e6)

That is a very long time ^^
try reduce it to 100e3

m-pp, 2022-04-07:
No, that doesnt help. The crt.S has an infinite loop.

Dolu1990, 2022-04-08:
Yes, it is expected that the CPU endup in the infinit loop of crt.S after the main is executed.

In other words, it isn't expected that the sim stop by itself after the execution of the software, it wasn't implemented for that.

Or the CPU do not reach it ?

m-pp, 2022-04-08:
Agree, but MuraxWorkspace().run() does not exit.

Dolu1990, 2022-04-08:
Ahhhh i can see now, the timeout parameter is never used in https://github.com/SpinalHDL/VexRiscv/blob/master/src/test/cpp/common/framework.h#L183

That's why. So fixing that, and MuraxWorkspace().run(100e3); should make things behave right.

m-pp, 2022-04-11:
No, that doesnt help. MuraxWorkspace().run(100e3) also does not exit.

Commenting out MuraxWorkspace().run(100e3)  prints the timers and exits main in src/test/cpp/murax/main.cpp

Dolu1990, 2022-04-11:
I pused a fix in dev, where the timeout is not specifyed in simulated seconds. The sim end when it is reached.

m-pp, 2022-04-12:
Thanks. This works fine for the scala simulation with sbt "test:runMain vexriscv.MuraxSim"

But, with the cpp make clean run in src/test/cpp/murax/, the code does not exit, still.

m-pp, 2022-04-12:
Maybe I am doing something wrong.

This is what I want to do: measure cycle count for a custom code on different vexriscv configurations (pipeline stages, FPU, custom instructions etc). What is the best way to do this?

Dolu1990, 2022-04-13:
Ahhh
So, the best way to do it is in software, else you will mesure all sort of other things at once.

You can use the following for printing stuff :
https://github.com/SpinalHDL/VexRiscvSocSoftware/blob/master/projects/murax/dhrystone/src/stdlib.c#L62

The following code to init the timerA counting up :
https://github.com/SpinalHDL/VexRiscvSocSoftware/blob/master/projects/murax/dhrystone/src/main.c#L19

And this to read the timer :
https://github.com/SpinalHDL/VexRiscvSocSoftware/blob/master/projects/murax/dhrystone/src/main.c#L38

Dolu1990, 2022-04-13:
Else what you can do, is extends the testbench with white box probing, to check which PC is executed, and start counting things, that what i have done for NaxRiscv, but that can be more tricky.

m-pp, 2022-04-25:
Thanks.

> Ahhh So, the best way to do it is in software, else you will mesure all sort of other things at once.
>
Thanks. Did you mean using simulation (C++ or sbt) or with the board?

Dolu1990, 2022-04-25:
both ^^
As long as the test isn't too long in simulation, i would say, go for the simulation.

m-pp, 2022-04-26:
> I pused a fix in dev, where the timeout is not specifyed in simulated seconds. The sim end when it is reached.

I dont think this was pushed to the master branch. @Dolu1990

Dolu1990, 2022-04-26:
Merged in master

Closed 2022-04-26.

Thread 252 (2022-05-11):

Strange uart print when enabling cache and compressed instructions.

hqd7777, 2022-05-11:
Hi, I find a very strange issue when I play with the Briey SOC with cache and C. The software project I use is the UART example in VexRiscvSocSoftware and I also compile it with compressed instructions enabled. When I debug it using riscvgdb and riscv openocd, I find printing error only if I set a breakpoint before the loop and then debug step by step. For example I set breakpoint at line 21
	print("Hello !\n");
It will print "Hello!" correctly and change the line. However, the characters after that will be messed up. Only when you use continue other than step can make the output correct after few outputs.
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

By the way any breakpoints inside the loop nor debug without using step will not cause that error.

Dolu1990, 2022-05-11:
Hooo that's a very interresting bug. It was on hardware or in simulation ?

Dolu1990, 2022-05-11:
Could you send me the exact omdification made to briey ? (especialy as you enabled RVC)

Dolu1990, 2022-05-11:
Got the issue reproduced in simulation <3
I'm on it.

hqd7777, 2022-05-11:
> On my side this fix the issue : [4fff62d](https://github.com/SpinalHDL/VexRiscv/commit/4fff62d3feeb05edcea46e66b25de0ecf3f274fa)
>
> Let's me know if things aren't going well on your side ^^

Wow,I am going to check it on my simulation. Thank you very much!

hqd7777, 2022-05-11:
> On my side this fix the issue : [4fff62d](https://github.com/SpinalHDL/VexRiscv/commit/4fff62d3feeb05edcea46e66b25de0ecf3f274fa)
>
> Let's me know if things aren't going well on your side ^^

It seems to work on my side too. I really appreciate for your help!

Dolu1990, 2022-05-12:
cool thanks ^^

Closed 2022-05-12.

Thread 254 (2022-05-17):

Similar debug issue with briey soc

hqd7777, 2022-05-17:
Hi,
Similar to previous issue[https://github.com/SpinalHDL/VexRiscv/issues/252], I also find an issue in simulation when prediction is set as dynamic target.
1. Openocd will crash using step by step in the while loop. I forget how I exactly make it, but it causes a core dumped using gdb step.
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
2. Similar to my previous ask, when I set a breakpoint at line 21 in main.c and then using step by step debug, it seems to be stuck at some point.
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

prediction = DYNAMIC_TARGET
compressedGen = true

hqd7777, 2022-05-17:
If I use the stepi at the beginning, it seems that I will be trapped in the bss loop and never jump out

hqd7777, 2022-05-17:
For the first issue, it seems to jump to an incorrect address at line 32 of uart.h. I suppose that 0x3a is invalid for this one right?

Dolu1990, 2022-05-17:
Ahhhh damned
And it was with the exact same setup, (briey soc, only branch prediction changed + RVC)  ?

> 0x3a

Which 0x3a ?

hqd7777, 2022-05-17:
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

Yes, I just changed the branch prediction.
I mean when you use gdb stepi command at line 32, it seems to read instruction from address 0x0000003a.

hqd7777, 2022-05-17:
Actually the program is still running. But only the first letter will print and show on the screen. That might not be prediction error.

Dolu1990, 2022-05-17:
> step by step

So not instruction step by step, but C step by step right ?
Step in / step out / regular step ? can you describe exactly the scenario ?

Dolu1990, 2022-05-17:
Ahhh i reproduced something, i'm on it ^^

Dolu1990, 2022-05-17:
I just pushed another fix, i hope now all bugs are fixed ^^
Let's me know if you hit anything weird.

hqd7777, 2022-05-18:
> I just pushed another fix, i hope now all bugs are fixed ^^ Let's me know if you hit anything weird.

Thank you Charles. I am living in China and therefore not able to reply your message on time. Apologyze for unprecise descriptions that make you confused. I appreciate for your help to fix those issues.

Dolu1990, 2022-05-18:
>  I am living in China and therefore not able to reply your message promptly.  ApologyzeC for unprecise descriptions that make you confused.

No worries ^^

> It also fix the bugs on my side. I suppose you may close this issue.

Nice !
Thanks for the bug reporting :)

Closed 2022-05-18.

Thread 259 (2022-07-30):

DataCache Supporting Multiple Cycle RAMs?

dockside-code, 2022-07-30:
Hi! I'm doing some research regarding different memory technologies and how they would interact with existing RISC-V architecture, and I'm trying to integrate a multiple-cycle RAM (say, requires 16 cycles to read and 20 to write) into the data cache to replace the existing data/array banks.

I've noticed that the datacache is pretty tightly coupled to the pipeline. But I'd like to know how feasible would this be? Is it possible without overhauling the entire existing pipeline? What are the main things/plugin logic that I would need to change?

(I'm guessing probably the datacache and the cached databus, but anything else that I should probably need to keep an eye on? If i set the haltByOther signals properly would the pipeline still function?)

Thanks a lot!

Dolu1990, 2022-08-03:
Hi ^^

Hmm currently the data / instruction cache design should be configurable to push logic away up to provide 2 cycles read latency  :

```
       address
         │
         ▼
     ┌─────────┐
─────┤         ├────────
     └─┬─────┬─┘
       │read │
       │     │
       └──┬──┘
          │
     ┌────▼────┐
─────┤         ├─────────
     └───┬─────┘
         │
         ▼
       Logic
```

For the writes, things are designed assuming that :
- cycle 1 : write ram[A] = B
- cycle 2 : read ram[A]
- cycle 3 : get result B

Read during write on the same address can be undefined behaviour.

Overall, getting more than two cycle latency ram read is quite tricky in Vex, and would need some redesign, idealy, adding more pipelining stages, either halting the pipeline. tricky changes to do ^^

So, else, in NaxRiscv, things are way more flexible in that regard, as pipeline can be stretched out, see :
https://github.com/SpinalHDL/NaxRiscv/blob/main/src/main/scala/naxriscv/fetch/FetchCachePlugin.scala#L181

dockside-code, 2022-08-03:
Thank you for the detailed response!
I've decided to stick with Vex., so good luck to me XD.
I've been trying to revamp the data cache (with some success actually with the refilling process)
The problem I'm having now is to stall the pipeline when there's a read/write request to the cache until the data array inside the cache returns ready.
Could you please tell me a little bit more how `arbitration.haltByOthers` works , and what's a `Stageable()` ?

Dolu1990, 2022-08-03:
arbitration.haltByOther is to know in a given stage, when you are blocked because of stuff in futher stages.
"Stageable" is to define a hardware data type that you can inject in the pipeline and retreive in a futher stage. the instance of Stageable is kind of used as a "key" to retreive stuff from the pipeline ^^

dockside-code, 2022-08-03:
Thanks! I think I'll play with them for a little bit first.

karegoud, 2024-08-09:
@dockside-code  I want to work on cache in vex can you give me some guidance on where should I start from and how to proceed. It will really help me a lot with my work.

dockside-code, 2024-08-09:
> @dockside-code I want to work on cache in vex can you give me some guidance on where should I start from and how to proceed. It will really help me a lot with my work.

Hi! So there’s actually a lot going on in the datacache file, a lot of features you may not be using! I would start by removing features you don’t need. Halting the pipeline is handled by the „haltIt” signals. Accessing the cache is handled by “data/tagReadCmd” and “data/tagWriteCmd” bundles. Hope this helps!

karegoud, 2024-08-09:
> > @dockside-code I want to work on cache in vex can you give me some guidance on where should I start from and how to proceed. It will really help me a lot with my work.
>
> Hi! So there’s actually a lot going on in the datacache file, a lot of features you may not be using! I would start by removing features you don’t need. Halting the pipeline is handled by the „haltIt” signals. Accessing the cache is handled by “data/tagReadCmd” and “data/tagWriteCmd” bundles. Hope this helps!

Thanks a lot for replying! So actually I want to work on creating a custom instruction for fft that requires lot of data which i want to access from cache after loading it from memory and also i want to have a part of cache only dedicated to my fft data. Is this possible in vex, if so can you guide me how to proceed

dockside-code, 2024-08-09:
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

Well I think it will be a lot less complicated that way. The way I’d do it is copy the file and make a new component called FFT_cache or smth, and reroute the upstream data. So the data upstream comes from smth like cpucachebus, use a stream demux (see spinalHDL doc) and route the request to fft_cache if address matches a certain region in which you store the FFT data.

karegoud, 2024-08-09:
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

Thanks. I will try the way you have suggested

dockside-code, 2024-08-16:
> Did you toke a look to VexiiRiscv ?

Awesome, is it linux capable yet?

Dolu1990, 2024-08-17:
Yes, it can also run debian / alpine
But note if you want more than 2 cycle latency block ram, then its L1 will not be great.
Better to look at the L2 ^^

Closed 2022-08-03.

Thread 260 (2022-08-02):

Verilator Caseoverlap from generated Code

saahm, 2022-08-02:
Hey,

the following code causes warnings in Verilator 4.107 devel rev v4.106-62-g82d8fe0c and SpinalHDL 1.7 (also older) but not on SpinalHDL 1.4.

```scala
package mylib.duplicatecase

import spinal.core._
import spinal.lib._

import spinal.sim._
import spinal.core.sim._

object MiaoCode {
    def F4_FOO    = M"0000"
    def F4_BAR    = M"0001"
    def F4_MIAU   = M"0010"
    def F4_MOO    = M"0011"
    def F4_WOOF   = M"0100"
}
object MooCode {
    def F4_FOOBAR = M"0000"
    def F4_BARFOO = M"0001"
}

object FooEnumType extends SpinalEnum{
  val undef, fooFoo, fooBar, fooMiau, barFoo, barBar, barMiau = newElement()
}

//Hardware definition
class Bar extends Component {
    val io = new Bundle {
        var myIn = in Bits(5 bits)
        var myFoo = out(FooEnumType())
        val myOut1 = out Bool()
        val barFoo = out Bool()
    }

    val op = Bits(4 bits)
    op := io.myIn(3 downto 0)

    io.myOut1 := False
    io.barFoo := False
    import MooCode._, MiaoCode._
    switch(op){
        is(F4_FOO, F4_FOOBAR){
            io.myFoo := FooEnumType.fooBar
            io.myOut1 := True
        }
        is(F4_MIAU){
            io.myFoo := FooEnumType.fooMiau
        }
        default{
            io.myFoo := FooEnumType.barMiau
            io.barFoo := True
        }
    }

}

object MyBarSim {
  def main(args: Array[String]) {
    SimConfig.withWave.doSim(new Bar){dut =>
      //Fork a process to generate the reset and the clock on the dut
      // dut.clockDomain.forkStimulus(period = 10)

      //Wait a rising edge on the clock
      // dut.clockDomain.waitRisingEdge()
      sleep(1)

    }
  }
}
object MyBarVerilog {
  def main(args: Array[String]) {
    SpinalConfig(
      targetDirectory = "rtl/"
      ).generateVerilog(new Bar)
      .printPruned()
  }
}
```

When generating the Verilog (MyBarVerilog) there is no issue. Calling the simulation (MyBarSim) causes Verialtor to have `%Warning-CASEOVERLAP`.

If the constants inside MiaoCode and MooCode are B instead of M SpinalHDL can generate an error in generation time already.

Overlapping cases shouldnt really cause any issue as its just "duplicate code". Maybe this should cause a warning? The warning can be ommited with `/* verilator lint_off CASEOVERLAP*/` and `/* verilator lint_on CASEOVERLAP*/` around such overlapping cases. Nonetheless it might be possible to generate unreachable or overlapping cases if they are not inside the same "is(...)" statement within SpinalHDL (not tested).

I initially got this in a CPU design where i have an extra decoding check for a different instruction using the same opcode, causing the is(...) case to have the same constants being checked. I'd like to keep that design that way as its quite a big one and the readability could suffer if I have to omit it by hand or do something else.

saahm, 2022-08-02:
Wrong repository, didnt check before opening it. Belongs to SpinalHDL repository instead

Closed 2022-08-02.

Thread 277 (2022-11-10):

How to use custom instruction in C code?

adz0612, 2022-11-10:
I have a custom instruction implemented say, `CustomMac` How do I go about using this in a C code?
If my instruction does:

**CustomMac(rd,rd1,rd2)**
rd = rd1+rd2 ;

How do I translate to:

**C Code:**

int main(){
int a,b,c;
b=5;
c=5;

CustomMac(a,b,c);
// a should have 10 as the result
}

Dolu1990, 2022-11-10:
Hi,
Here is an example :
https://spinalhdl.github.io/NaxRiscv-Rtd/main/NaxRiscv/execution_units/index.html#software-test

adz0612, 2022-11-10:
Hi, @Dolu1990

I'm specifically looking for inline assembly usage. I have seen the crt.S file in your SIMD_ADD example and I was trying something similar to

asm volatile ("SIMD_ADD(a,b,c)")
How can I make something like this work?

Dolu1990, 2022-11-10:
Hooo my bad.
For C inline assembly, see that example  :

https://github.com/SpinalHDL/SaxonSoc/blob/dev-0.3/software/standalone/driver/aes_custom.h#L5

tcal-x, 2022-11-10:
I found the macros here are useful: https://github.com/SpinalHDL/SaxonSoc/blob/dev-0.1/software/standalone/driver/riscv.h

My use of those macros then looks like this:
```
#define cfu_op_hw(funct3, funct7, rs1, rs2)    opcode_R(CUSTOM0, funct3, funct7, (rs1), (rs2))
```

In C code the use looks like
```
unsigned result = cfu_op_hw(0, 0, x, y);
```
where result, x, and y are just C variables.

Of course you can then define your own macros to make it look like
```
unsigned result = MY_OP(x, y);
```

adz0612, 2022-11-11:
Thanks a lot for the suggestions, I did something similar to what @tcal-x suggested which is also done at #206 and in Dolus answer.

I was able to get it working. Thanks!

karegoud, 2024-09-09:
@adz0612  Can you please tell me in which file we have to write the inline assembly to use my custom instruction for doing further computations and how to verify it.

ashuthosh-mr, 2024-09-18:
In the main C file

karegoud, 2024-09-19:
@ashuthosh-mr  Thanks for replying. I wrote inline in main.c file and also added my plugin in Murax.scala file in demo folder but I am unable to get output. I also don't see my plugin added to cpu in test/cpp/murax/Murax.fst file.
Are there anymore changes that I am missing.

karegoud, 2024-09-25:
@Dolu1990 Can you help me with the above question I asked

ashuthosh-mr, 2024-09-26:
Can you share the C code skeleton that you are using to test the custom plugin.

karegoud, 2024-09-29:
#include "riscv.h"
#define fft_round(rs1, rs2, func3, func7) opcode_R(CUSTOM0, func3, func7, rs1, rs2)
static inline __attribute__((always_inline)) void vexriscv_fft_computation (unsigned int *in,
                          unsigned int *out)
                         {
   unsigned int  s[2];
   unsigned int  t[2];

        s[0] = ((volatile unsigned int*)in)[0];
        s[1] = ((volatile unsigned int*)in)[1];

        t[0] =  fft_round(s[0], s[1], 0x00, 0);
        t[1] = fft_round(s[0], s[1], 0x00, 64);

        ((volatile unsigned int*)out)[0] = t[0];
        ((volatile unsigned int*)out)[1] = t[1];

        }

      void main() {
    // Example input data (plaintext) - 16 bytes for AES-128
    unsigned int input[2] ;
    input[0] = 0x00000003  ;
    input[1] = 0x00000003 ;

    unsigned int output[2];

    // Perform AES encryption
    vexriscv_fft_computation(input, output);
   //println("output of fft computation is: ");

}

How to debug this if I am getting an error. In Murax.fst file I am not getting any signals related to this custom instruction even though  I used TRACE=yes in my commands. This custom instruction was working fine when verified with assembly language [using crt.S file
]

ashuthosh-mr, 2024-10-04:
Not sure of the above code. Try this:

`asm(".set abiname_zero, 0");
asm(".set abiname_ra , 1");
asm(".set abiname_sp , 2");
asm(".set abiname_gp , 3");
asm(".set abiname_tp , 4");
asm(".set abiname_t0 , 5");
asm(".set abiname_t1 , 6");
asm(".set abiname_t2 , 7");
asm(".set abiname_s0 , 8");
asm(".set abiname_s1 , 9");
asm(".set abiname_a0 , 10");
asm(".set abiname_a1 , 11");
asm(".set abiname_a2 , 12");
asm(".set abiname_a3 , 13");
asm(".set abiname_a4 , 14");
asm(".set abiname_a5 , 15");
asm(".set abiname_a6 , 16");
asm(".set abiname_a7 , 17");
asm(".set abiname_s2 , 18");
asm(".set abiname_s3 , 19");
asm(".set abiname_s4 , 20");
asm(".set abiname_s5 , 21");
asm(".set abiname_s6 , 22");
asm(".set abiname_s7 , 23");
asm(".set abiname_s8 , 24");
asm(".set abiname_s9 , 25");
asm(".set abiname_s10 , 26");
asm(".set abiname_s11 , 27");
asm(".set abiname_t3 , 28");
asm(".set abiname_t4 , 29");
asm(".set abiname_t5 , 30");
asm(".set abiname_t6 , 31");

///////////
#define SIMD_ADD(src1, src2, result) \
asm volatile(  \
".word ((0b0000011 << 25) | (abiname_%2 << 20) | (abiname_%1 << 15) | (0b000 << 12) | (abiname_%0 << 7) | 0b0110011) \n\t" \
: "=r"(result)    \
: "r" (src1), "r" (src2) \
)
`
Place the above piece in the main.c, you can call SIMD_ADD( a,b,c); in the void main() function.

Let me know if you need the definition to include the above plugin in Murax configuration.

NOTE: Although it is called SIMD_ADD, the functionality in the plugin is changed to desired functionality.

karegoud, 2024-10-05:
May I get the definition to include plugin in Murax configuration

ashuthosh-mr, 2024-11-20:
You can include in the cpu plugins of the file Murax.scala inside demo folder. Add the SimdAdd plugin. You can refer to GenwithSimdaddplugin.scala. Hope that helps.

Closed 2022-11-11.

Thread 296 (2023-01-17):

Illegal instruction execptions during speculative execution with branch prediction not being aborted properly?

bunnie, 2023-01-17:
The setup is a VexRiscV RV-32IMAC core with STATIC branch prediction enabled, running code in SV32 mode (MMU on).

The code in question looks like this:

```
ffd0e7f0 <memcpy>:
ffd0e7f0:	00000317          	auipc	t1,0x0
ffd0e7f4:	ed630067          	jr	-298(t1) # ffd0e6c0 <compiler_builtins::mem::memcpy>
ffd0e7f8:         <illegal instruction>
ffd0e7fa:         <illegal instruction>
```

What happens in this case is that the pipeline fetches the `jr` instruction at `ffd0e7f4`, and because `static` prediction is on, it will dutifully also fetch whatever is at `ffd0e7f8` and `ffd0e7fa` and try to execute them.

However, if those are illegal instructions, an illegal instruction trap is thrown, and the CPU handles it even though it's due to instructions that should never have been executed in the first place.

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

Above is a trace of the execution at the moment this happens.

The top line is the execution PC. I have highlighted in yellow the two instructions that are fetched, but are bogus (I think in this case the first one actually decodes, the second one is illegal).

Instead of going to the jump target specified at 0xffd0e6c0, it goes to 0xffd00640 -- the location of the trap handler. You can see that `exceptionValid` is thrown, with a payload code of `2` which is an illegal instruction.

I *think* this is actually a CPU bug, because I would imagine that instructions being speculatively executed should have no impact on the pipeline if they are on the "not taken" path -- even if they are illegal instructions? I can't find mention of how this is to be handled in the RISC-V spec, though.

Normally this doesn't show up because most branches are followed by "legal instructions", but in this case, these are the very last instruction in the `.text` region, which turns out to be a `jr`, and immediately adjacent is `.rodata` which can contain some stuff that isn't guaranteed to be legal (turns out it often is a legal instruction...but not always!).

For now I have a work-around of sticking an "endcap" of NOP instructions after the last bit of code loaded into the `.text` region. Curious if you think this is actually a bug or not @Dolu1990 ?

Dolu1990, 2023-01-17:
Hi,
Yes it is a bug.
I tried to reproduce the issue but unsucessfuly.
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
```asm
80000000 <_start>:
80000000:	0100006f          	j	80000010 <jump1>

80000004 <jump2>:
80000004:	0300006f          	j	80000034 <pass>
	...

80000010 <jump1>:
80000010:	00000013          	nop
80000014:	00000317          	auipc	t1,0x0
80000018:	ff030067          	jr	-16(t1) # 80000004 <jump2>
	...
80000024:	0040006f          	j	80000028 <fail>
```

So a few questions :
- Can you send me the full wave file (all the signals of the CPU)?
- What CPU configuration do you have ? (especialy i$ ? d$ ?)

Dolu1990, 2023-01-17:
Hoo also, which VexRiscv githash were you using ?

bunnie, 2023-01-17:
I'm diverged slightly from the main branch because I haven't re-merged after you accepted the PR:

```
commit 2297f8aea0133f3304bdc6493bdb157d66fce63d (HEAD -> expose-satp, buncram/expose-satp)
Author: buncram <cramium@kosagi.com>
Date:   Mon Jan 16 02:16:25 2023 +0800

    also need to expose privilege state

    turns out SATP is not enough to figure out what code you're running,
    because the kernel code is mapped into all userspace's virtual memory
    areas. You also need the privilege state to be exported.

    This creates an option to export those bits.

commit 11f391eadf21fe96ef5b50d6f67512c5f2d42226
Merge: b8604790 bf3521f8
Author: buncram <cramium@kosagi.com>
Date:   Tue Dec 20 19:31:15 2022 +0800

    Merge remote-tracking branch 'origin/expand-satp' into expose-satp

commit bf3521f86a424736168fec1741e4a187fc758cad (origin/expand-satp)
Author: bunnie <bunnie@kosagi.com>
Date:   Tue Dec 20 19:25:47 2022 +0800

    Expand SATP register to 22 bits per spec

    Vex only implements a 32-bit PA which does not take advantage
    of the potetnial 32-bit space in Sv32 mode. Very reasonably,
    Vex simply discards the top two unused bits.

    However, the spec does require that the register occupy all 22
    bits and it is possible for the OS to use the extra bits up top
    for some bookkeeping purpose. This commit proposes to expand the
    register to occupy the full 22 bits in case an OS is written
    to utilize the full width of the register as written in the spec.

commit b86047901ae55a3ea0dc892acf1e72c2f0012118
Author: buncram <cramium@kosagi.com>
Date:   Mon Dec 19 19:03:33 2022 +0800

    add flag to expose SATP externally

commit 51b69a1527c01616f386fa5cffb993313bfec919 (spinalhdl/master, buncram/master)
Merge: 87c8822f 773f268f
Author: Dolu1990 <charles.papon.90@gmail.com>
Date:   Mon Dec 5 20:10:58 2022 +0100

    SpinalHDL 1.8.0
```

So basically based off of 51b69a1527c01616f386fa5cffb993313bfec919 (which should be in your tree); 2297f8aea0133f3304bdc6493bdb157d66fce63d from my tree (https://github.com/buncram/VexRiscv).

I should rebase to your branch now that the PR has been absorbed...

Dolu1990, 2023-01-17:
Hmm, can't reproduce the issue. Note i'm using Verilator which do not have x-propagation, so it may be related to that, as i can see there is some X in the data path.

So, the issue i have is that the wave you send do not have some key signal to debug.

Would there be a way for me to run your simulation on my side ?

bunnie, 2023-01-17:
Hm yah, I could see this just being an X-propagation thing that leads to a signal being interpreted in a weird way. Maybe in synthesized hardware the bug can't even trigger?

Anyways, let me try to prepare a script + artifacts so you can run with a single command line and an archive. It'll take a couple hours because I'm still running a simulation right now that will take another hour to finish.

Sounds like you have access to Xilinx `xsim`, so if I prepared an archive + gave you a command line you should be able to fire up the simulation.

bunnie, 2023-01-17:
Alright, I've packed up the simulation so you should be able to just unzip and run it:

https://bunniefoo.com/bunnie/vexsim.zip

Unzip, and go into the vexsim directory, and run this command:

`xsim top_tb_fpga_sim -gui`

Should just be able to just hit the play button, set it for about 130ms (milliseconds) run-to duration, and then come back about an hour later, you should see a result a bit like this:

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

bunnie, 2023-01-17:
Confirmed glbl.v is missing, here it is:

https://bunniefoo.com/bunnie/glbl.v

Dolu1990, 2023-01-18:
> Hm yah, I could see this just being an X-propagation thing that leads to a signal being interpreted in a weird way. Maybe in synthesized hardware the bug can't even trigger?

Yes, this is a possibility, kind of a pain to have to deal with simulation artefacts.
I'm not saying it is the issue, but can be.

 > https://bunniefoo.com/bunnie/VexRiscv_CramSoC.v

The requested URL /bunnie/VexRiscv_CramSoC.v was not found on this server.

Thanks :)

bunnie, 2023-01-18:
oops! fixed now.

Dolu1990, 2023-01-18:
(Note that all the verification of VexRiscv is done with Verilator, which doesn't do x-prop)

Thanks ^^

Dolu1990, 2023-01-18:
Get a :

```
xsim top_tb_fpga_sim -gui
ERROR: Please check the snapshot name which is created during 'xelab',the current snapshot name "xsim.dir/top_tb_fpga_sim/xsimk" does not exist
```

Do you know what kind of magic it is ?

Dolu1990, 2023-01-18:
Ahhh my bad for that one i missed one command.

New error =>
Cannot find design unit work.test_tb_fpga

Dolu1990, 2023-01-18:
So, seems like the test_tb_fpga module is missing ?

bunnie, 2023-01-18:
My bad, I gave the wrong command (I used `test` instead of `top`; normally this is filled in by my script, I translated by hand):

`xelab -debug off top_tb_fpga glbl -s top_tb_fpga_sim -L unisims_ver -L unimacro_ver -L SIMPRIM_VER -L secureip -L $xsimdir/xil_defaultlib -timescale 1ns/1ps`

Dolu1990, 2023-01-18:
Thanks, simulation is running now ^^

Dolu1990, 2023-01-18:
So, yeah, it was false positive xprop :
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

Basicaly, in VexRiscv, there is multiple interface which can ask to jump somwere, and they are ordered with some priorities.
Here, in yellow, is your JR instruction correcting the CPU excecution path via the Branch plugin.
But at the same time, there is the fetch predictor (cyan) which get confused because of x-prop.

Even if that fetch predictor has less priority than the Branch plugin, because of simulation only xprop, it mess up priority logic.

So, overall the question now is how to avoid those simlation artefacts :
- I would say, having memories initialized with values instead of X may be enough.
- I don't know if there is xsim option to avoid X initialisation, and instead having random values.
- Else could implement some counter mesure in the VexRiscv for simulation purposes, but don't know how deep this would need to be digged in.

Thanks for the xsim testbench :D

bunnie, 2023-01-18:
Thanks for running the analysis! When the kernel actually boots (instead of crashing) you can get the whole console log and everything printing out, and the results very closely match what happens on real hardware.

I'm trying to trace back where the X-prop originally comes from. I can see in the simulation that the predicted memory location being fetched has a value, it is not X -- at least, I can see the write to SRAM happening, during the initialization phase, and I would imagine this would be fetched in as part of a full cache line anyways. The memory layout is `.text` followed by `.sdata` directly, and the loader copies everything without skipping any locations. Besides, for the SRAM model, I do actually set `0` to all locations on testbench init, to avoid x-prop issues.

So I guess that leaves the question of where the X is coming from.

I will run the simulation again and have a look back in the pipeline to try and find where the X-value comes from, since there should be no X-memory at that point in execution, and let you know if I find anything interesting.

Dolu1990, 2023-01-18:
hmmm i'm taking a look too

Dolu1990, 2023-01-18:
Ahhhhh XD
Found it. So basicaly it come from the RVC decompressor.
When 16 bits instruction is out of the specification, in VexRiscv it is set to "don't care" 32 bits decompressed instruction.
decompressed := 32'hXXXXXXXX
Because anyway, that value will not be used and it will instead

I pushed the fix in both dev and master branch.

Thanks :D

Dolu1990, 2023-01-18:
So, with that fix :
- In real hardware and in simulation, it allows to properly catch illegal RVC instruction
- In simulation, it will also avoid this x-prop of doom

Dolu1990, 2023-01-18:
I'm running now a sim with the fix

Turned
IBusCachedPlugin_decompressor_decompressed = 32'bxxxxxxxxxxxxxxxxxxxxxxxxxxxxxxxx; // @[Bits.scala 231:20]
into
IBusCachedPlugin_decompressor_decompressed = 32'd0; // @[Bits.scala 231:20]

Dolu1990, 2023-01-18:
Seems like in simulation it fixed it.

bunnie, 2023-01-18:
Awesome! I will pull in the fix then. I think we're all set! thanks for the speedy fix.

bunnie, 2023-01-18:
Confirmed fixed in my simulation as well. thanks!

Closed 2023-01-18.

Thread 297 (2023-02-03):

Zephyr - new FPU context switch not working in VexRiscV-smp CPU

pottendo, 2023-02-03:
hi,
upfront, I hope this isn't too off-topic for this project. Let me know and in case direct me to the correct place, e.g. the LiteX repo...  thanx.

Summary: Zephyr 3.3-RC1 introduced a new (optimized) handling of FPU register saving in mutli-threaded applications (context switch).
[My Litex-project](https://github.com/pottendo/RVCop64-pottendo) uses a VexRiscV-smp SoftCPU core.
I got basic Zephyr running on this project by just providing a matching devicetree - find the links in the issue report.

Find all details to [this](https://github.com/zephyrproject-rtos/zephyr/issues/54205) issue in the Zephyr repository.
The Zephyr author @npitre suggests:
```
Alright. Since you do have access to the CPU implementation source code,
I think it would be far better for you to figure out how to support the
MSTATUS_FS bits in your project.
```

So as I haven't managed to get it going on my own, I ask you experts here!
As a fallback I could revert to 3.2.99 version of Zephyr's FPU code; but I'd like to understand if the problem is either in my Zephyr port, my RiscV Litex project or even something which would be required to be fixed/added in the VexRiscV-smp CPU itself.
If it's the very last reason, other's may encounter this problem as well.

Thanks for any feedback, pottendo

Dolu1990, 2023-02-03:
Hi,

I wasn't aware of that issue.

So, there is a few things we can do to have a better diagnostic :
1) Run the software while the dirty flag is always forced to see if the bug is still there

https://github.com/SpinalHDL/VexRiscv/blob/master/src/main/scala/vexriscv/plugin/FpuPlugin.scala#L216
```scala
 val fs = Reg(Bits(2 bits)) init(1)
 Would become
 val fs = U"11"
```

2) Do you have a simulation which could be used to reproduce the issue ? Inclusing software source code / binary in elf format or .asm

One possibility is that it come from a "recently" added privileged feature missing in VexRiscv, or just something buggy in the core.

Thanks ^^
Charles

npitre, 2023-02-03:
The latest Zephyr code relies on two things from the spec to work properly:

- any modification to the FPU register file must change the mstatus_fs bits to "dirty" (0b11);

- any access to the FPU (including fcsr, frm and fflags) when mstatus_fs is set to "off" (0b00) must raise an illegal instruction fault instead, preferably with the actual instruction value stored in MTVAL as well.

And, per the spec, mstatus_fs being "off" doesn't mean the FPU is powered off. It must retain its state. This is only about accessing it.

Accommodations are possible in software if the above is not possible, but overall performance would be degraded.

pottendo, 2023-02-03:
Hi Charles,
thanks for the quick feedback.
ad 2) No, I only have the HW (ECP5 FPGA) and a working LiteX build-env as suggested by the original devloper. Sorry.

ad 1) I've changed the FpuPlugin as instructed, but I think the scala compiler didn't execute (note that the project is a LiteX project) - or I didn't notice it. How can I double-check if the change really arrived? How can I force to rebuild from the scala code in LiteX?

The change in Zephyr is recent - with the previous version it has been working. I don't think this has something to do with privileged execution; See [here](https://github.com/zephyrproject-rtos/zephyr/pull/53978)

I'm really a rookie on this level of programming - so no surprise that I have to bother with that basics!
bye, pottendo

pottendo, 2023-02-04:
Hi Charles,
found out how to recompile and tried your proposed change.

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

This won't compile unfortunately:
```
[info] running (fork) vexriscv.demo.smp.VexRiscvLitexSmpClusterCmdGen --cpu-count=1 --ibus-width=64 --dbus-width=64 --dcache-size=4096 --icache-size=4096 --dcache-ways=1 --icache-ways=1 --litedram-width=32 --aes-instruction=False --out-of-order-decoder=True --wishbone-memory=True --fpu=True --cpu-per-fpu=4 --rvc=True --netlist-name=VexRiscvLitexSmpCluster_Cc1_Iw64Is4096Iy1_Dw64Ds4096Dy1_ITs4DTs4_Ood_Wm_Fpu4_Rvc --netlist-directory=/opt/work/src/orangeCart/RVCop64-pottendo/hw/deps/pythondata-cpu-vexriscv_smp/pythondata_cpu_vexriscv_smp/verilog --dtlb-size=4 --itlb-size=4
[info] [Runtime] SpinalHDL dev    git head : 020da4e21c6d2114872a623780763f818f346e6e
[info] [Runtime] JVM max memory : 3988.0MiB
[info] [Runtime] Current date : 2023.02.04 16:11:21
[info] [Progress] at 0.000 : Elaborate components
[info] [Progress] at 1.376 : Checks and transforms
[info] **********************************************************************************************
[info] [Warning] Elaboration failed (2 errors).
[info]           Spinal will restart with scala trace to help you to find the problem.
[info] **********************************************************************************************
[info] [Progress] at 1.856 : Elaborate components
[info] [Progress] at 2.314 : Checks and transforms
[error] Exception in thread "main" spinal.core.SpinalExit:
[error]  Error detected in phase PhaseCheckCombinationalLoops
[error] ********************************************************************************
[error] ********************************************************************************
[error] COMBINATORIAL LOOP :
[error]   Partial chain :
[error]     >>> (toplevel/cores_0_cpu_logic_cpu/CsrPlugin_csrMapping_readDataSignal :  Bits[32 bits]) at vexriscv.plugin.CsrMapping.<init>(CsrPlugin.scala:352) >>>
[error]     >>> (toplevel/cores_0_cpu_logic_cpu/execute_CsrPlugin_readToWriteData :  Bits[32 bits]) at jdk.internal.reflect.GeneratedConstructorAccessor5.newInstance(Unknown Source) >>>
[error]     >>> (toplevel/cores_0_cpu_logic_cpu/??? :  Bits[32 bits]) at vexriscv.plugin.CsrPlugin$$anon$16$$anon$23.<init>(CsrPlugin.scala:1184) >>>
[error]     >>> (toplevel/cores_0_cpu_logic_cpu/CsrPlugin_csrMapping_writeDataSignal :  Bits[32 bits]) at vexriscv.plugin.CsrMapping.<init>(CsrPlugin.scala:352) >>>
[error]     >>> (toplevel/cores_0_cpu_logic_cpu/FpuPlugin_fs :  UInt[2 bits]) at vexriscv.plugin.FpuPlugin$$anon$2.<init>(FpuPlugin.scala:216) >>>
[error]     >>> (toplevel/cores_0_cpu_logic_cpu/??? :  Bits[32 bits]) at vexriscv.plugin.CsrPlugin$$anon$16$$anon$23$$anonfun$27$$anonfun$apply$mcV$sp$42.apply(CsrPlugin.scala:1284) >>>
[error]     >>> (toplevel/cores_0_cpu_logic_cpu/CsrPlugin_csrMapping_readDataInit :  Bits[32 bits]) at vexriscv.plugin.CsrMapping.<init>(CsrPlugin.scala:352) >>>
[error]   Full chain :
[error]     (toplevel/cores_0_cpu_logic_cpu/CsrPlugin_csrMapping_readDataSignal :  Bits[32 bits])
[error]     (toplevel/cores_0_cpu_logic_cpu/execute_CsrPlugin_readToWriteData :  Bits[32 bits])
[error]     (Bits & Bits)[32 bits]
[error]     (Bool ? Bits | Bits)[32 bits]
[error]     (toplevel/cores_0_cpu_logic_cpu/??? :  Bits[32 bits])
[error]     (toplevel/cores_0_cpu_logic_cpu/CsrPlugin_csrMapping_writeDataSignal :  Bits[32 bits])
[error]     Bits(Int downto Int)
[error]     (Bits -> UInt of 2 bits)
[error]     (toplevel/cores_0_cpu_logic_cpu/FpuPlugin_fs :  UInt[2 bits])
[error]     (UInt -> Bits of 2 bits)
[error]     (toplevel/cores_0_cpu_logic_cpu/??? :  Bits[32 bits])
[error]     (Bits | Bits)[32 bits]
[error]     (Bits | Bits)[32 bits]
[error]     (Bits | Bits)[32 bits]
[error]     (Bits | Bits)[32 bits]
[error]     (Bits | Bits)[32 bits]
[error]     (toplevel/cores_0_cpu_logic_cpu/CsrPlugin_csrMapping_readDataInit :  Bits[32 bits])
[error] ********************************************************************************
[error] ********************************************************************************
[error] Design's errors are listed above.
[error] SpinalHDL compiler exit stack :
[error] 	at spinal.core.SpinalExit$.apply(Misc.scala:424)
[error] 	at spinal.core.SpinalError$.apply(Misc.scala:479)
[error] 	at spinal.core.internals.PhaseContext.checkPendingErrors(Phase.scala:175)
[error] 	at spinal.core.internals.PhaseContext.doPhase(Phase.scala:191)
[error] 	at spinal.core.internals.SpinalVerilogBoot$$anonfun$singleShot$2$$anonfun$apply$137.apply(Phase.scala:2714)
[error] 	at spinal.core.internals.SpinalVerilogBoot$$anonfun$singleShot$2$$anonfun$apply$137.apply(Phase.scala:2712)
[error] 	at scala.collection.mutable.ResizableArray$class.foreach(ResizableArray.scala:59)
[error] 	at scala.collection.mutable.ArrayBuffer.foreach(ArrayBuffer.scala:48)
[error] 	at spinal.core.internals.SpinalVerilogBoot$$anonfun$singleShot$2.apply(Phase.scala:2712)
[error] 	at spinal.core.internals.SpinalVerilogBoot$$anonfun$singleShot$2.apply(Phase.scala:2648)
[error] 	at spinal.core.ScopeProperty$.sandbox(ScopeProperty.scala:69)
[error] 	at spinal.core.internals.SpinalVerilogBoot$.singleShot(Phase.scala:2648)
[error] 	at spinal.core.internals.SpinalVerilogBoot$.apply(Phase.scala:2643)
[error] 	at spinal.core.Spinal$.apply(Spinal.scala:392)
[error] 	at spinal.core.SpinalConfig.generateVerilog(Spinal.scala:170)
[error] 	at vexriscv.demo.smp.VexRiscvLitexSmpClusterCmdGen$.delayedEndpoint$vexriscv$demo$smp$VexRiscvLitexSmpClusterCmdGen$1(VexRiscvSmpLitexCluster.scala:201)
[error] 	at vexriscv.demo.smp.VexRiscvLitexSmpClusterCmdGen$delayedInit$body.apply(VexRiscvSmpLitexCluster.scala:103)
[error] 	at scala.Function0$class.apply$mcV$sp(Function0.scala:34)
[error] 	at scala.runtime.AbstractFunction0.apply$mcV$sp(AbstractFunction0.scala:12)
[error] 	at scala.App$$anonfun$main$1.apply(App.scala:76)
[error] 	at scala.App$$anonfun$main$1.apply(App.scala:76)
[error] 	at scala.collection.immutable.List.foreach(List.scala:392)
[error] 	at scala.collection.generic.TraversableForwarder$class.foreach(TraversableForwarder.scala:35)
[error] 	at scala.App$class.main(App.scala:76)
[error] 	at vexriscv.demo.smp.VexRiscvLitexSmpClusterCmdGen$.main(VexRiscvSmpLitexCluster.scala:103)
[error] 	at vexriscv.demo.smp.VexRiscvLitexSmpClusterCmdGen.main(VexRiscvSmpLitexCluster.scala)
[error] Nonzero exit code returned from runner: 1
[error] (Compile / runMain) Nonzero exit code returned from runner: 1
[error] Total time: 98 s (01:38), completed Feb 4, 2023, 4:11:24 PM

```
Reverting the change and building results in a working bitstream. So I assume, my build-system to be OK.

bye, pottendo

pottendo, 2023-02-04:
...one more observation: I ported my test-program (mandelbrot set) to Linux, booted on the same machine. *)
Building with FPU instructions seems to have a similar problem (fast but wrong result)
Double checking without FPU instructions, the program works as expected (much slower of course).

Maybe this helps to reproduce on other VexRiscV-smp systems?

bye, pottendo

*) managed to get [this](https://github.com/litex-hub/linux-on-litex-vexriscv) project running on my FPGA board.

Dolu1990, 2023-02-06:
@npitre

> any access to the FPU (including fcsr, frm and fflags) when mstatus_fs is set to "off" (0b00) must raise an illegal instruction fault instead

Ahhh that's the missing feature !
Thanks :D
I will fix it.

Dolu1990, 2023-02-06:
@pottendo  With https://github.com/SpinalHDL/VexRiscv/commit/9acc5ddc1c444aa2da9100b1edc99eb5c1dc6b98 it should be good i think.
Let's me know how things goes :)
I'm currentl letting the regression run to see if that broke nothing.

pottendo, 2023-02-06:
> @pottendo With [9acc5dd](https://github.com/SpinalHDL/VexRiscv/commit/9acc5ddc1c444aa2da9100b1edc99eb5c1dc6b98) it should be good i think.
> Let's me know how things goes :)
hi,
will do tonight. Thanks for taking care!
pottendo

pottendo, 2023-02-06:
@Dolu1990, I see your dev branch is incorporating a few more changes - shall I apply the full change or just the Fpu related one?

Dolu1990, 2023-02-06:
Just that specific change should be good.

pottendo, 2023-02-06:
Hi Charles,
some good news: your patch on FpuPlugin.scala did the job for my test-case (mandelbrot set) on _Zephyr_.

However, not _yet perfect_ though as the zephyr test-suite still results in some fails:
```
*** Booting Zephyr OS build v3.3.0-rc2-21-g56d628c083a8 ***
Running TESTSUITE riscv_fpu_sharing
===================================================================
START - test_basics

    Assertion failed at WEST_TOPDIR-pottendo/tests/arch/riscv/fpu_sharing/src/main.c:58: riscv_fpu_sharing_test_basics: fpu_is_clean() is false

 FAIL - test_basics in 0.006 seconds
===================================================================
START - test_fp_insn_trap

    Assertion failed at WEST_TOPDIR-pottendo/tests/arch/riscv/fpu_sharing/src/main.c:383: riscv_fpu_sharing_test_fp_insn_trap: !fpu_is_off() is false

 FAIL - test_fp_insn_trap in 0.007 seconds
===================================================================
START - test_multi_thread_interaction

    Assertion failed at WEST_TOPDIR-pottendo/tests/arch/riscv/fpu_sharing/src/main.c:90: new_thread_check: (fpu_is_clean() is false)
FPU not clean after read
 FAIL - test_multi_thread_interaction in 0.007 seconds
===================================================================
START - test_thread_vs_exc_interaction

    Assertion failed at WEST_TOPDIR-pottendo/tests/arch/riscv/fpu_sharing/src/main.c:326: riscv_fpu_sharing_test_thread_vs_exc_interaction: fpu_is_off() is false

 FAIL - test_thread_vs_exc_interaction in 0.006 seconds
===================================================================
TESTSUITE riscv_fpu_sharing failed.

------ TESTSUITE SUMMARY START ------

SUITE FAIL -   0.00% [riscv_fpu_sharing]: pass = 0, fail = 4, skip = 0, total = 4 duration = 0.026 seconds
 - FAIL - [riscv_fpu_sharing.test_basics] duration = 0.006 seconds
 - FAIL - [riscv_fpu_sharing.test_fp_insn_trap] duration = 0.007 seconds
 - FAIL - [riscv_fpu_sharing.test_multi_thread_interaction] duration = 0.007 seconds
 - FAIL - [riscv_fpu_sharing.test_thread_vs_exc_interaction] duration = 0.006 seconds

------ TESTSUITE SUMMARY END ------

===================================================================
PROJECT EXECUTION FAILED
```
You find the tests [here](https://github.com/zephyrproject-rtos/zephyr/tree/main/tests/arch/riscv/fpu_sharing/src).

More serious is that Linux is **not** booting anymore - **the patch may break other Linux-systems as well!**:
```
Platform Name       : LiteX / VexRiscv-SMP
Platform Features   : timer,mfdeleg
Platform HART Count : 8
Boot HART ID        : 0
Boot HART ISA       : rv32imafdcs
BOOT HART Features  : time
BOOT HART PMP Count : 0
Firmware Base       : 0x40f00000
Firmware Size       : 124 KB
Runtime SBI Version : 0.2

MIDELEG : 0x00000222
MEDELEG : 0x0000b101
[    0.000000] Linux version 6.1.0-rc2 (pottendo@hansi) (riscv32-buildroot-linux-gnu-gcc.br_real (Buildroot 2022.11-rc3-30-ge87d929666) 11.3.0, GNU ld (GNU Binutils) 2.38) #2 SMP Sat Jan 28 12:33:39 CET 2023
[    0.000000] earlycon: liteuart0 at I/O port 0x0 (options '')
[    0.000000] Malformed early option 'console'
[    0.000000] earlycon: liteuart0 at MMIO 0xf0001000 (options '')
[    0.000000] printk: bootconsole [liteuart0] enabled
[    0.000000] INITRD: 0x41000000+0x00800000 is not a memory region - disabling initrd
[    0.000000] Zone ranges:
[    0.000000]   Normal   [mem 0x0000000040000000-0x0000000040ffffff]
[    0.000000] Movable zone start for each node
[    0.000000] Early memory node ranges
[    0.000000]   node   0: [mem 0x0000000040000000-0x0000000040ffffff]
[    0.000000] Initmem setup node 0 [mem 0x0000000040000000-0x0000000040ffffff]
[    0.000000] SBI specification v0.2 detected
[    0.000000] SBI implementation ID=0x1 Version=0x8
[    0.000000] SBI TIME extension detected
[    0.000000] SBI IPI extension detected
[    0.000000] SBI RFENCE extension detected
[    0.000000] SBI HSM extension detected
[    0.000000] riscv: base ISA extensions acdfim
[    0.000000] riscv: ELF capabilities acdfim
[    0.000000] percpu: Embedded 8 pages/cpu s11264 r0 d21504 u32768
[    0.000000] Built 1 zonelists, mobility grouping off.  Total pages: 4064
[    0.000000] Kernel command line: console=liteuart earlycon=liteuart,0xf0001000 rootwait root=/dev/mmcblk0p2
[    0.000000] Dentry cache hash table entries: 2048 (order: 1, 8192 bytes, linear)
[    0.000000] Inode-cache hash table entries: 1024 (order: 0, 4096 bytes, linear)
[    0.000000] mem auto-init: stack:off, heap alloc:off, heap free:off
[    0.000000] Memory: 9044K/16384K available (5052K kernel code, 355K rwdata, 840K rodata, 202K init, 180K bss, 7340K reserved, 0K cma-reserved)
[    0.000000] SLUB: HWalign=64, Order=0-3, MinObjects=0, CPUs=1, Nodes=1
[    0.000000] rcu: Hierarchical RCU implementation.
[    0.000000] rcu: 	RCU restricting CPUs from NR_CPUS=32 to nr_cpu_ids=1.
[    0.000000] rcu: RCU calculated value of scheduler-enlistment delay is 10 jiffies.
[    0.000000] rcu: Adjusting geometry for rcu_fanout_leaf=16, nr_cpu_ids=1
[    0.000000] NR_IRQS: 64, nr_irqs: 64, preallocated irqs: 0
[    0.000000] riscv-intc: 32 local interrupts mapped
[    0.000000] plic: interrupt-controller@f0c00000: mapped 32 interrupts with 1 handlers for 2 contexts.
[    0.000000] rcu: srcu_init: Setting srcu_struct sizes based on contention.
[    0.000000] riscv-timer: riscv_timer_init_dt: Registering clocksource cpuid [0] hartid [0]
[    0.000000] clocksource: riscv_clocksource: mask: 0xffffffffffffffff max_cycles: 0x127350b881, max_idle_ns: 440795202125 ns
[    0.000156] sched_clock: 64 bits at 80MHz, resolution 12ns, wraps every 4398046511100ns
[    0.019043] Console: colour dummy device 80x25
[    0.025047] Calibrating delay loop (skipped), value calculated using timer frequency.. 160.00 BogoMIPS (lpj=800000)
[    0.032636] pid_max: default: 32768 minimum: 301
[    0.072882] Mount-cache hash table entries: 1024 (order: 0, 4096 bytes, linear)
[    0.080142] Mountpoint-cache hash table entries: 1024 (order: 0, 4096 bytes, linear)
[    0.366047] ASID allocator using 9 bits (512 entries)
[    0.397480] rcu: Hierarchical SRCU implementation.
[    0.400590] rcu: 	Max phase no-delay instances is 1000.
[    0.474295] smp: Bringing up secondary CPUs ...
[    0.477015] smp: Brought up 1 node, 1 CPU
[    0.548890] devtmpfs: initialized
[    0.799629] clocksource: jiffies: mask: 0xffffffff max_cycles: 0xffffffff, max_idle_ns: 19112604462750000 ns
[    0.805298] futex hash table entries: 256 (order: 2, 16384 bytes, linear)
[    1.064023] NET: Registered PF_NETLINK/PF_ROUTE protocol family
[    2.633630] usbcore: registered new interface driver usbfs
[    2.646244] usbcore: registered new interface driver hub
[    2.657912] usbcore: registered new device driver usb
[    2.690877] pps_core: LinuxPPS API ver. 1 registered
[    2.693867] pps_core: Software ver. 5.3.6 - Copyright 2005-2007 Rodolfo Giometti <giometti@linux.it>
[    2.703112] PTP clock support registered
[    2.739357] FPGA manager framework
[    2.854676] clocksource: Switched to clocksource riscv_clocksource
[    5.087978] workingset: timestamp_bits=30 max_order=12 bucket_order=0
[    7.235663] io scheduler mq-deadline registered
[    7.241396] io scheduler kyber registered
[    7.395700] LiteX SoC Controller driver initialized
[   19.825031] f0001000.serial: ttyLXU0 at MMIO 0x0 (irq = 0, base_baud = 0) is a liteuart
[   19.835563] printk: console [liteuart0] enabled
[   19.835563] printk: console [liteuart0] enabled
[   19.842906] printk: bootconsole [liteuart0] disabled
[   19.842906] printk: bootconsole [liteuart0] disabled
[   19.906576] f0004800.serial: ttyLXU1 at MMIO 0x0 (irq = 0, base_baud = 0) is a liteuart
[   20.214475] usbcore: registered new interface driver ftdi_sio
[   20.224921] usbserial: USB Serial support registered for FTDI USB Serial Device
[   20.231241] i2c_dev: i2c /dev entries driver
[   20.363112] mmc_spi spi0.0: SD/MMC host mmc0, no WP, no poweroff, cd polling
[   20.498345] usbcore: registered new interface driver usbhid
[   20.504198] usbhid: USB HID core driver
[   20.706008] Waiting for root device /dev/mmcblk0p2...
[   20.737859] mmc0: host does not support reading read-only switch, assuming write-enable
[   20.746230] mmc0: new SDXC card on SPI
[   20.883125] mmcblk0: mmc0:0000 SC64G 59.5 GiB
[   21.146296]  mmcblk0: p1 p2
[   23.303332] EXT4-fs (mmcblk0p2): mounted filesystem without journal. Quota mode: disabled.
[   23.314020] VFS: Mounted root (ext4 filesystem) readonly on device 179:2.
[   24.273907] devtmpfs: mounted
[   24.297809] Freeing unused kernel image (initmem) memory: 196K
[   24.304704] Kernel memory protection not selected by kernel config.
[   24.310697] Run /sbin/init as init process
[   30.115385] init[1]: unhandled signal 4 code 0x1 at 0x95b2f658 in ld-linux-riscv32-ilp32d.so.1[95b1e000+18000]
[   30.126632] CPU: 0 PID: 1 Comm: init Not tainted 6.1.0-rc2 #2
[   30.133444] epc : 95b2f658 ra : 95b2a9ec sp : 9d9d1530
[   30.137246]  gp : c064d870 tp : 00000000 t0 : 6ffffe38
[   30.143664]  t1 : 95b1eaec t2 : 00000035 s0 : 95b38a84
[   30.147266]  s1 : 95b38ae0 a0 : 9d9d1550 a1 : 00000000
[   30.153255]  a2 : 9d9d16e8 a3 : 00000024 a4 : 693a9f4c
[   30.157240]  a5 : 9d9d1548 a6 : 8f070303 a7 : 4824160a
[   30.163671]  s2 : 95b38ae0 s3 : 9d9d1680 s4 : 693a9f3c
[   30.167245]  s5 : 00000000 s6 : 00000000 s7 : 9d9d1680
[   30.173270]  s8 : 00000001 s9 : 9d9d1680 s10: 69450ef4
[   30.177272]  s11: 95b37e80 t3 : 95b2a99e t4 : 95b1d118
[   30.183687]  t5 : 95b1d12c t6 : 6fffff44
[   30.186992] status: 00000020 badaddr: 02853c27 cause: 00000002
[   30.196133] Kernel panic - not syncing: Attempted to kill init! exitcode=0x00000004
[   30.199836] CPU: 0 PID: 1 Comm: init Not tainted 6.1.0-rc2 #2
[   30.204402] Call Trace:
[   30.207183] [<c0003d10>] dump_backtrace+0x2c/0x3c
[   30.211623] [<c04dcb24>] show_stack+0x44/0x5c
[   30.216092] [<c04e6bc4>] dump_stack_lvl+0x58/0x7c
[   30.220620] [<c04e6c04>] dump_stack+0x1c/0x2c
[   30.225097] [<c04dcd40>] panic+0x130/0x2f8
[   30.229503] [<c000ff50>] do_exit+0x82c/0x834
[   30.234054] [<c00100c8>] do_group_exit+0x38/0x9c
[   30.238569] [<c001dab4>] get_signal+0x8b8/0x8e8
[   30.243101] [<c0002e7c>] do_notify_resume+0x90/0x368
[   30.247631] [<c00023a0>] ret_from_exception+0x0/0x10
[   30.252783] ---[ end Kernel panic - not syncing: Attempted to kill init! exitcode=0x00000004 ]---
```
I double checked booting the previous version (without the FPU plugin patch) succefully booting the same Linux Image.
The exception is raised by the shared library `ld-linux-riscv32-ilp32d.so.1` with code `4` - this is an illegal instruction (IIRC).
I don't see a way to tell buildroot anything differently to generate a different library or use different instruction sets.

All the best and thanks for this great project - all efforts here are much appreciated!
br, pottendo

Dolu1990, 2023-02-07:
Hi @pottendo

>     Assertion failed at WEST_TOPDIR-pottendo/tests/arch/riscv/fpu_sharing/src/main.c:58: riscv_fpu_sharing_test_basics: fpu_is_clean() is false

This one is fine, basicaly, VexRiscv dirty tracking is very pessimitic and assume that any interraction with the FPU or CSR write to the FPU will make it dirty.
It is allowed by the spec :
"Implementations may choose to track the dirtiness of the floating-point register state imprecisely by reporting the state to be dirty even when it has not been modified."

>     Assertion failed at WEST_TOPDIR-pottendo/tests/arch/riscv/fpu_sharing/src/main.c:90: new_thread_check: (fpu_is_clean() is false)

Same

>     Assertion failed at WEST_TOPDIR-pottendo/tests/arch/riscv/fpu_sharing/src/main.c:326: riscv_fpu_sharing_test_thread_vs_exc_interaction: fpu_is_off() is false

Same, the test assume that  will not make the FPU dirty, but in VexRiscv it will.

> Assertion failed at WEST_TOPDIR-pottendo/tests/arch/riscv/fpu_sharing/src/main.c:383: riscv_fpu_sharing_test_fp_insn_trap: !fpu_is_off() is false

That one is actualy VexRiscv missspec, CSR read write should now also trap when FS==0 with that additional patch :
https://github.com/SpinalHDL/VexRiscv/commit/cbc89093b38db993ac1dd2f3f14de7eaf24e59be

> linux

That's more worrying
The linux one trap on a 0x02853c27 which is a  "fsd	fs0,56(a0)", while fs=0 (status: 00000020)

I have to check how linux handle the MMU :)

Let's me know how it goes with the https://github.com/SpinalHDL/VexRiscv/commit/cbc89093b38db993ac1dd2f3f14de7eaf24e59be patch :D

Best regards
Charles

npitre, 2023-02-07:
> "Implementations may choose to track the dirtiness of the floating-point register state imprecisely by reporting the state to be dirty even when it has not been modified."

How hard would it be to set the dirty state on writes only as opposed to set it on any access?

I'll adjust the Zephyrtest in the mean time.

npitre, 2023-02-08:
The amended Zephyr test is in branch "rvfputestdirty" of
https://github.com/npitre/zephyr/.
@pottendo: Could you give it a try?

Dolu1990, 2023-02-08:
> How hard would it be to set the dirty state on writes only as opposed to set it on any access?

@npitre Shouldn't be that hard, i will give a try as soon as the other issues in Vex are fixed (to avoid mixing fixes) ^^

pottendo, 2023-02-08:
> @pottendo: Could you give it a try?

hi,
will try today; however, I'll be off until the rest of the week, not able to access my setup. So it may last until the weekend for further tests from my side.
br, pottendo

pottendo, 2023-02-08:
Hi all,
things improved drastically! ;-)
```
--============= Liftoff! ===============--
*** Booting Zephyr OS build v3.3.0-rc2-21-g56d628c083a8 ***
Running TESTSUITE riscv_fpu_sharing
===================================================================
START - test_basics
 PASS - test_basics in 0.002 seconds
===================================================================
START - test_fp_insn_trap
 PASS - test_fp_insn_trap in 0.004 seconds
===================================================================
START - test_multi_thread_interaction
 PASS - test_multi_thread_interaction in 0.014 seconds
===================================================================
START - test_thread_vs_exc_interaction
 PASS - test_thread_vs_exc_interaction in 0.002 seconds
===================================================================
TESTSUITE riscv_fpu_sharing succeeded

------ TESTSUITE SUMMARY START ------

SUITE PASS - 100.00% [riscv_fpu_sharing]: pass = 4, fail = 0, skip = 0, total = 4 duration = 0.022 seconds
 - PASS - [riscv_fpu_sharing.test_basics] duration = 0.002 seconds
 - PASS - [riscv_fpu_sharing.test_fp_insn_trap] duration = 0.004 seconds
 - PASS - [riscv_fpu_sharing.test_multi_thread_interaction] duration = 0.014 seconds
 - PASS - [riscv_fpu_sharing.test_thread_vs_exc_interaction] duration = 0.002 seconds

------ TESTSUITE SUMMARY END ------

===================================================================
PROJECT EXECUTION SUCCESSFUL
```

This is the result after applying all proposed patches - so, Charles, one of the last two patches obviously made the system booting again - also Zephyr.
Also @npitre's patch on the test-program is applied here.
My test-program also runs fine.
Linux still to be done... stay tuned!

Great job guys!
pottendo

Dolu1990, 2023-02-08:
@pottendo

> Charles, one of the last two patches obviously made the system booting again

Nice ^^

> Linux still to be done... stay tuned!

So, do you mean it is still broken for linux ? or that you need test ?

Thanks  :)
Charles

npitre, 2023-02-08:
pottendo wrote:

"Also @npitre's patch on the test-program is applied here."

Looks like it was unnecessary. The imprecise dirty tracking was not
detected according to the test output.

pottendo, 2023-02-08:
@npitre, I've reverted your change and can confirm that all tests still pass.
@Dolu1990, in the meantime I've run also Linux - here it still fails:
```
[   24.311086] Run /sbin/init as init process
[   30.114352] init[1]: unhandled signal 4 code 0x1 at 0x95b12658 in ld-linux-riscv32-ilp32d.so.1[95b01000+18000]
[   30.125637] CPU: 0 PID: 1 Comm: init Not tainted 6.1.0-rc2 #2
[   30.132595] epc : 95b12658 ra : 95b0d9ec sp : 9d859530
[   30.136251]  gp : c064d870 tp : 00000000 t0 : 6ffffe38
[   30.142703]  t1 : 95b01aec t2 : 00000035 s0 : 95b1ba84
[   30.146659]  s1 : 95b1bae0 a0 : 9d859550 a1 : 00000000
[   30.152684]  a2 : 9d8596e8 a3 : 00000024 a4 : 69339f4c
[   30.156651]  a5 : 9d859548 a6 : 8f070303 a7 : 4824160a
[   30.163283]  s2 : 95b1bae0 s3 : 9d859680 s4 : 69339f3c
[   30.167251]  s5 : 00000000 s6 : 00000000 s7 : 9d859680
[   30.173275]  s8 : 00000001 s9 : 9d859680 s10: 693e0ef4
[   30.177278]  s11: 95b1ae80 t3 : 95b0d99e t4 : 95b00118
[   30.183694]  t5 : 95b0012c t6 : 6fffff44
[   30.186997] status: 00000020 badaddr: 02853c27 cause: 00000002
[   30.196137] Kernel panic - not syncing: Attempted to kill init! exitcode=0x00000004
[   30.199841] CPU: 0 PID: 1 Comm: init Not tainted 6.1.0-rc2 #2
[   30.204407] Call Trace:
[   30.207188] [<c0003d10>] dump_backtrace+0x2c/0x3c
[   30.211628] [<c04dcb24>] show_stack+0x44/0x5c
[   30.216097] [<c04e6bc4>] dump_stack_lvl+0x58/0x7c
[   30.220625] [<c04e6c04>] dump_stack+0x1c/0x2c
[   30.225102] [<c04dcd40>] panic+0x130/0x2f8
[   30.229507] [<c000ff50>] do_exit+0x82c/0x834
[   30.234059] [<c00100c8>] do_group_exit+0x38/0x9c
[   30.238575] [<c001dab4>] get_signal+0x8b8/0x8e8
[   30.243106] [<c0002e7c>] do_notify_resume+0x90/0x368
[
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

Thread 300 (2023-02-19):

Enabling RVC with IbusCachedPlugin causes compile failure

hpax, 2023-02-19:
HEAD: 2bc6e70f03edcacd875a4ec93714dc023ae136d3

How to reproduce:
Add:

        new IBusCachedPlugin(
          prediction = STATIC,
+	  compressedGen = true,
          config = InstructionCacheConfig(

... to src/main/scala/vexriscv/demo/GenFullNoMmu.scala causes a compile failure:

sbt 'runMain vexriscv.demo.GenFullNoMmu'
WARNING: A terminally deprecated method in java.lang.System has been called
WARNING: System::setSecurityManager has been called by sbt.TrapExit$ (file:/home/hpa/.sbt/boot/scala-2.12.12/org.scala-sbt/sbt/1.4.7/run_2.12-1.4.7.jar)
WARNING: Please consider reporting this to the maintainers of sbt.TrapExit$
WARNING: System::setSecurityManager will be removed in a future release
[info] welcome to sbt 1.4.7 (Red Hat, Inc. Java 17.0.6)
[info] loading settings for project git-build from plugins.sbt ...
[info] loading project definition from /home/hpa/hwhacks/riscv/vexriscv/git/project
[info] loading settings for project root from build.sbt ...
[info] set current project to VexRiscv (in build file:/home/hpa/hwhacks/riscv/vexriscv/git/)
[info] compiling 2 Scala sources to /home/hpa/hwhacks/riscv/vexriscv/git/target/scala-2.11/classes ...
[warn] there was one deprecation warning; re-run with -deprecation for details
[warn] one warning found
[info] running (fork) vexriscv.demo.GenFullNoMmu
[info] [Runtime] SpinalHDL v1.8.0    git head : 4e3563a282582b41f4eaafc503787757251d23ea
[info] [Runtime] JVM max memory : 16056.0MiB
[info] [Runtime] Current date : 2023.02.18 19:46:28
[info] [Progress] at 0.000 : Elaborate components
[info] [Warning] This VexRiscv configuration is set without software ebreak instruction support. Some software may rely on it (ex: Rust). (This isn't related to JTAG ebreak)
[info] PcManagerSimplePlugin is now useless
[info] **********************************************************************************************
[info] [Warning] Elaboration failed (0 error).
[info]           Spinal will restart with scala trace to help you to find the problem.
[info] **********************************************************************************************
[info] [Progress] at 0.535 : Elaborate components
[info] [Warning] This VexRiscv configuration is set without software ebreak instruction support. Some software may rely on it (ex: Rust). (This isn't related to JTAG ebreak)
[info] PcManagerSimplePlugin is now useless
[error] Exception in thread "main" java.lang.Exception: Missing inserts : INSTRUCTION_ANTICIPATED
[error]         at vexriscv.Pipeline$class.build(Pipeline.scala:95)
[error]         at vexriscv.VexRiscv.build(VexRiscv.scala:123)
[error]         at vexriscv.Pipeline$$anonfun$1.apply$mcV$sp(Pipeline.scala:161)
[error]         at spinal.core.Component$$anonfun$prePop$1.apply(Component.scala:180)
[error]         at spinal.core.Component$$anonfun$prePop$1.apply(Component.scala:178)
[error]         at scala.collection.mutable.ResizableArray$class.foreach(ResizableArray.scala:59)
[error]         at scala.collection.mutable.ArrayBuffer.foreach(ArrayBuffer.scala:48)
[error]         at spinal.core.Component.prePop(Component.scala:178)
[error]         at spinal.core.Component.postInitCallback(Component.scala:187)
[error]         at vexriscv.demo.GenFullNoMmu$.cpu(GenFullNoMmu.scala:12)
[error]         at vexriscv.demo.GenFullNoMmu$$anonfun$1.apply(GenFullNoMmu.scala:87)
[error]         at vexriscv.demo.GenFullNoMmu$$anonfun$1.apply(GenFullNoMmu.scala:87)
[error]         at spinal.core.internals.PhaseCreateComponent$$anonfun$impl$72.apply(Phase.scala:2435)
[error]         at spinal.core.fiber.Engine$$anonfun$create$1.apply$mcV$sp(AsyncCtrl.scala:147)
[error]         at spinal.core.fiber.AsyncThread$$anonfun$1.apply$mcV$sp(AsyncThread.scala:59)
[error]         at spinal.core.fiber.EngineContext$$anonfun$newJvmThread$1.apply$mcV$sp(AsyncCtrl.scala:39)
[error]         at spinal.sim.JvmThread.run(SimManager.scala:51)
[error] Nonzero exit code returned from runner: 1
[error] (Compile / runMain) Nonzero exit code returned from runner: 1
[error] Total time: 5 s, completed Feb 18, 2023, 7:46:29 PM

hpax, 2023-02-19:
Nevermind. I see this is an FAQ.

Closed 2023-02-19.

Thread 319 (2023-03-03):

Bug report: Writing to a CSR fails in rare microarchitectural conditions

flaviens, 2023-03-03:
Hi there!

I've detected a bug in VexRiscv.

## Brief bug description

In rare microarchitectural conditions, writing to fcsr does not succeed as expected. Instead, the CPU hangs or takes an exception.

## Example instances

I provide two ELF files that differ only by one non-taken branch. The first one (`buggy.elf`) executes this non-taken branch (at `PC=0x80001080`) correctly by not taking it and proceeds, but later the write to the CSR fails (at `PC=0x80098f00`). The second ELF (`success.elf`) does not see this non-taken branch and proceeds directly to the next instruction. The write to the CSR works correctly.

In [this archive you will find](https://github.com/SpinalHDL/VexRiscv/files/10885411/branchcsr.zip) the...

* Failing ELF
* Succeeding ELF
* Waveforms for failing ELF
* Waveforms for succeeding ELF

You will notice, for example, that the ELF should write to address 0 at the end of the testbench but does not in `buggy.vcd`.

## Notes

I'm really sorry, because of my unfamiliarity with Spinal and the lack of readability of the output Verilog code, I am not able to analyze efficiently the causes of this bug in the codebase. I'm very happy to help if you need more info, though!

The ELF content is essentially setting registers to some debug values, then executing the problematic code, and then trying to dump the values.

Thanks!
Flavien

Dolu1990, 2023-03-03:
Hi ^^
Thanks for the report.
What cpu configuration are you using ?

Dolu1990, 2023-03-03:
Seems like you run some RVC code on a non-RVC config :
800000a0:       2cd6                    fld     fs9,336(sp)

And also that the config isn't setuped to catch illegal instruction ?

if both of those suposition are right, then it isn't a bug :)

flaviens, 2023-03-03:
Hi @Dolu1990 thank you for your quick answer!
* I'm using the same config as in #318 , in the master branch (where I cherry-picked you fix of #316, but unlikely to be related to this issue).
* It looks that illegal instructions should be caught given this config, but given the next point it does not matter sthat much
* except mistake of mine, the commpressed instructions that you may see in the dump of the ELF is objdump mistakingly trying to interpret embedded data as instructions. You can run a quick trace with spike for instance and see that these "instructions" are never executed. But indeed this compressed instruction is on a speculative path 🙂 suspicious 🧑‍🚒

Dolu1990, 2023-03-04:
Hi ^^
So the issue seems the following :
- [Speculative] execution of a invalid instruction
- The decoder will see it is illegal but the issue is that the decoded signal which specify if that's for the FPU are not specified (don't care) and that the fork to the FPU is also in the decode stage.
- That fork stuff to the FPU which isn't coherent with the other decoded signals
- CPU wait forever

I'm now trying to reproduce, the fix should be easy

Dolu1990, 2023-03-05:
Hi, for me, the following change fixed it :
(FpuPlugin.scala https://github.com/SpinalHDL/VexRiscv/commit/153445ff2145f1a1ee2ed7ccd042a34da0876887)

Thanks for the bug report :)

Closed 2023-03-05.

Thread 329 (2023-04-13):

CPU Configuration with PMP Plugin

seceng-jan, 2023-04-13:
Hi!

I am trying to instantiate the PmpPlugin in a CPU configuration that boots Linux. Therefore, I modified the [VexRiscvSmpCluster](https://github.com/SpinalHDL/VexRiscv/blob/master/src/main/scala/vexriscv/demo/smp/VexRiscvSmpCluster.scala) configuration and added
```
new PmpPlugin(
  regions = 16,
  granularity = 32,
  ioRange = _(31 downto 28) === 0xf
),
```
When I run sbt, the following error occurs:
```
[info] **********************************************************************************************
[info] [Warning] Elaboration failed (0 error).
[info]           Spinal will restart with scala trace to help you to find the problem.
[info] **********************************************************************************************
[info] [Progress] at 0.428 : Elaborate components
[error] Exception in thread "main" java.lang.AssertionError: assertion failed: ??? vexriscv.MemoryTranslator
[error]         at scala.Predef$.assert(Predef.scala:170)
[error]         at spinal.core.package$.assert(core.scala:500)
[error]         at vexriscv.Pipeline$class.service(Pipeline.scala:26)
[error]         at vexriscv.VexRiscv.service(VexRiscv.scala:123)
[error]         at vexriscv.plugin.IBusCachedPlugin.setup(IBusCachedPlugin.scala:114)
[error]         at vexriscv.plugin.IBusCachedPlugin.setup(IBusCachedPlugin.scala:28)
[error]         at vexriscv.Pipeline$$anonfun$build$2.apply(Pipeline.scala:47)
[error]         at vexriscv.Pipeline$$anonfun$build$2.apply(Pipeline.scala:47)
[error]         at scala.collection.mutable.ResizableArray$class.foreach(ResizableArray.scala:59)
[error]         at scala.collection.mutable.ArrayBuffer.foreach(ArrayBuffer.scala:48)
[error]         at vexriscv.Pipeline$class.build(Pipeline.scala:47)
[error]         at vexriscv.VexRiscv.build(VexRiscv.scala:123)
[error]         at vexriscv.Pipeline$$anonfun$1.apply$mcV$sp(Pipeline.scala:161)
[error]         at spinal.core.Component$$anonfun$prePop$1.apply(Component.scala:180)
[error]         at spinal.core.Component$$anonfun$prePop$1.apply(Component.scala:178)
[error]         at scala.collection.mutable.ResizableArray$class.foreach(ResizableArray.scala:59)
[error]         at scala.collection.mutable.ArrayBuffer.foreach(ArrayBuffer.scala:48)
[error]         at spinal.core.Component.prePop(Component.scala:178)
[error]         at spinal.core.Component.postInitCallback(Component.scala:187)
[error]         at vexriscv.VexRiscvBmbGenerator$$anonfun$10$$anon$2.<init>(VexRiscvBmbGenerator.scala:111)
[error]         at vexriscv.VexRiscvBmbGenerator$$anonfun$10.apply(VexRiscvBmbGenerator.scala:99)
[error]         at vexriscv.VexRiscvBmbGenerator$$anonfun$10.apply(VexRiscvBmbGenerator.scala:99)
[error]         at spinal.core.fiber.package$$anonfun$1.apply$mcV$sp(package.scala:10)
[error]         at spinal.core.fiber.AsyncThread$$anonfun$1.apply$mcV$sp(AsyncThread.scala:59)
[error]         at spinal.core.fiber.EngineContext$$anonfun$newJvmThread$1.apply$mcV$sp(AsyncCtrl.scala:39)
[error]         at spinal.sim.JvmThread.run(SimManager.scala:51)
[error] Nonzero exit code returned from runner: 1
[error] (Compile / runMain) Nonzero exit code returned from runner: 1
[error] Total time: 8 s, completed Apr 13, 2023, 9:45:13 AM
```

The same happens with the GenFull configuration. I assmue that this is related to the memoryTranslatorPortConfig but I am not sure what to put there. Maybe it also relates to #307, I tried the modifications there but same result. Can you help me out?

Dolu1990, 2023-04-14:
Hi,

MMU + PMP at the same time isn't supported in VexRiscv, it is either one or the other or none

seceng-jan, 2023-04-14:
Thank you! Do you happen to know if anyone has been successful in getting the keystone TEEs to work on vexriscv? I suppose it is possible to compile the Linux kernel without MMU support, but it will probably be very limited and I am not sure if Keystone will be compatible.

Dolu1990, 2023-04-17:
Ahh i have no idea, never heared of keystone TEEs.
Also, never tried linux without the MMU.

seceng-jan, 2023-04-19:
Okay thank you! :-) I'll try to get it working somehow.

Closed 2023-04-19.

Thread 333 (2023-04-17):

Application userspace/hello_world_user in SoC LiteX VexRiscv

KevinQhv, 2023-04-17:
Hi,

I try an application provided by Zephyr `userspace/hello_world_user` on my SoC that i created with LiteX.

```
Configuration :
- OS : Ubuntu 22.04 LTS
- Board : Digilent Arty A7 100T
- LiteX Version 2022.08
- CPU : VexRiscv Variant : Secure, Linux, Full, Lite
- OS : ZephyrOS lastest 3.1.0
```

I tried the application with several variants Full, Lite, Linux and Secure for the VexRiscv CPU. But, I don't enter the thread in user mode. The `k_is_user_context() ` function does not return 1 for user mode for all variants.

```
ASSERTION FAIL [k_is_user_context()] @ WEST_TOPDIR/zephyr/samples/userspace/hello_world_user/src/main.c:19
        User mode execution was expected
E:      a0: 00000004    t0: 00000000
E:      a1: 0000001c    t1: 00000000
E:      a2: 400053c8    t2: ffffffff
E:      a3: 40006d84    t3: 00000020
E:      a4: 00000000    t4: 00000023
E:      a5: f0003000    t5: ffffffff
E:      a6: 20000000    t6: ffffffff
E:      a7: 00000000
E:      ra: 40000ac0
E:    mepc: 40001da0
E: mstatus: 00001880
E:
E: >>> ZEPHYR FATAL ERROR 4: Kernel panic on CPU 0
E: Current thread: 0x400063d0 (unknown)
E: Halting system
```

So, i got an ASSERTION FAIL with the function `__ASSERT(k_is_user_context()` but, I want to enter the user mode. The Linux, Full and Lite variants have three privilege modes.

Thank you for your help

Dolu1990, 2023-04-17:
What DTS did you used to compile the zephyr ? (nothing pop up in sim)
Is there a easy way for me to recompile things ?

Dolu1990, 2023-04-17:
(i'm trying to repoduce the issue in simulation, without all the arty related stuff, so using ./litex_sim)

Dolu1990, 2023-04-17:
one thing i just thinked about, you may have more success with vexriscv_smp cpu variant, as it enable more CSR features

KevinQhv, 2023-04-17:
The DTS file generated by the compilation of the SoC following the Zephyr Doc liteX VexRiscv
[https://docs.zephyrproject.org/latest/boards/riscv/litex_vexriscv/doc/index.html#litex-vexriscv](url) with the command for the board Arty A7-100T :
`./litex-boards/litex_boards/targets/digilent_arty.py --variant=a7-100 --cpu-variant=secure --build --timer-uptime --csr-json csr.json --load`
and for genrated overlay.dts :
`./litex/litex/tools/litex_json2dts_zephyr.py --dts overlay.dts --config overlay.config csr.json`

And I just tested the application on the vexriscv_smp processor variant Linux and I have a different problem:
`
E:
E:  mcause: 2, Illegal instruction
E:   mtval: bc002773
E:      a0: 00000001    t0: 00000800
E:      a1: 4000816e    t1: 0000006a
E:      a2: 00000006    t2: 0000007f
E:      a3: 00000007    t3: 0000007a
E:      a4: 40005d34    t4: 00000074
E:      a5: 40002b2c    t5: 00000009
E:      a6: 00000068    t6: 0000002a
E:      a7: 0000004c
E:      ra: 40002b3c
E:    mepc: 40002284
E: mstatus: 00001900
E:
E: >>> ZEPHYR FATAL ERROR 0: CPU exception on CPU 0
E: Current thread: 0x40007478 (unknown)
E: Halting system
`

Dolu1990, 2023-04-17:
Ahh thanks for the info :D
Got the overlay.dts.
Which version of zephyr did you used ? how do you compile it ? (didn't used zephyr since years)

About the crash you get on vexriscv_smp, it is because you use the zephyr compiled for the vexriscv non smp version, which has a different interrupt design. (mtval: bc002773)

You need to recompile zephyr with the vexriscv_smp headers

KevinQhv, 2023-04-17:
I use this configuration :
```
Configuration :
- OS : Ubuntu 22.04 LTS
- Board : Digilent Arty A7 100T
- LiteX Version 2022.08
- CPU : VexRiscv Variant : Secure, Linux, Full, Lite
- OS : ZephyrOS lastest 3.1.0
```
Once the DTS file is created in the zephyr folder :
`west build -b litex_vexriscv samples/userspace/hello_world_user  -DDTC_OVERLAY_FILE=~/zephyrproject/PATHTO/overlay.dts`

And for testing :
`litex_term  /dev/ttyUSB2 --kernel ../zephyr/build/zephyr/zephyr.bin`

I don't see the recompile zephyr with the vexriscv_smp headers,
Need to create a new board for vexriscv_smp? or, just add a configuration option for vexriscv ?

Dolu1990, 2023-04-18:
>  I don't see the recompile zephyr with the vexriscv_smp headers,
Need to create a new board for vexriscv_smp? or, just add a configuration option for vexriscv ?

So, the thing is, if you got 0xbc002773 instruction in you binary, it mean you had something litex specific in the zephyr.
Did you use some zephyr fork or something ?

(all of this is a flow i do not know)

Ultimately, the thing i need to debug the issue, is to be able to run a simulation of the system.
Did you used "litex_sim" by the past ?

KevinQhv, 2023-04-18:
To create the Overlay.dts file, I used a python script `litex_json2dts_zephyr.py` and zephyr takes this file to build the application.
I did not use `litex_sim` with a zephyr application. I just tested it on a board.

KevinQhv, 2023-07-04:
the answer is in this issue #https://github.com/zephyrproject-rtos/zephyr/issues/56789

Closed 2023-07-04.

Thread 339 (2023-05-05):

Questions about the memory of the Murax SoC and the VexRiscv in general

joeljeanmonod-rgb, 2023-05-05:
Hi,

I have a few questions about how the memory map work with Murax Soc and the VexRiscv in general.

My first question is about how the processor starts. Of what i understand the sequence is as follow :

1. Start at the adress of the `resetVector  = 0x80000000l`
2. Read the instructions of the `crt.S` which are at the adress `0x80000000l`
4. The `crt.S` enable the interrupts for the timer and the uart and then jump to the `main` function
3. Start the the main function in the `main.c`

is that correct ?

My second question is about the memory map. I have a few questions about it :

1. Is the processor using a part of the memory map for internal use ?
2. if yes, where can i find the memory map of the processor for internal use ?
3. if no,  does that mean that the memory map entirely available for the user ?  Can for exemple put the RAM at the adress `0x00000000l` directly with the `resetVector  = 0x00000000l` ?

thanks in advance for your response.

Dolu1990, 2023-05-05:
HI ^^

> The crt.S enable the interrupts for the timer and the uart and then jump to the main function

Not exactly, it enable timer and external interrupts in the core, the uart interrupt is connected to a interrupt controller which goes to that external interrupt.

> Is the processor using a part of the memory map for internal use ?

No

> if no, does that mean that the memory map entirely available for the user ?

Yes

> Can for exemple put the RAM at the adress 0x00000000l directly with the resetVector  = 0x00000000l ?

Yes, but overall i would say the best is to put nothing at 0x00000000 (so null pointer access will not access memory)

joeljeanmonod-rgb, 2023-05-07:
Thank you so much

Closed 2023-05-07.

Thread 342 (2023-05-10):

How to add a custom instruction that can read rd

LongStudy, 2023-05-10:
Hi, VexRiscv and SpinalHDL are really cool. I never thought adding SIMD instructions would be so easy.

As the example mentioned in the `CustomInstruction.scala`, the plugin can read `rs1` and `rs2` and write to `rd`. But I am looking for a way to read `rd` at the same time as shown below.

```
rd(7 downto 0) := rs1(7 downto 0) + rs2(7 downto 0) + rd(7 downto 0)
......
rd(31 downto 24) := rs1(31 downto 24) + rs2(31 downto 24) + rd(31 downto 24)
```

I learned that there is no part of RV32IMC instructions need to read `rd`, but I found some instructions in the p-spec that may require reading `rd`.

How can I add a custom instruction set that can read `rd`? (Of course, this instruction could be executed in two separate instructions, but perhaps one would be faster?) Thank you!

Dolu1990, 2023-05-10:
Hi,

That's currently not supported.
The best way would be to add support for a "RS3" in the RegFilePlugin and hazard plugin, i guess that should be enough ?

LongStudy, 2023-05-11:
Awesome, the efficiency of SpinalHDL is impressive. I modified `RegFilePlugin.scala` and `HazardSimplePlugin.scala` plugins and then modified the test cases in `crt.S` and run the regression test. The test results show that the rd register can be read efficiently.
Thanks a lot, VexRiscv is a great platform for me with so much to learn.

Dolu1990, 2023-05-11:
:D :D
Nice !

Let's me know if you push your code somewere, could be usefull ^^

LongStudy, 2023-05-11:
I am still learning and have no plan to push it to the Internet immediately. Thank you very much for taking the time to reply to the message. I think I have no problem for the time being, and maybe this issue can be closed.

LongStudy, 2023-10-31:
When I try to design custom instructions, I find that some complex instructions may consume more time after FPGA synthesis and cause timing violation. Can I imitate MulPlugin to put part of the logic into the memory stage?

Dolu1990, 2023-11-02:
Sure you can, no worries to have about it.

LongStudy, 2023-11-12:
Thanks a lot. I fixed the timing violation problem.

ashuthosh-mr, 2024-03-01:
> Awesome, the efficiency of SpinalHDL is impressive. I modified `RegFilePlugin.scala` and `HazardSimplePlugin.scala` plugins and then modified the test cases in `crt.S` and run the regression test. The test results show that the rd register can be read efficiently. Thanks a lot, VexRiscv is a great platform for me with so much to learn.

Can you please share the changes that were made? This change might be the key to introduce MAC instruction. @LongStudy

Thank you :)

Closed 2023-11-12.

Thread 343 (2023-05-12):

X over-propagation

flaviens, 2023-05-12:
Hi there!

## Problem description

Are you exclusively using Verilator to simulate VexRiscv? EDIT: I've seen in another issue that mostly yes ^^'
I've been recently trying to simulate VexRiscv with Modelsim.

For some non-trivial cases such as the example below, the architectural registers become X. Is that a known problem? Is there any easy solution to that?

Other designs such as CVA6, Rocket and BOOM do not seem to have such problems.

## Example instance

Here is a waveform and the corresponding ELF file.
[example_instance.zip](https://github.com/SpinalHDL/VexRiscv/files/11465674/example_instance.zip)
The first X contamination to the architectural floating point register `ft3` happens at `PC = 0x80029128`.
You can then see the data being stored into memory as X close to the end of the simulation, which is the store instruction at `PC = 0x80027a14` (the fourth write to address `3` of the data memory), under the cursor in the screenshot in the archive.

Thanks!
Flavien

Dolu1990, 2023-05-12:
Hi ^^

> Are you exclusively using Verilator to simulate VexRiscv

Yes right

> For some non-trivial cases such as the example below, the architectural registers become X. Is that a known problem?

Not realy a known issue, but not explored case either XD

>  Is there any easy solution to that?

Hmm not that i know. What CPU configuration do you use  exactly ?

> Example instance

Ahhh in the VCD you sent me, there is only a few signals of the top ?
Would it be possible to have a full wave of the CPU signals ?

Thanks :D

flaviens, 2023-05-12:
Ah yes indeed, sorry. Was also noticing that it was quite lightweight :) . Now the VCD is huge! Let me get a shorter instance and come back to you shortly.

flaviens, 2023-05-12:
I updated the archive above with a much shorter execution (but the same problem probably), and with the full VCD this time :)
Thanks!

Dolu1990, 2023-05-12:
So, it seems like it is a xprop false positive issue.

I hate xprop very much <3, i love verilator very much too <3

So, the case we have here is that each time the CPU come to fetch a i$ cache line which isn't loaded, the i$ provide a 'X', as the i$ banks were never written before, that's to be expected. the issue is that those X messup with the main pipeline value bypass (RS1 / RS2) and make the things corrupt.

So, i would say, would need to force the initialisation of all the VexRiscv internal memories to be sure not hitting those cases.

There is a few things which can be enabled to force it (see https://github.com/SpinalHDL/VexRiscv/blob/c52433575dec04f10063b2fd7cebd0545c8b1be9/src/main/scala/vexriscv/ip/InstructionCache.scala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)

But that's not enough.
Will add it ^^

flaviens, 2023-05-12:
Hi @Dolu1990 thanks for looking into it! Extremely appreciated. I can help you validating your fix, just let me know.
Thanks!

Dolu1990, 2023-05-16:
Hi ^^

Here is a workaround :

```` scala
  import spinal.core.internals._
  import scala.util.Random
  class PhaseRandomizedMem() extends PhaseNetlist {
    override def impl(pc: PhaseContext): Unit = {
      pc.walkDeclarations{
        case mem : Mem[_] if mem.initialContent == null => {
          mem.initBigInt(Array.fill(mem.wordCount)(BigInt.apply(mem.width, Random)))
        }
        case _ =>
      }
    }
  }

  val gen = SpinalConfig(inlineRom = true)
  gen.addTransformationPhase(new PhaseRandomizedMem)
  gen.generateVerilog(new VexRiscv(...))
```

this will ensure that all the memories in the design are initialized with a fixed random content

flaviens, 2023-05-16:
Thanks! Currently my generation flow looks very much like in [this demo](https://github.com/SpinalHDL/VexRiscv/blob/master/src/main/scala/vexriscv/demo/VexRiscvAhbLite3.scala), and then I just run `runMain vexriscv.demo.VexRiscvAhbLite3`. How would you integrate the workaround in this flow?
Thanks!
Flavien

flaviens, 2023-05-16:
Hi @Dolu1990,

Actually I closed the issue a bit fast. Actually the problem is still here :cry:  , even for the exact same ELF.  I copied exactly the workaround above and tried multiple times to be sure.

Dolu1990, 2023-05-16:
Hi ^^

Can you send the wave file with the updated design ?

Thanks :)

Dolu1990, 2023-05-16:
XD
No worries.

Where are the X ?  Can't find them ^^

flaviens, 2023-05-16:
I need some vacationmaybe... I used Verilator for the VCD :facepalm: You'll find the correct one replaced in place above (problem still here).
Thanks!

Dolu1990, 2023-05-16:
No worries ^^

In [sim_new.zip](https://github.com/SpinalHDL/VexRiscv/files/11488058/sim_new.zip) ? Still the same

flaviens, 2023-05-16:
Had not clicked "update comment". This issue is a festival :D

flaviens, 2023-05-16:
Looks good! Thanks!!

Closed 2023-05-16.

Thread 345 (2023-05-17):

Predicted branch taken after compressed EBREAK

patstew, 2023-05-17:
I'm trying to use a simulated vexriscv with a custom gdbserver and I'm seeing an issue with C.EBREAK instructions followed by jumps (or the upper part of a 4 byte instruction that happens to decompress to a jump after breakpoint insertion). If prediction is enabled then it appears that the pc is updated to the predicted value from the instruction following the C.EBREAK, rather than simply being the address of the following instruction. I'm using prediction = STATIC, and reading the pc using an AUIPC instruction in the debug interface.

xobs, 2023-05-18:
Just chiming in here -- I was linked your issue, but I'm not sure I understand it.

When `C.EBREAK` is hit, the address of the ebreak instruction is written to `$mepc` and the program jumps to `$mtvec`. Your handler then needs to do whatever it needs to in order to swap the instruction back, or jump over the ebreak instruction if you don't want to swap it out.

This is in contrast to ARM where the break instruction will return to the instruction following the trap.

I have a test at https://github.com/xobs/renode-ebreak-test/blob/89f02df07b828e2117432b3db7ade90255a84cae/src/riscv_support.rs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 that will replace every instruction in a program with `ebreak` or `c.ebreak` and will end up single-stepping through it. I've only tested it on emulators, but can you see if it exhibits the same issue you're seeing? The program basically single-steps its way through the entire program once it hits the first `ebreak`.

patstew, 2023-05-18:
Sorry, I'm using it with the debugplugin, not the csrplugin.

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

Dolu1990, 2023-05-18:
Hi,

>  reading the pc using an AUIPC instruction in the debug interface.

I think that's the issue.
When the DebugPlugin get a ebreak and is in debug mode, the CPU fetch PC is messed up, the only way to retrieve the PC is to read address 0x04 of the DebugPlugin debug bus. If you push any instruction in, the value will be lost.

PC saved on ebreak here :
https://github.com/SpinalHDL/VexRiscv/blob/c52433575dec04f10063b2fd7cebd0545c8b1be9/src/main/scala/vexriscv/plugin/DebugPlugin.scala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

Mapped to the debug bus here :
https://github.com/SpinalHDL/VexRiscv/blob/c52433575dec04f10063b2fd7cebd0545c8b1be9/src/main/scala/vexriscv/plugin/DebugPlugin.scala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

Openocd code which save the PC when the CPU enter debug mode from ebreak:
https://github.com/SpinalHDL/openocd_riscv/blob/058dfa50d625893bee9fecf8d604141911fac125/src/target/vexriscv.c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

xobs, 2023-05-18:
That makes sense. Here's the same steps in Rust flavour:

https://github.com/litex-hub/wishbone-utils/blob/7a6358533e7df63a059d65c612f3e992552cdfc5/wishbone-tool/crates/core/riscv/mod.rs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

patstew, 2023-05-18:
Thanks, I missed that, that's solved my issue.

Closed 2023-05-18.

Thread 346 (2023-06-02):

Fuzzing VexRiscv

TobiasKovats, 2023-06-02:
Hello!

I have implemented a hardware fuzzer and am currently trying to fuzz the VexRiscv core. I have noticed that the core seems to ignore my inputs during the first few hundred (approx 250) cycles after reset. Is there some cache flushing procedure that is evoked after reset that might be causing this? And if yes, is there a way to disable it?

Thanks,

Tobias

Dolu1990, 2023-06-02:
Hi,

Yes, after reset, the instruction cache and data cache will be initialized by a little FSM.
No way to disable it as it is required for proper operations of the core, unless you can deal with a non-funtional core (for test purpose ?)
You use the cached version of the core right ?

What is a hardware fuzzer ?

TobiasKovats, 2023-06-02:
Hi,

thanks for your quick reply! Yes I am using the cached version of the core. For test purposes it would be interesting to disable it if possible.
The idea of a hardware fuzzer is to find bugs in the design in an automated manner by applying various inputs and observing the behaviour of the DUT and comparing it to a golden model. The inputs are constructed to maximise a 'coverage' metric that represents how well the state space of the design is explored with a set of inputs. Coverage is obtained by instrumenting the DUT in a certain manner to allow coverage measurement and collec feedback during runtime. Here a a few publications if interested:

https://people.eecs.berkeley.edu/~ksen/papers/rfuzz.pdf
https://www.bsg.ai/papers/Hardware_Fuzzing_DAC_2021.pdf
https://arxiv.org/abs/2102.02308

Thanks,

Tobias

bunnie, 2023-06-02:
Ironically I had the exact opposite problem you had (I definitely need the flush to make sure I have a deterministic state on boot).

I believe the bit that controls it is here:

https://github.com/SpinalHDL/VexRiscv/blob/c52433575dec04f10063b2fd7cebd0545c8b1be9/src/main/scala/vexriscv/ip/InstructionCache.scala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

If you set the `RegInit` to `false`, I bet it won't do a flush on boot. In which case, you will have to "cheat" and make sure your tags are initialized to 0 (which is not a thing you can do with physically real 6-T SRAM cells).

TobiasKovats, 2023-06-02:
Very interesting, thanks for the hint! I will definitely have a look!

Dolu1990, 2023-06-02:
Ahh nice ^^
The other one is on the d$ :
https://github.com/SpinalHDL/VexRiscv/blob/c52433575dec04f10063b2fd7cebd0545c8b1be9/src/main/scala/vexriscv/ip/DataCache.scala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

Initialized to zero will make it flush the cache.
init(1 << lineRange.size) instead should do the trick

TobiasKovats, 2023-06-04:
Great, thanks a lot for your help!

Closed 2023-06-04.

Thread 349 (2023-06-14):

SIMD_ADD custom instruction not working in C code

tiagoasilva-meec, 2023-06-14:
I was thinking about implementing a custom instruction in VexRiscv, so I decided to try the **SimdAddPlugin** example first.

I inserted the SimdAddPlugin in my configuration list and generated the verilog code.
I was using the following macros to call the custom instruction from my C code (I have these in a .S file actually):

#define SIMD_ADD(_rd, _rs1, _rs2) \
R_TYPE_INSTR(0b0000011, reg_ ## _rs2, reg_ ## _rs1, 0b000, reg_ ## _rd, 0b0001011)

#define R_TYPE_INSTR(_f7, _rs2, _rs1, _f3, _rd, _opc) \
.word (((_f7) << 25) | ((_rs2) << 20) | ((_rs1) << 15) | ((_f3) << 12) | ((_rd) << 7) | (_opc))

I can't get anything by calling SIMD_ADD from main, in my C code. It doesn't execute or return anything.
However, I tryed changing the arguments and opcode of the R_TYPE_INSTR macro and I could execute several riscv instructions (ADD, SUB, SLT, XOR, etc), already implemented.
So the problem may be related with the SimdAddPlugin or something else missing. It don't think it has to do with the macros.

Dolu1990, 2023-06-15:
Hi,

I just tried to run :
https://github.com/SpinalHDL/VexRiscv#add-a-custom-instruction-to-the-cpu-via-the-plugin-system

```
# Generate the CPU
sbt "runMain vexriscv.demo.GenCustomSimdAdd"

cd src/test/cpp/regression/

# Optionally add TRACE=yes if you want to get the VCD waveform from the simulation.
# Also you have to know that, by default, the testbench introduce instruction/data bus stall.
# Note the CUSTOM_SIMD_ADD flag is set to yes.
make clean run IBUS=SIMPLE DBUS=SIMPLE CSR=no MMU=no DEBUG_PLUGIN=no MUL=no DIV=no DHRYSTONE=no REDO=1 CUSTOM_SIMD_ADD=yes
```

All seems good.

Can you send your application.elf ? or assembly ?

Thread 352 (2023-07-01):

Custom Interruptions error and Selection of the 'A' instruction set

joeljeanmonod-rgb, 2023-07-01:
Hi,

i have a problem with using the following custom interruption demo.

https://github.com/SpinalHDL/VexRiscv/blob/master/src/main/scala/vexriscv/demo/GenCustomInterrupt.scala

I try build it but each time i got the following error :

```bash
[info] welcome to sbt 1.6.0 (Temurin Java 1.8.0_372)
[info] loading settings for project vexriscv-build from plugins.sbt ...
[info] loading project definition from /home/joel/TB/VexRiscv/project
[info] loading settings for project root from build.sbt ...
[info] set current project to VexRiscv (in build file:/home/joel/TB/VexRiscv/)
[info] running (fork) vexriscv.demo.GenCustomInterrupt
[info] [Runtime] SpinalHDL v1.8.1    git head : 2a7592004363e5b40ec43e1f122ed8641cd8965b
[info] [Runtime] JVM max memory : 7111.5MiB
[info] [Runtime] Current date : 2023.07.01 17:29:37
[info] [Progress] at 0.000 : Elaborate components
[info] ERROR !
[info] A null pointer access has been detected in the JVM.
[info] This could happen when in your SpinalHDL description, you access an signal which is only defined further.
[error] Exception in thread "main" java.lang.NullPointerException
[info] For instance :
[error]         at vexriscv.plugin.CsrPlugin.r(CsrPlugin.scala:534)
[error]         at vexriscv.plugin.UserInterruptPlugin.setup(CsrPlugin.scala:1743)
[error]         at vexriscv.plugin.UserInterruptPlugin.setup(CsrPlugin.scala:1735)
[info]   val result = Bool()
[error]         at vexriscv.Pipeline$$anonfun$build$2.apply(Pipeline.scala:47)
[error]         at vexriscv.Pipeline$$anonfun$build$2.apply(Pipeline.scala:47)
[error]         at scala.collection.mutable.ResizableArray$class.foreach(ResizableArray.scala:59)
[info]   result := a ^ b  //a and b can't be accessed there because they are only defined one line below (Software rule of execution order)
[error]         at scala.collection.mutable.ArrayBuffer.foreach(ArrayBuffer.scala:48)
[error]         at vexriscv.Pipeline$class.build(Pipeline.scala:47)
[info]   val a,b = Bool()
[info]   
[error]         at vexriscv.VexRiscv.build(VexRiscv.scala:126)
[error]         at vexriscv.Pipeline$$anonfun$1.apply$mcV$sp(Pipeline.scala:161)
[error]         at spinal.core.Component$$anonfun$prePop$1.apply(Component.scala:180)
[error]         at spinal.core.Component$$anonfun$prePop$1.apply(Component.scala:178)
[error]         at scala.collection.mutable.ResizableArray$class.foreach(ResizableArray.scala:59)
[error]         at scala.collection.mutable.ArrayBuffer.foreach(ArrayBuffer.scala:48)
[error]         at spinal.core.Component.prePop(Component.scala:178)
[error]         at spinal.core.Component.postInitCallback(Component.scala:187)
[error]         at vexriscv.demo.GenCustomInterrupt$.cpu(GenCustomInterrupt.scala:11)
[error]         at vexriscv.demo.GenCustomInterrupt$$anonfun$1.apply(GenCustomInterrupt.scala:71)
[error]         at vexriscv.demo.GenCustomInterrupt$$anonfun$1.apply(GenCustomInterrupt.scala:71)
[error]         at spinal.core.internals.PhaseCreateComponent$$anonfun$impl$66.apply(Phase.scala:2564)
[error]         at spinal.core.fiber.Engine$$anonfun$create$1.apply$mcV$sp(AsyncCtrl.scala:147)
[error]         at spinal.core.fiber.AsyncThread$$anonfun$1.apply$mcV$sp(AsyncThread.scala:59)
[error]         at spinal.core.fiber.EngineContext$$anonfun$newJvmThread$1.apply$mcV$sp(AsyncCtrl.scala:39)
[error]         at spinal.sim.JvmThread.run(SimManager.scala:51)
[error] Nonzero exit code returned from runner: 1
[error] (Compile / runMain) Nonzero exit code returned from runner: 1
[error] Total time: 1 s, completed Jul 1, 2023 5:29:37 PM
```

My main goal is to add 32 custom interruptions that i can freely connect to peripherals like GPIO for example.
I have the following VexRISCV configuration :

```scala
package vexriscv.demo
import vexriscv.plugin._
import vexriscv.ip.{DataCacheConfig, InstructionCacheConfig}
import vexriscv.{plugin, VexRiscv, VexRiscvConfig}
import spinal.core._
import spinal.lib.bus.amba4.axi.Axi4ReadOnly
import vexriscv.ip.fpu.FpuParameter

import spinal.core._
import spinal.lib._
import spinal.lib.bus.amba4.axi.Axi4ReadOnly
import spinal.lib.bus.avalon.AvalonMM
import spinal.lib.com.jtag.Jtag
import spinal.lib.com.jtag.JtagTapInstructionCtrl
import spinal.lib.eda.altera.{InterruptReceiverTag, QSysify, ResetEmitterTag}
import vexriscv.ip.{DataCacheConfig, InstructionCacheConfig}
import vexriscv.plugin._
import vexriscv.{VexRiscv, VexRiscvConfig, plugin}

object GenSignate{
    def main(args: Array[String]) {
        val report = SpinalVerilog{
            val cpuConfig = VexRiscvConfig(
                plugins = List(
                    new IBusCachedPlugin(
                        resetVector = 0x80000000l,
                        prediction = DYNAMIC_TARGET,
                        historyRamSizeLog2 = 8,
                            config = InstructionCacheConfig(
                            cacheSize = 4096,
                            bytePerLine = 32,
                            wayCount = 1,
                            addressWidth = 32,
                            cpuDataWidth = 32,
                            memDataWidth = 32,
                            catchIllegalAccess = true,
                            catchAccessFault = true,
                            asyncTagMemory = false,
                            twoCycleRam = true,
                            twoCycleCache = true
                            )
                    ),
                    new DBusCachedPlugin(
                            config = new DataCacheConfig(
                            cacheSize        = 4096,
                            bytePerLine      = 32,
                            wayCount         = 1,
                            addressWidth     = 32,
                            cpuDataWidth     = 32,
                            memDataWidth     = 32,
                            catchAccessError = true,
                            catchIllegal     = true,
                            catchUnaligned   = true
                        )
                    ),
                    new StaticMemoryTranslatorPlugin(
                        ioRange = _(31 downto 28) === 0xF
                    ),
                    new DecoderSimplePlugin(
                        catchIllegalInstruction = true
                    ),
                    new RegFilePlugin(
                        regFileReadyKind = plugin.SYNC,
                        zeroBoot = false
                    ),
                    new IntAluPlugin,
                    new SrcPlugin(
                        separatedAddSub = false,
                        executeInsertion = true
                    ),
                    new FullBarrelShifterPlugin,
                    new HazardSimplePlugin(
                        bypassExecute = true,
                        bypassMemory = true,
                        bypassWriteBack = true,
                        bypassWriteBackBuffer = true,
                        pessimisticUseSrc = false,
                        pessimisticWriteRegFile = false,
                        pessimisticAddressMatch = false
                    ),
                    new MulPlugin,
                    new DivPlugin,
                    new CsrPlugin(CsrPluginConfig.small),
                    new DebugPlugin(ClockDomain.current.copy(reset = Bool().setName("debugReset"))),
                    new BranchPlugin(
                        earlyBranch = false,
                        catchAddressMisaligned = true
                    ),
                    new YamlPlugin("cpu0.yaml")
                )
            )
            // SpinalVerilog(cpu())
            //CPU instanciation
            val cpu = new VexRiscv(cpuConfig)
            // val cpu = SpinalVerilog(cpu())
            //CPU modifications to be an Avalon one
            cpu.setDefinitionName("VexRiscvSignate")
            cpu.rework {
                var iBus : Axi4ReadOnly = null
                for (plugin <- cpuConfig.plugins) plugin match {
                    case plugin: IBusSimplePlugin => {
                    plugin.iBus.setAsDirectionLess() //Unset IO properties of iBus
                    iBus = master(plugin.iBus.toAxi4ReadOnly().toFullConfig())
                    // iBus = master(plugin.iBus.toAxi4ReadOnly())
                        .setName("iBusAxi")
                        .addTag(ClockDomainTag(ClockDomain.current)) //Specify a clock domain to the iBus (used by QSysify)
                    }
                    case plugin: IBusCachedPlugin => {
                    plugin.iBus.setAsDirectionLess() //Unset IO properties of iBus
                    iBus = master(plugin.iBus.toAxi4ReadOnly().toFullConfig())
                    // iBus = master(plugin.iBus.toAxi4ReadOnly())
                        .setName("iBusAxi")
                        .addTag(ClockDomainTag(ClockDomain.current)) //Specify a clock domain to the iBus (used by QSysify)
                    }
                    case plugin: DBusSimplePlugin => {
                    plugin.dBus.setAsDirectionLess()
                    master(plugin.dBus.toAxi4Shared().toAxi4().toFullConfig())
                    // master(plugin.dBus.toAxi4Shared().toAxi4())
                        .setName("dBusAxi")
                        .addTag(ClockDomainTag(ClockDomain.current))
                    }
                    case plugin: DBusCachedPlugin => {
                    plugin.dBus.setAsDirectionLess()
                    master(plugin.dBus.toAxi4Shared().toAxi4().toFullConfig())
                    // master(plugin.dBus.toAxi4Shared().toAxi4())
                        .setName("dBusAxi")
                        .addTag(ClockDomainTag(ClockDomain.current))
                    }
                    case plugin: DebugPlugin => plugin.debugClockDomain {
                    plugin.io.bus.setAsDirectionLess()
                    //BSCANE2 JTAG
                    val jtagCtrl = JtagTapInstructionCtrl()
                    val tap = jtagCtrl.fromXilinxBscane2(userId = 2)
                    jtagCtrl <> plugin.io.bus.fromJtagInstructionCtrl(ClockDomain(tap.TCK), 0)
                    plugin.io.resetOut
                      .addTag(ResetEmitterTag(plugin.debugClockDomain))
                      .parent = null //Avoid the io bundle to be interpreted as a QSys conduit
                    }
                    case _ =>
                }
                for (plugin <- cpuConfig.plugins) plugin match {
                    case plugin: CsrPlugin => {
                    plugin.externalInterrupt
                        .addTag(InterruptReceiverTag(iBus, ClockDomain.current))
                    plugin.timerInterrupt
                        .addTag(InterruptReceiverTag(iBus, ClockDomain.current))
                    }
                    case _ =>
                }
            }
            cpu
        }
    }
}
```

My question is how i can do this ?

I have second  question. How can you choose to enable or not the 'A' instructions set ?

Thank you in advance for any help you can provide.

Dolu1990, 2023-07-10:
Hi ^^

Sorry for the delay i was AFK holiday XD

So, i pushed a fix for the GenCustomInterrupt demo via https://github.com/SpinalHDL/VexRiscv/commit/1746af1cfe11d0f75b6d3b4460c7d4a0ff8cf98f

(just have to have the CsrPlugin first in the list, that's not great, i would say even a bit flawed, but hooo well XD)

> I have second question. How can you choose to enable or not the 'A' instructions set ?

If you don't have memory coherency, you just need to turn on in the DataCacheConfig the following parameters :
                           withLrSc = true
                           withAmo = true

Note that the atomic stay in the CPU, if you have another memory master it wont be atomic with that other memory master

Closed 2023-10-29.

Thread 353 (2023-07-04):

Error running MURAX on ARTY-A7 board and printing characters over Serial Port using println function

LongStudy, 2023-07-04:
I ran _MURAX_ on _ARTY-A7_ board according to the website below:
`https://github.com/SpinalHDL/VexRiscv/tree/master/scripts/Murax/arty_a7`
The LED does flash but the data from the **serial port is garbled**.

I don't quite know if the situation with this issue is the same with me:
`https://github.com/SpinalHDL/VexRiscv/issues/218`

First of all, I used the _ARTY-A7 100T_ board, except that the chip is different from 35t, the xdc constraint file should be consistent, so I modified `xc7a35ticsg324-1L` to `xc7a100tcsg324-1` in the .tcl file (and `xc7a35t` to `xc7a100t`).

Then I have modified the`/root/VexRiscv/SRC/main/c/murax/hello_world/SRC/main.c` and make it keep `println("hello world arty a7 v1");` in the loop. I tested the generated hex file `src/main/c/murax/hello_world/build/hello_world.hex` in `MuraxWithRamInit` and successfully loop output `hello world arty a7 v1`.

according to the website `https://github.com/SpinalHDL/VexRiscv/tree/master/scripts/Murax/arty_a7`, I ran `make` and `make prog/make flash` in sequence, and I did manage to compile and run. Then the LED does flash but the data from the **serial port is garbled**. My serial port parameters are 115200 and 8N1, the expected `hello world arty a7 v1` was changed to hexadecimal `94 94` or `17 F6` or `33 F2` with 2 Byte long.

As you mentioned in the `https://github.com/SpinalHDL/VexRiscv/issues/218`, I I suspect there is a shift in clock frequency. I want to know whether it is me or the script that causes the serial port to garble. If I am not the only one who has this problem would like to try to fix this error.

Dolu1990, 2023-07-10:
Thanks for the feedback :)
Where did you found the 115200 doc ?

LongStudy, 2023-07-11:
https://github.com/SpinalHDL/VexRiscv/tree/master/scripts/Murax/arty_a7#connect
The document was created earlier and the baud rate error may be caused by murax_arty resetting the clock rate to 100 Mhz but not resetting the serial port baud rate. I haven't looked at the serial divider in detail, so this reason is my guess.

Dolu1990, 2023-07-11:
Ahhhh XD
So, bydefault murax assume 12 Mhz clock and 115200 baudrate, and it happen that 100Mhz/12Mhz*115200=~1mbits/s XD (0.96 to be exact)
So you would need to ajust the frequency setting in Murax

LongStudy, 2023-07-11:
That's what I thought, so I just set the baud rate to 1,000,000, and it work well.

Closed 2023-07-08.

Thread 354 (2023-07-08):

How to add I/Dcache support to MURAX

LongStudy, 2023-07-08:
Hello, I want to know how to add **I/Dcache support to MURAX** for high performance , it seems that in addition to modifying IBusSimplePlugin and DBusSimplePlugin to their cache versions(IBusCachedPlugin/DBusCachedPlugin), also need to modify the bus link.

I see briey has config plugins for `Simple` and `Cached` I/DBUS.
```
for(plugin <- config.plugins) plugin match{
  case plugin : IBusSimplePlugin => iBus = plugin.iBus.toAxi4ReadOnly()
  case plugin : IBusCachedPlugin => iBus = plugin.iBus.toAxi4ReadOnly()
  case plugin : DBusSimplePlugin => dBus = plugin.dBus.toAxi4Shared()
  case plugin : DBusCachedPlugin => dBus = plugin.dBus.toAxi4Shared(true)
```

But murax only has config plugins for `Simple` I/DBUS.
```
for(plugin <- cpu.plugins) plugin match{
  case plugin : IBusSimplePlugin =>
    mainBusArbiter.io.iBus.cmd <> plugin.iBus.cmd
    mainBusArbiter.io.iBus.rsp <> plugin.iBus.rsp
  case plugin : DBusSimplePlugin => {
    if(!pipelineDBus)
      mainBusArbiter.io.dBus <> plugin.dBus
    else {
      mainBusArbiter.io.dBus.cmd << plugin.dBus.cmd.halfPipe()
      mainBusArbiter.io.dBus.rsp <> plugin.dBus.rsp
    }
  }
```

I don't know how to modify plugins to support IBusCachedPlugin/DBusCachedPlugin. If I only modify the I/DBusSimplePlugin of ArrayBuffer(cpuPlugins) to I/DBusCachedPlugin, sbt generates murax with the following error.
```
[info] **********************************************************************************************
[info] [Warning] Elaboration failed (0 error).
[info]           Spinal will restart with scala trace to help you to find the problem.
[info] **********************************************************************************************
[info] [Progress] at 0.305 : Elaborate components
[error] Exception in thread "main" java.lang.AssertionError: assertion failed: ??? vexriscv.MemoryTranslator
[error]         at scala.Predef$.assert(Predef.scala:170)
[error]         at spinal.core.package$.assert(core.scala:500)
[error]         at vexriscv.Pipeline$class.service(Pipeline.scala:26)
[error]         at vexriscv.VexRiscv.service(VexRiscv.scala:128)
[error]         at vexriscv.plugin.DBusCachedPlugin.setup(DBusCachedPlugin.scala:276)
[error]         at vexriscv.plugin.DBusCachedPlugin.setup(DBusCachedPlugin.scala:49)
[error]         at vexriscv.Pipeline$$anonfun$build$2.apply(Pipeline.scala:47)
[error]         at vexriscv.Pipeline$$anonfun$build$2.apply(Pipeline.scala:47)
[error]         at scala.collection.mutable.ResizableArray$class.foreach(ResizableArray.scala:59)
[error]         at scala.collection.mutable.ArrayBuffer.foreach(ArrayBuffer.scala:48)
[error]         at vexriscv.Pipeline$class.build(Pipeline.scala:47)
[error]         at vexriscv.VexRiscv.build(VexRiscv.scala:128)
[error]         at vexriscv.Pipeline$$anonfun$1.apply$mcV$sp(Pipeline.scala:161)
[error]         at spinal.core.Component$$anonfun$prePop$1.apply(Component.scala:180)
[error]         at spinal.core.Component$$anonfun$prePop$1.apply(Component.scala:178)
[error]         at scala.collection.mutable.ResizableArray$class.foreach(ResizableArray.scala:59)
[error]         at scala.collection.mutable.ArrayBuffer.foreach(ArrayBuffer.scala:48)
[error]         at spinal.core.Component.prePop(Component.scala:178)
[error]         at spinal.core.Component.postInitCallback(Component.scala:187)
[error]         at vexriscv.demo.Murax$$anon$4.<init>(Murax.scala:240)
[error]         at vexriscv.demo.Murax.<init>(Murax.scala:227)
[error]         at vexriscv.demo.MuraxWithRamInit$$anonfun$main$6.apply(Murax.scala:546)
[error]         at vexriscv.demo.MuraxWithRamInit$$anonfun$main$6.apply(Murax.scala:546)
[error]         at spinal.core.internals.PhaseCreateComponent$$anonfun$impl$66.apply(Phase.scala:2564)
[error]         at spinal.core.fiber.Engine$$anonfun$create$1.apply$mcV$sp(AsyncCtrl.scala:147)
[error]         at spinal.core.fiber.AsyncThread$$anonfun$1.apply$mcV$sp(AsyncThread.scala:59)
[error]         at spinal.core.fiber.EngineContext$$anonfun$newJvmThread$1.apply$mcV$sp(AsyncCtrl.scala:39)
[error]         at spinal.sim.JvmThread.run(SimManager.scala:51)
[error] Nonzero exit code returned from runner: 1
[error] (Compile / runMain) Nonzero exit code returned from runner: 1
[error] Total time: 8 s, completed Jul 8, 2023 6:54:52 PM
```

Thank you for taking time out of your busy schedule to reply to our issues! Thanks a lot!

Dolu1990, 2023-07-10:
Hi,

So, the initial idea was that Murax is for cacheless design, while Briey is for cache full design.
There is currently no bridge for the i$ d$ to go to the main memory bus of Murax. Not that it would be necessarly something complicated to do, but Murax is mostly tuned to low latency cacheless stuff.

Would that be an issue to move on Briey ?

LongStudy, 2023-07-11:
Thanks a lot. I will try to run Briey on the arty board.

Closed 2023-07-11.

Thread 363 (2023-09-05):

VexRiscvAxi4LinuxPlicClint not respecting the AXI protocol

PedroAntunes178, 2023-09-05:
Hi @Dolu1990,

First and foremost, congratulations on the excellent work in VexRiscv and NaxRiscv.

I've encountered an issue with the `VexRiscvAxi4LinuxPlicClint.v` file generated by VexRiscv. It appears to not comply with the AXI protocol, specifically related to the WVALID signal. According to the AXI documentation:
> When asserted, WVALID must remain asserted until the rising clock edge after the slave asserts WREADY.

As you can see from the image below, the `dBusAxi_wvalid` is brought down to 0 before the `dBusAxi_wready` is asserted. However, as shown in the screenshot below, the `dBusAxi_wvalid` signal is de-asserted before `dBusAxi_wready` is asserted.

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

Upon analyzing the CPU's internal signals, I noticed that the `valid` signal goes down to 0 because `dbus_axi_b_fire` (`bvalid & bready`) is asserted and the signal `when_Utils_l659`, which I believe should be 1, has a value of 0 due to `dBus_cmd_fire` being 0. `dBus_cmd_fire` seems to only be asserted when both `dBusAxi_wready` and `dBusAxi_wvalid` are 1.

I would like to use this CPU on [the SoC I am developing](https://github.com/IObundle/iob-soc-opencryptolinux). Therefor this issue is of upmost importance for me. How could I help to solve this issue? I have very limited knowledge in SpinalHDL.

Dolu1990, 2023-09-08:
Hi,

Yes that's wrong.
Which version of VexRiscv are you using ? (git hash)
Also, can you send me your wave file + VexRiscvAxi4LinuxPlicClint.v you are using ?

Either the issue is on the VexRiscv axi convertion, either it is on the AXI itself returning too many B transactions

Thanks :)

PedroAntunes178, 2023-09-08:
Hello,

Thank you for your prompt response. I wanted to provide you with the information you requested along with the relevant files.

The VexRiscv version I'm using is identified by this git hash: 5ef1bc775fdbe942875dd7906f22aa98e6cffaaf. You can access the VexRiscvAxi4LinuxPlicClint.v file through this GitHub link: [VexRiscvAxi4LinuxPlicClint.v](https://github.com/PedroAntunes178/iob-vexriscv/blob/new_cpu/hardware/src/VexRiscvAxi4LinuxPlicClint.v). I've also sent you an email with the VexRiscvAxi4LinuxPlicClint.v file attached, as per your request. Additionally, I've included the wave files you asked for in the same email.

If you need any more information or have further questions, please don't hesitate to reach out. I appreciate your assistance.

Best regards,
Pedro Antunes

Dolu1990, 2023-09-08:
Hi,

I think you may have a cursed simulator.

Here is a proof :

```
  always @(*) begin
    _zz_when_Utils_l687_1 = 1'b0;
    if(dbus_axi_b_fire) begin
      _zz_when_Utils_l687_1 = 1'b1;
    end
  end
```

=>

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

I don't understand how can be 'X' while it only depends on dbus_axi_b_fire which is not 'X'
XD

Which simulator / version of simulator are you using ?

PedroAntunes178, 2023-09-08:
Hi,

ahahah, I noticed and thought the same.
I used "Icarus Verilog version 11.0 (stable)".
I am curently testing with Verilator and Xcelium and they have a different behaviour. I can give more information after analysing the waves.

jjts, 2023-09-08:
Since dbus_axi_b_fire never toggled, the always statement never triggered. Could this be it? In Verilog, the reg type must be either initialized by reset or depend on something that does. My 2 cents.

Dolu1990, 2023-09-09:
> Since dbus_axi_b_fire never toggled, the always statement never triggered.

Yes, probably, maybe it depend on something which is initialized in its own decalaration ? (wire x = 1'b0) ?

jjts, 2023-09-09:
wire x = 1'b0 is not good practice either.

This is bound to confound simulation tools. It may be interpreted as a signal permanently assigned to 0. So, if later assigned to anything else, it may result in X depending on drive strength.

Also, this kind of initialization is ignored by synthesis tools.

Always statements must see an edge so they are triggered. We know it works with xcelium from Cadence, which may consider instant 0 a special trigger.

If, above, 'reg' is replaced by signal, and 'always' is replaced by 'assign', works for sure.

What I meant before was a true physical init. For example, the output of a flip-flop after a reset or clk edge. These work for simulation and synthesis.

It should be

wire x;

No static init.

If this signal is always X, it is because it has no meaningful initialization.

Sometimes, I write

wire a = b&c;

This works in every simulator and is equivalent to

wire a;
assign a=b&c;

The latter is a better practice as it avoids the confusion with an initialization.

Sorry for the long message :-)

PedroAntunes178, 2023-09-11:
Hi @Dolu1990,

After comparing the waveforms from "Icarus Verilog (IVerilog)" and "Xcelium," we can conclude that the problem is indeed, as @jjts said because the `_zz_when_Utils_l687_1` always block is never triggered. Therefore, its value remains 'x' until `dbus_axi_b_fire` is asserted. This leads to `when_Utils_l687` never being asserted, and `_zz_dBus_cmd_ready_1` is never equal to '0x001'.

One solution would be to assign a default value to the `reg` variable, such as `reg _zz_when_Utils_l687_1 = 1'b0`.

The following change solved the issue, but there may be more problems with untriggered always blocks in "IVerilog":
```
    reg                 _zz_when_Utils_l687 = 1'b0;
    reg                 _zz_when_Utils_l687_1 = 1'b0;
    reg        [2:0]    _zz_dBus_cmd_ready = 3'b000;
    reg        [2:0]    _zz_dBus_cmd_ready_1 = 3'b000;
```

I plan to open an issue on https://github.com/steveicarus/iverilog. This could be a problem stemming from the simulator itself.

Best regards,
Pedro Antunes

jjts, 2023-09-12:
I think iverilog's interpretation is correct, and no issue needs to be filed unless it is customary to run all always statements at t=0, regardless of any dependencies toggling.

Why do other simulators work? Is it because they run the always statements at t=0? Is this the correct thing to do?

It all comes from the 'reg' type, a common source of confusion in Verilog.

A 'reg' isn't a physical entity. It's not even a resgister, as its name suggests.

A 'reg' is a software variable to help compute the physical wires' values, including those of ports.

The statement
reg a =1'b0;
means a is initialized to 0 at t=0.

A variable keeps its value until assigned otherwise.

Since it toggles at t=0, then the always statement triggers, and simulation works.

However, this can be a bad solution if generalized, leading to circuits that work in simulation but not after synthesized.

Physically, there is only one way to initialize a signal: drive it from a flip-flop that has a reset input. No other way. So, if 'a' is mapped to a wire after synthesis, it will be unitialized, and the circuit will not work.

This is why the 'reg' type should NEVER be initialized in a circuit description. In a testbench, this is acceptable, though.

To conclude, to initialize a signal, drive it from a flip-flop with a reset input or make it depend on some other signal which is either a primary input or an output of a flip-flop that has a reset input.

This text was long but necessary to avoid a bad solution to this problem.

tomverbeure, 2023-09-12:
Sorry about the side noise but...

> This is why the 'reg' type should NEVER be initialized in a circuit description.

I agree about this for this particular case, but the statement is not generally true for FPGAs, where initialized regs are common, and totally synthesizable for FF. A "reg a = 1;" will result in the corresponding FF to power up with a value of 1 after the bitstream loading has completed. It's a very common construct.

jjts, 2023-09-12:
Maybe for some FPGAs, but we find that this project can target ASICs and all sorts of FPGAs. This initialization would not work in an ASIC.

If I want a flip-flop to be initialized at power up,  I write

always @(posedge clk, posedge arst)
if (arst)
   a <= 1'b1;
else
   a <= a_nxt;

Works for all FPGAs and ASICs.

Moreover, the 'reg' may not be a flip-flop.  It may simply be a target on a combinational 'always' statement, in which case the initialization is meaningless.

Dolu1990, 2023-09-12:
Looking at the netlist itself, i do not the bad pattern we are talking about :

```verilog
  wire                dbus_axi_b_fire;
  assign dbus_axi_b_fire = (dbus_axi_b_valid && dbus_axi_b_ready);
    always @(*) begin
    _zz_when_Utils_l687_1 = 1'b0;
    if(dbus_axi_b_fire) begin
      _zz_when_Utils_l687_1 = 1'b1;
    end
  end
```

Which for me is seems fine and safe. Or verilog is just a cursed language ?

both Xcelium and iverilog gives the same result ?

PedroAntunes178, 2023-09-12:
Only IVerilog gives that problem. Xcelium works as expected.

PedroAntunes178, 2023-09-12:
Xcelium works as expected, but iverilog presents the problem.

In Xcelium, the _zz_when_Utils_l687_1 has a value of 0 before the bvalid is fired.

jjts, 2023-09-12:
How does dbus_axi_b_ready come to be 0 from t=0?

If by initialization at declaration than this is the source of the problem.
We already checked that dbus_axi_b_valid does change after reset but it is
filtered by ANDing with dbus_axi_b_ready=0.

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

tomverbeure, 2023-09-12:
> Maybe for some FPGAs, but we find that this project can target ASICs and all sorts of FPGAs. This initialization would not work in an ASIC.

I understand that. But the point is: SpinalHDL should not be limited to ASIC only. If FPGA designers want to create code that doesn't have an explicit reset, that should be possible.

It would make sense to have a SpinalHDL Config option to generate RTL with or without explicit reg initialization.

PedroAntunes178, 2023-09-12:
Well, I figured out the problem. I was committing that exact mistake from my side. I had initialized the axi_b_valid register signal with 1'b0, which was causing the issue. The problem was solved by removing the initialization.

In VexRiscvAxi4LinuxPlicClint.v, it appears there are no reg initializations. There is the dbus_axi_b_ready signal, which is constantly assigned to 1'b1, and it might benefit from coming from a flip-flop with a reset value of 1 instead of being a wire. However, I don't have enough knowledge or experience to determine the best practice in this case.

Sorry for any confusion. From my side, I believe this issue could be closed now :)

Dolu1990, 2023-09-14:
> I don't have enough knowledge or experience to determine the best practice in this case.

I would say we should not let the HDL decide the hardware design for us.
I guess an icarus verilog issue should be opened.

jjts, 2023-09-14:
Let's congratulate Icarus Verilog because after trying commercial simulators, iverilog, the free and open-source simulator, was the only one to find the issue.

The issue was real, and it was on our side. As @PedroAntunes178 pointed out, there was an unnecessary

wire a = 1'b0;

This initialization in our design was not synthesizable in general and was bound to create serious problems downstream, besides the fact it was simulating correctly with expensive commercial simulators.

We cannot afford or rely on only synthesizable things for FPGA, and I need to know which FPGA brand will synthesize it and which will not.

We prefer to write tool-agnostic Verilog, although this may be very boring. This is where code generators such as SpinalHDL can be helpful. The tool worries about these details, not the user, who, in this way, is not compromising the design. The user design works equally well with explicit resets or relying upon the startup reset of the FPGA. But my point is: only for that FPGA.

The generator is less useful if the generated HDL only runs on certain FPGAs. The quality of the generated Verilog is much better for SpinalHDL than Migen, which needs code to support tens of different FPGAs and no ASICs. The Migen-produced Verilog is wrong!

Please do not let the same happen to SpinalHDL.

jjts, 2023-09-14:
Hence, I don't think there's any issue with iverilog, to be precise.

Dolu1990, 2023-09-18:
> Please do not let the same happen to SpinalHDL.

Sure :)

Closed 2023-09-18.

Thread 364 (2023-09-18):

Unsupported compressed instruction on VexRiscvAxi4LinuxPlicClint.scala

PedroAntunes178, 2023-09-18:
Hi @Dolu1990 again,

I simply added the following to `VexRiscvAxi4LinuxPlicClint.scala`:
```
 compressedGen = true,
```
So that the CPU would support compressed instructions, and obtained the following error:
```
[info] **********************************************************************************************
[info] [Warning] Elaboration failed (0 error).
[info]           Spinal will restart with scala trace to help you to find the problem.
[info] **********************************************************************************************
[info] [Progress] at 0.921 : Elaborate components
[info] PcManagerSimplePlugin is now useless
[error] Exception in thread "main" java.lang.Exception: Missing inserts : INSTRUCTION_ANTICIPATED
[error] 	at vexriscv.Pipeline$class.build(Pipeline.scala:95)
[error] 	at vexriscv.VexRiscv.build(VexRiscv.scala:126)
[error] 	at vexriscv.Pipeline$$anonfun$1.apply$mcV$sp(Pipeline.scala:161)
[error] 	at spinal.core.Component$$anonfun$prePop$1.apply(Component.scala:180)
[error] 	at spinal.core.Component$$anonfun$prePop$1.apply(Component.scala:178)
[error] 	at scala.collection.mutable.ResizableArray$class.foreach(ResizableArray.scala:59)
[error] 	at scala.collection.mutable.ArrayBuffer.foreach(ArrayBuffer.scala:48)
[error] 	at spinal.core.Component.prePop(Component.scala:178)
[error] 	at spinal.core.Component.postInitCallback(Component.scala:187)
[error] 	at vexriscv.demo.VexRiscvAxi4LinuxPlicClint$$anonfun$1.apply(VexRiscvAxi4LinuxPlicClint.scala:106)
[error] 	at vexriscv.demo.VexRiscvAxi4LinuxPlicClint$$anonfun$1.apply(VexRiscvAxi4LinuxPlicClint.scala:18)
[error] 	at spinal.core.internals.PhaseCreateComponent$$anonfun$impl$67.apply(Phase.scala:2606)
[error] 	at spinal.core.fiber.Engine$$anonfun$create$1.apply$mcV$sp(AsyncCtrl.scala:147)
[error] 	at spinal.core.fiber.AsyncThread$$anonfun$1.apply$mcV$sp(AsyncThread.scala:59)
[error] 	at spinal.core.fiber.EngineContext$$anonfun$newJvmThread$1.apply$mcV$sp(AsyncCtrl.scala:39)
[error] 	at spinal.sim.JvmThread.run(SimManager.scala:51)
[error] Nonzero exit code returned from runner: 1
[error] (Compile / runMain) Nonzero exit code returned from runner: 1
[error] Total time: 6 s, completed Sep 18, 2023, 11:07:55 PM
```

PedroAntunes178, 2023-09-18:
This happens on current master branch with sbt version:
```
sbt version in this project: 1.6.0
sbt script version: 1.8.2
```

PedroAntunes178, 2023-09-18:
Already noticed the comment in the documentation.
```
If you get a Missing inserts : INSTRUCTION_ANTICIPATE error, that's because the RegFilePlugin is configured to use SYNC memory read ports to access the register file, but the IBus plugin configuration can't provide the instruction's register file read address one cycle before the decode stage. To workaround that you can :

    Configure the RegFilePlugin to implement the register file read in a asyncronus manner (ASYNC), if your target device support such things
    If you use the IBusSimplePlugin, you need to enable the injectorStage configuration
    If you use the IBusCachedPlugin, you can either enable the injectorStage, or set twoCycleCache + twoCycleRam to false.

```

Thank you.

Dolu1990, 2023-09-19:
<3

Closed 2023-09-18.

Thread 368 (2023-09-29):

Read speed: dcache width impact 32bit vs 64bit

pottendo, 2023-09-29:
Hello,

again with reference to [this](https://github.com/pottendo/RVCop64-pottendo/tree/wip-mailbox) project I observed the following substantial performance difference when having different widths of `--dcache-width`:

```
################# 32 bit default

$ sbt "runMain vexriscv.demo.smp.VexRiscvLitexSmpClusterCmdGen --cpu-count=1 --ibus-width=32 --dbus-width=32 --dcache-size=4096 --icache-size=4096 --dcache-ways=1 --icache-ways=1 --litedram-width=32 --aes-instruction=False --out-of-order-decoder=True --wishbone-memory=True --fpu=False --cpu-per-fpu=4 --rvc=False --netlist-name=VexRiscvLitexSmpCluster_Cc1_Iw32Is4096Iy1_Dw32Ds4096Dy1_ITs4DTs4_Ood_Wm --netlist-directory=/opt/work/src/orangeCart/RVCop64-scratch/RVCop64-pottendo/hw/deps/pythondata-cpu-vexriscv_smp/pythondata_cpu_vexriscv_smp/verilog --dtlb-size=4 --itlb-size=4"

$ litex_term /dev/ttyACM0
[...]
--=============== SoC ==================--
CPU:		VexRiscv SMP-LINUX @ 80MHz
BUS:		WISHBONE 32-bit @ 4GiB
CSR:		32-bit data
ROM:		48KiB
SRAM:		16KiB
MAIN-RAM:	16384KiB

--========== Initialization ============--
Memtest at 0x40000000 (2.0MiB)...
  Write: 0x40000000-0x40200000 2.0MiB
   Read: 0x40000000-0x40200000 2.0MiB
Memtest OK
Memspeed at 0x40000000 (Sequential, 2.0MiB)...
  Write speed: 21.8MiB/s
   Read speed: 61.0MiB/s

--============== Boot ==================--
Booting from serial...

################# 64 bit --dcache-width=64

$ sbt "runMain vexriscv.demo.smp.VexRiscvLitexSmpClusterCmdGen --cpu-count=1 --ibus-width=32 --dbus-width=64 --dcache-size=4096 --icache-size=4096 --dcache-ways=1 --icache-ways=1 --litedram-width=32 --aes-instruction=False --out-of-order-decoder=True --wishbone-memory=True --fpu=False --cpu-per-fpu=4 --rvc=False --netlist-name=VexRiscvLitexSmpCluster_Cc1_Iw32Is4096Iy1_Dw64Ds4096Dy1_ITs4DTs4_Ood_Wm --netlist-directory=/opt/work/src/orangeCart/RVCop64-scratch/RVCop64-pottendo/hw/deps/pythondata-cpu-vexriscv_smp/pythondata_cpu_vexriscv_smp/verilog --dtlb-size=4 --itlb-size=4"

 [...]

--=============== SoC ==================--
CPU:		VexRiscv SMP-LINUX @ 80MHz
BUS:		WISHBONE 32-bit @ 4GiB
CSR:		32-bit data
ROM:		48KiB
SRAM:		16KiB
MAIN-RAM:	16384KiB

--========== Initialization ============--
Memtest at 0x40000000 (2.0MiB)...
  Write: 0x40000000-0x40200000 2.0MiB
   Read: 0x40000000-0x40200000 2.0MiB
Memtest OK
Memspeed at 0x40000000 (Sequential, 2.0MiB)...
  Write speed: 21.8MiB/s
   Read speed: 13.3MiB/s

--============== Boot ==================--
Booting from serial...
```

as one can see the read speed differs substantially - which of course results in lesser overall performance with 64bit dcache width on this architecture / board.

I wouldn't bother but enabling `--with-fpu` or `--cpu-count=2` implicitly sets 64bit dcache width - so the overall performance gain due to a FPU or even dual core CPU is limited due to the overall slower memory read speed. This is unfortunate, as FPU or multithreaded applications may not be the majority, but handy from time to time...

Anything what one can do about it?

thx, pottendo

PS: Some Caveat:
I couldn't run these tests on the most recent VexRisxVSMP CPUs (see [here](https://github.com/SpinalHDL/VexRiscv/issues/367)).
In case some enhancements have been done in the last 8-10 months affecting this area, this may be 'fixed'...
Thanks for understanding.

Dolu1990, 2023-09-29:
Hi,

Ahhh that's weird that the performance drop.
I would say, the only way to figure that one out would be to run it in simulation to see what is happening exactly.

Seems to me that Read speed: 61.0MiB/s is the outliner XD, as VexRiscv normaly get a higher write speed.

pottendo, 2023-09-29:
hmm,
too long since I've done something with the simulator... You've helped to track down some FPU / multi-threaded [issue](https://github.com/SpinalHDL/VexRiscv/issues/297) on Zephyr/Linux, if you remember.
Can you point me to the right resources, where I can study, how to run this particular bitstream on an emulator? or whatever piece of it...
Or do I need to extract the memtest to a standalone (e.g. Zephyr) program?
bye, pottendo

pottendo, 2023-09-30:
hi,
I've run naively:

64bit:
```
$ litex_sim --sim-debug --cpu-type vexriscv_smp --dcache-width=64 --with-sdram
[...]
--=============== SoC ==================--
CPU:		VexRiscv SMP-LINUX @ 1MHz
BUS:		WISHBONE 32-bit @ 4GiB
CSR:		32-bit data
ROM:		128.0KiB
SRAM:		8.0KiB
L2:		8.0KiB
SDRAM:		64.0MiB 32-bit @ 1MT/s (CL-2 CWL-2)
MAIN-RAM:	64.0MiB

--========== Initialization ============--
Initializing SDRAM @0x40000000...
Switching SDRAM to software control.
Switching SDRAM to hardware control.
Memtest at 0x40000000 (8.0KiB)...
  Write: 0x40000000-0x40002000 8.0KiB
   Read: 0x40000000-0x40002000 8.0KiB
Memtest OK
Memspeed at 0x40000000 (Sequential, 8.0KiB)...
  Write speed: 1.6MiB/s
   Read speed: 871.5KiB/s

--============== Boot ==================--

litex> mem_speed 0x40000000 102400
Memspeed at 0x40000000 (Sequential, 100.0KiB)...
  Write speed: 1.6MiB/s
   Read speed: 878.7KiB/s
```

and here the 32bit:

```
$ litex_sim --sim-debug --cpu-type vexriscv_smp --dcache-width=32 --with-sdram
--=============== SoC ==================--
CPU:		VexRiscv SMP-LINUX @ 1MHz
BUS:		WISHBONE 32-bit @ 4GiB
CSR:		32-bit data
ROM:		128.0KiB
SRAM:		8.0KiB
L2:		8.0KiB
SDRAM:		64.0MiB 32-bit @ 1MT/s (CL-2 CWL-2)
MAIN-RAM:	64.0MiB

--========== Initialization ============--
Initializing SDRAM @0x40000000...
Switching SDRAM to software control.
Switching SDRAM to hardware control.
Memtest at 0x40000000 (8.0KiB)...
  Write: 0x40000000-0x40002000 8.0KiB
   Read: 0x40000000-0x40002000 8.0KiB
Memtest OK
Memspeed at 0x40000000 (Sequential, 8.0KiB)...
  Write speed: 1.6MiB/s
   Read speed: 874.6KiB/s
[...]
--============= Console ================--

litex> mem_speed 0x40000000 102400
Memspeed at 0x40000000 (Sequential, 100.0KiB)...
  Write speed: 1.6MiB/s
   Read speed: 878.8KiB/s
```

No difference, 64bit vs. 32bit dcache-width, and confirmed that the write speed is faster.

Not sure if this experiment can even be representative for my observation on the real hardware.
What I can confirm is, that the performance on the real FPGA HW is substantially different. I've done a testcase where the one with `--dcache-width=64` takes ~625s and with `--dcache-width=32` its around 125s and even fast with `--cpu-type=vexriscv` (32bit dcache default) it's around 114s.

bye, pottendo

Dolu1990, 2023-09-30:
Hi ^^

What memory system do you use on hardware ? (DDR, ... ) ?

Regards
Charles

pottendo, 2023-09-30:
Well, don't know more than it's 'Hyperram'.
The partlist is here: https://github.com/zeldin/OrangeCart
My project is a fork of the RVCop64 project.

Can't open kicad files, so I can't tell you more, Sorry.

Bye, pottendo

Dolu1990, 2023-09-30:
Ahhh then, one possibility, is that the hyperram controller successfuly reconize 32 bits based burst, but fail at reconizing the 64 bits based ones ?

pottendo, 2023-09-30:
...must be something like this, I suppose.
Here some more information: https://github.com/zeldin/litehyperram/tree/22123da560144fdc7113a1d72f1bda8e4beea5da
At least some information about bursts: `- Arbitrary burst length` ...

pottendo, 2023-09-30:
oops, mistakenly closed -> however, this is probably off-topic here, so @Dolu1990, it's ok to be closed.
Thanks for the feedback so far - maybe there's a solution; need to check with @zeldin.

pottendo, 2023-10-13:
@zeldin has fixed the issue - thanks @Dolu1990 and @zeldin!
as always, you guys rock!

Dolu1990, 2023-10-13:
<3

Closed 2023-10-13.

Thread 371 (2023-10-10):

Assertion when tracing the elaboration issue

eruanno123, 2023-10-10:
Hello, I am having some issues that make debugging my design quite tedious. I have no doubts I have mistakes like missing connections to ports. My understanding is that SpinalHDL executes the "second pass" to identify what fails the elaboration.

Unfortunately, during this second pass, I am getting a long assertion trace from a seemingly unrelated component. Normally, I should get a list of things that fail elaboration, which would make correcting code easy.

I am relatively new to VexRiscv and SpinalHDL in general, so I am having difficulty following up and understanding what's going on in the cache plugin. Do you have any idea what could cause the assertion in the `DecoderSimplePlugin.addDefault` function, but only when Spinal restarts with a trace to identify the elaboration problem?

Meanwhile, I am working on a minimum working example, which I will try to provide soon.

```
[info] [Warning] Elaboration failed (6 errors).
[info]           Spinal will restart with scala trace to help you to find the problem.
[info] **********************************************************************************************
[info] [Progress] at 1.991 : Elaborate components
[error] Exception in thread "main" java.lang.AssertionError: assertion failed
[error]         at scala.Predef$.assert(Predef.scala:208)
[error]         at spinal.core.package$.assert(core.scala:497)
[error]         at vexriscv.plugin.DecoderSimplePlugin.addDefault(DecoderSimplePlugin.scala:67)
[error]         at vexriscv.plugin.IBusCachedPlugin.setup(IBusCachedPlugin.scala:103)
[error]         at vexriscv.plugin.IBusCachedPlugin.setup(IBusCachedPlugin.scala:28)
[error]         at vexriscv.Pipeline.$anonfun$build$2(Pipeline.scala:47)
[error]         at vexriscv.Pipeline.$anonfun$build$2$adapted(Pipeline.scala:47)
[error]         at scala.collection.mutable.ResizableArray.foreach(ResizableArray.scala:62)
[error]         at scala.collection.mutable.ResizableArray.foreach$(ResizableArray.scala:55)
[error]         at scala.collection.mutable.ArrayBuffer.foreach(ArrayBuffer.scala:49)
[error]         at vexriscv.Pipeline.build(Pipeline.scala:47)
[error]         at vexriscv.Pipeline.build$(Pipeline.scala:45)
[error]         at vexriscv.VexRiscv.build(VexRiscv.scala:126)
[error]         at vexriscv.Pipeline.$anonfun$$init$$1(Pipeline.scala:161)
[error]         at spinal.core.Component.$anonfun$prePop$1(Component.scala:180)
[error]         at spinal.core.Component.$anonfun$prePop$1$adapted(Component.scala:178)
[error]         at scala.collection.mutable.ResizableArray.foreach(ResizableArray.scala:62)
[error]         at scala.collection.mutable.ResizableArray.foreach$(ResizableArray.scala:55)
[error]         at scala.collection.mutable.ArrayBuffer.foreach(ArrayBuffer.scala:49)
[error]         at spinal.core.Component.prePop(Component.scala:178)
[error]         at spinal.core.Component.postInitCallback(Component.scala:187)
[error]         at vexriscv.custom.Risky$$anon$3$$anon$4.<init>(Risky.scala:328)
[error]         at vexriscv.custom.Risky$$anon$3.<init>(Risky.scala:319)
[error]         at vexriscv.custom.Risky.<init>(Risky.scala:271)
[error]         at vexriscv.custom.RiskyDe0Nano$.$anonfun$main$1(Risky.scala:550)
[error]         at spinal.core.internals.PhaseCreateComponent.$anonfun$impl$274(Phase.scala:2606)
[error]         at spinal.core.fiber.Engine$.$anonfun$create$1(AsyncCtrl.scala:147)
[error]         at spinal.core.fiber.AsyncThread.$anonfun$jvmThread$1(AsyncThread.scala:59)
[error]         at spinal.core.fiber.EngineContext.$anonfun$newJvmThread$1(AsyncCtrl.scala:39)
[error]         at spinal.sim.JvmThread.run(SimManager.scala:51)
[error] Nonzero exit code returned from runner: 1
[error] (Compile / runMain) Nonzero exit code returned from runner: 1
[error] Total time: 11 s, completed Oct 10, 2023, 11:21:36 AM
```

eruanno123, 2023-10-10:
Btw. "vexriscv.custom.Risky" is a copy of "Briey" with my customization to the peripherals. As I mentioned, I will try to provide an example of the issue, once I strip it down from many things unrelated to the main issue.

eruanno123, 2023-10-10:
The reasonable workaround I just found is enabling the traces during the first pass by providing `debugComponents` to the `SpinalConfig`:

```scala
val debugComponents = HashSet[Class[_]]()
debugComponents += this.getClass()

val config =
  SpinalConfig(
    /*... */,
    debugComponents = debugComponents
  )

config.generateVerilog({
  val toplevel = new Risky(riskyConfig.copy(sdramLayout = IS42x160G.layout))
  toplevel
})
```

Now, I get correct elaboration failure results

```console
[info] [Progress] at 1.721 : Checks and transforms
[error] Exception in thread "main" spinal.core.SpinalExit:
[error]  Error detected in phase PhaseCheck_noLatchNoOverride
[error] ********************************************************************************
[error] ********************************************************************************
[error] NO DRIVER ON (toplevel/axi_bootManager/aclk : in Bool), defined at
[error] ???
[error] ********************************************************************************
[error] ********************************************************************************
[error] NO DRIVER ON (toplevel/axi_bootManager/aresetn : in Bool), defined at
[error] ???
```

Dolu1990, 2023-10-11:
Hi,

> The reasonable workaround I just found is enabling the traces during the first pass by providing debugComponents to the SpinalConfig:

How was your scala main which was generating the hardware before ?
The issue you had will happen if you define the VexRiscv config outside the generateVerilog block.

Was it the case ?

eruanno123, 2023-10-11:
Thanks for the quick response.

I think this might be the case, although I am not sure if making a copy of the configuration counts. I am building the configuration starting from defaults and 'injecting' modifications passed through the command line. I will check if refactoring the code helps.

```scala
class CommandLineConf(arguments: Seq[String]) extends ScallopConf(arguments) {
  val outputDir = opt[String]("output", short = 'O', default = Some("_build"))
  val hwJtag = toggle("hw-jtag")
  val coreFrequency = opt[Int](
    "core-frequency",
    default = Some(100000000),
    validate = (0 to 300000000).contains
  )

  val makeIntRangeArg =
    (name: String, default: Some[Int], minVal: Int, maxVal: Int) =>
      opt[Int](name, default = default, validate = (minVal to maxVal).contains)

  val makeApbAddressArg = (id: Int) =>
    makeIntRangeArg(s"apb${id}-address-width", Some(21), 12, 32)

  val apb1AddressWidth = makeApbAddressArg(1)
  val apb2AddressWidth = makeApbAddressArg(2)

  val noDma = toggle("no-dma")

  verify()

  def propagateRiskyConfig(baseConfig: RiskyConfig): RiskyConfig = {
    baseConfig.copy(
      useHardwareJtag = hwJtag.toOption.getOrElse(false),
      axiFrequency = coreFrequency.toOption.getOrElse(100000000) Hz,
      apb1BusConfig = RiskyConfig.default.apb1BusConfig
        .copy(addressWidth = apb1AddressWidth.toOption.getOrElse(21)),
      apb2BusConfig = RiskyConfig.default.apb2BusConfig
        .copy(addressWidth = apb2AddressWidth.toOption.getOrElse(21)),
      saxi1BusPresent = !noDma.toOption.getOrElse(false)
    )
  }

  def getOutputBuildDirectory(): String = outputDir.toOption.get
}

// Implementation for Terasic DE0-Nano board
object RiskyDe0Nano {
  def main(args: Array[String]) {
    val cmdLineConfig = new CommandLineConf(args)
    val riskyConfig = cmdLineConfig.propagateRiskyConfig(RiskyConfig.default)

   // ... here is some irrelevant SDRAM stuff

    val debugComponents = HashSet[Class[_]]()
    debugComponents += this.getClass()

    val config =
      SpinalConfig(
        targetDirectory = cmdLineConfig.getOutputBuildDirectory(),
        debugComponents = debugComponents
      )

    config.generateVerilog({
      val toplevel =
        new Risky(riskyConfig.copy(sdramLayout = IS42x160G.layout))
      toplevel
    })
  }
}
```

eruanno123, 2023-10-13:
I am confirming this is indeed the reason I am observing the issue. The following modification works as intended:

```scala
    config.generateVerilog({
      // moved riskyConfig here:
      val riskyConfig = cmdLineConfig.propagateRiskyConfig(RiskyConfig.default)
      val toplevel =
        new Risky(riskyConfig.copy(sdramLayout = IS42x160G.layout))
      toplevel
    })
```

Many thanks for help!

Closed 2023-10-13.

Thread 372 (2023-10-18):

Adding FPU to AHBLite3 config file

vidushiy25, 2023-10-18:
Hi, I wanted to add the FPU plugin to the AHBlite3 config file so I can convert everything to Verilog but doing this is giving me errors. I have attached the modified file. Do let me know what's wrong.
[VexRiscvAhbLite3.scala.zip](https://github.com/SpinalHDL/VexRiscv/files/13030328/VexRiscvAhbLite3.scala.zip)

vidushiy25, 2023-10-18:
Hi, I tried doing it and it gives more errors when i use the command :sbt "runMain vexriscv.demo.VexRiscvAhbLite3"

[info] welcome to sbt 1.6.0 (Oracle Corporation Java 19.0.2)
[info] loading settings for project vexriscv-build from plugins.sbt ...
[info] loading project definition from /Users/vidushiyaksh/Desktop/VexRiscv/project
[info] loading settings for project root from build.sbt ...
[info] set current project to VexRiscv (in build file:/Users/vidushiyaksh/Desktop/VexRiscv/)
[info] running (fork) vexriscv.demo.VexRiscvAhbLite3
[info] [Runtime] SpinalHDL v1.9.3    git head : 029104c77a54c53f1edda327a3bea333f7d65fd9
[info] [Runtime] JVM max memory : 4096.0MiB
[info] [Runtime] Current date : 2023.10.18 16:32:41
[info] [Progress] at 0.000 : Elaborate components
[info] **********************************************************************************************
[info] [Warning] Elaboration failed (0 error).
[info]           Spinal will restart with scala trace to help you to find the problem.
[info] **********************************************************************************************
[info] [Progress] at 0.231 : Elaborate components
[error] Exception in thread "main" java.lang.AssertionError: assertion failed: ??? vexriscv.plugin.DBusEncodingService
[error] 	at scala.Predef$.assert(Predef.scala:170)
[error] 	at spinal.core.package$.assert(core.scala:500)
[error] 	at vexriscv.Pipeline$class.service(Pipeline.scala:26)
[error] 	at vexriscv.VexRiscv.service(VexRiscv.scala:126)
[error] 	at vexriscv.plugin.FpuPlugin.setup(FpuPlugin.scala:175)
[error] 	at vexriscv.plugin.FpuPlugin.setup(FpuPlugin.scala:25)
[error] 	at vexriscv.Pipeline$$anonfun$build$2.apply(Pipeline.scala:47)
[error] 	at vexriscv.Pipeline$$anonfun$build$2.apply(Pipeline.scala:47)
[error] 	at scala.collection.mutable.ResizableArray$class.foreach(ResizableArray.scala:59)
[error] 	at scala.collection.mutable.ArrayBuffer.foreach(ArrayBuffer.scala:48)
[error] 	at vexriscv.Pipeline$class.build(Pipeline.scala:47)
[error] 	at vexriscv.VexRiscv.build(VexRiscv.scala:126)
[error] 	at vexriscv.Pipeline$$anonfun$1.apply$mcV$sp(Pipeline.scala:161)
[error] 	at spinal.core.Component$$anonfun$prePop$1.apply(Component.scala:180)
[error] 	at spinal.core.Component$$anonfun$prePop$1.apply(Component.scala:178)
[error] 	at scala.collection.mutable.ResizableArray$class.foreach(ResizableArray.scala:59)
[error] 	at scala.collection.mutable.ArrayBuffer.foreach(ArrayBuffer.scala:48)
[error] 	at spinal.core.Component.prePop(Component.scala:178)
[error] 	at spinal.core.Component.postInitCallback(Component.scala:187)
[error] 	at vexriscv.demo.VexRiscvAhbLite3$$anonfun$1.apply(VexRiscvAhbLite3.scala:145)
[error] 	at vexriscv.demo.VexRiscvAhbLite3$$anonfun$1.apply(VexRiscvAhbLite3.scala:25)
[error] 	at spinal.core.internals.PhaseCreateComponent$$anonfun$impl$67.apply(Phase.scala:2606)
[error] 	at spinal.core.fiber.Engine$$anonfun$create$1.apply$mcV$sp(AsyncCtrl.scala:147)
[error] 	at spinal.core.fiber.AsyncThread$$anonfun$1.apply$mcV$sp(AsyncThread.scala:59)
[error] 	at spinal.core.fiber.EngineContext$$anonfun$newJvmThread$1.apply$mcV$sp(AsyncCtrl.scala:39)
[error] 	at spinal.sim.JvmThread.run(SimManager.scala:51)
[error] Nonzero exit code returned from runner: 1
[error] (Compile / runMain) Nonzero exit code returned from runner: 1

The file with the import line :
[AHBLITE3FPU.zip](https://github.com/SpinalHDL/VexRiscv/files/13030621/AHBLITE3FPU.zip)

Dolu1990, 2023-10-18:
Ahhh that's because the FPU only support the data cache, so you need to use DBusCachedPlugin instead of DBusSimplePlugin

Dolu1990, 2023-10-18:
uncomment the 2 lines :
//            memoryTranslatorPortConfig = null
...
//          ),

Dolu1990, 2023-10-18:
you can remove :
,
             catchMemoryTranslationMiss = true

vidushiy25, 2023-10-18:
Thanks, it works. How would I connect this to an AHB interconnect? Would I just need to connect the iBusAhbLite3 signals to the AHB interconnect or do I also need to figure out how to connect the dBus signals?

Closed 2023-10-18.

Thread 373 (2023-10-30):

Scratchpad memory with cached IBUS and DBUS?

piondeno, 2023-10-30:
Dear all
Could IBUS and DBUS of Vexriscv have scratchpad memory (1T) for high speed operation?
At the same time, it also provide cached IBUS and DBUS for low speed memory (Flash memory).
Is it possibile to config Vexriscv for above requirements?

Dolu1990, 2023-10-30:
Hi, what do you mean by 1T ?

Currently, thigly coupled ram is supported for i$. for the d$ the user can use a peripheral memory mapped in IO region, but at a performance cost

piondeno, 2023-10-31:
Hi, Dolu1990
Thanks for your reply.
The 1T what I mean is that can IBusCachedPlugin  fetch instruction only 1 clock delay after sending vailde PC address in some memory region.

Tightly coupled ram is that I want and I will try to generate TCM for testing it.
Thanks a lot.

piondeno, 2023-10-31:
Hi, Dolu1990
Thanks for reply again.
I am trying to implement TCM.
But I am a new one in SpinalHdl, encounter errors continuously.
I try to find the reference code for TCM and seems like none in "demo" folder.

I write the following code to generate TCM, but not success.
      for(plugin <- config.plugins) plugin match{
        //case plugin : IBusSimplePlugin => iBus = plugin.iBus.toAxi4ReadOnly()
        case plugin : IBusCachedPlugin => {
          iBus = plugin.iBus.toAxi4ReadOnly()
          val iBusTc=plugin.newTightlyCoupledPortV2(TightlyCoupledPortParameter("iBusTc", a => a(31 downto 28) === 0x0 && a(10)))
          val tcmMemDataWidth = log2Up(1024)
          val tcmMem = new Mem(Bits(32 bits), wordCount = 1024)
          iBusTc.data := tcmMem.readSync(iBusTc.address((tcmMemDataWidth-1) downto 0),iBusTc.enable)
        }

Could you provide me a simple demo for TCM?
Thanks a lot.

Dolu1990, 2023-10-31:
Hi, I will add a demo

Dolu1990, 2023-10-31:
Done, see https://github.com/SpinalHDL/VexRiscv/blob/281818af9c04517baa7c6dffe62e229bfa7e036a/src/main/scala/vexriscv/demo/GenFullWithTcm.scala

piondeno, 2023-11-01:
Thanks for the demo.
After download the file and run this demo, it shows one error.

`/home/datakey/tools/VexRiscV/VexRiscv-Idea/src/main/scala/vexriscv/demo/GenFullWithTcm.scala:55:40
type mismatch;
 found   : vexriscv.plugin.TightlyCoupledDataPortParameter
 required: spinal.core.UInt => spinal.core.Bool
        TightlyCoupledDataPortParameter("dBusTc", a => a(31 downto 28) === 0x3)`

Do you encounter same status?
If it only occurs on my project, I will re-clone whole project again.

I mark line 54 and 55 off and only generate TCM for IBusCachedPlugin.
It can generate verilog code successfully.

I plan to use a single-port ram to implement TCM and make sure debug-port also can assess this TCM.
Thanks a lot.

Dolu1990, 2023-11-02:
Hi,
> After download the file and run this demo, it shows one error.

You may have a too hold vexriscv, need to update it i guess.

Also, note that i pushed another example which integrate the memory directly in VexRiscv, but as a dual ported blackbox :
https://github.com/SpinalHDL/VexRiscv/commit/beeec94344bd0caede9b0d91aee3e198d8b6f5b3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

piondeno, 2023-11-16:
Hi Dolu1990, thanks for your help.

After re-download the vexriscv,  there is no error on previous demo file.
I will try the new demo file, thanks a lot.

piondeno, 2023-11-20:
Hi @Dolu1990,

May I ask for your help?

First, I want to single-port to implement TCM and rewrite the code for build.
```
  override def build(pipeline: VexRiscv) = {
    val logic = pipeline plug new Area {
      val ram = Mem(Bits(32 bits), mapping.size.toInt/4)
//      ram.generateAsBlackBox()
      val address = Mux(ibus.enable,(ibus.address >> 2),(dbus.address >> 2)).resized
      val tcmRam = new Area{
        val readData = ram.readWriteSync(
            address = address,
            data    = dbus.write_data,
            enable  = (dbus.enable | ibus.enable),
            write   = dbus.write_enable,
            mask    = dbus.write_mask
          )
        dbus.read_data := readData
        ibus.data := readData
      }
```

Second, I generate two TCM for ITCM and DTCM.
```
  val ITCM = new IBusDBusCachedTightlyCoupledRam(
    mapping = SizeMapping(0x20000000, 0x2000)
  )
  val DTCM = new IBusDBusCachedTightlyCoupledRam(
    mapping = SizeMapping(0x30000000, 0x1000)
  )
```

Third, modify the ld file to seperate code and data.
And seperate the hex file as two parts for simulation.
One is for ITCM and the other for DTCM.
```
MEMORY {
  iTcm (WX!R)/*(RX)*/ : ORIGIN = 0x20000000, LENGTH = 8K
  dTcm (W!RX) : ORIGIN = 0x30000000, LENGTH = 4K
}
_stack_size = 2k;
_heap_size = 0k;

SECTIONS /*TODO don't initialize useless things,  restore literal loading that use 2 instruction in place of onChipRam word */
{
  .vector : {
    *crt.o(.text);
  } > iTcm

  .memory : {
    *(.text);
    end = .;
  } > iTcm

  .rodata         :
  {
    *(.rdata)
    *(.rodata .rodata.*)
    *(.gnu.linkonce.r.*)
  } > dTcm
```

Fourth, I try to use HexTools.initRam() to initial the content of TCM RAM.
But I can not file the hierarchy than can point to the RAM of TCM.
Could you give me some suggestion ?
```
HexTools.initRam(toplevel.axi.???, "/home/datakey/myProject/VexRiscvSocSoftware-master/projects/briey/timer/build/timerITCM.hex", 0x20000000l)
HexTools.initRam(toplevel.axi.???, "/home/datakey/myProject/VexRiscvSocSoftware-master/projects/briey/timer/build/timerDTCM.hex", 0x30000000l)

```
[Ryan.zip](https://github.com/SpinalHDL/VexRiscv/files/13406100/Ryan.zip)

Dolu1990, 2023-11-25:
Hi,
I pushed more arguements to ramOffset
Currently, the idea of the IBusDBusCachedTightlyCoupledRam.
See https://github.com/SpinalHDL/VexRiscv/commit/7c6c7a6fe5aed7f55ae7119b95e5cd569f0efc90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

So, you need to set ramAsBlackbox=false hexInit=pathOfHexFile ramOffset=offsetAtWhichTheRamIsMapped

piondeno, 2023-12-05:
Thanks for @Dolu1990  once again.

I still make some modification for using single port  sram like this

```scala
  override def build(pipeline: VexRiscv) = {
    val logic = pipeline plug new Area {
      val muxAddress = Mux(ibus.enable,(ibus.address >> 2),(dbus.address >> 2)).resized
      val muxEnable = (dbus.enable | ibus.enable)
      val ram = Mem(Bits(32 bits), mapping.size.toInt/4)
      if(ramAsBlackbox) ram.generateAsBlackBox()
      if (hexInit != null) {
        assert(ramOffset != -1)
        val temp = ramOffset.toBigInt
        initRam(ram, hexInit, temp, allowOverflow = true)
      }
      val tcmRam = new Area {
        val readData = ram.readWriteSync(
          address = muxAddress,
          data = dbus.write_data,
          enable = muxEnable,
          write = dbus.write_enable && dbus.enable,
          mask = dbus.write_mask
        )
        dbus.read_data := readData
        ibus.data := readData
      }
    }
  }
```
Now I can use load hex file to ITCM and DTCM directly and run the simulation successfully.
After programming the FPGA, I also can use debug port (JTAG)  to download program into ITCM and DTCM.
Thanks

Dolu1990, 2023-12-11:
Hi,

I'm just a bit scared with that modification, because it seems that if the ibus and dbus acess at the same time, then dbus request will be ignored ?

piondeno, 2023-12-12:
Hi,
[linkerTcm.zip](https://github.com/SpinalHDL/VexRiscv/files/13642539/linkerTcm.zip)

First, I use linkerTcm.ld to separate .text and .data
And generate ITCM for .text and DTCM for .data
In the simulation, I did not see any request from dbus.enable in ITCM bus.

Second, run the debug mode in eclipse IDE.
It is OK to download program.
I can set break point , run single step and not encounter any problem and crash right now.
It seems like no collision in debug mode.

If you need more testing, please let me know.
Thanks

Dolu1990, 2023-12-18:
Ahhh ok ^^
I understand now,
Thanks

Closed 2023-12-05.

Thread 376 (2023-11-12):

Combinatorial loop with AhbLite3Decoder

patstew, 2023-11-12:
If I connect the VexRiscV to a AhbLite3Decoder from SpinalHDL I get a combinatorial loop.

```
package vexriscv.demo

import spinal.core._
import spinal.lib._
import spinal.lib.bus.amba3.ahblite._
import vexriscv.plugin._
import vexriscv.{VexRiscv, VexRiscvConfig, plugin}

class AHBTest() extends Component{
  //CPU configuration
  val cpuConfig = VexRiscvConfig(
    plugins = List(
      new IBusSimplePlugin(
        resetVector = 0x80000000l,
        cmdForkOnSecondStage = false,
        cmdForkPersistence = true,
        prediction = STATIC,
        catchAccessFault = false,
        compressedGen = false
      ),
      new DBusSimplePlugin(
        catchAddressMisaligned = false,
        catchAccessFault = false
      ),
      new StaticMemoryTranslatorPlugin(
        ioRange      = _(31 downto 28) === 0xF
      ),
      new DecoderSimplePlugin(
        catchIllegalInstruction = true
      ),
      new RegFilePlugin(
        regFileReadyKind = plugin.SYNC,
        zeroBoot = false
      ),
      new IntAluPlugin,
      new SrcPlugin(
        separatedAddSub = false,
        executeInsertion = true
      ),
      new FullBarrelShifterPlugin,
      new MulPlugin,
      new DivPlugin,
      new HazardSimplePlugin(
        bypassExecute           = true,
        bypassMemory            = true,
        bypassWriteBack         = true,
        bypassWriteBackBuffer   = true,
        pessimisticUseSrc       = false,
        pessimisticWriteRegFile = false,
        pessimisticAddressMatch = false
      ),
      new DebugPlugin(ClockDomain.current.clone(reset = Bool().setName("debugReset"))),
      new BranchPlugin(
        earlyBranch = false,
        catchAddressMisaligned = true
      ),
      new CsrPlugin(
        config = CsrPluginConfig(
          catchIllegalAccess = false,
          mvendorid      = null,
          marchid        = null,
          mimpid         = null,
          mhartid        = null,
          misaExtensionsInit = 66,
          misaAccess     = CsrAccess.NONE,
          mtvecAccess    = CsrAccess.NONE,
          mtvecInit      = 0x00000020l,
          mepcAccess     = CsrAccess.READ_WRITE,
          mscratchGen    = false,
          mcauseAccess   = CsrAccess.READ_ONLY,
          mbadaddrAccess = CsrAccess.READ_ONLY,
          mcycleAccess   = CsrAccess.NONE,
          minstretAccess = CsrAccess.NONE,
          ecallGen       = false,
          wfiGenAsWait         = false,
          ucycleAccess   = CsrAccess.NONE,
          uinstretAccess = CsrAccess.NONE
        )
      ),
      new YamlPlugin("cpu0.yaml")
    )
  )

  //CPU instanciation
  val cpu = new VexRiscv(cpuConfig)
  var ibus : AhbLite3 = null
  var dbus : AhbLite3 = null

    //Checkout plugins used to instanciate the CPU to connect them to the SoC
    for(plugin <- cpu.plugins) plugin match{
      case plugin : IBusSimplePlugin =>
        ibus = plugin.iBus.toAhbLite3Master().toAhbLite3()
      case plugin : DBusSimplePlugin =>
        dbus = plugin.dBus.toAhbLite3Master(true).toAhbLite3()
      case _ =>
    }

  val ram = AhbLite3OnChipRam(AhbLite3Config(32, 32), 16 kB)

  val dbusdecoder = AhbLite3Decoder(
              master = dbus,
              slaves = List(
                    ram.io.ahb -> (0x10000000, 16 kB)
              ))
}

object VexRiscvAhbLite3{
  def main(args: Array[String]) {
    SpinalVerilog(new AHBTest())
  }
}
```

```
[error] COMBINATORIAL LOOP :
[error]   Partial chain :
[error]     >>> (toplevel/??? :  Bool) at spinal.lib.bus.amba3.ahblite.AhbLite3Master.<init>(AhbLite3.scala:68) >>>
[error]     >>> (toplevel/cpu/dBus_rsp_ready : in Bool) at vexriscv.plugin.DBusSimpleRsp.<init>(DBusSimplePlugin.scala:25) >>>
[error]     >>> (toplevel/cpu/when_DBusSimplePlugin_l489 :  Bool) at vexriscv.plugin.DBusSimplePlugin$$anon$6.<init>(DBusSimplePlugin.scala:489) >>>
[error]     >>> (toplevel/cpu/memory_arbitration_haltItself :  Bool) at vexriscv.Stage$$anon$1.<init>(Stage.scala:49) >>>
[error]     >>> (toplevel/cpu/memory_arbitration_isStuck :  Bool) at vexriscv.Stage$$anon$1.<init>(Stage.scala:55) >>>
[error]     >>> (toplevel/cpu/execute_arbitration_isStuckByOthers :  Bool) at vexriscv.Stage$$anon$1.<init>(Stage.scala:56) >>>
[error]     >>> (toplevel/cpu/dBus_cmd_valid : out Bool) at spinal.lib.Stream.<init>(Stream.scala:55) >>>
[error]     >>> (toplevel/??? :  Bits[2 bits]) at spinal.lib.bus.amba3.ahblite.AhbLite3Master.<init>(AhbLite3.scala:60) >>>
[error]     >>> (toplevel/dbusdecoder/io_input_HTRANS : in Bits[2 bits]) at spinal.lib.bus.amba3.ahblite.AhbLite3.<init>(AhbLite3.scala:115) >>>
[error]     >>> (toplevel/dbusdecoder/isIdle :  Bool) at spinal.lib.bus.amba3.ahblite.AhbLite3.isIdle(AhbLite3.scala:136) >>>
[error]     >>> (toplevel/dbusdecoder/decodesSlaves :  Bits[1 bits]) at spinal.lib.TraversableOncePimped.asBits(Utils.scala:1158) >>>
[error]     >>> (toplevel/dbusdecoder/decodeDefaultSlave :  Bool) at spinal.lib.bus.amba3.ahblite.AhbLite3Decoder.<init>(AhbLite3Decoder.scala:156) >>>
[error]     >>> (toplevel/dbusdecoder/decodedSels :  Bits[2 bits]) at spinal.lib.bus.amba3.ahblite.AhbLite3Decoder.<init>(AhbLite3Decoder.scala:158) >>>
[error]     >>> (toplevel/dbusdecoder/noneIdleSwitchDetected :  Bool) at spinal.lib.bus.amba3.ahblite.AhbLite3Decoder.<init>(AhbLite3Decoder.scala:163) >>>
[error]     >>> (toplevel/dbusdecoder/applyedSels :  Bits[2 bits]) at spinal.lib.bus.amba3.ahblite.AhbLite3Decoder.<init>(AhbLite3Decoder.scala:159) >>>
[error]     >>> (toplevel/dbusdecoder/io_outputs_0_HSEL : out Bool) at spinal.lib.bus.amba3.ahblite.AhbLite3.<init>(AhbLite3.scala:109) >>>
[error]     >>> (toplevel/ram/io_ahb_HSEL : in Bool) at spinal.lib.bus.amba3.ahblite.AhbLite3.<init>(AhbLite3.scala:109) >>>
[error]     >>> (toplevel/ram/io_ahb_HREADYOUT : out Bool) at spinal.lib.bus.amba3.ahblite.AhbLite3.<init>(AhbLite3.scala:123) >>>
[error]     >>> (toplevel/dbusdecoder/io_outputs_0_HREADYOUT : in Bool) at spinal.lib.bus.amba3.ahblite.AhbLite3.<init>(AhbLite3.scala:123) >>>
[error]     >>> (toplevel/dbusdecoder/slaveReadyOutReduction :  Bool) at spinal.lib.bus.amba3.ahblite.AhbLite3Decoder$$anonfun$8.apply(AhbLite3Decoder.scala:153) >>>
[error]     >>> (toplevel/dbusdecoder/io_input_HREADYOUT : out Bool) at spinal.lib.bus.amba3.ahblite.AhbLite3.<init>(AhbLite3.scala:123) >>>
[error]     >>> (toplevel/??? :  Bool) at spinal.lib.bus.amba3.ahblite.AhbLite3.<init>(AhbLite3.scala:123) >>>
[error]   Full chain :
[error]     (toplevel/??? :  Bool)
[error]     Bool && Bool
[error]     (toplevel/cpu/dBus_rsp_ready : in Bool)
[error]     ! Bool
[error]     Bool || Bool
[error]     Bool && Bool
[error]     (toplevel/cpu/when_DBusSimplePlugin_l489 :  Bool)
[error]     spinal.core.internals.WhenStatement@154bd49b
[error]     (toplevel/cpu/memory_arbitration_haltItself :  Bool)
[error]     Bool || Bool
[error]     (toplevel/cpu/memory_arbitration_isStuck :  Bool)
[error]     Bool || Bool
[error]     Bool || Bool
[error]     Bool || Bool
[error]     (toplevel/cpu/execute_arbitration_isStuckByOthers :  Bool)
[error]     ! Bool
[error]     Bool && Bool
[error]     Bool && Bool
[error]     Bool && Bool
[error]     Bool && Bool
[error]     (toplevel/cpu/dBus_cmd_valid : out Bool)
[error]     Bits -> Bits
[error]     Bits ## Bits
[error]     (toplevel/??? :  Bits[2 bits])
[error]     (toplevel/dbusdecoder/io_input_HTRANS : in Bits[2 bits])
[error]     Bits === Bits
[error]     (toplevel/dbusdecoder/isIdle :  Bool)
[error]     ! Bool
[error]     Bool && Bool
[error]     Bool && Bool
[error]     Bits -> Bits
[error]     (toplevel/dbusdecoder/decodesSlaves :  Bits[1 bits])
[error]     Bits === Bits
[error]     Bool && Bool
[error]     Bool && Bool
[error]     (toplevel/dbusdecoder/decodeDefaultSlave :  Bool)
[error]     Bits -> Bits
[error]     Bits ## Bits
[error]     (toplevel/dbusdecoder/decodedSels :  Bits[2 bits])
[error]     Bits =/= Bits
[error]     Bool && Bool
[error]     Bool && Bool
[error]     (toplevel/dbusdecoder/noneIdleSwitchDetected :  Bool)
[error]     ! Bool
[error]     (Bool ? Bits | Bits)[2 bits]
[error]     (toplevel/dbusdecoder/applyedSels :  Bits[2 bits])
[error]     Bits(Int)
[error]     (toplevel/dbusdecoder/io_outputs_0_HSEL : out Bool)
[error]     (toplevel/ram/io_ahb_HSEL : in Bool)
[error]     Bool && Bool
[error]     Bool && Bool
[error]     Bool && Bool
[error]     Bool && Bool
[error]     ! Bool
[error]     (toplevel/ram/io_ahb_HREADYOUT : out Bool)
[error]     (toplevel/dbusdecoder/io_outputs_0_HREADYOUT : in Bool)
[error]     Bool && Bool
[error]     (toplevel/dbusdecoder/slaveReadyOutReduction :  Bool)
[error]     Bool && Bool
[error]     (toplevel/dbusdecoder/io_input_HREADYOUT : out Bool)
[error]     (toplevel/??? :  Bool)
[error] ********************************************************************************
```

Dolu1990, 2023-11-14:
Hi ^^
I pushed a fix which avoid the combinatorial loop

```scala
import spinal.core._
import spinal.lib._
import spinal.lib.bus.amba3.ahblite._
import vexriscv.plugin._
import vexriscv.{VexRiscv, VexRiscvConfig, plugin}

class AHBTest() extends Component{
  //CPU configuration
  val cpuConfig = VexRiscvConfig(
    plugins = List(
      new IBusSimplePlugin(
        resetVector = 0x80000000l,
        cmdForkOnSecondStage = false,
        cmdForkPersistence = true,
        prediction = STATIC,
        catchAccessFault = false,
        compressedGen = false
      ),
      new DBusSimplePlugin(
        catchAddressMisaligned = false,
        catchAccessFault = false
      ),
      new StaticMemoryTranslatorPlugin(
        ioRange      = _(31 downto 28) === 0xF
      ),
      new DecoderSimplePlugin(
        catchIllegalInstruction = true
      ),
      new RegFilePlugin(
        regFileReadyKind = plugin.SYNC,
        zeroBoot = false
      ),
      new IntAluPlugin,
      new SrcPlugin(
        separatedAddSub = false,
        executeInsertion = true
      ),
      new FullBarrelShifterPlugin,
      new MulPlugin,
      new DivPlugin,
      new HazardSimplePlugin(
        bypassExecute           = true,
        bypassMemory            = true,
        bypassWriteBack         = true,
        bypassWriteBackBuffer   = true,
        pessimisticUseSrc       = false,
        pessimisticWriteRegFile = false,
        pessimisticAddressMatch = false
      ),
      new DebugPlugin(ClockDomain.current.clone(reset = Bool().setName("debugReset"))),
      new BranchPlugin(
        earlyBranch = false,
        catchAddressMisaligned = true
      ),
      new CsrPlugin(
        config = CsrPluginConfig(
          catchIllegalAccess = false,
          mvendorid      = null,
          marchid        = null,
          mimpid         = null,
          mhartid        = null,
          misaExtensionsInit = 66,
          misaAccess     = CsrAccess.NONE,
          mtvecAccess    = CsrAccess.NONE,
          mtvecInit      = 0x00000020l,
          mepcAccess     = CsrAccess.READ_WRITE,
          mscratchGen    = false,
          mcauseAccess   = CsrAccess.READ_ONLY,
          mbadaddrAccess = CsrAccess.READ_ONLY,
          mcycleAccess   = CsrAccess.NONE,
          minstretAccess = CsrAccess.NONE,
          ecallGen       = false,
          wfiGenAsWait   = false,
          ucycleAccess   = CsrAccess.NONE,
          uinstretAccess = CsrAccess.NONE
        )
      ),
      new YamlPlugin("cpu0.yaml")
    )
  )

  //CPU instanciation
  val cpu = new VexRiscv(cpuConfig)
  var ibus : AhbLite3 = null
  var dbus : AhbLite3 = null

  //Checkout plugins used to instanciate the CPU to connect them to the SoC
  for(plugin <- cpu.plugins) plugin match{
    case plugin : IBusSimplePlugin =>
      ibus = master(plugin.iBus.toAhbLite3Master().toAhbLite3())
    case plugin : DBusSimplePlugin =>
      dbus = (plugin.dBus.toAhbLite3Master(true).toAhbLite3())
    case plugin: DebugPlugin => plugin.debugClockDomain {
      val jtag = slave(new Jtag()).setName("jtag")
      jtag <> plugin.io.bus.fromJtag()
      in(plugin.debugClockDomain.reset)
    }
    case plugin : CsrPlugin => {
      plugin.timerInterrupt.toIo()
      plugin.externalInterrupt.toIo()
    }
    case _ =>
  }

  val ram = AhbLite3OnChipRam(AhbLite3Config(32, 32), 16 kB)

  val dbusdecoder = AhbLite3Decoder(
    master = dbus,
    slaves = List(
      ram.io.ahb -> (0x10000000, 16 kB)
    ))
}

object VexRiscvAhbLite3{
  def main(args: Array[String]) {
    SpinalVerilog(new AHBTest())
  }
}
```

Closed 2023-11-14.

Thread 381 (2023-12-03):

EmbeddedRiscvJtag synthesis issue

gregdavill, 2023-12-03:
## Summary
After adding `EmbeddedRiscvJtag` to a VexRiscv design as described in the README, I was not able to connect to it.
I'm using yosys/nextpnr to target an ECP5, I have an FTDI 2232H connected to the ECP5 (channel A) and I/O pins (channel B).

I've started with the default LietX cpu and swapped in the `EmbeddedRiscvJtag` plugin.

## Details
conf.cfg
```
adapter driver ftdi
ftdi vid_pid 0x0403 0x6010
ftdi channel 1
ftdi layout_init 0x0038 0x003b

transport select jtag
adapter speed 3000

set _CHIPNAME riscv
set _TARGETNAME $_CHIPNAME.cpu

jtag newtap $_CHIPNAME cpu -irlen 5 -expected-id 0x10002FFF
target create $_TARGETNAME.0 riscv -chain-position $_TARGETNAME

init
halt
```

Output from openocd
```
openocd -f ./openocd/conf.cfg
Open On-Chip Debugger 0.12.0
Licensed under GNU GPL v2
For bug reports, read
        http://openocd.org/doc/doxygen/bugs.html
Info : clock speed 3000 kHz
Info : TAP riscv.cpu does not have valid IDCODE (idcode=0xfffffffe)
Error: riscv.cpu: IR capture error; saw 0x1e not 0x01
Warn : Bypassing JTAG setup events due to errors
Error: dtmcontrol is 0. Check JTAG connectivity/board power.
Warn : target riscv.cpu.0 examination failed
Info : starting gdb server for riscv.cpu.0 on 3333
Info : Listening on port 3333 for gdb connections
Error: Target not examined yet
```

## Workaround
From the start I was getting correct results in sim. So focused debugging on the FPGA flow, and it appears that during synthesis something funky was happening leaving me with tdo kept in bypass mode. the yosys logs did not indicate logic removal of the debug core, etc.

I noticed that tap_fsm_state is not reset, and I suppose in theroy is doesn't have to be, since the JTAG tap can reset it's logic with TMS=1 + TCKs

If I alter the rtl and add an initial value to `tap_fsm_state` things work..
```
...
  reg        [1:0]    logic_jtagLogic_dmiStat_value_aheadValue;
  wire       [3:0]    tap_fsm_stateNext;
  reg        [3:0]    tap_fsm_state = 0;  <-------
  wire       [3:0]    _zz_tap_fsm_stateNext;
  wire       [3:0]    _zz_tap_fsm_stateNext_1;
...
```

```
$ openocd -f ./openocd/conf.cfg
Open On-Chip Debugger 0.12.0
Licensed under GNU GPL v2
For bug reports, read
        http://openocd.org/doc/doxygen/bugs.html
Info : clock speed 3000 kHz
Info : JTAG tap: riscv.cpu tap/device found: 0x10002fff (mfg: 0x7ff (<invalid>), part: 0x0002, ver: 0x1)
Info : datacount=1 progbufsize=2
Info : Disabling abstract command reads from CSRs.
Info : Examined RISC-V core; found 1 harts
Info :  hart 0: XLEN=32, misa=0x0
Info : starting gdb server for riscv.cpu.0 on 3333
Info : Listening on port 3333 for gdb connections
Info : Listening on port 6666 for tcl connections
Info : Listening on port 4444 for telnet connections
```

My workaround doesn't really feel like a solution. I'm not sure if this is actually a vexriscv bug? Or a bug in yosys.

gregdavill, 2024-05-19:
It seems like when an initial value is provided the register isn't considered for one-hot translation by yosys step FSM_EXTRACT
```
Not marking orbtrace_mini.VexRiscv.debugTransportModuleJtagTap_1.tap_fsm_state as FSM state register:
    Register has an initialization value.
```

This can also be achieved with
```
  (* fsm_encoding = "none" *) reg        [3:0]    tap_fsm_state;
```

Curiously if I add the reset state and don't just rely on the `default` clause for it in the tap_state case statement:
```
      JtagState_RESET : begin
        _zz_tap_fsm_stateNext_16 = _zz_tap_fsm_stateNext;
      end
```

Yosys report this and things work on the FPGA.
```
Not marking orbtrace_mini.VexRiscv.debugTransportModuleJtagTap_1.tap_fsm_state as FSM state register:
    Circuit seems to be self-resetting.
```

Dolu1990, 2024-05-21:
gg for the debug ^^

So, changing :

```scala
  val stateNext = JtagState()
  val state = RegNext(stateNext) randBoot()
  stateNext := state.mux(
    default    -> (jtag.tms ? RESET     | IDLE),           //RESET
    IDLE       -> (jtag.tms ? DR_SELECT | IDLE),
    IR_SELECT  -> (jtag.tms ? RESET     | IR_CAPTURE),
    IR_CAPTURE -> (jtag.tms ? IR_EXIT1  | IR_SHIFT),
    IR_SHIFT   -> (jtag.tms ? IR_EXIT1  | IR_SHIFT),
    IR_EXIT1   -> (jtag.tms ? IR_UPDATE | IR_PAUSE),
    IR_PAUSE   -> (jtag.tms ? IR_EXIT2  | IR_PAUSE),
    IR_EXIT2   -> (jtag.tms ? IR_UPDATE | IR_SHIFT),
    IR_UPDATE  -> (jtag.tms ? DR_SELECT | IDLE),
    DR_SELECT  -> (jtag.tms ? IR_SELECT | DR_CAPTURE),
    DR_CAPTURE -> (jtag.tms ? DR_EXIT1  | DR_SHIFT),
    DR_SHIFT   -> (jtag.tms ? DR_EXIT1  | DR_SHIFT),
    DR_EXIT1   -> (jtag.tms ? DR_UPDATE | DR_PAUSE),
    DR_PAUSE   -> (jtag.tms ? DR_EXIT2  | DR_PAUSE),
    DR_EXIT2   -> (jtag.tms ? DR_UPDATE | DR_SHIFT),
    DR_UPDATE  -> (jtag.tms ? DR_SELECT | IDLE)
  )
```

into :

```scala
  val stateNext = JtagState()
  val state = RegNext(stateNext) randBoot()
  stateNext := state.mux(
    default    -> (jtag.tms ? RESET     | IDLE),           //RESET
    RESET      -> (jtag.tms ? RESET     | IDLE),   // <---------------------------- adding this line
    IDLE       -> (jtag.tms ? DR_SELECT | IDLE),
    IR_SELECT  -> (jtag.tms ? RESET     | IR_CAPTURE),
    IR_CAPTURE -> (jtag.tms ? IR_EXIT1  | IR_SHIFT),
    IR_SHIFT   -> (jtag.tms ? IR_EXIT1  | IR_SHIFT),
    IR_EXIT1   -> (jtag.tms ? IR_UPDATE | IR_PAUSE),
    IR_PAUSE   -> (jtag.tms ? IR_EXIT2  | IR_PAUSE),
    IR_EXIT2   -> (jtag.tms ? IR_UPDATE | IR_SHIFT),
    IR_UPDATE  -> (jtag.tms ? DR_SELECT | IDLE),
    DR_SELECT  -> (jtag.tms ? IR_SELECT | DR_CAPTURE),
    DR_CAPTURE -> (jtag.tms ? DR_EXIT1  | DR_SHIFT),
    DR_SHIFT   -> (jtag.tms ? DR_EXIT1  | DR_SHIFT),
    DR_EXIT1   -> (jtag.tms ? DR_UPDATE | DR_PAUSE),
    DR_PAUSE   -> (jtag.tms ? DR_EXIT2  | DR_PAUSE),
    DR_EXIT2   -> (jtag.tms ? DR_UPDATE | DR_SHIFT),
    DR_UPDATE  -> (jtag.tms ? DR_SELECT | IDLE)
  )
```

would fix it ?

Dolu1990, 2024-05-21:
(conceptualy, because SpinalHDL will complain that :

UNREACHABLE DEFAULT STATEMENT on
    spinal.lib.com.jtag.JtagFsm.<init>(JtagTap.scala:67)

Dolu1990, 2024-05-21:
```scala
  val stateNext = JtagState()
  val state = RegNext(stateNext) randBoot()
  switch(state, coverUnreachable = true){
    default(stateNext := jtag.tms ? RESET | IDLE)
    def add(k : JtagState.E, t : JtagState.E, f : JtagState.E) = is(k)(stateNext := jtag.tms.mux(t, f))
    add(RESET     , RESET    , IDLE)
    add(IDLE      , DR_SELECT, IDLE)
    add(IR_SELECT , RESET    , IR_CAPTURE)
    add(IR_CAPTURE, IR_EXIT1 , IR_SHIFT)
    add(IR_SHIFT  , IR_EXIT1 , IR_SHIFT)
    add(IR_EXIT1  , IR_UPDATE, IR_PAUSE)
    add(IR_PAUSE  , IR_EXIT2 , IR_PAUSE)
    add(IR_EXIT2  , IR_UPDATE, IR_SHIFT)
    add(IR_UPDATE , DR_SELECT, IDLE)
    add(DR_SELECT , IR_SELECT, DR_CAPTURE)
    add(DR_CAPTURE, DR_EXIT1 , DR_SHIFT)
    add(DR_SHIFT  , DR_EXIT1 , DR_SHIFT)
    add(DR_EXIT1  , DR_UPDATE, DR_PAUSE)
    add(DR_PAUSE  , DR_EXIT2 , DR_PAUSE)
    add(DR_EXIT2  , DR_UPDATE, DR_SHIFT)
    add(DR_UPDATE , DR_SELECT, IDLE)
  }
```
Would fix it.

So, that would be good for you ?

that would only change the generated verilog by adding the :

      JtagState_RESET : begin
        _zz_tap_fsm_stateNext_16 = _zz_tap_fsm_stateNext;
      end

gregdavill, 2024-05-21:
Thanks for the fix on the Scala side. Yes, atleast from my editing of the verilog with exactly that line seems to fix the issue encountered by Yosys.

I'd be inclined to remove the default case if it's guaranteed that state/StateNext are 4 bits in size, since the default will never be reached as the case statements cover all possible states. But I'm not too familiar with SpinalHDL, so I'll defer that to you.

Dolu1990, 2024-05-21:
Fixed with https://github.com/SpinalHDL/SpinalHDL/commit/2c5e8266c106cb2f6a7fc7b6ac1b96f7615ce138

It keep the default case empty and add the reset case.
Thanks for the issue ^^

Closed 2024-05-21.

Thread 387 (2024-01-21):

Instructions to save/restore register to stack is taking 2 clock each

ztachip, 2024-01-21:
I wrote a simple task switching that save registers and restore registers
// Save registers
sw       s0,4(sp)
sw       s1,8(sp)
sw       s2,12(sp)
sw       s3,16(sp)
    :
    :
// Restore registers
    lw       s0,4(sp)
    lw       s1,8(sp)
    lw       s2,12(sp)
   :
   :

My stack fits entirely in data cache

But it seems it takes 2 clocks per each instruction above
I have enabled all bypass in the HarzardPlugin
Should the stack save/restore instructions above should take just 1 clock each.

Thanks

ztachip, 2024-01-21:
I am using AXI for bus.

package vexriscv.VexRiscvForSim

import spinal.core._
import spinal.lib._
import vexriscv.ip.{DataCacheConfig, InstructionCacheConfig}
import spinal.lib.bus.amba3.apb._
import spinal.lib.bus.amba4.axi._
import spinal.lib.bus.misc.SizeMapping
import spinal.lib.io.{InOutWrapper, TriStateArray}
import spinal.lib.misc.{InterruptCtrl, Prescaler, Timer}
import spinal.lib.soc.pinsec.{PinsecTimerCtrl, PinsecTimerCtrlExternal}
import vexriscv.plugin._
import vexriscv.{VexRiscv, VexRiscvConfig, plugin}
import spinal.lib.com.spi.ddr._
import spinal.lib.bus.simple._
import scala.collection.mutable.ArrayBuffer

case class RiscvConfig(
                       coreFrequency : HertzNumber,
                       cpuPlugins              : ArrayBuffer[Plugin[VexRiscv]]){
}

object RiscvConfig{
   def default : RiscvConfig = default(false)
   def default(bigEndian : Boolean = false) =  RiscvConfig(
   coreFrequency         = 166 MHz,
   cpuPlugins = ArrayBuffer(
      new IBusCachedPlugin(
          resetVector = 0x00004000l,
          prediction = STATIC,
          relaxedPcCalculation = true,
          config = InstructionCacheConfig(
            cacheSize = 4096*2,
            bytePerLine =32,
            wayCount = 2,
            addressWidth = 32,
            cpuDataWidth = 32,
            memDataWidth = 32,
            catchIllegalAccess = true,
            catchAccessFault = true,
            asyncTagMemory = false,
            twoCycleRam = true,
            twoCycleCache = true
          )
      ),
      new DBusCachedPlugin(
          config = new DataCacheConfig(
            cacheSize         = 4096*2,
            bytePerLine       = 32,
            wayCount          = 2,
            addressWidth      = 32,
            cpuDataWidth      = 32,
            memDataWidth      = 32,
            catchAccessError  = true,
            catchIllegal      = true,
            catchUnaligned    = true,
            withLrSc          = true,
            withAmo           = true
          ),
          memoryTranslatorPortConfig = null
      ),

      new CsrPlugin(CsrPluginConfig.smallest(mtvecInit = 0x80000020l)),
      new DecoderSimplePlugin(
        catchIllegalInstruction = true
      ),
      new StaticMemoryTranslatorPlugin(
        ioRange      = _(31 downto 31) === 0x1
      ),
      new RegFilePlugin(
        regFileReadyKind = plugin.ASYNC,
        zeroBoot = false
      ),
      new IntAluPlugin,
      new SrcPlugin(
        separatedAddSub = false,
        executeInsertion = true
      ),
      new FullBarrelShifterPlugin,
      new HazardSimplePlugin(
        bypassExecute           = true,
        bypassMemory            = true,
        bypassWriteBack         = true,
        bypassWriteBackBuffer   = true,
        pessimisticUseSrc       = false,
        pessimisticWriteRegFile = false,
        pessimisticAddressMatch = false
      ),
      new MulPlugin,
      new DivPlugin,
      new BranchPlugin(
        earlyBranch = true,
        catchAddressMisaligned = true
      ),
      new YamlPlugin("cpu0.yaml")
    )
  )

  def fast = {
    val config = default
    //Replace HazardSimplePlugin to get datapath bypass
    config.cpuPlugins(config.cpuPlugins.indexWhere(_.isInstanceOf[HazardSimplePlugin])) = new HazardSimplePlugin(
      bypassExecute = true,
      bypassMemory = true,
      bypassWriteBack = true,
      bypassWriteBackBuffer = true
    )
    config
  }
}

case class VexRiscvForSim(config : RiscvConfig) extends Component{
  import config._

  val io = new Bundle {
    //Clocks / reset
    val asyncReset = in Bool()
    val mainClk = in Bool()
    val iBus = master(Axi4ReadOnly(Axi4Config(addressWidth=32,dataWidth=32,idWidth=1).toFullConfig()))
    val dBus = master(Axi4(Axi4Config(addressWidth=32,dataWidth=32,idWidth=1).toFullConfig()))
  }

  val resetCtrlClockDomain = ClockDomain(
    clock = io.mainClk,
    config = ClockDomainConfig(
      resetKind = BOOT
    )
  )

  val resetCtrl = new ClockingArea(resetCtrlClockDomain) {
    val mainClkResetUnbuffered  = False

    //Implement an counter to keep the reset axiResetOrder high 64 cycles
    // Also this counter will automatically do a reset when the system boot.
    val systemClkResetCounter = Reg(UInt(6 bits)) init(0)
    when(systemClkResetCounter =/= U(systemClkResetCounter.range -> true)){
      systemClkResetCounter := systemClkResetCounter + 1
      mainClkResetUnbuffered := True
    }
    when(BufferCC(io.asyncReset)){
      systemClkResetCounter := 0
    }

    //Create all reset used later in the design
    val mainClkReset = RegNext(mainClkResetUnbuffered)
    val systemReset  = RegNext(mainClkResetUnbuffered)
  }

  val systemClockDomain = ClockDomain(
    clock = io.mainClk,
    reset = resetCtrl.systemReset,
    frequency = FixedFrequency(coreFrequency)
  )

  val system = new ClockingArea(systemClockDomain) {

    val bigEndianDBus = config.cpuPlugins.exists(_ match{ case plugin : DBusSimplePlugin => plugin.bigEndian case _ => false})

    //Instanciate the CPU
    val cpu = new VexRiscv(
      config = VexRiscvConfig(
        plugins = cpuPlugins
      )
    )

    //Checkout plugins used to instanciate the CPU to connect them to the SoC
    val timerInterrupt = False
    val externalInterrupt = False
    var iBus : Axi4ReadOnly = null
    var dBus : Axi4 = null
    for(plugin <- cpu.plugins) plugin match{
      case plugin : IBusCachedPlugin =>
        iBus = plugin.iBus.toAxi4ReadOnly().toFullConfig()
      case plugin : DBusCachedPlugin =>
        dBus = plugin.dBus.toAxi4Shared().toAxi4().toFullConfig()
      case plugin : CsrPlugin        => {
        plugin.externalInterrupt := externalInterrupt
        plugin.timerInterrupt := timerInterrupt
      }
      case _ =>
    }
    io.iBus <> iBus;
    io.dBus <> dBus;
  }
}

object VexRiscvForSim{
  def main(args: Array[String]) {
    SpinalVhdl(VexRiscvForSim(RiscvConfig.default.copy()))
  }
}

Dolu1990, 2024-01-22:
where you accessing the cached memory region ? or the uncached one ?
Else at that stage the best is to check the simulation to see what is happening.
In VexRiscv there is a few "lastStage" signals to help figuring out what is commiting.

ztachip, 2024-01-22:
Outside of VexRiscv, I instantiated some logic to split iBus/dBus between an internal RAM block (16K) and external memory (256M) based on memory address region.
During the test of doing continuously stack save/restore, I see VexRiscv flushing out the stack content but I see no read.
I just noticed that the total number clocks of the operation is twice of what it should be.
Do you have any internal signals I can tap to see if VexRiscv is stalled on some condition?
Thanks
Vuong

________________________________
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

ztachip, 2024-01-22:
To make sure all data access fit the DataCache, My stack is only 2K. And my DataCache is 8K/2way

Dolu1990, 2024-01-24:
>  I see VexRiscv flushing out the stack content but I see no read.

Its cache is write-through, so it is normal.
Maybe the SoC memory system can't follow that bandwidth ?

> Do you have any internal signals I can tap to see if VexRiscv is stalled on some condition?

Yes, on every stage, there is a xxx_arbitration_xxx which contains signals.

But i would say, first check if the memory buses are stuck some cycles.

ztachip, 2024-02-07:
There are no external memory cycles.
The program simply pushing and poping register values to/from stack that fit entirely in cache.

But can we expect code below to take just one clock per instruction?

sw s0,4(sp)
sw s1,8(sp)
sw s2,12(sp)
sw s3,16(sp)
:
:
// Restore registers
lw s0,4(sp)
lw s1,8(sp)
lw s2,12(sp)
:
:

Dolu1990, 2024-02-07:
> But can we expect code below to take just one clock per instruction?

Yes, it should as far as i know.

Can you share a wave file?

ztachip, 2024-02-08:
Sure, are there any VexRiscv internal signals you like me to show on wave file?
________________________________
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

Dolu1990, 2024-02-12:
All fo them ^^

ztachip, 2024-02-12:
I assume you want wavefile from Verilator?
My code has VHDL so Verilator does not work for it unfortunately, but I can try to create a test program with Verilog+Verilator
Does this work for you?
Thanks
________________________________
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

Dolu1990, 2024-02-12:
doesn't need to be a wave from verilator, either a VCD or a FST is fine.

Closed 2024-04-03.

Thread 391 (2024-02-06):

Data Stream in/out SoC <-> FPGA

lk-davidegironi, 2024-02-06:
Hello,

I'm building a softcore based on Briey.
I've the AxiCrossbar without Sdram and on the APB3Bridge 1 Timer, 1 UartCtrl, 1 Gpio.
On the APB3 I would like to add a custom Ctrl to transfer in and output data stream.
I've to transfer 32x24bit data in + 32x16bit data output, and do some simple (for now) math inside the SoC on that stream.

I've try setting a Vector of Bits and now I'm trying Axi4Stream, based on that code here: https://github.com/SpinalHDL/VexRiscv/pull/53
In both options (Vector and Axi4Stream), I've a couple of issue, before moving to issues, I would like to ask you which could be a good option.

As far as I understand using Vec means using more LUT cause all the signals have to be synthetized, but this way I can read and drive signals in a few clock. Indeed using the Axi Stream is a bit slower, but use less LUT, am I right?

Depending on your suggestion I'll ask questions, thanks!

Dolu1990, 2024-02-06:
Hi,

> As far as I understand using Vec means using more LUT cause all the signals have to be synthetized

Yes right, that's not the way to go.

>  Indeed using the Axi Stream is a bit slower, but use less LUT, am I right?

Yes, serializing things is a better tradeoff i think, then eventualy buffering things into a Mem (ram) for later reuse.

lk-davidegironi, 2024-02-06:
Thank you @Dolu1990 ,
So, going to the Streaming mode, I'm using code taken from here: https://github.com/SpinalHDL/VexRiscv/pull/53
I'm trying, without success to make it work with readStreamNonBlocking. I've to investigate further on the valid and read signal.
I'll keep you updated. Any further help is appreciated.

Apb3Axis is connected in the main SoC scala code, the Apb3Axis class looks like above

`package lk.lib

import spinal.core._
import spinal.lib._
import spinal.lib.bus.amba3.apb.{Apb3, Apb3Config, Apb3SlaveFactory}

case class Apb3Axis(apb3Config: Apb3Config) extends Component {
  val io = new Bundle {
    val apb = slave(Apb3(apb3Config))
    val input = slave(Stream(Bits(32 bits)))
    val output = master(Stream(Bits(32 bits)))
  }

  val ctrl = Apb3SlaveFactory(io.apb)

  // input stream is by readStreamNonBlocking, but is not working, indeed comment code by streamfifo is working
  ctrl.readStreamNonBlocking(io.input.queue(128), address = 0)
  //val ififo = StreamFifo(dataType = Bits(32 bits), depth = 128)
  //ififo.io.push << io.input
  //ctrl.read(ififo.io.pop.payload, address = 0);
  //val ififoPopReady = ctrl.drive(ififo.io.pop.ready, address = 4)
  //ctrl.read(ififo.io.pop.valid, address = 8);
  //when(ififo.io.pop.valid) { ififoPopReady := False }

  val wordCount = (1 + widthOf(io.input.payload) - 1) / 32 + 1
  val wordAddressInc = 32 / 8
  val addressHigh = 0 + (2 - 1) * wordAddressInc
  SpinalInfo("Wordcount: " + wordCount)
  SpinalInfo("addressHigh: " + addressHigh)

  // output stream is by streamfifo, but needs to be converted to createAndDriveFlow
  val ofifo = StreamFifo(dataType = Bits(32 bits), depth = 128)
  ofifo.io.pop >> io.output
  ctrl.drive(ofifo.io.push.payload, address = 12)
  val ofifoPushValid = ctrl.drive(ofifo.io.push.valid, address = 16)
  ctrl.read(ofifo.io.push.ready, address = 20)
  when(ofifo.io.push.ready) { ofifoPushValid := False }
  //val writeFlow = ctrl.createAndDriveFlow(Bits(32 bits), address = 0)
  //writeFlow.toStream.stage() >> ofifo.io.push

}
`

main C sample code is below
```

typedef struct
{
  volatile uint32_t IN_DATA;
  volatile uint32_t IN_READY;
  volatile uint32_t IN_VALID;
  volatile uint32_t OUT_DATA;
  volatile uint32_t OUT_VALID;
  volatile uint32_t OUT_READY;
} AXIS_Reg;
#define AXIS ((AXIS_Reg *)(0xF0060000))

// inside the main function
while (1)
	{
		while (AXIS->IN_VALID == 0)
		{
			asm volatile("");
		}
		AXIS->OUT_DATA = 3 + AXIS->IN_DATA;
		AXIS->OUT_VALID = 0xFFFF;
		while (AXIS->OUT_VALID != 0)
		{
			asm volatile("");
		}
		AXIS->IN_READY = 0xFFFF;
		while (AXIS->IN_READY != 0)
		{
			asm volatile("");
		}
	}

```

then the verilog top function syntetized
I'm looking the the verilog analizer at axis_input_payload and axis_output_payload;
they works (output is input +3 each ticks) if  input stream is implemented using streamfifo (the commented code of Apb3Axis), indeed does not work using readStreamNonBlocking

```

 //tick_1s_tick ticks every 1 second

  reg axis_input_valid;
  wire axis_input_ready;
  reg [31:0] axis_input_payload;
  wire axis_output_valid;
  reg axis_output_ready;
  wire [31:0] axis_output_payload;

    always @(posedge clk)
    begin
        if(tick_1s_tick)
        begin
            axis_input_valid <= 1'b1;
            axis_input_payload <= samplePayload;
        end
        else
        begin
            axis_input_valid <= 1'b0;
        end

        if(axis_output_valid)
        begin
            axis_output_ready <= 1'b1;
        end
        else
        begin
            axis_output_ready <= 1'b0;
        end

    end

    Soc Soc_inst(
        // all the other signals
        .io_axis_input_valid(axis_input_valid),
        .io_axis_input_ready(axis_input_ready),
        .io_axis_input_payload(axis_input_payload),
        .io_axis_output_valid(axis_output_valid),
        .io_axis_output_ready(axis_output_ready),
        .io_axis_output_payload(axis_output_payload)
    );
```

lk-davidegironi, 2024-02-16:
I was able to make it works, but I've performance problem.

So, first. How i make this work using readStreamNonBlocking and createAndDriveFlow, using a 31 bit payload.

Apb3Axis looks now like below:
```
case class Apb3Axis(apb3Config: Apb3Config) extends Component {
  val io = new Bundle {
    val apb = slave(Apb3(apb3Config))
    val input = slave(Stream(Bits(31 bits)))
    val output = master(Stream(Bits(31 bits)))
  }

  val busCtrl = Apb3SlaveFactory(io.apb)

  val ioinputqueue = io.input.queueLowLatency(128)
  busCtrl.readStreamNonBlocking(
    ioinputqueue,
    address = 0,
    validBitOffset = 31,
    payloadBitOffset = 0
  )

  val ofifo = StreamFifoLowLatency(dataType = Bits(31 bits), depth = 128)
  ofifo.io.pop >> io.output
  val writeFlow = busCtrl.createAndDriveFlow(Bits(31 bits), address = 4)
  writeFlow.toStream.stage() >> ofifo.io.push
}
```

software side (almost like below) - notice I'm using a Gpio output to check the timing on the the analyzer
```
typedef struct
{
  volatile uint32_t IN_PAYLOAD;
  volatile uint32_t OUT_PAYLOAD;
} AXIS_Reg;
#define AXIS ((AXIS_Reg *)(0xF0060000))

#define IN_PAYLOAD_VALID_MASK 0x80000000
#define IN_PAYLOAD_VALID_SHIFT 31
#define IN_PAYLOAD_DATA_MASK 0x7FFFFFFF
#define IN_PAYLOAD_DATA_SHIFT 0

//
// in main function, main while loop
//
    while (1)
	{

	    uint32_t payload = AXIS->IN_PAYLOAD;
    	    if ((payload & IN_PAYLOAD_VALID_MASK) >> IN_PAYLOAD_VALID_SHIFT == 1) {
		  uint32_t data = (payload & IN_PAYLOAD_DATA_MASK) >> IN_PAYLOAD_DATA_SHIFT;
		  if (data == 10) {
			  gpioA_setOutputBit(0);
			  gpioA_clearOutputBit(0);
		  }
		  // AXIS->OUT_PAYLOAD = data;
	    }
	}
```

Verilog side
```
reg axis_input_valid;
  wire axis_input_ready;
  reg [30:0] axis_input_payload;
  wire axis_output_valid;
  reg axis_output_ready;
  wire [30:0] axis_output_payload;
  reg [30:0] axis_output_payload_reg;

  reg [30:0] signaldata_reg;
  reg [30:0] signalretdata_reg;
  initial  signaldata_reg = 0;

    always @(posedge clk)
    begin
       // enable signal send every 1 second (it will be at 10kHz in the future)
        if(tick_1s_tick)
        begin
            signalnum_reg <= 1;
        end

       // check sending 32 data payload
        if(signaldata_reg >= 1 && signaldata_reg <= 32 && axis_input_ready)
        begin
            signaldata_reg <= signaldata_reg + 1;
            axis_input_valid <= 1'b1;
            axis_input_payload <= signaldata_reg;
        end
        else
        begin
            axis_input_valid <= 1'b0;
        end

        // receiving output and moving to data
        axis_output_ready <= 1'b1;
        if(axis_output_valid)
        begin
            signalretdata_reg <= axis_output_payload;
        end
    end

   Soc Soc_inst(
        // all the other signals
        .io_axis_input_valid(axis_input_valid),
        .io_axis_input_ready(axis_input_ready),
        .io_axis_input_payload(axis_input_payload),
        .io_axis_output_valid(axis_output_valid),
        .io_axis_output_ready(axis_output_ready),
        .io_axis_output_payload(axis_output_payload)
    );
```

Code above works with StreamFifo and .queue. I've find no difference using that or the LowLatency one.
I'm running that code on a Briey based Soc, running @ 72Mhz main clk on a Tang Primer 20k.

In the future I'm going to use a payload of 31 bit, then I'll put a command in the first 7 bit, and use the other 24 for data.

My problem is about performance. I've try StreamFifo and .queue instead of queueLowLatency and  StreamFifoLowLatency but it makes not difference.
I've used the gpio output to measure how much time it takes for a signal to be read (or sent). it seems reading a signal takes many cycles. If you look at the 1024 cycles capture below you will notice the gpio I/O happened almost at cycle 530, for data number 10. It means if I have to send 32 data payload it will takes 1700 cycle almost. That is some kind of too much for my requirements. I've to send data hopefully at 10kHz. it means I've 7200 cycles to to make math (simple math) each loop in my software.

StreamFifo and .queue instead of queueLowLatency and  StreamFifoLowLatency makes not difference. Running the SoC at 72Mhz or 12Mhz makes not difference. FPGA/Briey and busses (AXI+APB3) are all running within the same clock domain).

Do I miss something?

Note for image (here I'm using a payload that contains a command in the first 7 bit, and use the other 24 for data).

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

Writing data back to output  'AXIS->OUT_PAYLOAD = xxx ' makes no difference in timing, that means SoC to FPGA is fast. It's just the input a little too slow for me.

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

Thanks for help.

Dolu1990, 2024-02-19:
Hi, looking at your simulation, it show things from time 0 right ?
Thing is, the CPU will need a bit of time to reach the while loop.

lk-davidegironi, 2024-02-19:
Thank you @Dolu1990
So, analyzer it's triggered at tick_1s_tick edge. And it's showing from time 0. If you look at signnum_reg you will find the 32 signals loaded to the StreamFifo in 32 cycles (find zoomed below).
I'm testing the InterruptCtrl but this will not make difference now, cause in the while loop I'm always reading.

Zoomed in the other image the a load (uint32_t payload = AXIS->IN_PAYLOAD;) + unload (AXIS->OUT_PAYLOAD = data;) timing.
It's almost 90 cycles.

Maybe something involving DMA can help?
Sorry for my dumbness but I've just entered the FPGA SoC world.

I know I'm asking a lot from this core. My plan is to make this works on VexRiscV (even at slower speed), cause I like this project (portable and customizable), then when I'll be ready maybe moving to an hardware core (xilinx ARM) changing the busses of course.

Verilog below contains the actual payload content (signal number + integer), and will clarify it to you:
```
always @(posedge clk)
    begin
        if(tick_1s_tick)
        begin
            signalnum_reg <= 1;
        end
        if(signalnum_reg >= 1 && signalnum_reg <= 32)
        begin

            if(axis_input_ready)
            begin
                signalnum_reg <= signalnum_reg + 1;
                signaldata_reg <= signaldata_reg + 1;
            end
    
            axis_input_valid <= 1'b1;
            axis_input_payload <= {signalnum_reg, signaldata_reg};
        end
        else
        begin
            axis_input_valid <= 1'b0;
        end

        axis_output_ready <= 1'b1;
        if(axis_output_valid)
        begin
            signalretnum_reg <= axis_output_payload[30-:7];
            signalretdata_reg <= axis_output_payload[23:0];
        end

    end
```

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

Thread 393 (2024-03-01):

EU Funding

PythonLinks, 2024-03-01:
The EU  has €270 million in funds for Risc-V projects.

https://www.hpcwire.com/2022/12/16/europe-to-dish-out-e270-million-to-build-risc-v-hardware-and-software/

We should figure out how to get some of that money.  Presumably people here are already working on that.  How can I help?

Two obvious application areas are building a cpu with additional instructions, and chiplets, connecting up large numbers of risc-v cores in different ways.

Of course where the real money is, is some cross between AI, and Risc-V, although personally I am not a fan of the AI stuff. Most inefficient. Energy consumption reportedly doubles every 4 months.  Very bad for climate change.

Dolu1990, 2024-03-01:
Hi,

I wasn't aware of it XD
So, i'm working on https://github.com/SpinalHDL/VexiiRiscv which aim to be a replacement for VexRiscv, would be nice to have some help on that ^^

My guess so far, is that 270M mean big compagny / big industry project / Big achademia. Probably not aiming at individual people doing open source :/

Or is it ?

PythonLinks, 2024-03-02:
Well let us find out if the EU is open to funding us or not. In general open source hardware, specifically Risc-v is a hot item with the EU government.   In particular SpinalHDL is great software, but  with (forgive me) terrible marketing.  The gorgeous Risc-V documentation lacks an introductory sections called "Why use VexRiscV".   It also lacks a section comparing it to the alternatives.   I suspect that even the section mentioning users is a bit weak.  I think it is missing from the index.

It is hard to express the advantages of this approach. The mass market just wants a Verilog solution.  We need a strong elevator pitch.   Reading the VexRiscV intro and the SpinalHDL intro, I am not sold.  The elevator pitch is weak.  I am here because of my software background, because I understand how much better this approach is, not because you did a good job selling me on this approach.

In particular we need a good description of why this is better than the Python based approaches.  Amaranth for example.  They even have a very mature TCP/IP stack.

So let me try to pitch SpinalHDL.

Open source hardware, written in Verilog, makes it possible to release a commercial Risc-v chip, VexRiscV makes it easy.   For all of those companies who want to release a Risc-V chip with custom instructions, SpinalHDL is the least expensive and fastest starting point.    It is not just because it leverages the power of Scala in the verification process.   It is not just because SpinalHDL is the only open source tool supporting assertions.  It is because SpinalHDL supports software abstractions.

Verilog is great at hardware abstraction, building a hierarchy of circuits out of smaller components, but it completely lacks software abstraction.  You want to connect to a signal in a different part of the hierarchy, you have to  manually run wires up and down the hierarchy.  In SpinalHDL, you just name the signal you want to connect with.

I will leave it to others, more experienced than me, in writing some more examples.    There are a bunch in the documentation.

Anyhow, I believe that the exercise of finding out what the EU is funding, what the companies are seeking, what the VC's want, what the Silicon Velley vc.s want, is critical to our growth.

What am I doing here?  I am the guy working on stack machines for my master's thesis. Think J1Sc.   Very fast context switches. 2nd semester is over, I got perfect scores in Verilog and veification, now my focus is on the thesis.  I have reached the limits of what verilog can do.  In verilog simulation, I made a change to the Forth code, and suddenly everything broke.  There is no error message.  Trial and error is way too slow an approach to debugging.  I need assertions. lots of assertions to tell me what went wrong.   When I do software debugging, really I am acting as a human assertion checker, with the J1 family, there are so many things going on at the same time, that assertion checking needs to be automated.  SpinalHDL gives me that.  I think it is the only open source tool that does it.    So SpinalHDL is what I need.  Of course the money is in the Risc-V world.  I like money.  Basically the tools are all the same.  I can do both.  In any case, it is important to understand the Risc-V market in order to understand the market niche for stack machines.

Dolu1990, 2024-03-04:
Hi @PythonLinks

> but with (forgive me) terrible marketing

I had quite some energy for this 4-5 years ago.

> It is hard to express the advantages of this approach.

That's very difficult, because most hardware engineer do not have any software background past low level C.
So, you can tell them what every story you want, they won't "connect".
The only way i found so far is to have a very sexy project to introduce people the idea that it work well (VexRiscv)

> Open source hardware, written in Verilog, makes it possible to release a commercial Risc-v chip, VexRiscV makes it easy. For all of those companies who want to release a Risc-V chip with custom instructions, SpinalHDL is the least expensive and fastest starting point.

From a compagny perspective, the hard point is to find poeple with the technical skills, So fondamentaly, SpinalHDL adoption is hard for large scale entities, realy have to focus on small groups. And so because of that ASIC focus isn't great (large scale stuff), have to focus on FPGA people, which are much smalller scale in general => a few motivated people can pickup SpinalHDL

I don't know, overall the situation is hard.
So far, my plan is to have VexiiRiscv (Vex2Risc5) as a "sexy" SpinalHDL project, then maybe work toward SoC stuff.
VexiiRiscv seems promessing.

In other words, "advertising" from the results.

Thread 403 (2024-04-16):

About the Csr registers in Vexriscv

ic-hjx, 2024-04-16:
Hello! I've encountered some issues while trying to read the `mcycle` register of VexRiscv. I attempted to add the following function to my C program:

```c
uint64_t read_cycle(void) {
    uint32_t low, high;
    __asm__ ("csrr %0, %1" : "=r" (low), "=r" (high) : "a" (0xc00)); // CSRR instruction to read the cycle register
    return ((uint64_t)high << 32) | low;
}
```
However, the program compilation returned the following error:
```
src/main.c: In function 'read_cycle':
src/main.c:145:5: error: impossible constraint in 'asm'
  145 |     __asm__ ("csrr %0, %1" : "=r" (low), "=r" (high) : "a" (0xc00));
      |     ^~~~~~~
```

I'm not sure if there's a syntax issue with my code, and I'm also uncertain about the register number for `mcycle` in VexRiscv. The information I obtained from the source code seems to indicate 0xc00. Additionally, I'm using the briey-soc architecture, and I noticed that the read access permission for `mcycleAccess` was not enabled when using `CsrPlugin` in briey. Therefore, I modified one setting as follows:
```
new CsrPlugin(
    config = CsrPluginConfig(
        catchIllegalAccess = false,
        mvendorid      = null,
        marchid        = null,
        mimpid         = null,
        mhartid        = null,
        misaExtensionsInit = 66,
        misaAccess     = CsrAccess.NONE,
        mtvecAccess    = CsrAccess.NONE,
        mtvecInit      = 0x80000020l,
        mepcAccess     = CsrAccess.READ_WRITE,
        mscratchGen    = false,
        mcauseAccess   = CsrAccess.READ_ONLY,
        mbadaddrAccess = CsrAccess.READ_ONLY,
        mcycleAccess   = CsrAccess.READ_ONLY, // origin: CsrAccess.NONE
        minstretAccess = CsrAccess.NONE,
        ecallGen       = false,
        wfiGenAsWait         = false,
        ucycleAccess   = CsrAccess.NONE,
        uinstretAccess = CsrAccess.NONE
    )
)
```
Additionally, I've noticed that the mtime register seems to be unimplemented in VexRiscv?
I am looking forward to and greatly appreciate your response！

Dolu1990, 2024-04-16:
Hi, your issue is purly software for now. This isn't realted to VexRiscv
Personnaly i'm using that to read CSR :
https://github.com/SpinalHDL/SaxonSoc/blob/dev-0.3/software/standalone/driver/riscv.h#L89

ic-hjx, 2024-04-17:
I am sorry for that I have open the issue in a wrong place. My questions about the Csr registers in VexRISCV mainly pertain to the identification numbers corresponding to different registers, in the program description that I can found in [riscv.h](https://github.com/SpinalHDL/SaxonSoc/blob/dev-0.3/software/standalone/driver/riscv.h#L89) :
```
#define RDCYCLE 0xC00 //Read-only cycle Cycle counter for RDCYCLE instruction.
#define RDTIME 0xC01 //Read-only time Timer for RDTIME instruction.
#define RDINSTRET 0xC02 //Read-only instret Instructions-retired counter for RDINSTRET instruction.
#define RDCYCLEH 0xC80 //Read-only cycleh Upper 32 bits of cycle, RV32I only.
#define RDTIMEH 0xC81 //Read-only timeh Upper 32 bits of time, RV32I only.
#define RDINSTRETH 0xC82 //Read-only instreth Upper 32 bits of instret, RV32I only.
```
Now I understand that VexRISCV supports the standard Csr register configuration, which has resolved my issue. Thank you very much!

Closed 2024-04-16.

Thread 412 (2024-06-14):

Wrong speculative execution when conditional branch argument is in TCM address range

vianney, 2024-06-14:
Hello,

Many thanks for the wonderful projects (both SpinalHDL and VexRiscv). I think I have found a nasty bug in the implementation of Tightly Coupled Memory.

## Summary

When a conditional branch instruction is directly followed by a store instruction writing to TCM, and the operand of the branch is within the TCM address range, then the TCM will be unconditionally written to. Other types of instructions following such branches might also be affected (not investigated).

## Minimal Working Example

#### tcmbug.scala

```scala
import spinal.core._
import vexriscv._
import vexriscv.ip._
import vexriscv.plugin._

class TCMBug extends Component {
  val cpu = new VexRiscv(VexRiscvConfig(Seq(
    new IBusCachedPlugin(
      resetVector = 0x10000000l,
      config = InstructionCacheConfig(
        cacheSize = 4096,
        bytePerLine = 8,
        wayCount = 1,
        addressWidth = 32,
        cpuDataWidth = 32,
        memDataWidth = 32,
        catchIllegalAccess = true,
        catchAccessFault = true,
        asyncTagMemory = false,
      ),
    ),
    new DBusCachedPlugin(
      config = DataCacheConfig(
        cacheSize = 4096,
        bytePerLine = 8,
        wayCount = 1,
        addressWidth = 32,
        cpuDataWidth = 32,
        memDataWidth = 32,
        catchAccessError = true,
        catchIllegal = true,
        catchUnaligned = true,
      ),
    ),
    new IBusDBusCachedTightlyCoupledRam((0x10000000l, 1 KiB),
                                        ramAsBlackbox = false,
                                        hexInit = "tcmbug.hex",
                                        ramOffset = 0x10000000l),
    new StaticMemoryTranslatorPlugin(_ => False),
    new DecoderSimplePlugin,
    new RegFilePlugin(plugin.ASYNC),
    new SrcPlugin,
    new IntAluPlugin,
    new HazardSimplePlugin(),
    new BranchPlugin(earlyBranch = false),
    new CsrPlugin(CsrPluginConfig.smallest(0)),
  )))

  for (plugin <- cpu.plugins) plugin match {
    case plugin : IBusCachedPlugin =>
      plugin.iBus.cmd.ready := True
      plugin.iBus.rsp.valid := True
      plugin.iBus.rsp.data := 0
      plugin.iBus.rsp.error := True
    case plugin : DBusCachedPlugin =>
      plugin.dBus.cmd.ready := True
      plugin.dBus.rsp.valid := True
      plugin.dBus.rsp.data := 0
      plugin.dBus.rsp.error := True
    case plugin : CsrPlugin =>
      plugin.timerInterrupt := False
      plugin.externalInterrupt := False
    case _ =>
  }
}

object TCMBug extends App {
  import spinal.core.sim._
  SimConfig.withFstWave.compile(new TCMBug).doSim{ dut =>
    dut.clockDomain.forkStimulus(10)
    sleep(10000)
  }
}
```

#### tcmbug.hex

```
:020000041000EA
:100000009300A00237010010639400002320110820
:10001000B700001063940000232011086F00000057
:0400000510000000E7
:00000001FF
```

Compiled from the following two files with:
```
riscv32-none-elf-gcc -march=rv32i -mabi=ilp32 -specs=nosys.specs -nostartfiles -T tcmbug.ld tcmbug.S -o tcmbug.elf
riscv32-none-elf-objcopy -O ihex tcmbug.elf tcmbug.hex
```

#### tcmbug.S

```gas
    .section .text
    li x1, 42           # 10000000
    li x2, 0x10000000   # 10000004
    bnez x1, 1f         # 10000008 - always branching
    sw x1, 128(x2)      # 1000000c - not executed, ok
1:
    li x1, 0x10000000   # 10000010
    bnez x1, 2f         # 10000014 - always branching, but SRC_ADD is in TCM
    sw x1, 128(x2)      # 10000018 - should not be executed !!!
2:
    j 2b                # 1000001c
```

#### tcmbug.ld

```
OUTPUT_ARCH("riscv")
MEMORY { TCM : ORIGIN = 0x10000000, LENGTH = 1024 }
SECTIONS {
    .text : { *(.text) } >TCM
}
```

## Simulation Result

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

[Full waveform](https://github.com/user-attachments/files/15841499/tcmbug.zip)

As you can see above, the first store (instruction 1000000c) is properly halted and not executed. The second store (instruction 10000018) however gets written in the TCM, even though the instruction should also be skipped.

From what I understand reading through the code, the following happens:
1. SrcPlugin.scala, line 77: `SRC_ADD` is set to the operand of the branch instruction (x1 in our case) or the destination address of a store.
2. DBusCachedPlugin.scala, line 439: `MEMORY_TIGHTLY` is set in the execute stage whenever `SRC_ADD` is in the range of the TCM, regardless of the actual instruction being executed.
3. DBusCachedPlugin.scala, line 478: `HAS_SIDE_EFFECT` is overridden to low in the memory stage whenever `MEMORY_TIGHTLY` is set. **Why is this done regardless of the instruction being executed?**
4. DBusCachedPlugin.scala, line 442: Because `HAS_SIDE_EFFECT` is low in the memory stage (processing the branch), the execute stage (processing the store) is not halted.

Dolu1990, 2024-06-17:
Hi ^^

Thanks for the issue.

It is now fixed with the commit above.

Closed 2024-06-17.

Thread 418 (2024-07-30):

new custom instruction in vexriscv

Chaitanya-kumar-Y, 2024-07-30:
I simulated the simd custom instruction in vexriscv. After that i try make the changes in the computations as given to see what changes i need to do in order to create a new custom instruction.But while simulating/testing with the same test file given in src/test/cpp/custom/simd_add, it is giving a error as attached .
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

`  override def build(pipeline: VexRiscv): Unit = {
    import pipeline._
    import pipeline.config._

    //Add a new scope on the execute stage (used to give a name to signals)
    execute plug new Area {
      //Define some signals used internally by the plugin
      val rs1 = execute.input(RS1).asUInt
      //32 bits UInt value of the regfile[RS1]
      val rs2 = execute.input(RS2).asUInt
      val rd = UInt(32 bits)

      //Do some computations

      rd(31 downto 0):= rs1(31 downto 0) + rs2(31 downto 0)
     //Instead of adding 8bits, i added all 32bits in single time just to see how the execution flow will go.
      //When the instruction is a SIMD_ADD, write the result into the register file data path.
      when(execute.input(IS_MAC_ADD)) {
        execute.output(REGFILE_WRITE_DATA) := rd.asBits
      }
    }
  }`

Dolu1990, 2024-07-31:
Hi,
You would need to update https://github.com/SpinalHDL/VexRiscv/blob/master/src/test/cpp/custom/simd_add/src/crt.S acordingly to the new instruction behaviour and compile it.

Chaitanya-kumar-Y, 2024-08-01:
Thanks for the help, it works. Now i want to create a non standard custom instruction format                    
                       | funct7  | rs3 | rs2 | rs1 | funct3 |  rd   | opcode |. So i would like to know which changes are should be made in decode and anywhere

Dolu1990, 2024-08-03:
Vex only support rs3 for the FPU.
If you dig in the other github issue/pr, i think there was one which was adding support for RS3 in the integer register file.

Else you could try VexiiRiscv, which would natively support RS3.

Chaitanya-kumar-Y, 2024-08-04:
Hi
I checked that github issue, so i made some changes in RegFilePlugin.scala and HazardSimplePlugin.scala like adding a RD register. Below is the code changes in RegFilePlugin file

`override def setup(pipeline: VexRiscv): Unit = {
    import pipeline.config._
    val decoderService = pipeline.service(classOf[DecoderService])
    decoderService.addDefault(RS1_USE,False)
    decoderService.addDefault(RS2_USE,False)
    decoderService.addDefault(RD_USE,False)

    decoderService.addDefault(REGFILE_WRITE_VALID,False)
  }`

`
 val regFileReadAddress1 = U(shadowPrefix(srcInstruction(clipRange(Riscv.rs1Range))))
      val regFileReadAddress2 = U(shadowPrefix(srcInstruction(clipRange(Riscv.rs2Range))))
 	 val regFileReadAddress3 = U(shadowPrefix(srcInstruction(clipRange(Riscv.rdRange))))

      val (rs1Data,rs2Data,rdData) = regFileReadyKind match{
        case `ASYNC` => (global.regFile.readAsync(regFileReadAddress1),global.regFile.readAsync(regFileReadAddress2),global.regFile.readAsync(regFileReadAddress3))
        case `SYNC` =>
          val enable = if(!syncUpdateOnStall) !readStage.arbitration.isStuck else null
          (global.regFile.readSync(regFileReadAddress1, enable),global.regFile.readSync(regFileReadAddress2, enable),global.regFile.readSync(regFileReadAddress3, enable))
      }

      insert(RS1) := rs1Data
      insert(RS2) := rs2Data
      insert(RD) := rdData
    }

But when i try to compile this it gives error as
`
not found: value RD_USE
[error]     decoderService.addDefault(RD_USE,False)

 not found: value RD
[error]       insert(RD) := rdData
`
So how to resolve this error

Dolu1990, 2024-08-05:
Where did you got RD_USE and RD from ?
shouldn't it be RS3 ?

Chaitanya-kumar-Y, 2024-08-05:
No, i am trying to implement a mac custom instruction

`rd(31 downto 0) := rs1(31 downto 0) + rs2(31 downto 0) + rd(31 downto 0)`

Dolu1990, 2024-08-05:
Did you defined RD and RD_USE somewere ?
I mean, the error you have come from your code when scala compiles it, not SpinalHDL / VexRiscv one.

Chaitanya-kumar-Y, 2024-08-05:
I only defined RD and RD_USE in RegFilePlugin.scala like below

`decoderService.addDefault(RD_USE,False)`

  `insert(RD) := rdData`

Used them in Hazardsimpleplugin and custominstruction files.  Should i define them somewhere ?

Dolu1990, 2024-08-05:
those aren't definition, those are usages

Check VexRiscv.scala, you will need to define them there

xavier-design, 2024-08-05:
Thanks alot. i defined them in VexRiscv, now it is working and i tested with the updated crt.S.

Dolu1990, 2024-08-05:
Cool ^^

Closed 2024-08-05.

Thread 421 (2024-08-17):

GenFullWithOfficialRiscvDebug failed

Logiase, 2024-08-17:
demo `GenFullWithOfficialRiscvDebug` can not run.

```text
[info] running (fork) "vexriscv.demo.GenFullWithOfficialRiscvDebug"
[info] [Runtime] SpinalHDL v1.10.2a    git head : a348a60b7e8b6a455c72e1536ec3d74a2ea16935
[info] [Runtime] JVM max memory : 16168.0MiB
[info] [Runtime] Current date : 2024.08.17 14:44:57
[info] [Progress] at 0.000 : Elaborate components
[info] vexriscv.plugin.CsrPlugin$$anonfun$47$$anon$2.<init>(CsrPlugin.scala:719)
[info] vexriscv.plugin.CsrPlugin$$anonfun$47.apply(CsrPlugin.scala:702)
[info] vexriscv.plugin.CsrPlugin$$anonfun$47.apply(CsrPlugin.scala:702)
[info] spinal.core.internals.BooleanPimped.generate(Misc.scala:285)
[info] vexriscv.plugin.CsrPlugin.build(CsrPlugin.scala:702)
[info] vexriscv.plugin.CsrPlugin.build(CsrPlugin.scala:445)
[info] vexriscv.Pipeline$$anonfun$build$4.apply(Pipeline.scala:55)
[info] vexriscv.Pipeline$$anonfun$build$4.apply(Pipeline.scala:55)
[info] scala.collection.mutable.ResizableArray$class.foreach(ResizableArray.scala:59)
[info] scala.collection.mutable.ArrayBuffer.foreach(ArrayBuffer.scala:48)
[info] vexriscv.Pipeline$class.build(Pipeline.scala:55)
[info] vexriscv.VexRiscv.build(VexRiscv.scala:131)
[info] vexriscv.Pipeline$$anonfun$1.apply$mcV$sp(Pipeline.scala:161)
[info] spinal.core.Component$$anonfun$prePop$1.apply(Component.scala:187)
[info] spinal.core.Component$$anonfun$prePop$1.apply(Component.scala:185)
[info] scala.collection.mutable.ResizableArray$class.foreach(ResizableArray.scala:59)
[info] scala.collection.mutable.ArrayBuffer.foreach(ArrayBuffer.scala:48)
[info] spinal.core.Component.prePop(Component.scala:185)
[info] spinal.core.Component.postInitCallback(Component.scala:194)
[info] vexriscv.demo.GenFullWithOfficialRiscvDebug$.cpu(GenFullWithOfficialRiscvDebug.scala:125)
[info] vexriscv.demo.GenFullWithOfficialRiscvDebug$$anonfun$3.apply(GenFullWithOfficialRiscvDebug.scala:127)
[info] vexriscv.demo.GenFullWithOfficialRiscvDebug$$anonfun$3.apply(GenFullWithOfficialRiscvDebug.scala:127)
[info] spinal.core.internals.PhaseCreateComponent$$anonfun$impl$67.apply(Phase.scala:2561)
[info] spinal.core.fiber.Engine$$anonfun$create$1.apply$mcV$sp(AsyncCtrl.scala:173)
[info] spinal.core.fiber.AsyncThread$$anonfun$1.apply$mcV$sp(AsyncThread.scala:60)
[info] spinal.core.fiber.EngineContext$$anonfun$newJvmThread$1.apply$mcV$sp(AsyncCtrl.scala:39)
[info] spinal.sim.JvmThread.run(SimManager.scala:51)
[info] **********************************************************************************************
[info] [Warning] Elaboration failed (0 error).
[info]           Spinal will restart with scala trace to help you to find the problem.
[info] **********************************************************************************************
[info] [Progress] at 1.211 : Elaborate components
[error] Exception in thread "main" java.lang.NoSuchMethodError: 'spinal.core.Data spinal.lib.BufferCC$.apply(spinal.core.Data, scala.Function0, scala.Option, boolean)'
[error]         at vexriscv.plugin.CsrPlugin$$anonfun$47$$anon$2.<init>(CsrPlugin.scala:719)
[error]         at vexriscv.plugin.CsrPlugin$$anonfun$47.apply(CsrPlugin.scala:702)
[error]         at vexriscv.plugin.CsrPlugin$$anonfun$47.apply(CsrPlugin.scala:702)
[error]         at spinal.core.internals.BooleanPimped.generate(Misc.scala:285)
[error]         at vexriscv.plugin.CsrPlugin.build(CsrPlugin.scala:702)
[error]         at vexriscv.plugin.CsrPlugin.build(CsrPlugin.scala:445)
[error]         at vexriscv.Pipeline$$anonfun$build$4.apply(Pipeline.scala:55)
[error]         at vexriscv.Pipeline$$anonfun$build$4.apply(Pipeline.scala:55)
[error]         at scala.collection.mutable.ResizableArray$class.foreach(ResizableArray.scala:59)
[error]         at scala.collection.mutable.ArrayBuffer.foreach(ArrayBuffer.scala:48)
[error]         at vexriscv.Pipeline$class.build(Pipeline.scala:55)
[error]         at vexriscv.VexRiscv.build(VexRiscv.scala:131)
[error]         at vexriscv.Pipeline$$anonfun$1.apply$mcV$sp(Pipeline.scala:161)
[error]         at spinal.core.Component$$anonfun$prePop$1.apply(Component.scala:187)
[error]         at spinal.core.Component$$anonfun$prePop$1.apply(Component.scala:185)
[error]         at scala.collection.mutable.ResizableArray$class.foreach(ResizableArray.scala:59)
[error]         at scala.collection.mutable.ArrayBuffer.foreach(ArrayBuffer.scala:48)
[error]         at spinal.core.Component.prePop(Component.scala:185)
[error]         at spinal.core.Component.postInitCallback(Component.scala:194)
[error]         at vexriscv.demo.GenFullWithOfficialRiscvDebug$.cpu(GenFullWithOfficialRiscvDebug.scala:125)
[error]         at vexriscv.demo.GenFullWithOfficialRiscvDebug$$anonfun$3.apply(GenFullWithOfficialRiscvDebug.scala:127)
[error]         at vexriscv.demo.GenFullWithOfficialRiscvDebug$$anonfun$3.apply(GenFullWithOfficialRiscvDebug.scala:127)
[error]         at spinal.core.internals.PhaseCreateComponent$$anonfun$impl$67.apply(Phase.scala:2561)
[error]         at spinal.core.fiber.Engine$$anonfun$create$1.apply$mcV$sp(AsyncCtrl.scala:173)
[error]         at spinal.core.fiber.AsyncThread$$anonfun$1.apply$mcV$sp(AsyncThread.scala:60)
[error]         at spinal.core.fiber.EngineContext$$anonfun$newJvmThread$1.apply$mcV$sp(AsyncCtrl.scala:39)
[error]         at spinal.sim.JvmThread.run(SimManager.scala:51)
[error] Nonzero exit code returned from runner: 1
[error] (Compile / runMain) Nonzero exit code returned from runner: 1
```

Logiase, 2024-08-17:
Sorry, change spinalhdl version to 1.10.1 fix this.

Closed 2024-08-17.

Thread 430 (2024-09-20):

compiling CFU demo configurations results in : java.lang.Exception: Missing inserts : LEGAL_INSTRUCTION"

jahagirdar, 2024-09-20:
Getting "Exception in thread "main" java.lang.Exception: Missing inserts : LEGAL_INSTRUCTION" for demo builds.

I am trying to build a core with CFU interface, I tried
`sbt "runMain vexriscv.demo.GenSmallAndProductiveCfu"` and `sbt "runMain vexriscv.demo.MuraxCfu"` Both resulted in the Missing inserts exception above. Am I missing something?
I am on the latest master commit (fd2d7842981b34af51d4a62dc984acd67c07bd31)

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
Dolu1990, 2024-09-20:
Right, should be fixed now, the CFU plugin needed something which wasn't enabled by default in the decoder plugin

Closed 2024-09-20.

Thread 440 (2025-01-17):

Running Regression Test using post_synthesis verilog file

nerdylye, 2025-01-17:
Hii,

May I know if the regression test can be performed on the post synthesis VexRiscv file? If can, how do I do it because I'm facing a lot of random errors haha...

Thanks!

Dolu1990, 2025-01-17:
Hi,

Hmm that was never done as far as i know.
There is now flow in place for it.

What kind of errors ? and on what synthesis tool ?

nerdylye, 2025-01-20:
Hii @Dolu1990,

I see, may I know how to use the flow?

The command that I'm running is `make clean run REDO=10 IBUS=SIMPLE DBUS=SIMPLE CSR=no MMU=no DEBUG_PLUGIN=no MUL=no DIV=no COREMARK=yes VEXRISCV_FILE=../../../../temp/VexRiscv_post_synthesis.v` in this directory `VexRiscv/src/test/cpp/regression`.

I did include the primitives file in the Makefile code: `verilator -cc --trace ${VEXRISCV_FILE} ${PRIMITIVES} --top-module VexRiscv -O3 -LDFLAGS -pthread ${ADDCFLAGS} --gdbbt ${VERILATOR_ARGS} --Wno-IMPLICIT --Wno-UNOPTFLAT --Wno-WIDTH -Wno-fatal --noassert --x-assign unique --x-initial unique --exe main.cpp`

The error is this:

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

nerdylye, 2025-01-22:
Hii @Dolu1990, thanks for the swift reply :D!

I've tried using `VexRiscv.v` for the post synthesis verilog file, but its still giving the same error.

> Hmm that was never done as far as i know.
There is now flow in place for it.

You mentioned above that there is now a flow for running post synthesis tests on VexRiscv, could you share more about it?

Dolu1990, 2025-01-22:
Hoo i meant "There is no flow in place for it." XD sorry.

For the error you had, check what file were generated by verilator, that is what the testbench can't find apparently.

Closed 2025-03-03.

Thread 441 (2025-01-21):

Any way to replace 'Area' with 'Component' in plugin's implementation?

davine47, 2025-01-21:
Hi, i am trying to use Vexriscv's CPU framework in ASIC design.
But for now, all logics will be generated in a module. This is unfavorable for IC layout design. The backend department wants the RTL to have a clear boundary between modules and module I/O.
Any suggestions to solve this?
Thanks! ^_^

Dolu1990, 2025-01-21:
Hi,

currently, the only way to get component stuff, is to explicitly define them and instanciate them in a given plugin, like the data cache for instance.
There would be ways (unimplemented) to automaticaly push the hardware from each plugin in their own components and then automaticaly legalising their in/out. It shouldn't be too complicated to implement, but this isn't planned yet.

So far, i didn't thinked that having clear boundaries inside VexRiscv itself would realy matther, given the "small size" of the cpu.
Are you running on a large node / very limited die size ?

davine47, 2025-01-23:
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

Yes, i'm running on a large scale CPU design, benchmarking against ARM A76, but it has larger decode width, at least 8. The whole layout has configurable 1-16 cores with L3 shared cache slices. I think the scale of this chip is really large, compared to VexRiscv.

Currently, I am exploring the feasibility of SpinalHDL and VexRiscv on large scale ASIC design.

I think vexriscv CPU framework demonstrates a clear framework, configurability, and scalability. It reduces the control complexity of the CPU design. But its not friendly to backend's layout, for now.

Will there be features oriented towards ASIC design in the future(Spinalhdl or vexriscv series)?

thanks!
^_^

davine47, 2025-01-29:
> One question i have, is would the backend tools be capable to work by filtering stuff by names ? (instead of by module)

hi,
For now, the backend department is more accustomed to delivering by module, their tools and scripts are also tailored for modules. This should not change due to alterations in front-end tools, i think.

For ASIC design, when the chip scale exceeds 1 billion transistors, the challenges we are facing are as follows:

- The server’s computational power is unable to support such a large-scale backend circuit optimization all at once, and sometimes optimizations fail for certain paths due to server performance issues.
- The efficiency of backend optimization for large-scale circuits is also not high. The extension of feedback time for the front-end department resulted in a longer iteration cycle.

The best solution is to divide the architecture into multiple modules during the micro-arch design phase.

> There would be ways (unimplemented) to automaticaly push the hardware from each plugin in their own components and then automaticaly legalising their in/out. It shouldn't be too complicated to implement, but this isn't planned yet.

Currently my team is interested in spinalhdl and its framework, we will do some explorations to implement these features.

Thanks, ^_^

Dolu1990, 2025-01-29:
Hi,

Thanks for the info  :D

So, yeah, either would need to add this kind of special Component which have "soft" bundaries.
either would need to expllicitly define sub components in plugins (as it is done for the i$ d$ in VexRiscv)

> Currently my team is interested in spinalhdl and its framework, we will do some explorations to implement these features.

Let me know how it goes :)

Regards
Charles

Thread 446 (2025-03-11):

Vexriscv dual-core smp architecture has a problem when debugging

TieTouXiaoGe, 2025-03-11:
Hi @Dolu1990,
I'm currently using this demo:
https://github.com/SpinalHDL/VexRiscv/blob/master/src/main/scala/vexriscv/demo/smp/VexRiscvSmpLitexCluster.scala, Dual-core configuration.
Also, I'm using the official debug, so privilegedDebug is true. And then I changed this: https://github.com/SpinalHDL/VexRiscv/blob/master/src/main/scala/vexriscv/demo/smp/VexRiscvSmpCluster.scala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, To replace it into "DebugTransportModuleJtagTap". Because I want to generate a jtag interface that is a standard four-wire in verilog.
I have transplanted the generated verilog to my FPGA board and run a lot of software normally. Recently, I want to experiment the debug function, so I constrained four JTAG wires to go out and debug a single core respectively, which is normal. I used gdb+openocd+ftdi combination.
When debugging dual core, that is, openocd config file using "target smp xxx" command configuration (I'm sure my config file is OK, it's generic), gdb command display thread, switch thread is fine. The problem is: for example, hart0 performs single-step debugging first, when switching to hart1 for single-step debugging, the program is not executed line by line, but directly jumps to the stop position of hart0. I feel that the dpc value of hart1 follows hart0, and it seems not updated.
Looking forward to your reply. This problem has bothered me for a long time. Thank you very much.

Dolu1990, 2025-03-14:
Hi,

I wasn't aware of the bug.

Can you provide a way to reproduce ?
In particular, there is ways to make a simulation of it (including jtag) via https://github.com/enjoy-digital/litex/pull/1887

TieTouXiaoGe, 2025-03-15:
Thank you for your reply. Maybe I didn't express it clearly.
1. For a CPU with a dual-core SMP architecture, you can debug a single hart separately, that is, create a single target, core0 or core1, in the openocd configuration file.Use the "info thread" command to display only one thread.In this case, I have tested them separately, and it is normal.Now the problem is to debug the dual-core SMP type of software by creating two targets in openocd and using the "info thread" "command to show two threads.The reset PC value is now the same for both harts.In theory, stepping through both harts is performed instruction by instruction, that is, PC + 4 goes on like this.At present, when I use "thread 1"to select hart0 for debugging, it is normal to debug hart0 in a single step. It is executed one by one. For example, if I stop at PC + 0xC in a single step, I use"thread 2" to switch to hart1. The single step debugging directly jumps to the PC + 0xC address where hart0 just stopped.Rather than executing the instructions one by one.
2. The simulation method you recommend, I'll look into it, I haven't used it yet.
3.  I changed this: https://github.com/SpinalHDL/VexRiscv/blob/master/src/main/scala/vexriscv/demo/smp/VexRiscvSmpCluster.scala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, To replace it into "DebugTransportModuleJtagTap". Because I want to generate a jtag interface that is a standard four-wire in verilog. Can I modify it in this way without affecting the debugging under the dual-core SMP architecture?I'm sorry because I'm not even familiar with Verilog. I'm a software developer.Because of the ease of use of your great spinal HDL, I was able to make a few small changes.

TieTouXiaoGe, 2025-03-15:
As for how to reproduce,I use https://github.com/SpinalHDL/VexRiscv/blob/master/src/main/scala/vexriscv/demo/smp/VexRiscvSmpLitexCluster.scala.Modify the debug place, and then compile the generated Verilog file, with my peripherals: memory and peripheral modules, to form a complete SoC system, which can be downloaded to the FPGA development board.

Dolu1990, 2025-03-16:
Hi,

> DebugTransportModuleJtagTap

That should be all good, no worries on that side.

> reproduce

I would need the openocd scripts you use, and know which exact version of open ocd you are using.

The closest my setup is, the better

TieTouXiaoGe, 2025-03-17:
Ok, openocd version:

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

openocd scripts:

- adapter speed 1000
-
- set _CHIPNAME riscv
- jtag newtap $_CHIPNAME cpu -irlen 5 -expected-id 0x10002fff
-
- set _TARGETNAME $_CHIPNAME.cpu
-
- target create $_TARGETNAME.0 riscv -chain-position $_TARGETNAME -rtos hwthread
- target create $_TARGETNAME.1 riscv -chain-position $_TARGETNAME -coreid 1
- target smp $_TARGETNAME.0 $_TARGETNAME.1
-
- riscv set_command_timeout_sec 30
-
- init
- if {[ info exists pulse_srst]} {
-   ftdi_set_signal nSRST 0
-   ftdi_set_signal nSRST z
- }
- halt

TieTouXiaoGe, 2025-04-25:
Hi,Can you reproduce it over there?

TieTouXiaoGe, 2025-04-27:
Ok, I'll try.
