SpinalHDL/VexRiscv/scripts/Murax/iCE40-hx8k_breakout_board_xip/Murax_iCE40_hx8k_breakout_board_xip.pcf

## iCE40-hx8k breakout board

set_io io_mainClk  J3
set_io io_jtag_tck H16
set_io io_jtag_tdi G15
set_io io_jtag_tdo G16
set_io io_jtag_tms F15
set_io io_uart_txd B12
set_io io_uart_rxd B10
set_io io_led[0] B5
set_io io_led[1] B4
set_io io_led[2] A2
set_io io_led[3] A1
set_io io_led[4] C5
set_io io_led[5] C4
set_io io_led[6] B3
set_io io_led[7] C3

#XIP
set_io io_miso P12
set_io io_mosi P11
set_io io_sclk R11
set_io io_spis R12
