SpinalHDL/VexRiscv/(commit log)

2017-03-14 Add sim performance print
2017-03-15 Faster pipeline arbitration logic (200 Mhz on cyclone IV c6) Branch plugin with jump in execute or memory stages (parameter)
2017-03-15 PcManager now drive PC asyncronously (use 1 cycle less in jump) Fix bypass logic when read/write r0 Disable REGFILE_WRITE_VALID in decod stage when r0 is written
2017-03-17 Fix dCmd sent while the execute stage is removed Pass dhrystone benchmark without error !
    [main.cpp]
2017-03-18 Fix performance of removed instruction which halt were halting the pipeline
    [main.cpp]
2017-03-18 Add trace option to regresion
2017-03-19 Add Static branch prediction in decode stage
2017-03-21 Fix missing JAL, JALR encoding
    [main.cpp]
2017-03-23 MachineCsr wireing/logic done
2017-03-23 MachineCsr pass simple interrupt and exception tests
2017-03-24 MachineCsr fix csr set/clear with zero MachineCsr pass external/timer interrupts test
    [main.cpp]
2017-03-27 Add IRsp/dRsp ready + error capabilities to stall the bus and to generate access error exceptions
    [main.cpp]
2017-03-30 Instruction cache is now able to catch bus errors
    [main.cpp]
2017-04-01 Data cache pass dhrystone benchmark. Data cache todo -> bus error handling
    [main.cpp]
2017-04-08 IBusCachedPlugin add two stage cache option for better FMax and better scaling
2017-04-13 Smaller and faster single stage instruction cache Add fast two stage instruction cache Remove useless address == 0 checks in the HazardPlugin
2017-04-23 WIP two stage DCache, nearly passed the dhrystone benchmark
2017-04-23 Two stage datacache now pass dhrystone benchmark without error
    [main.cpp]
2017-05-01 Fix multi port MMU design Change machineCSR to handle exceptions from the writeBack stage Change the DBusCachedPlugin to emit miss exception
2017-05-07 Fix Instruction Data cache exceptions Pass all tests including CSR/FreeRTOS
    [main.cpp]
2017-05-21 Add TCP server socket to manage debug access from openOCD (as instance)
2017-05-22 Fix DebugPlugin Add DebugPlugin regression (PASS)
    [main.cpp]
2017-05-28 Fix regression test debugPlugin bus
    [main.cpp]
2017-06-07 Add missing import in Briey testbench
    [main.cpp]
2017-06-09 Remove speed factor overriding when Trace
2017-06-10 Add Uart monitor in the briey testbench
2017-06-10 Improve TCP sockets latency
2017-06-24 Add briey tracing Better debugPlugin implementation Fix SimpleDBus/IBus into AXI bridge (cmd transaction removing) Add SingleInstructionLimiterPlugin for debug purposes
    [main.cpp]
2017-06-26 update readme add uart.elf binary for testing
2017-06-27 Fix CsrPlugin case issue Better DBusSimplePlugin FMax with catch enables SrcPlugin can now insert SRC1 and SRC2 in the execute mode for lower area usage and combinatorial path balancing
2017-07-08 Fix info to flush data cache Briey sim add VGA GUI (SDL2) Add DE0-Nano Briey support
    [main.cpp]
2017-07-15 Fix UartRx sim
2017-07-20 D$ remove the coupling between the mem.cmd.ready >> victim logic >> cpu halt by using halfPipe => Better practical FMax
2017-07-21 Avalon add read response support. Fix debug instruction injection and IBusSimplePlugin interraction
    [main.cpp]
2017-07-23 Fix DataCache bug (interaction between the victim buffer and the memory read request in execute/memory stages)
    freeRTOS pass
    [main.cpp]
2017-07-28 Add interrupts and timer to Murax 8KB ram is the default now
2017-07-31 Refractoring of some arbitration signals Add UART into Murax
2017-07-31 Connect the UART interruption to the CPU
2017-08-03 Add Murax configuration which integrate a boot programme : Will blink led and echo UART RX to UART TX (in the verilator sim, type some text and press enter to send UART frame to the Murax RX pin)
2017-08-04 Move CPU and UART configs into the murax configuration object (in place of toplevel hardcoding) Add MuraxConfig.fast
2017-08-06 Briey move CPU and UART generics from to toplevel to the toplevel configuration object
2017-08-08 Add SIMD_ADD regression and config (show case)
2017-10-05 Update framework.h
    Add missing using namespace std;
    [framework.h]
2017-10-17 updated main.cpp added missing using namespace std
    [main.cpp]
2017-11-06 with no bus stall, pass all tests except uniqueness
2017-12-14 Fix led gui refresh rate
2018-01-04 Fix DecodingSimplePlugin model building when reinvocation is done one a preexisting opcode. add Atomic test flow
    [main.cpp]
2018-01-04 CsrPlugin : Now wait that the whole pipeline (including writeback) is empty before executing interruptions. This make the separation between context switching clear and avoid on atomic instructions f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
    [main.cpp]
2018-01-21 Fix Murax script flow (without rom file)
2018-01-25 Update DMIPS/Mhz Add cached config with maximal performance settings FullBarrielShifterPlugin can now be configured to do everything in the execute stage
2018-01-31 Add CsrInterface to allow custom CSR addition Add CustomCsrDemoPlugin as a show case
2018-01-31 Fix custom_csr regression against random ibus stall
2018-02-05 Remap Briey/Murax onChipRam to 0x80000000 to avoid having memory at the null pointer location Commit missing file Update dhrystone hex to use GP. 1.44 DMIPS/Mhz
    [main.cpp]
2018-02-16 New faster/smaller/multi way instruction cache design. Single or dual stage
2018-02-22 Briey testbench, fix io_coreInterrupt to zero to avoid external interrupt set by random boots values
    [main.cpp]
2018-03-05 SpinalHDL 1.1.4 Now the CsrPlugin is waiting that the memory/writeback stages are empty before reading/writing things
2018-03-06 MuraxSim add switch
2018-03-18 iBusSimplePlugin done, DebugPlugin need minor rework
    [main.cpp]
2018-03-21 IBusPlugin add support of bus error when using compressed instruction
    [main.cpp]
2018-04-18 Fix dBus IO access
    [main.cpp]
2018-05-24 Fix branch plugin decode prediction exception by using the instruction decoder
    [main.cpp]
2018-05-27 Give name to inter stages registers
2018-06-05 Allow RVC/dynamic_target/fetch bus latency > 1 all together Fix freeretos rvc regressions
    [main.cpp]
2018-06-23 rework csr exception/interrupt handeling wip
    [main.cpp]
2018-07-03 Fix EPC Fix Freertos binaries wip
    [main.cpp]
2018-07-21 Add link to SBT source
    In case you can't install via the apt source.
2018-08-14 Sync, Seem to pass all except dynamic_o0 which is probably a freertos test setup issue
    [main.cpp]
2018-08-20 riscv emulator WIP (RVC missing)
    [main.cpp]
2018-10-01 Introduce HAS_SIDE_EFFECT Stageable to solve sensitive instruction squeduling (uncached DBus TODO)
2018-10-03 rework fetchPc to optionaly share the pcReg with the stage(1) IBusSimplePlugin now implement cmdForkPersistence option
2018-10-10 Add RISCV compliance regression test, need to fix I-MISALIGN_JMP-01 mtval
    [main.cpp]
2018-10-11 Seem to pass all risc-v compliance tests, excepted the C.LWSP which is a broken test
    [main.cpp]
2018-11-09 Allow VexRiscv to suppress the memory and the writeback stage, allowing to go downto a 2 stage CPU (FETCH_DECODE, EXECUTE)
2018-11-24 Allow iBusCached plugin to be used when no memory stage is present
2018-11-24 Hazarplugin tell to branch plugin if the RS are hazardous in the execute stage
2018-12-01 DebugPlugin doesn't require memory/writeback stage anymore
2018-12-07 verilator regression fix missing fclose #46
    [main.cpp]
2018-12-09 regression fix delete [] #46
    [main.cpp]
2018-12-09 regression fix hex << dec #46
    [main.cpp]
2018-12-10 Fix #46 by filling missing return statements
    [main.cpp]
2019-01-21 Add tightly coupled interface to the i$
    [main.cpp]
2019-01-30 cpp regresion now print the time of failure
    [main.cpp]
2019-02-03 Add custom external interrupts
2019-03-20 Enable golden model check for all regressions Need to implement missing CSR of the golden model
    [main.cpp]
2019-03-20 riscv golden model and RTL pass all current regressions add RVC into the linux config
2019-03-23 CSR Plugin now implement interruptions as specified in the spec
2019-03-23 Fix csrrs/csrrc for xip registers
    [main.cpp]
2019-03-25 Fix mprv and add it into the softare model
    [main.c, main.cpp]
2019-03-26 Fix some models missmatch Add more SBI Add hardware LR/SC support in dbus cacheless
    [hal.c, hal.h, main.c, main.cpp, riscv.h]
2019-03-26 #60 user space reached /sbin/init: error while loading shared libraries: libm.so.6: cannot stat shared object: Error 38
    [main.c, main.cpp, riscv.h]
2019-03-27 Fix MMU MPRV, Fix emulator nested exception
    [main.c, main.cpp]
2019-03-27 Fix emulator nested exception redirection privilege
    [main.c, main.cpp]
2019-03-28 IBusSimplePlugin AHB bridge fix, pass tests
    [main.cpp]
2019-03-29 #60 should fix the first instruction fetch privilege after interrupt
2019-03-30 #60 Fix software model. Forgot physical address for on RVC instruction
    [main.cpp]
2019-04-01 #60 Fix interrupt causing fetch privilege issues
2019-04-04 Change LR/SC to reserve the whole memory Fix MPP access from other plugins Got all the common configuration to compile and pass regression excepted the debugger one First synthesis results
    [main.cpp]
2019-04-05 Rework CsrPlugin interrupt delegation
2019-04-06 GenMicroNoCsr: no memory stage, no write-back stage
2019-04-08 #60 Fix machine mode emulator atomic emulation. Do not write regfile if the page was set as read only.
    [main.c]
2019-04-09 Fix DebugPlugin -> force machine mode, force uncached memory load
    [main.cpp]
2019-04-10 Flush MMU line with exception on context switching instead than on cmd fire
2019-04-10 Reduce machine mode emulator CSR requirements and emulate more CSR (in the case they aren't supporter in hardware)
2019-04-12 Fix #69 discoverd fmax issue with decode stage branch predictions
2019-04-13 #60 Add sim error message on RVC instruction without RVC capabilities
    [main.cpp]
2019-04-19 Fix emulator instruction emulation trap redirection to supervisor. Impact only AMO less configs
    [main.c]
2019-04-19 #60 Added automated linux regression in travis Fix DBusCached plugin access sharing for the MMU deadlock when exception is in the decode stage Fix IBusSimplePlugin issues with used with non regular c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
    [main.cpp]
2019-04-19 Fix coremark binaries (no csr)
    [main.cpp]
2019-04-20 better travis timings travis job naming reduce verilator cache size Fix dcache test timeout travis cleaning travis wip verilator wip fix java 10 compilation Travis wip travis rework
    [main.cpp]
2019-04-21 Look like zephyr mem_pool_threadsafe is a broken test
    [main.cpp]
2019-04-21 Update Zephyr tests, the mem_pool_threadsafe one was bugy by the past, and now it is just too long
    [main.cpp]
2019-04-21 remove interrupt assertion
2019-04-21 Riscv software model now implement interrupt priority accordingly to https://github.com/riscv/riscv-isa-sim/commit/496c59d064961bb81e63e2bba1bdadd4abf05a52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 chang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
2019-04-24 Icestorm flow now use nextpnr
2019-04-24 Switch to SpinalHDL 1.3.3 (release)
2019-04-25 Add configs without memory/writeback stages in regressions Add rfReadInExecute configs in regressions Fix ShiftPluginLight and DBusSimplePlugin for configs with rfReadInExecute stage configs
    [main.cpp]
2019-04-26 MmuPlugin: fix generation without writeBack stage
    If there is no writeBack stage, the elaboration step would hit a
    NullPointerException when trying to insert into the writeBack stage.
    Instead, pull from the most recent stage, which is where MMU access
    should reside.
2019-04-26 caches: work without writeBack stage
    In the case of an MMU miss, the data caches will create a retry branch port.
    These currently implicitly go into the memory/writeBack stage, however
    not all CPUs have this stage.
    Place the retry branch port into the correct stage.
2019-05-01 Switch to released SpinalHDL
2019-05-13 Switch to unreleased SpinalHDL
2019-06-04 Fix WFI. Not sensitive anymore to global interrupt enables, delegation and privilege
2019-06-09 rework flush with flushNext and flushIt static branch prediction jump do not depend on stage fireing anymore
2019-06-09 Fix BranchPlugin when SRC can have hazard in execute stage
2019-06-10 Add regression concurrent os executions flag to avoid running debug plugin tests
    [main.cpp]
2019-07-24 Fix handling LiteX uart and timer.
    [hal.c]
2019-09-21 Enable RF bypass on MUL DIV with pipeline wihout writeback/memory stages
2019-09-21 Hazard on memory stage do not need to know if that's bypassable if the memory stage is the last one
2019-09-23 Data cache can now be used without writeback stage
2019-09-23 Add regression for data cache without writeback stage, seem to pass tests, including linux ones
2019-10-21 Fix muldiv plugin for CPU configs without memory/writeback stages
2019-10-22 Fix MulDiveIterative plugin when RSx have hazard in the execute stage
2019-11-07 GenCustomInterrupt demo now enabled vectored interrupt
2019-12-19 Fix inWfi naming, fix regressions
    [main.cpp]
2020-01-13 CsrPlugin add printCsr
2020-01-13 better pin names in scala, bootloader without magic word
2020-01-29 Revert "Merge branch 'master' into dev"
    This reverts commit b5374433a53f5ffa47ca63f9b532ee59695e1e59, reversing
    changes made to f01da9c73b42897c3bd49b92401063b84edb84ef.
    [Murax_iCE40_hx8k_breakout_board_xip.pcf, arty_a7.xdc, arty_a7_org.xdc, interrupt.h, main.c, murax.h, prescaler.h]
2020-01-29 Revert "Revert "Merge branch 'master' into dev""
    This reverts commit c01c2567578b18e4fec4466d6db3ce644b8eeede.
    Fix dBusCachedPlugin relaxedMemoryTranslationRegister when mmu translation is done in the execute stage
    [Murax_iCE40_hx8k_breakout_board_xip.pcf, arty_a7.xdc, arty_a7_org.xdc, interrupt.h, main.c, murax.h, prescaler.h]
2020-02-17 fix deleg external interrupt propagation time failure
2020-02-21 Fix fetcher decompressor when driving decode stage
2020-03-04 MulDivPlugin now give names to div stages
2020-04-05 LrSc SMP, linux crash in userspace
    [main.cpp]
2020-04-06 fix non smp regression
    [main.cpp]
2020-04-06 fix weird regression testbench memory bug
    [main.cpp]
2020-04-07 Merge pull request #115 from antmicro/fix_emulator
    emulator: Use external hw/common.h from LiteX
    [hal.c]
2020-04-10 Add d$ invalidation tests fix d$ invalidation, linux OK
    [main.cpp]
2020-04-15 Add VexRiscvSmpCluster, seem to work on simple case
2020-04-21 Add sbt assembly
2020-04-28 Fix SMP for configuration without writeback stage. Include SMP core into the single core tests regressions
2020-04-29 I$ with memDataWidth > cpuDataWidth now mux memWords into cpuWords before the decode stage by default. Add twoCycleRamInnerMux option to move that to the decode stage
2020-05-01 Fix SMP fence lock when 4 stages CPU
2020-05-04 Add probes in SmpCluster sim
2020-05-06 More VexRiscv smp cluster probes
2020-05-07 MmuPlugin now support multiple stages, D$ can now take advantage of that
2020-05-09 Add regression TRACE_SPORADIC, LINUX_SOC_SMP regression golden model now properly sync dut exceptions
2020-05-27 Improve SingleInstructionLimiterPlugin to also include fetch stages
2020-07-05 Litex SoC add coherent DMA master
2020-07-05 Fix MmuPlugin when used in multi stage config
2020-07-21 Litex cluster add DMA sel feature
2020-10-09 Fix UserInterruptPlugin interrupt enable
2020-10-19 DataCache split redo / refilling execute stage halt
2021-02-09 fpu fixed corner cases, FpuPlugin coupling, pass rv-test excepted div (accuracy), can run C sinf successfully
    [main.cpp]
2021-02-16 fpu double fixes DataCache now support wide load/store
    [main.cpp]
2021-02-17 fpu Fix VexRiscv integration and add software f64 tests (pass)
    [main.cpp]
2021-02-19 fpu fix exception flag handeling
    [main.cpp]
2021-02-22 fpu fix arbitration/lock bugs add getVexRiscvRegressionArgs
    [main.cpp]
2021-03-02 fpu now track commits using a counter per pipeline per port
2021-03-02 fpu fix cmd / commit race condition
    [main.cpp]
2021-03-25 Fetcher.decompressor ensure that the decoded instruction do not mutate when the pipeline is stalled (fix FPU cmd fork for rvc without injector stage)
2021-05-06 Improves the documentation for nativeJtag about Murax with BSCANE2 and OpenOCD.
    [jtagspi.cfg, soc_init.cfg, usb_connect.cfg, xilinx-xc7.cfg]
2021-05-06 Removes PDF and xilinx-xc7.cfg and jtagspi.cfg. Enhances README.md to find in OpenOCD.
    [jtagspi.cfg, xilinx-xc7.cfg]
2021-05-17 fixed priority of == & != as seemed logical to get less warnings when building
    [main.cpp]
2021-06-02 PMP CSR writes occur in execute stage
2021-11-11 Update DebugPlugin.scala
    Add readback of the hardware breakpoint values.
    A new parameter is added to the plugin to switch readback on and off.
2022-01-10 Fix lrsc from last commit
    [main.cpp]
2022-02-22 Fix Briey simulation floating rxd blocking the uart #238
    [main.cpp]
2022-04-11 #241 Fix Murax/Briey TB timeouts
    [framework.h, main.cpp]
2022-04-20 plugin: caches: Fix "Can't resolve the literal value of"
    Both registers were initialized with unsigned integers without a value.
    This triggered:
    [error] Exception in thread "main" spinal.core.SpinalExit:
    [error] Can't resolve the literal value of (..._rspCounter : UInt[32 bits])
2022-11-11 Fix a few RISC-V official debug support : - Disable interrupts in debug mode - Ensure traps do not change CSR in debug mode - step will also consider trapEvent
2022-12-20 Expand SATP register to 22 bits per spec
    Vex only implements a 32-bit PA which does not take advantage
    of the potetnial 32-bit space in Sv32 mode. Very reasonably,
    Vex simply discards the top two unused bits.
    However, the spec does require that the register occupy all 22
    bits and it is possible for the OS to use the extra bits up top
    for some bookkeeping purpose. This commit proposes to expand the
    register to occupy the full 22 bits in case an OS is written
    to utilize the full width of the register as written in the spec.
2023-02-22 D$ now support thightly coupled ram. Add IBusDBusCachedTightlyCoupledRam plugin
2023-02-23 Fix MMU A and D flag handeling
    [main.cpp]
2023-02-24 Fetcher: insert FORMAL_MODE encoded from privilegeService
    Previously, FORMAL_MODE would simply be hard-coded to "11", indicating
    machine mode. However, that's not necessarily true when using the
    CsrPlugin, which allows to switch the hart into either User or
    optional Supervisor mode. Hence we create a FORMAL_MODE insert in the
    fetch-phase (which is generally when the MPP register can take effect)
    and generate `rvfi_mode` based on that insert.
2023-02-26 CsrPlugin: insert FORMAL_HALT := False
2023-03-03 Improve d$ coupled timings
2023-03-05 Fix CFU / FPU decoder stage fork on illegal instruction
2023-03-05 DBus coupled timings improvement
2023-03-22 More verbose main.cpp on failure, fix C.ADDSP regfile initialisation
    [main.cpp]
2023-03-22 fix a few csr related WARL (minor)
    [main.cpp]
2023-04-07 Remove sbt-assembly dependency
    The plugin is not used in the VexRiscV build and causes issues for users
    since repo.scala-sbt.org seems to be down/sunset/?.
    See also https://github.com/sbt/sbt/issues/7202
    Updating the dependency would also have been an option, but since it's not
    used removal is easier.
2023-04-13 d$ toBmb increase aggregation timer
2023-11-03 PmpPluginOld: fix NAPOT address calculation overflow issue
    Because pmpaddrX registers are defined to encode the address'
    [XLEN + 2 downto 2] bits, the length of a NAPOT region is defined
    through the most significant 0 bit in a pmpaddrX register (which in
    the case of ~0 is the 33rd non-existant "virtual" bit), and the
    VexRiscv PmpOld plugin represents the addresses covered by a region as
    [start; end) (bounded inclusively below and exclusively above), the
    start and end address registers need to be XLEN + 4 bit wide to avoid
    overflows.
    If such an overflow occurs, it may be that the region does not cover
    any address, an issue uncovered in the Tock LiteX + VexRiscv CI during
    a PMP infrastructure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
2023-11-13 Fix ambiguous function call to bind()
    The call to bind() can actually resolve to std::bind() instead of
    libc's bind(). Ensure that we're definitely calling the correct one.
    [jtag.h]
2023-12-21 Add mill to compile and test VexRiscv
2024-01-31 moved timer to CounterPlugin
2024-02-05 readded legacy counters/timers
2024-06-17 Fix #412 tightly coupled HAS_SIDE_EFFECT fix
2025-05-24 Fix DBUS_SIMPLE_AHBLITE3 dBusAccess param error
    [main.cpp]
2025-10-16 fix #455 VexRiscvSmpCluster now supports --interrupt-count=xxx
2026-09-19 Follow the SWD library split in SpinalHDL
    SpinalHDL moved the SWD wire side (Swd bundle, SwdPhy, SwdDp) into
    spinal.lib.com.swd, and DebugTransportModuleSwd.io.swd is now
    slave(Swd()) with swdio as a TriState.
    The SMP cluster maps swdio.read/write/writeEnable onto the same pinned
    top-level names as before (debugPort_swdio_i/o/oe), so the LiteX
    black-box port map is unchanged and the generated netlist is identical
    up to internal port renames.
    The SWD PHY, DP and DTM suites and their sim driver never depended on
    VexRiscv; they now live in SpinalHDL's tester next to the code they test.
    Requires the matching SpinalHDL change.
